Common-AIOT/Sentinel-UGV/docs/README.md

---
title: "재난 지역 자율 탐사 UGV - Sentinel UGV"
team: "역삼역역무실관제센터"
version: "v2.1"
status: "시연 종료 — 코드·실측 정합본"
date: "2026-08-11"
---

# 재난 지역 자율 탐사 UGV - Sentinel UGV

> 통합 프로젝트 명세서 및 개발 운영 계획

| **항목** | **내용** |
|---|---|
| **팀명** | 역삼역역무실관제센터 |
| **문서 버전** | **v2.1** — 시연 종료 시점 코드·실측 전면 정합본 |
| **작성 기준일** | 2026-08-11 |
| **개발 종료 목표** | 2026-08-07 |
| **프로젝트 유형**  | 온디바이스 AIoT 기반 재난 탐사 무인 지상 차량(UGV) |
| **문서 상태** | 구현 완료 범위와 실차 재검증·미구현 범위를 분리해 기록 |

> **문서 사용 목적** 본 문서는 기획서, 시스템 명세서, 하드웨어 설계 기준, 소프트웨어 인터페이스 명세, 테스트 계획, 일정 및 위험 관리 계획을 하나로 통합한 프로젝트 종합 문서이다. 팀원 간 개발 기준을 통일하고, 기술 선택 근거와 변경 이력을 발표 및 포트폴리오에 활용하는 것을 목적으로 한다.

> **현재 구현 요약 (v2.1, 시연 종료 시점)** 시연 시나리오 「START → 자율 탐사 → 사람 발견 → 접근 → 음성 대화 → 보고 → STOP」 전 구간이 실기동으로 동작한다. 주행은 Smac Hybrid-A\*(REEDS_SHEPP, R_min 1.8) + RPP(후진 추종)이며, 실측이 확정한 값 위에서 돈다 — R_min 좌 1.37m/우 1.76m, 순항 0.30m/s(명령=실속도 99%), 접근 0.25m/s, 펌웨어 데드밴드 0.15m/s(이 아래 명령은 실속도 0), EKF yaw 오차 1.1%, 오도메트리 줄자 대비 ±5%. 지도는 임무마다 초기화된다(MISSION_START 에서 slam 재시작). 안전은 collision_monitor 실측-차체 구역(정지 범퍼 앞 0.25m·후방 포함)이 주 방어이고, 전·후방 초음파는 장착·구현된 채 발동을 껐다(오측 — 커넥터 분리 유지). `demo.launch.py` 기본값은 SLAM·스트리밍·녹화·임무·클라우드 브리지·음성·탐지·시각화가 `true`, ESP32·Nav2·탐사·접근·안전·EKF가 `false`다. 필요한 기능은 `scripts/demo_up.sh` 인자로 켠다(**`enable_ekf` 를 빠뜨리면 스택이 조용히 침묵한다** — S15P11A301-359). **미구현으로 남긴 것**: 자동 복귀(RETURNING), 7분·Frontier 소진 자동 종료, human_localizer(map 좌표 사람 위치), 카메라 hfov 실측(접근 방향 미세 오차의 유력 원인, S15P11A301-371). 종료 시점 전체 상태와 반복된 함정 5가지는 Jira S15P11A301-372(종료 기록)에 있다.

> **문서 구성 안내** 본 명세서는 역할별 파일과 TBD 대장으로 분리해 관리하지만, **장 번호(1~38장)와 부록(A~L)이 전역으로 연속되는 하나의 문서(v2.1)** 이다. 문서 버전·변경 이력·결정 기준은 이 README에서만 관리하며, 각 분리 파일은 자기 버전을 따로 두지 않는다. 아래 [문서 구성](#문서-구성)의 매핑을 따른다.

# 문서 관리
| **버전** | **일자** | **상태**  | **주요 변경 내용** |
|---|---|---|---|
| v2.1 | 2026-08-11 | 코드·문서 재감사 | 실제 launch 기본값, Smac·BoT-SORT·ROS 토픽·인증 부재·GMS 상태명과 미구현 경계를 현재 코드 및 실측 결과에 맞췄다. TBD 완료/잔여 상태, 시연·인수 범위, 영상 15FPS·1500kbps와 트러블슈팅 인덱스도 최종화했으며 과거 변경 이력은 당시 기록으로 보존했다. |
| v2.0-r53 | 2026-08-09 | 문서 최신화 | 현재 코드와 설정을 다시 대조해 루트·프런트엔드·백엔드·Jetson 모듈 README와 환경 변수 예시를 갱신했다. 후방 초음파, IMU 장착 자세, URDF 실측 위치, Nav2·안전 체인·전륜 조향 구현 상태를 반영하고, 자동 복귀·자동 종료·실차 재검증·조향 링키지 보정 등 남은 항목을 구현 완료 내용과 분리했다. |
| v0.1 | 2026-07 초 | 아이디어  | 재난 지역 탐사 로봇 콘셉트 및 Jetson 중심 구조 검토 |
| v0.5 | 2026-07 중 | 설계 | 짐벌, ROS2, SLAM, Nav2, AWS 관제 구조 검토 |
| v0.8 | 2026-07-17 | 정책 확정 | 자율 탐사, 수동 조종, 스트리밍, 데이터 저장, 장애 대응 정책 확정 |
| v0.9 | 2026-07-17 | 개발 착수 | 전체 프로젝트 종합 명세서 작성. 모터/전원/짐벌 세부 부품은 TBD로 관리 |
| v1.0-rc1 | 2026-07-22 | 통합 검수 | 1~38장 통합, Jetson+STM32, 피해자 접근·음성·다중 인원, MQTT·이벤트 녹화·보안·인수 시험 반영 |
| v1.0-rc2 | 2026-07-23 | 구동 정정 | 구동계 정정 시도. 실제 donor platform 반영은 rc3에서 재검수 |
| v1.0-rc3 | 2026-07-23 | 대화 재검수 | BMW M7 베이스·RS540·추가 학습 YOLO·STT-LLM-TTS·실측 센서 상태 반영, 폐기 자료 의존 제거 |
| v1.1 | 2026-07-24 | 충돌 해소 확정 | 요약부·상세부 충돌 13건 팀 결정 반영(API 31장 기준, LiDAR 짐벌 탑재, TF 표준화, PAUSED 경유 수동 전환, AVAILABLE 상태 통일, 3주 일정 재편 등). 조건부 Pose 파이프라인, 블루투스 스피커+BRIO 내장 마이크, STT-LLM-TTS 온디바이스 확정. TBD 대장 부록 H로 단일화. 요약부 구조 재편: 상세 장과 중복되는 6·8~14·16장을 핵심 요약+규범 포인터로 압축하고 독자별 읽기 경로 추가. 역할별 6개 파일 + TBD 대장으로 문서 분리 |

| v1.1-r1  | 2026-07-27 | 실측 정정 | v1.1 내 정정(버전 식별자는 v1.1 유지). 32장을 S15P11A301-62 확정 계약·PoC-A 실측과 정합하게 정정. 카메라 단일 오픈을 `usb_cam` raw_mjpeg 패스스루 + 압축 토픽 분기로 교체, 15 FPS → 30 FPS 확정, NVENC 미존재로 `x264enc`(CPU) 확정(HW 인코더 전제 폐기), `nvv4l2decoder mjpeg=1` 확정·`nvjpegdec` 기각 명시, 저장 매체 microSD 실태와 `usb_cam` stamp 클럭 특성 기록, VID-11~13 추가. 변경 파일: `05-통신-서버-영상.md` |
| v1.1-r2  | 2026-07-27 | 제어기 변경 | 저수준 제어기를 STM32에서 ESP32로 변경. 유선 USB Serial, ESP-IDF watchdog·태스크 분리, 부팅 안전 출력, DHT11·전방 초음파의 ESP32 수집 및 독립 근거리 정지 원칙을 반영. 정확한 ESP32 보드 모델과 핀맵은 TBD. 변경 파일: `README.md`, `01~06`, `TBD.md`, `scripts/docs/split-integrated-spec.ps1` |
| v1.1-r3  | 2026-07-29 | AI 문서 정리 | 객체탐지 Jetson 실행 runbook을 25.7장에 반영하고, detection 세부 문서를 `docs/ai/detection/`으로 이동. 변경 파일: `README.md`, `04-자율주행-AI.md`, `docs/ai/README.md`, `docs/ai/detection/*`, `ai/detection/AGENTS.md` |
| v1.1-r4  | 2026-07-30 | 하드웨어 스택 확정 | 짐벌을 프로젝트에서 완전히 제외(카메라·LiDAR 차체 고정 마운트로 전환)하고, 배터리(모터용 유아전동차 내장 12V + Jetson용 대용량 보조배터리 분리 급전), 구동/조향 모터(RS540 FD-12V RPM14000 좌·우 각 1개 + WW MOTOR RS380SP-12V RPM5500 조향 1개, BTS7960 드라이버 3개), 저수준 제어기(ESP32 WROOM-32를 모터 제어용·센서 제어용 2개로 이원화, 각각 Jetson과 별도 USB Serial 연결), 센서(HC-SR04 초음파 1개, DHT-11 온습도 1개, MT6701 엔코더 3개)를 확정 반영. 짐벌 제외로 FR-024·CAL-08/09·`/gimbal/state`·gimbal TF 체인은 폐기 처리. 변경 파일: `README.md`, `01~06`, `TBD.md` |
| v1.1-r5  | 2026-08-01 | 구동계 차동 구동 전환 | 조향 모터(WW MOTOR RS380SP-12V)와 조향되는 앞바퀴를 제거하고, 프레임 앞부분에 수동 캐스터 바퀴 2개를 부착해 후륜과 높이를 맞췄다. 후륜 좌·우 RS540 모터 2개만으로 전진·후진·조향·제자리 회전을 수행하는 **차동 구동(differential drive)**으로 전환. 이에 따라 BTS7960·MT6701을 각각 3개→2개로 감축하고, 전륜 Ackermann 조향·최소 회전반경 제약·조향각 프로토콜 필드(`target_steering_mdeg` 등)·`STEERING_ENCODER_FAULT`·TBD-HW-008을 폐기했다. Nav2는 최소 회전반경 제약이 없는 차동 구동 로봇으로 재설정(NavFn/Smac 2D + DWB, rotation shim 활성화). 변경 파일: `README.md`, `01~06`, `TBD.md` |

| **v2.0** | **2026-08-04** | **구현 정합** | 명세 전체(6204줄·38장)를 리포 실제 상태와 대조해 정정(S15P11A301-239, 238 통합). 남은 기간이 짧아 **명세를 현재 구현에 맞추는 방향**으로 결정했고, 폐기·미구현을 감추지 않고 표기한다. **정책 변경 3건**: ① 배터리 기반 안전·종료 기능 폐기(14.6 — 전압·전류 센서 미장착이라 계측 경로가 없다. 종료 조건이 Frontier 소진과 7분·운영자 종료 둘로 줄어든다), ② 인증을 MVP 범위 밖으로 확정(36-4 — `/api/**`가 `permitAll()`이고 로그인 화면·`users` 테이블이 없다. 경계는 EC2 SG 허용 IP와 CORS 이며 Control Session 은 인증이 아니다), ③ TBD-NAV-001 Nav2 채택 확정(24.1 — Regulated Pure Pursuit + rotation shim, `enable_nav2` 기본 false). **신설**: 8.4 ROS 그래프 격리, 8.5 foxglove_bridge 시각화 경로, 8.6 관제 웹 실시간 지도(v1.1의 "실시간 격자 계약이 없다" 전제가 깨졌다), 23.6 복귀 3단(빵조각 역추적을 2단으로), 25.3 카메라 역할 경계(단안이라 기하에 쓸 수 없다), 03장 캐스터 슬립이 오도메트리 yaw 를 갉아먹는 영향, 04장 3차 통합 FPS 실측(5.80 → 10.80, 목표 15 미달). **정정**: 8.2 노드 표에 구현 상태 열(명세가 이름 붙인 노드 중 절반이 미구현, 6개는 실제 이름이 다르다)과 `/cmd_vel` 소비자 부재 갭 명시, REST API 표를 27.4 단일 규범으로 통합(31-7 중복 제거, `/path` 폐기, 지도 계통 3개 추가), 관제 화면 페이지 4개 → 2개와 레이아웃 제거 항목 6개의 근거, 28장 제목에서 "조이스틱 UX" 제거·STOMP 조종 채널 3개 미사용, 13장 미생성 테이블 3개(`users`·`interaction_sessions`·`interaction_turns`), 37-3 systemd 단일 진입점(TBD-OPS-001 문장 무효), 38-3 에 선행 부재로 막힌 요구사항 8개, 14.3 필수 점검에서 점검 불가 항목 제거, TBD-CAL-002 신설(트랙폭·바퀴 지름 — 즉시). **담당 위임**: 33-5 "전부 온디바이스 확정"이 구현과 다르다(LLM 이 GMS 클라우드) — 프라이버시·오프라인 정책이 걸려 있어 음성 담당이 정정한다. 변경 파일: `README.md`, `01`, `02`, `03`, `04`, `05`, `06`, `TBD.md` |

> **v2.0의 원칙: 미구현을 미구현으로 적는다.** v1.1까지는 설계 의도를 규범으로 적어
> 두었고 그것이 구현과 벌어졌다. 명세가 "구현한다"고 적고 있는데 실제로 없으면, 통합
> 검사에서 "왜 안 되나"를 매번 다시 조사하게 되고 최악의 경우 보안처럼 **없는 보호를
> 있다고 믿는다.** 그래서 v2.0은 각 항목에 구현 상태를 붙이고, 폐기한 것은 폐기로,
> 안 하기로 한 것은 안 한다고 적는다.
>
> 자율주행 23·24장의 **설계 결정**(Nav2 채택 근거, 복귀 3단, 카메라 역할 경계)은
> S15P11A301-238에서 별도로 반영한다. v2.0은 현재 상태 정합까지다.

| v2.0-r1 | 2026-08-04 | 파일 분리 | `04-자율주행-AI.md`를 둘로 분리(S15P11A301-245). 자율주행 장(8·14·22·23·24·26)은 `04-자율주행.md`, AI 장(9·25·30·33)은 신설 `07-AI-탐지-음성.md`. **내용 변경 없음 — 이동만.** AI(객체탐지·음성)는 거의 완료된 참조 문서이고 자율주행은 착수 단계의 작업 문서라, 한 파일에 두면 자율주행 변경마다 완료된 장이 diff 에 섞인다. 장 번호는 전역이므로 번호 참조는 유효하며, 파일명 참조는 리포 전수 갱신(`ai/detection`·`ai/voice`·`docs/ai`). 변경 파일: `README.md`, `04-자율주행.md`, `07-AI-탐지-음성.md`(신설), `ai/`·`docs/ai/` 링크 |

| v2.0-r2 | 2026-08-04 | 주행 스택 구현 반영 | 자율주행 구현 진행분을 반영(S15P11A301-234·235·236·244). 8.2 노드 표에서 `vehicle_kinematics`·`nav2_stack`·`ekf_node` 를 구현으로, 8.1 파이프라인에 EKF 편입. **24.1 신설**: planner/controller 역할 구분과 Nav2 구성 확정(NavFn, rotation shim→RPP, `allow_unknown=false` 가 23.3 도달성 판정의 근거, costmap 2개, `/cmd_vel_nav` remap, 시연 시작 위치 20cm 클리어런스). **23.2 신설**: EKF 융합 — 입력 성분 선택 근거(엔코더 `vx` 만·IMU `vyaw` 만, 슬립은 계통 오차라 공분산 가중으로 안 되고 아예 뺀다), odom TF **3자 배타표**(222 의 2자를 확장), 정지 실측(EKF 30Hz, gyro 잡음 분산 5.1e-05, **잔여 bias −4.85°/분**), 장착 후 검증 3단계. 22.2 센서 표에 IMU 90Hz·엔코더 50Hz 실측. TBD-HW-012 모델·배선 확정(MPU6050 I2C 0x68), TBD-NAV-001 구성 확정. 변경 파일: `README.md`, `04-자율주행.md`, `TBD.md` |

| v2.0-r3 | 2026-08-04 | 환경 센서 판정 | S15P11A301-214. 22.2 에 **환경값 판정 임계** 절 신설 — 명세가 임계값을 두지 않아 여기서 확정했다(습도 상한 85 → **80**: 데이터시트 상한 90 에서 오차 ±5 를 뺀 값. 종전 85 는 경고 구간이 오차 폭과 같았다). **포화 처리**를 도입했다 — DHT11 은 습도 90% 를 넘으면 못 읽으므로 임계값만 두면 범위 밖이 침묵한다. 값이 범위 끝이면 `≥90` 부등호와 "측정 한계" 안내를 함께 낸다. 포화 자체가 경고이며, 습도 하한(≤22%)은 경고 조건(>80) 밖이라 이 절 없이는 건조 극단이 조용히 지나간다. 22.2 DHT11 행에 유효 범위·실패 시 발행 건너뛰기 규칙 기재. 11장 레이아웃 제거 표에 **속도·각속도 폐기** 추가(실측값은 오지만 관제자 행동을 바꾸지 않는다 — 배터리·방위각과 같은 기준. DB·임무 이력에는 남긴다). 변경 파일: `README.md`, `04-자율주행.md`, `05-통신-서버-영상.md` |

| v2.0-r5 | 2026-08-04 | 환경 fault 발화 확인 | S15P11A301-258(r4 는 256 이 쓴다). 22.2 의 「**`ENVIRONMENT_SENSOR_FAULT`(임계 3)는 뜨지 않는다**」를 정정했다 — 그 문장은 측정 조건(센서 장착·간헐 실패 18.5%, 연속 최대 1회)에서만 사실인데 "이 플래그는 안 뜬다" 로 읽혔다. 없는 보호를 있다고 믿게 하는 종류의 오류다(v2.0 의 36-4 와 같다). 같은 날 **센서 분리 상태에서 정상 발화를 확인**했고 조건별 표로 바꿨다: 간헐 실패 → 0·0.41Hz 발행 유지 / 분리 → 1·`DEGRADED`·발행 중단. 분리 중에도 같은 보드 IMU 90.6Hz·CRC 0·프레임 유실 0 이라 fault 가 DHT11 경로만 짚었다는 것, 화면에서 값이 사라지는 것이 **설계대로**라는 것(낡은 값이 새 측정으로 보이지 않게), 주행은 `DEGRADED` 허용이라 탐사가 계속된다는 것을 적었다. 플래그가 **sticky 가 아니라 성공 읽기 1회에 해제**되므로 복구에 재기동이 불필요하고, 값이 1 로 남아 있다는 것은 임계 이후 성공 읽기가 없었다는 뜻이라 간헐 실패와 완전 불통을 이 한 값으로 구별할 수 있다. 변경 파일: `README.md`, `04-자율주행.md` |

| v2.0-r6 | 2026-08-05 | 안전 체인 구현·순서 통일 | S15P11A301-237. 체인을 구현하고(`sentinel_safety` 의 `command_mux`·`safety_gate`, nav2 두 층은 `safety.yaml` 파라미터만) **네 곳에 서로 다르게 적혀 있던 순서·토픽명을 통일**했다. 순서는 `command_mux → velocity_smoother → collision_monitor → safety_gate` 이며 34-7 이 규범이다 — smoother 를 뒤에 두면 급정지가 `max_decel` 에 걸려 천천히 멈춘다. 최종 토픽 이름이 문서마다 `/cmd_vel_safe`(03장)·`/cmd_vel`(8.2 `command_mux` 행)·`/cmd_vel_final`(8.2 `safety_gate` 행) 셋이었고 실제는 `/cmd_vel` 하나다(`/cmd_vel_safe` 는 collision_monitor 출력). 24.1 mermaid 는 수동 명령을 collision_monitor **뒤**에 합류시켜 수동 조작이 충돌 방지를 건너뛰게 그려져 있었다. **24.1 에 구현 확정 절 신설**: 관통 실측 4단 19.995~19.999Hz·값 보존·`/cmd_vel` 발행자 1개, 상류 단절 시 0 을 20.000Hz 로 **계속** 발행(침묵과 정지의 구별), nav2 두 층이 lifecycle 이라 `lifecycle_manager_safety` 가 필요하고 이름이 nav2 쪽과 달라야 하며 CPU 포화 경합 때문에 3초 지연이 필요한 것(지연 충분성은 **저부하에서만** 확인), `base_shift_correction: False` 의 근거와 그 대가 1.75cm 계산, `/scan` 낡음을 collision_monitor 가 건너뛰므로 게이트가 따로 보는 것. 8.2 표에서 `vehicle_kinematics`(234) 가 **아직 미구현으로 남아 있던 것**도 정정했다(v2.0-r2 가 고쳤다고 적었으나 실제로는 안 고쳐져 있었다). 22.4 의 「TF 끊김은 237 이 함께 잡는다」는 **약속이 이행되지 않았음을 명시**로 바꿨다 — 게이트의 정지 조건 넷에 TF 가 없고 `/scan` 은 계속 오므로 collision_monitor 도 못 막는다. 06장 FR-004·FR-011 을 "미구현" 에서 "구현·관통 확인, 실차 계측 미실시" 로, FR-003 의 「`/cmd_vel` 소비자 없음」을 정정. 변경 파일: `README.md`, `03-제어-캘리브레이션.md`, `04-자율주행.md`, `06-테스트-보안-운영.md` |

| v2.0-r7 | 2026-08-05 | 보호정지 중계 구현 | S15P11A301-237(r6 의 누락 보완). r6 이 안전 체인을 구현했다고 적었으나 **명세 03-276 이 요구하는 `protective_stop` → `STOP_COMMAND` 중계가 빠져 있었다** — `safety_gate` 는 `/cmd_vel` 을 0 으로 만들지만 브레이크·driver disable 은 발동하지 않았고, `STOP_COMMAND` 를 보내는 코드는 `esp32_motor_bridge` 의 서비스로만 있고 부르는 사람이 없었다. 03장에 **「중계 구현」 절 신설**: 중계는 `esp32_motor_bridge_node` 가 `/proximity/protective_stop` 을 **직접 구독**해 수행하며 `safety_gate` 를 거치지 않는다(지연 — 홉을 늘리지 않는다, 독립성 — 게이트가 죽어도 보호정지는 전달돼야 한다). 두 경로는 중복이 아니라 서로 다른 것을 막는다는 표를 함께 적었다. **상승 엣지 3회 반복**은 03장 메시지 표의 "즉시, 3회 반복 전송" 을 따른 것이고(정지는 ACK 를 기다리지 않는 로컬 실행이라 재전송이 유실의 유일한 보장), 매 프레임 중계하지 않는 이유는 `PROXIMITY_STATE` 10~20Hz 가 50Hz `DRIVE_COMMAND` 와 시리얼을 다투기 때문이다. 눌린 동안의 200ms 재확인은 유실 대비가 아니라 **눌린 채로 ESP32 가 재부팅하는 경우**를 위한 것임을 명시했다(상승 엣지는 이미 지나가 다시 오지 않는다). TBD-HW-011 에 중계 위치를 확정으로 기록하고 **남은 값이 왕복 지연 실측 하나**임을 적었다(CTRL-18, 실차 필요. 300ms 초과 시 ESP32 간 UART 대체안). CTRL-18·06장 FR-011 을 "중계 구현됨, 왕복 지연 미실측" 으로 갱신. 04장 24.1 에 이 경로가 체인 밖에 하나 더 있다는 것을 적었다. 변경 파일: `README.md`, `03-제어-캘리브레이션.md`, `04-자율주행.md`, `06-테스트-보안-운영.md`, `TBD.md` |

| v2.0-r8 | 2026-08-05 | 초음파 역할 재정의 | S15P11A301-272. 센서 수리(263) 직후 임계와 탐지 능력을 **처음 실측**했고, 명세가 기대하는 「근거리 보호 정지」와 실제 능력이 달라 문서를 실측에 맞췄다. **04장 22.2 에 실측 절 신설**: `protective_stop` 발동 **0.15~0.18m**, 측정 유효 범위 0.028~2.994m, 8~10cm 고정 시 9초 연속 `True`(전환은 진입·이탈 2회, `inf` 0개 — 앞서 관측된 잦은 발동/해제는 물체를 움직인 탓이며 깜빡임이 아니다). **거리별 탐지율이 핵심이다** — 0.08~0.11m 15/15(100%), 0.43~0.65m 3~7/15(20~45%), 1.39~1.41m 1~4/15(7~27%). 1.4m 에서 여덟 번 중 일곱 번을 놓친다. **임계는 올리지 않는다**(TBD-CAL-001 확정): 0.43m 에서 이미 탐지율이 절반 미만이라 임계를 올리면 놓치는 비율이 그대로 오판이 되고, 없는 보호를 있다고 믿는 것보다 좁은 보호를 정확히 아는 쪽이 낫다는 판단이다. 역할을 **주 방어=LiDAR·collision_monitor(전방 0.40m) / 접촉 직전 방어=초음파(0.15~0.18m)** 로 갈라 적었다 — 임계가 로봇 반경 0.20m 안쪽이므로 이 층의 목적은 충돌 제거가 아니라 **충격 감소**다. 03장 「중계 구현」에 같은 한정을 넣고 CTRL-18 이 접촉 직전만 판정함을 명시. **없는 보호를 기대하던 서술 둘을 정정**: 24.5 합격 기준의 「사람 접근 중 안전거리보다 가까워지면 정지」와 06장 SR-009(1.5~2.0m)는 **초음파로 판정할 수 없다** — 그 거리 탐지율이 7~27%다. LiDAR·사람 탐지 기반 접근 제어의 몫으로 옮겼다. 22.2 센서 표의 초음파 주기를 15.1Hz 실측으로 갱신. 변경 파일: `README.md`, `03-제어-캘리브레이션.md`, `04-자율주행.md`, `06-테스트-보안-운영.md`, `TBD.md` |

| v2.0-r10 | 2026-08-05 | 이벤트 이미지 보존 상한 | S15P11A301-265. 25.7 에 **`events/` 보존 상한 절 신설**. run 하나가 1.2G 까지 커져 젯슨 디스크가 찼는데, 원인은 프레임 로그가 아니라(`write_frame_log` 는 이미 false 였다) **`event_cooldown_seconds`(15초)가 트랙별**이라는 것이었다 — 사람 1명당 15초이므로 6명이 상시 잡히면 24 이벤트/분이고 총량에 경계가 없다. **끄지 않는다**: 이 이미지는 31-5 봉투의 `eventImage` 가 가리키는 증빙이라 없으면 요구조자 발견 근거가 사라진다. 상한을 두고 오래된 것부터 버린다(파일명이 시간순이라 이름 정렬로 판단). **장당 크기를 실측했다 — 165KB**(1280×720, `cv2.imwrite` 기본 화질, 실물 프레임 12장 중앙값, 최소 163·최대 168KB). 따라서 `events_max_bytes: 500MB` 는 약 3,100장이고 세 run 이 다 차도 1.5G 다. `events_max_files: 5000` 은 보조 안전망이며 **165KB 기준으로는 발동하지 않는다**(바이트 상한이 먼저 걸린다) — 화질·해상도를 낮춰 장당 100KB 아래가 되는 경우를 위해 남겼다. **개수가 아니라 바이트가 주 기준인 이유**는 장당 크기가 장면·overlay 에 따라 달라져 개수로 묶으면 총량이 다시 흔들리기 때문이다. **보존 시간으로 환산하지 않는다** — 사무실 2.2시간 / 시연 상황 며칠로 장면에 따라 다르고, 상한의 목적은 "며칠 치를 남긴다" 가 아니라 "장면이 어떻든 디스크가 차지 않는다" 다. 삭제는 개수·용량과 함께 로그로 남긴다(증빙 데이터이므로 조용히 지우면 안 된다). 변경 파일: `README.md`, `07-AI-탐지-음성.md` |

| v2.0-r11 | 2026-08-05 | 임무 종료 후 재시작 | S15P11A301-274. **STOP 한 번이 일회용 잠금이었다** — 관제에서 임무를 종료하면 `COMPLETED` 가 나가는 전이 없는 종단이고 `MISSION_START` 가 `SAFE_IDLE` 에서만 유효해, `mission_manager` 재기동 없이는 다시 시작할 수 없었다(실측: 「베이스캠프 복귀」 후 「탐사 시작」이 `INVALID_STATE` 거부). 시연은 반복하므로 **26.3 도식에 `COMPLETED → EXPLORING`(새 임무) 을 추가**했다. 초기화 상태를 따로 두지 않은 이유를 적었다 — 임무 종료 기록은 상태 머신이 아니라 관제 DB 의 임무 이력에 남고, `personCount` 는 encounter 파생이라 `COMPLETED` 를 붙들 이유가 없다. **`EXPLORING → COMPLETED`(관제 STOP) 화살표도 추가**했다 — `RETURNING` 이 미구현이라 종료가 복귀를 우회하는데 도식에 그 경로가 없어 `COMPLETED` 도달 길이 `RETURNING` 뿐인 것처럼 읽혔다. **낡은 기술 두 건 정정**: ① 8.2 의 `frontier_explorer` 와 06장 FR-003 이 `sentinel_exploration` 을 「미구현·소스 0개」로 적었으나 **13개 소스가 구현돼 있다**(frontier·coverage·sweep·selector·grid) — 막는 것은 Nav2 기본 꺼짐뿐이다. ② 23.4 의 종료 조건 셋 중 **구현은 운영자 종료 하나뿐**임을 명시(7분 타임아웃은 `tick()` 에 분기도 파라미터도 없다). **자동 종료를 넣지 않기로 한 결정과 근거를 기록**했다 — `frontier 소진은 지도 완성이지 수색 완료가 아니다`(`exploration_node.py`). 라이다는 360°인데 사람을 찾는 것은 전방 52° 카메라라, frontier 만 좇으면 지도는 완벽한데 구석에 쓰러진 사람은 화각에 안 들어온다(`coverage.py`). `sweep.py` 의 스텝-드웰(40° 회전 → 1.5초 응시)이 그 대책이며 **각도가 바뀌면 놓친 사람이 잡히므로 지도 완성 후에도 계속 도는 것이 맞다.** 근거를 안 적으면 다음 사람이 같은 제안을 다시 하고 같은 조사를 반복한다. 관제 버튼 「베이스캠프 복귀」는 실제로 `STOP`(임무 종료)을 보내므로 **「임무 종료」로 이름을 맞췄다**(복귀 주행 S15P11A301-246 구현 시 복귀 버튼 복원). 관제 화면 표시도 정리했다 — **상태 표시는 젯슨이 아니라 백엔드가 진실**이다(`CommandAckWriter` 가 `missions.status` 를 갱신하고 STOMP 로 밀어 준다, 원칙 27.3). 이 구분을 모르면 젯슨을 고쳐 화면을 바꾸려 하게 되고, 실제로 젯슨이 `COMPLETED` 인데 화면은 「탐사 중」인 어긋남을 겪었다. `STOP` 이 ACK 시점에 `ended_at`·`end_reason=OPERATOR_STOP`·`mission_results` 까지 넣으므로 이력은 젯슨 상태와 무관하게 보존된다. 그래서 **`COMPLETED` 표시를 「임무 완료」→「대기」**(`SAFE_IDLE` 과 동일)로, 톤도 초록→중립으로 바꿨다(대기 중인데 활동 중처럼 보였다). **「임무 종료」 버튼을 `SAFE_IDLE`·`COMPLETED` 에서 숨긴다** — 끝낼 임무가 없다. 그리고 `return` 명령의 **낙관적 표시를 `RETURNING`→`COMPLETED`** 로 고쳤다: `RETURNING` 은 미구현이라 로봇이 결코 그 상태가 되지 않는데 화면만 복귀하는 것처럼 보였고, 대기 상태에서 잘못 누르면 「복귀 중」이 떴다. 버튼 숨김과 낙관적 표시 수정이 **둘 다** 필요하다 — 버튼만 숨기면 다른 경로로 같은 명령이 나갈 때 같은 오표시가 난다. 백엔드의 `TYPE_RETURN` 은 아무도 보내지 않는 자리로 남겨 둔다(복귀 주행 구현 시 사용). 변경 파일: `README.md`, `04-자율주행.md`, `06-테스트-보안-운영.md`, `mission_state.py`, `StatusPanel.tsx`, `RobotContext.tsx` |

| v2.0-r12 | 2026-08-05 | 임무 정지 시 녹화 마감 | S15P11A301-276. 26.4 에 「임무를 멈추면 진행 중 encounter 를 끊는다」 절 신설. 종전에는 일시정지·종료가 마감 신호(`ENDED`)를 내지 않아 녹화기가 5분 `MAX_DURATION` 까지 돌았다 — 실측: `REPORTING` 중 관제 PAUSE 에 **92MB**·`endReason: MAX_DURATION`. 사람이 없는 구간까지 담겨 증빙 품질도 낮고 시연 반복 시 디스크·업로드 부담이 쌓인다. 녹화기가 임무 상태에 의존하지 않는 것은 **설계 의도**이므로(상한이 없으면 파일이 무한히 커진다) 상한은 옳고 **마감 신호를 제때 주지 않은 쪽이** 문제였다. 살려 둘 이득도 없다 — 재개가 어차피 encounter 를 버린다. 경로별로 정리했다: 일시정지·종료·**센서 실패** 는 끊고(센서 실패는 `PAUSED` 로 가는 두 번째 핸들러라 처음에 빠뜨렸다), **비상 정지는 끊지 않는다**(의도된 예외 — 원인 조사 대상이라 전후 영상이 길게 남아야 한다). 발행 순서 함정도 적었다: 노드가 발행 시점에 encounter 를 읽으므로 핸들러가 먼저 버리면 `encounterId` 가 빠져 녹화기가 무시한다. 그래서 `Transition` 이 대상 encounter 를 **들고 가게** 바꿨다 — 핸들러가 발행 순서를 신경 쓰지 않고 정리할 수 있다. 실기동: 후보를 계속 흘리는 상태로 `INTERACTING → PAUSED` 를 만들자 MP4 가 **5.5MB·약 2초 만에** 마감됐다(92MB/5분이 아니다). 변경 파일: `README.md`, `04-자율주행.md`, `mission_state.py`, `mission_manager_node.py` |

| v2.0-r13 | 2026-08-05 | 짐벌 TF 잔재 제거 | S15P11A301-279. 짐벌은 v1.1-r4 에서 프로젝트에서 제외됐고 02장 6.4 가 「미사용 확정」으로 적었으나 **`sentinel.urdf` 에 링크 3개가 남아 TF 트리에 실제로 발행되고 있었다.** 더구나 **라이다와 카메라가 그 체인에 매달려** 있어 `base_link → gimbal_base_link → gimbal_roll_link → gimbal_pitch_link → lidar_link` 였다 — 명세 35-2 권장 트리는 `base_link` 직결이다. 세 짐벌 조인트가 **모두 항등**(xyz `0 0 0`, rpy `0 0 0`)이어서 재부모화하며 origin 을 그대로 두면 기하가 보존된다. 실측으로 확인했다: `base_link → lidar_link` `[0,0,0.020]`, `→ camera_link` `[0,0,0]`, `→ camera_optical_frame` RPY `[-90,0,-90]` 이 **정리 전후 동일**하고 `gimbal_*` 프레임은 사라졌으며 SLAM 도 정상이다(`/map` 0.50Hz, `/scan` 11.61Hz). 정리한 이유는 SLAM 이 `lidar_link` 로 스캔을 base 에 옮기므로 **하중을 받는 체인에 쓰이지 않는 링크가 끼어 있으면 나중에 누가 그 조인트를 만졌을 때 지도가 조용히 틀어진다**는 것이다. 문서는 폐기라고 적고 코드는 발행하는 불일치였다 — v2.0 원칙의 반대 방향이다. **`lidar_link`·`camera_link` 오프셋은 여전히 미실측**임을 35-2 에 명시했다(라이다 z=0.02 외 전부 0, IMU 도 같은 상태 TBD-HW-012). 이 정리는 값을 바꾸지 않았다. 변경 파일: `README.md`, `03-제어-캘리브레이션.md`, `sentinel.urdf` |

| v2.0-r14 | 2026-08-05 | AI 탐지·음성 문서 분리 | S15P11A301-287. 기존 `07-AI-탐지-음성.md`, `docs/ai/detection/*`, `ai/voice/docs/*`에 분산된 설계·실측·실행 기록을 `07-AI-탐지.md`와 `08-AI-음성.md`로 통합했다. 음성 현재 운영안을 **Jetson Silero VAD → L40S FastAPI Qwen3-ASR-1.7B → GMS gpt-5.4-mini → 규칙 위험도 → 승인 사전 녹음 WAV**로 정정하고, 로컬 Whisper·로컬 LLM·동적 TTS·STT 앞 DeepFilterNet은 미채택 이력으로 분리했다. 변경 파일: `README.md`, `07-AI-탐지.md`, `08-AI-음성.md`, AI 코드·문서 링크 |

| v2.0-r15 | 2026-08-06 | **구동계 전륜 서보 조향 전환** | 하드웨어 변경 반영. 프레임 앞부분의 **수동 캐스터 바퀴 2개를 제거하고 유아전동차 기존 조향 앞바퀴 2개를 복구**했으며, 타이로드에 **DS51150-12V 서보모터**를 직결해 조향한다(제어는 모터 ESP32). 전진·후진은 후륜 좌·우 RS540 2개 + BTS7960 2개를 그대로 쓴다. **즉 v1.1-r5(2026-08-01) 의 차동 구동 전환을 되돌려 구동과 조향을 다시 분리**했고, 운동학이 전륜 조향(자전거·Ackermann 근사)으로 돌아갔다. **가장 큰 파급은 제자리 회전 불가다** — `v≈0`·`ω≠0` 명령을 실행할 수 없어 `vehicle_kinematics` 가 이를 거부하고 진단으로 보고하며(03장 34-2), Nav2 의 rotation shim·`spin` 복구·RPP `use_rotate_to_heading` 를 모두 끄고 `minimum_turning_radius` 를 넣어야 한다(04장 24.1). planner 는 NavFn 유지 vs Smac Hybrid-A\* 전환이 미결이며 **판단 기준은 `R_min` 실측 하나**다. **프로토콜은 와이어 포맷이 바뀌지 않는다** — 2026-08-01 에 호환용 예약으로 남겨 둔 `target_steering_mdeg`·`max_steering_rate_mdps`·`steering_actuator_cmd`·`measured_steering_mdeg` 자리를 되살려 쓰며, 종전 03장 payload 표가 그 예약 필드를 빠뜨려 코드(14/15/16 bytes)와 어긋나 있던 것도 함께 정정했다. **조향은 개루프다** — 서보가 내부 폐루프로 각도를 유지하고 외부로 출력하지 않아 MT6701 은 후륜 2개를 유지하고, **링키지 이탈·서보 고장을 전기적으로 감지할 수 없다.** 감지 수단은 IMU 기대 yaw rate 대조 하나이며(`STEERING_RESPONSE_MISMATCH`) 그것도 선회를 시도할 때만 드러난다(03장 34-9, SR-013). **오도메트리는 결론이 그대로이고 근거가 강해졌다** — 캐스터 슬립이 없어진 대신 후륜 스크럽과 개루프 조향 때문에 엔코더로 yaw 를 만들 근거가 **아예 없어져**, EKF 의 「엔코더 `vx` 만·IMU `vyaw` 만」 입력 선택이 선택이 아니라 유일한 구성이 됐다(04장 23.2). **전원·안전**: 서보는 12V 모터 계통의 **E-Stop 하류**에서 급전해 차단점을 하나로 유지하고(저전압 DC-DC 레일에 올리지 않는다 — stall 전류), 그 대가로 **E-Stop 후 조향각은 정의되지 않는다**(서보 무여자). 소프트웨어 정지에서는 반대로 **조향각을 마지막 값으로 유지**한다 — 급정지 순간에도 관성 주행이 남으므로 중립으로 꺾으면 의도한 궤적을 벗어난다(03장 34-7, SR-014). 예외는 부팅·리셋 직후와 정차 후 `SAFE_IDLE` 복귀 둘뿐이다. **폐기했던 TBD-HW-008 을 「전륜 서보 조향 기하」로 부활**시켰고(휠베이스 `L`·`δ_max`·`R_min`·서보 중립/엔드포인트 µs·히스테리시스·신호 규격·stall 전류, **즉시**), TBD-CAL-002 의 트랙폭 `W` 는 필수 파라미터에서 스크럽 정량화·전자 차동 검토용으로 역할이 바뀌었다(전자 차동은 **기본 미적용** — 초기에는 좌·우 동일 속도, 실측 후 필요하면 추가). 시험은 CTRL-15 를 「거부 확인」으로 바꾸고 CTRL-24~27(서보 스윕·슬루레이트·단절 시 각도 유지·링키지 이탈 감지)을 신설했으며, CAL-04 를 조향 기하 항목으로 교체했다. **소프트웨어는 아직 차동 구동을 가정한다** — 04장 8.2 에 「전륜 조향 전환이 남긴 소프트웨어 갭」 절을 신설해 `vehicle_kinematics`·`esp32_motor_bridge`·모터 펌웨어·`esp32_sensor_bridge` 정운동학·`nav2.yaml` 다섯 곳을 미구현으로 명시했고, **지금 상태로 안전 체인을 켜면 `ω` 가 차동 역운동학을 타고 후륜을 반대로 돌려 앞바퀴가 고정된 채 노면을 문지른다**는 것도 적었다(`enable_safety`·`enable_nav2` 기본 false 가 이 사고도 막고 있다). 03장 35-2 의 TF 트리 링크 이름을 `sentinel.urdf` 실제 값(`rear_drive_wheel_link`·`front_*_wheel_link`)으로 정정했고 — 「URDF 가 이 트리와 일치한다」던 문장이 이 부분은 사실이 아니었다 — **조향각을 TF 에 반영하지 않는 이유**(개루프라 실제 각도가 없고, 목표각을 실제각처럼 발행하면 없는 측정을 만든다)를 함께 적었다. 변경 파일: `README.md`, `01`, `02`, `03`, `04`, `05`, `06`, `TBD.md` |

| v2.0-r16 | 2026-08-06 | 스택 진입점 정리 | S15P11A301-294. **`demo_down.sh` 가 systemd 서비스를 모르는 채로 프로세스만 죽여, 내려도 5초 뒤 되살아났다** — 실측 journalctl: `09:20:24` demo_down 실행 → `09:20:28` `Main process exited, code=exited, status=1/FAILURE` → `09:20:33` `Scheduled restart job, restart counter is at 1`. launch 는 SIGINT 에 exit 1 로 끝나므로 `Restart=on-failure` 가 그것을 **고장으로 읽는다.** 즉 서비스가 active 인 동안 프로세스를 죽이는 경로는 **항상 무효**였고, 사용자는 「내렸는데 스트리밍·라이다가 계속 된다」로 겪었다. 이제 유닛 상태를 보고 `systemctl stop` 을 탄다(cgroup 정리라 패턴 목록보다 촘촘하다). 프로세스 정리 경로는 남긴다 — 서비스를 끈 개발 구성에서 손으로 띄운 스택을 같은 명령으로 내려야 한다. sudo 를 못 쓰면 **헛된 kill 을 하지 않고 exit 1** 로 끝낸다(죽여 놓고 성공했다고 말하지 않는다). `demo_up.sh` 는 서비스가 돌고 있으면 **이중 기동을 거부**한다(카메라 단일 오픈 32-3, MediaMTX 중복 바인딩 — 증상이 「안 뜬다」가 아니라 영상 간헐 끊김이라 찾기 어렵다). 또 **기동 시 브랜치·커밋·dirty 를 출력**한다: 이 워크스페이스는 symlink 설치라 체크아웃된 코드가 곧 실행 코드이고 서비스가 enabled 인 동안 부팅만으로 스택이 뜨므로, 기능 브랜치를 둔 채 재부팅하면 로봇이 **경고 없이 그 코드로** 뜬다(08-05 저녁에 실제로 그 상태였다). 막지 않고 journalctl 에 남기는 이유는 브랜치 실기동 검증이 정당한 사용이기 때문이다. **`start_sentinel.sh`·`stop_sentinel.sh` 제거** — 17개 중 5개만 덮어 탐지(1795MB)·SLAM 이 남았고 그것이 S15P11A301-192 메모리 오진을 **두 번** 낸 경로다. 내리는 명령이 둘이면 한쪽은 반드시 낡는다. **`viz_up.sh`·`viz_down.sh` 는 남긴다** — S15P11A301-216 이 이 쌍을 8765 무인증 노출의 완화 수단으로 설계하고 `viz_address` 기본값 뒤집기를 의도적으로 기각했다. 지우면 06장·04장 8.5 가 인용하는 완화가 사라져 「없는 보호를 있다고 믿는」 상태가 된다. 다만 그 완화가 `enable_viz` 기본값 true + 서비스 enabled 로 **이미 무력화**된 것을 실측했다(8765 가 공인 IP 에 상시 개방) — S15P11A301-295 로 분리. 프로세스 표를 15→**17개**로 갱신(`cloud_bridge`·`foxglove_bridge` 가 기본으로 뜬다). `start_sentinel.sh` 가 갖고 있던 `.env.local` IP 대조 검사가 함께 사라진 것도 명시했다(로컬 dev 서버 한정 위험, 수동 확인 명령 기록). 변경 파일: `README.md`, `01-프로젝트-개요.md`, `06-테스트-보안-운영.md`, `TBD.md`, `scripts/README.md`, `demo_up.sh`, `demo_down.sh`, `ros_env.sh`, `viz_down.sh`, `ci/validate_repository.sh`, `sentinel_mission/README.md` |

| v2.0-r17 | 2026-08-06 | 8765 노출 완화 서술 정정 | S15P11A301-295. 06장 위험 표와 04장 8.5 가 젯슨 8765(`foxglove_bridge`, 읽기 무인증) 노출의 완화를 **「볼 때만 켜고 보고 나면 `viz_down.sh` 로 끈다」** 로 적고 있었다. **그 완화는 적용할 수 없다** — `LiveMap.tsx:44` 가 `wss://jetson.sentinel-ugv.xyz:8765` 로 붙어 **관제 웹의 실시간 지도가 이 브릿지에서 `/map`·`/pose` 를 직접 받는다**(8.6). 즉 끄는 것은 노출을 줄이는 행동이 아니라 **관제 지도를 끄는 행동**이다. 실측: `ss -tlnp` 로 8765 가 `0.0.0.0` 에 열려 있고 부모가 `demo.launch.py`(sentinel-demo.service)다 — 사람이 `viz_up.sh` 를 부른 것이 아니라 `enable_viz` 기본값 `true` + 서비스 enabled 로 **부팅만으로 열린다.** **완화가 사라진 것이 아니라 처음부터 다른 것이었다** — S15P11A301-216 은 브릿지를 개발 도구로 보고 그 완화를 설계했고(그때는 성립했다), 224·227 이 브릿지를 관제 웹 부품으로 만든 시점에 구조적으로 무효가 됐다. 실제로 범위를 좁히고 있는 것은 **쓰기 차단(`capabilities: [connectionGraph]`)·토픽 6개 화이트리스트·TLS** 이고 카메라 영상은 제외돼 있다. 유출 범위는 지도·로봇 위치·스캔·TF 이며 개인정보나 조작 권한이 아니다. **없는 것은 인증 하나**다(36-4 가 MVP 범위 외로 결정). 그래서 이번 변경은 코드가 아니라 서술을 고친다 — 위험 표의 완화 칸을 「완화 없음, 범위만 좁힘」으로, 8.5 를 「노출 구간은 스택이 떠 있는 동안 전부」로 바꿨다. `viz_up.sh`·`viz_down.sh` 의 역할도 **「노출을 줄이는 수단」에서 「스택을 재시작하지 않고 브릿지만 붙이거나 떼는 수단」** 으로 다시 적었다(재시작은 메모리에만 있는 SLAM 지도를 잃는다, S15P11A301-171). `--local` 안내에는 **그 모드에서 관제 지도가 동작하지 않는다**는 것을 명시했다 — 노출을 줄이려고 시연 중에 쓰면 지도를 잃는다. `demo.launch.py` 는 요약 주석이 「기본 꺼짐」이라고 적어 실제 기본값(`true`)과 어긋났으므로 코드에 맞췄고, 기본값 선언 자리에 **「노출을 줄이려고 false 로 되돌리지 말 것」** 을 근거와 함께 남겼다. **왜 지금 적는가**: 문서가 완화했다고 적으면 다음 사람은 노출을 다시 점검하지 않고, 더 나쁘게는 그 완화를 적용하려다 관제 지도를 끈다 — v2.0 의 36-4 와 같은 형태의 위험이다. 인증(토큰·리버스 프록시·IP 허용)은 관제 클라이언트 수정이 따라오므로 시연 이후로 남겼다. 변경 파일: `README.md`, `04-자율주행.md`, `06-테스트-보안-운영.md`, `scripts/README.md`, `demo.launch.py` |

| v2.0-r18 | 2026-08-06 | 관제 화면 글꼴 확정 | S15P11A301-302. 28장에 **28.7 「글꼴」 절 신설**. 본문을 Pretendard → **Asta Sans**(42dot, OFL 1.1), 고정폭을 JetBrains Mono → **D2Coding**(NAVER, OFL 1.1)으로 바꾸고 CDN `@import` 두 줄을 자체 호스팅(`frontend/public/fonts/`)으로 옮겼다. **핵심은 D2Coding 에서 한글을 뺀 것이다** — 서브셋에 `U+AC00-D7A3` 이 없으므로 `font-mono` 스팬의 한글이 스택 다음 자리의 Asta 로 폴백하고, 「데이터 스트립만 고정폭」이 개발자 규율이 아니라 **폰트 스택 자체로 강제**된다. 이 UI 는 `font-mono` 를 78곳에서 쓰고 그중 16곳이 순수 한글 문장이라 손으로 지키는 방식은 유지되지 않는다. `scripts/build-fonts.sh` 의 `D2_RANGES` 에 한글을 추가하면 이 보장이 조용히 깨지므로 스크립트·CSS·문서 세 곳에 경고를 남겼다. **종전 상태가 이미 어긋나 있었다**: `--font-mono` 가 정의조차 안 되어 JetBrains Mono 를 5굵기 받아 놓고 한 번도 쓰지 않았고, `font-mono` 는 Tailwind 기본 스택으로 떨어졌다 — 그 스택에 한글이 없어 한글 16곳이 OS 폰트로 갈렸다(Windows·macOS 불일치). **폰트 파일 cmap 실측**: Asta 는 한글 11,172자 전부를 담고 있고(한자·조합형 자모 `U+1100-11FF` 는 없다) `tnum` 이 실재한다(기본 숫자 폭 488~610/1000 → tnum 593). **가변 채택 근거**: 이 UI 는 굵기 4개를 쓰므로 정적이면 384KB × 4 ≈ 1.5MB, 가변은 하나로 300~800 전부를 덮어 914KB 다. 실측 woff2 합계 **996.5KB**(Asta 한글 913.6 / 라틴 53.5 / D2Coding 14.4 · Bold 15.0) — 종전 Pretendard 는 `unicode-range` 없이 9굵기를 통짜로 선언해 굵기당 748KB 였다. **자체 호스팅 근거**: CSS `@import` 는 렌더를 막고 이 GCS 는 외부망 없는 로컬 시연에서 돈다. 한글 서브셋은 `preload` 하지 않는다(914KB 가 첫 페인트 대역을 먹는다) — 라틴과 D2Coding 만 preload 하고 한글은 `swap` 에 맡긴다. `tabular-nums` 는 **sans 문맥의 수치에만** 붙였다(임무 목록 한 줄). 고정폭 스팬은 이미 자릿수가 맞아 중복이며, 임무 요약 스트립이 그 경우다. **미확인**: `text-[9px]`·`text-[10px]` 한글에서 Asta 가 읽히는지는 실기 확인이 필요하다(프런트 담당). 변경 파일: `README.md`, `05-통신-서버-영상.md`, `frontend/app/globals.css`, `frontend/app/layout.tsx`, `frontend/app/blackbox/page.tsx`, `frontend/app/blackbox-experiment/page.tsx`, `frontend/scripts/build-fonts.sh`(신설), `frontend/public/fonts/*`(신설), `frontend/ATTRIBUTIONS.md` |

| v2.0-r19 | 2026-08-06 | 부팅 자동 기동을 시각 동기 뒤로 | S15P11A301-306. 06장에 **37-3-1 절 신설**. **부팅으로 뜬 스택만 SLAM 지도가 안 나오고 영상이 끊기며 ESP32 핸드셰이크가 폭주하는데, 손으로 `demo_down.sh` → `demo_up.sh` 하면 멀쩡했다.** 원인은 스크립트가 아니라 **시계**다 — 이 젯슨은 RTC 백업 배터리가 없어 부팅마다 시계가 **두 번** 점프하고, 유닛이 그 사이에 뜬다. 실측 저널: `1970-01-01 09:00:41` 커널 부팅(시계 = epoch) → timesyncd 가 **마지막 기록 시각으로 복원**(1차 점프 56년, NTP 아님) → `13:57:24` 유닛 기동 → `14:01:12` `Initial synchronization to 192.168.0.1`(**2차 점프 +3분 22초**, 스택이 이미 4분째 돌던 중). 직전 부팅도 동일(`13:44:59` 기동 → `13:49:17` 에 +3분 52초) — **재현된다.** ROS 2 는 시스템 시계로 스탬프를 찍으므로 2차 점프가 그대로 파손이 되는데, **증상이 전부 다른 곳에서 나타나 시계를 의심하기 어렵다**: `slam_toolbox` 는 TF 캐시가 미래 시각으로 채워져 라이다 스캔을 전량 폐기하고(`the timestamp on the message is earlier than all the data in the transform cache` → 지도가 안 나온다), `stream_pipeline` 은 `now - 마지막프레임시각` 이 점프량만큼 커져 입력 타임아웃으로 오판해 재시작하며(`입력이 232.0초간 없다`), `esp32_sensor_bridge` 는 워치독이 즉시 만료 판정되어 핸드셰이크를 **457회/7분(약 6.7Hz)** 반복한다. 조치는 유닛에 `After=/Wants=time-sync.target` 을 넣는 것인데, **그것만으로는 아무 보장이 없다** — `systemd-time-wait-sync.service` 가 disabled 면(Ubuntu 기본값) target 이 즉시 도달하고 저널의 `Reached target System Time Set` 은 「NTP 동기 완료」가 아니라 「시계에 값이 들어갔다」는 뜻일 뿐이다. 그래서 `enable` 이 함께 가야 한다. **`TimeoutStartSec` 상한이 반드시 따라온다** — 배포판 유닛이 `TimeoutStartSec=infinity`(실측 `systemctl show`)라 상한 없이 순서만 걸면 NTP 없는 시연장에서 스택이 **틀린 시계로 뜨는 것이 아니라 아예 안 뜬다**(고치려던 것보다 나쁜 실패). 90초로 잡고 근거를 drop-in 주석에 남겼다. **남는 제약**: RTC 배터리를 달면 1차 점프가 사라지고 2차도 수 초로 준다 — 이 변경은 배터리 없이 증상을 막는 쪽이므로 배터리 장착은 별건이다. 변경 파일: `README.md`, `06-테스트-보안-운영.md`, `scripts/systemd/sentinel-demo.service`, `scripts/systemd/systemd-time-wait-sync-timeout.conf`(신설) |

| v2.0-r20 | 2026-08-06 | telemetry 임무 귀속의 수명 | S15P11A301-307. 05장에 **31-5-1 절 신설**. **6초짜리 테스트 임무 하나에 궤적 9,574점·101분치가 붙어 있었다.** 임무를 STOP 해도 젯슨이 그 `missionId` 로 계속 발행한 것인데, 원인은 `mission_id` 를 **`COMPLETED` 이후에도 들고 있는 것**이다. 그 값을 남기는 것 자체는 의도였다 — `COMPLETED` 상태 메시지가 「어느 임무가 끝났는가」를 실어야 지도 저장이 임무별 디렉터리를 만든다(S15P11A301-171). 문제는 **수명**이다: `MISSION_ACTIVE_BY_STATE`(S15P11A301-190)는 상태 이름만 보므로 `PAUSED`·`ESTOP`·`EXPLORING` 이 전부 활성이고, `_pause_requested`·`_estop`·`_sensor_fault` 는 상태 제약이 없어 `COMPLETED` 에서도 받는다 — **PAUSE 한 번이면 끝난 임무의 궤적이 다시 자란다.** 실측 저널(2026-08-05): `12:17:26` START `b251f573` → `12:17:31` STOP(6초) → 새 임무 START 4회 거부(당시 `COMPLETED` 에서 시작 불가, -274 이전) → `12:38:54` **PAUSE** → `12:40:09` **RESUME** → 이후 전부 종료된 임무로 발행. 결과적으로 다음 임무 `93d6f70b` 의 **앞 78분이 비고** 그 주행이 6초짜리 임무 밑에 들어갔다. **-171 이 안전하다고 본 근거(`observe_candidates` 가 `COMPLETED` 에서 새 encounter 를 안 만든다)는 encounter 에만 해당하고 귀속에는 해당하지 않았다.** 조치는 `COMPLETED` 를 `MISSION_START` 가 아닌 신호로 떠날 때 `mission_id` 를 만료시키는 것이며, 판정을 전이 결과 한 곳에 둬서 `ESTOP`·`SENSOR_FAULT` 처럼 핸들러 표를 타지 않는 경로가 빠지지 않게 했다. 곁들여 **진행 중 임무가 있을 때 다른 임무의 `START` 를 `INVALID_STATE` 로 거부한다** — 종전에는 「이미 EXPLORING」으로 무시하면서 `reasonCode` 없이 `EXECUTED` 를 회신했고 백엔드가 그것으로 새 임무의 `started_at` 을 채워, 로봇과 관제가 서로 다른 임무를 진행 중이라고 믿었다(같은 임무의 재요청은 지금처럼 성공). **이미 쌓인 오염 데이터는 이 변경으로 고쳐지지 않는다** — 지우기 전에 임무별 행 수를 봐야 한다(테스트 임무가 실제 주행을 들고 있다). 변경 파일: `README.md`, `05-통신-서버-영상.md`, `jetson/ros2_ws/src/sentinel_mission/sentinel_mission/mission_state.py`, `.../test/test_mission_state.py` |

| v2.0-r22 | 2026-08-06 | 조각 PTS 순서 판정 기준과 동률 규칙 | S15P11A301-304. 05장 32-5 「이벤트 종료와 MP4 생성」에 판정 규칙 표를 넣었다. **사람을 발견해 녹화한 이벤트의 MP4 가 마감 단계에서 버려지고 있었다** — 실측(2026-08-06 13:23) 젯슨 `pending` 39건 중 **17건이 `RECORDING_FAILED_PTS_REGRESSION`**, 같은 임무에서 세 번 중 두 번 영상을 잃었다(서버에 등록된 진짜 발견에 증빙만 없는 상태). 원인은 리베이스가 아니다 — 같은 기간 `PTS 리베이스` 경고가 **0건**이었고, 실패 로그의 역행 sequence 가 3 간격의 규칙적 패턴이었다. 진짜 원인은 **판정에 쓰는 값**이다: `firstPts` 는 링 writer 가 조각 경계에서 읽는 「그 순간 마지막으로 밀어 넣은 입력 PTS」이지 그 조각의 첫 프레임 값이 아니고(32-5 「구현이 추가한 필드」가 33ms 오차로 적어 둔 그 값이다), 프레임을 미는 쪽(ROS 콜백 스레드)과 조각을 여는 쪽(GStreamer 스트리밍 스레드)이 달라 **이웃 조각이 같은 값을 기록**한다. 그런데 판정이 `current.first_pts <= previous.first_pts` 라 **동률이 역행으로 잡혔다.** 바꾼 것: ① 순서 판정을 `muxedPts`(= `format-location-full` 의 `first_sample` 에서 꺼낸 그 조각의 첫 샘플 PTS)로 옮기되 **모든 조각에 있을 때만** 쓴다 — 하나라도 없으면 전부 `firstPts` 로 내려간다(두 값은 기준점이 달라 1시간 오프셋이 섞이면 가짜 점프·가짜 역행이 난다), ② 동률은 통과시키고 `ptsTies` 로 보고한다(조용히 넘기면 인코더 정체를 놓친다), ③ 판정할 값이 없는 조각을 `ptsUnknown` 으로 드러낸다(종전에는 검사가 통째로 비어도 `ok: true` 와 구별되지 않았다), ④ 마감 판정 근거를 이벤트 디렉터리에 `segments.json` 으로 남긴다 — **링 버퍼가 조각 8개만 유지해 실패 몇 초 뒤에는 원본이 순환돼 사라진다**(이번 조사에서 실제로 막혔다). **검사를 없애지는 않았다** — 진짜 역행을 concat 하면 재생이 깨지므로 감소는 여전히 실패다. `firstPts` 도 그대로 둔다(3초 사전 영상 탐색에는 입력 기준이 맞다). 단위 시험 10건 추가(동률 통과 / 진짜 역행 차단 / 스레드 시차가 있어도 muxed 로 정상 판정 / 혼합 시 input 으로 하강 / 값 없음 보고). **미검증**: 실기기 회귀(사람 여러 명 장면에서 연속 3회 이벤트가 전부 MP4 로 나오는지)는 아직이다. 변경 파일: `README.md`, `05-통신-서버-영상.md`, `sentinel_recorder/segment_store.py`, `sentinel_recorder/event_finalizer.py`, `sentinel_streaming/ring_buffer.py`, `sentinel_recorder/test/test_segment_store.py`(신설) |

| v2.0-r23 | 2026-08-06 | 마감 실패 사유의 관제 전달 경로 | S15P11A301-309. 05장 32-5 에 「마감 실패는 텔레메트리로 나간다」를 넣고 telemetry 예시의 `health` 를 갱신했다. **S15P11A301-304 가 19건 쌓일 때까지 드러나지 않은 이유는 판정이 틀렸기 때문만이 아니다 — 사유가 젯슨 디스크 밖으로 나간 적이 없었다.** `mediaState` 는 `report.json` 에만 있었고 그 문자열은 백엔드 java·프런트 tsx 어디에도 없다(전체 검색 0건). 표시 누락이 아니라 **전송 부재**다: `pending_store.ready_for_upload` 가 `has_media and has_checksum` 이므로 **`event.mp4` 가 없는 실패 이벤트는 업로드가 시도조차 되지 않는다.** encounter 자체는 MQTT 로 따로 적재되므로 서버에는 미디어 없는 발견만 남고, 관제는 그것을 「아직 업로드 전」과 구별하지 못한다. 경로를 텔레메트리 `health` 로 만들었다 — `recording_manager` 의 `~/status` 가 `lastFinalizeOk`·`lastFailure` 를 싣고 `cloud_bridge` 가 `recorderOk`·`recorderLastFailure` 로 옮긴다. **성공이 사유를 지우지 않는 것이 요점이다** — 304 는 간헐 실패였고(세 번 중 두 번), 성공 한 번에 지우면 그 정상 이벤트가 직전 실패를 덮는다. 「지금 정상인가」는 `recorderOk`, 「이번 기동에 실패가 있었나」는 `recorderLastFailure` 가 답하며 재발 감지에 필요한 것은 후자다. `ENVIRONMENT_SENSOR_FAULT`(S15P11A301-258)의 자동 해제와 **반대 규칙**인데, DHT11 은 2초마다 판정되지만 마감은 이벤트가 있을 때만 판정되고 그 간격이 몇 분이라 같은 규칙을 쓰면 거의 항상 정상으로 보이기 때문이다. 부팅 복구가 찾은 `CORRUPT` 는 사유만 남기고 `recorderOk` 는 건드리지 않는다(지난 기동의 잔해이지 이번 기동의 마감 결과가 아니다). 판정 로직을 `recording_health.py` 로 분리한 이유는 `recording_manager_node` 가 `rclpy` 를 import 해 CI 에서 돌지 않기 때문이다 — 여기서 틀리면 화면이 조용히 거짓말을 하므로 시험이 붙는 자리에 뒀다. 단위 시험 14건 추가(마감 상태 7건, 계약 7건). **미구현**: 백엔드 적재와 화면 표시. `health` 두 필드를 저장·노출하는 것은 S15P11A301-309 에서 백엔드(이원빈)·프런트로 위임돼 있다. 변경 파일: `README.md`, `05-통신-서버-영상.md`, `common/schemas/telemetry.schema.json`, `sentinel_recorder/recording_health.py`(신설), `sentinel_recorder/recording_manager_node.py`, `sentinel_recorder/README.md`, `sentinel_bridge/message_mapper.py`, `sentinel_bridge/cloud_bridge_node.py`, `sentinel_recorder/test/test_recording_health.py`(신설), `sentinel_bridge/test/test_message_contract.py` |

| v2.0-r24 | 2026-08-06 | 임무 상태 표시의 출처를 로봇 보고로 | S15P11A301-316. 04장 26.3 「관제 화면의 상태 표시는 백엔드가 진실이다」를 고쳐 **두 writer 의 역할 분담**을 적었다. **차체가 멈춰 있는데 화면이 「탐사 중」인 시간이 대부분이었다** — 새로고침하거나 모드 토글을 왔다갔다 하면 「탐사 중」으로 되돌아갔다. 원인은 `missions.status` 가 사실상 **「마지막으로 수락된 명령」의 원장**이었던 것이다(`RobotStateWriter` 가 S15P11A301-298 에서 **수동 여부만** 옮기기로 좁혀 뒀다). 그래서 `START`·`RESUME` 한 번에 `EXPLORING` 이 고착됐다. 실측 3갈래: ① 모드 토글이 `MOTOR_BOARD_NO_ACK` 로 거부되면 `CommandAckWriter` 가 early return 해 아무것도 쓰지 않고 푸시도 없다 — 낙관적 「수동 조종」이 최대 15초 뒤 백업 폴링에서 「탐사 중」으로 되돌아갔고 조작자에게는 가만히 있는데 상태가 바뀌는 것으로 보였다(운영 API 명령 이력에서 MANUAL·AUTO 전부 거부, `RESUME` 이 `INVALID_STATE` 로 2건 — 화면만 `PAUSED` 라고 믿은 결과다), ② 로봇이 스스로 `EXPLORING` 을 벗어난 것(encounter 진행·센서 실패 `PAUSED`·`ESTOP`·`ERROR`·`mission_manager` 재시작)은 어디에도 안 적혔다, ③ `EXPLORING` 으로 열린 임무는 `STOP` 없이 닫히지 않아 다음 페이지 로드가 그것을 이어받았다(로봇이 꺼져 있어도). 고친 것: `RobotStateWriter` 가 1Hz `ROBOT_STATE` 의 `missionState` 를 `status` 에 반영하고, **라이프사이클**(`started_at`·`ended_at`·`end_reason`·`mission_results`)은 계속 `CommandAckWriter` 만 건드린다 — 두 writer 가 같은 칸을 두고 싸우지 않게 하는 경계가 이것이다. 어긋나면 **로봇의 보고가 이긴다.** ACK 와 상태 메시지의 순서는 젯슨 단일 MQTT 연결과 서버 Paho 콜백 한 스레드가 보존하므로 `START` ACK 뒤에 옛 `SAFE_IDLE` 이 도착하는 경합은 없다. **모르는 상태값은 쓰지 않고 경고만 남긴다** — 26.2 의 12개를 백엔드·프런트 양쪽에서 전수로 적는다(모르는 값을 흘리면 프런트 라벨 표에서 조용히 빠지고 화면이 옛 상태를 계속 보여준다. 그것이 고치려는 증상 자체다). 젯슨이 임무 밖 상태(`SAFE_IDLE`·`COMPLETED`)에서 `activeMissionId` 를 비우므로(`MISSION_ACTIVE_BY_STATE`) 그때는 **로봇 이름으로 열린 임무를 찾아** 쓴다 — 그것이 없으면 「로봇은 재시작해 대기인데 DB 는 `EXPLORING`」을 고칠 수 없다. 프런트는 상태 표를 `missionStatus.ts` 로 분리해 시험이 지키게 했고(`motionFromLatest` 와 같은 이유), 거부 ACK 를 확인한 순간 서버 상태를 즉시 다시 반영한다(종전에는 사유 토스트만 띄우고 표시는 최대 15초 거짓말을 유지했다). 새로고침 복구도 같은 경로를 타게 해 `controlMode` 가 함께 복원된다 — 종전에는 「수동 조종」인데 토글은 「자율」인 화면이 최대 15초 나왔다. 시험 14건(백엔드 9, 프런트 5). **범위 밖**: 모드 토글이 `MOTOR_BOARD_NO_ACK` 로 전부 거부되는 것은 별개 원인이며 별도 티켓이다. 변경 파일: `README.md`, `04-자율주행.md`, `RobotStateWriter.java`, `RobotStateData.java`, `RobotStateWriterTest.java`, `missionStatus.ts`(신설), `RobotContext.tsx`, `tests/missionStatus.test.ts`(신설) |
| v2.0-r25 | 2026-08-07 | 영상 없는 발견의 사유 표시 | S15P11A301-311. 05장 32-5 에 「화면은 「영상 없음」을 세 가지로 나눠 말한다」를 넣고 28.6 에 그 원칙을 걸었다. **종전 화면은 「영원히 영상이 없는 발견」과 「아직 업로드 전」을 같은 문구로 보여 줬다** — 앞은 젯슨을 열어야 하고 뒤는 기다리면 되는데 대응이 갈리는 구별이 화면에 없었다. S15P11A301-304 가 19건 쌓일 때까지 드러나지 않은 마지막 고리다(원인은 304, 전달 경로는 309, 적재는 310). 실측(운영 API, 2026-08-06 11:57~12:07 임무 셋): **발견 10건이 전부 미디어 0건이고 텔레메트리는 전 구간 `recorderOk: false`·`RECORDING_FAILED_NO_SEGMENTS`** 인데 화면은 10건 모두 「연결된 영상이 없습니다」였다. **판정 근거가 encounter 가 아니라 임무 시계열이라는 것이 이 표시의 전부다** — 실패한 이벤트는 `event.mp4` 가 없어 업로드 경로를 타지 않으므로 사유가 미디어 행에 실릴 길이 없고, telemetry `health` 로만 온다. 그래서 발견 시각과 텔레메트리 점을 맞춰 귀속시킨다: **마감 창(발견 종료 뒤 120초, 다음 발견이 그 안에 시작하면 거기서 끊음)의 마지막 `recorderOk` 판정**이 실패/업로드 전을 가르고, 판정값이 없으면 「정상」이 아니라 「판정 근거 없음」이다. **판정은 사유가 아니라 `recorderOk` 가 한다** — 래치는 성공에 지워지지 않으므로 사유 유무로 판정하면 한 번 실패한 기동의 모든 발견이 실패로 보이고, 반대로 사유 **변화**로 판정하면 같은 사유가 반복될 때(PTS 동률은 실제로 반복됐다) 두 번째 실패를 놓친다. 창의 **마지막** 점을 보는 이유는 마감이 POST_RECORDING 3초 뒤에 시작해 창 앞쪽에는 아직 직전 마감의 결과가 실려 있기 때문이다. 원문 `mediaState` 는 한국어 문구와 **함께** 보여 준다(툴팁만 두면 마우스 없는 화면에서 열리지 않고, 젯슨 `report.json` 과 눈으로 대조해야 할 때가 있다). 모르는 사유는 원문 그대로 — 젯슨이 `RECORDING_FAILED_{사유}` 로 만들어 값이 늘어난다. 임무 요약에 「녹화기」 칸을 더해 발견을 열지 않아도 실패 기록이 보이게 했다. 시험 17건 신설. **한계**: ① 래치가 임무 경계에서 지워지지 않아 요약 칸은 「이 임무가 실패했다」가 아니라 「실패 기록이 남아 있다」이며 시점은 발견별 판정이 좁힌다, ② `EncounterSummary` 에 미디어가 없어 세 갈래는 발견을 **열어야** 보인다(목록 표시는 미구현 — 서버가 요약에 미디어 유무를 실어야 한다). 변경 파일: `README.md`, `05-통신-서버-영상.md`, `frontend/features/telemetry/recorderStatus.ts`(신설), `frontend/app/blackbox/page.tsx`, `frontend/lib/api.ts`, `frontend/app/blackbox-experiment/mockApi.ts`, `frontend/tests/recorderStatus.test.ts`(신설), `frontend/tests/motionReading.test.ts` |

| v2.0-r25 | 2026-08-06 | 임무 상태 발행 주기가 주행의 전제 조건 | S15P11A301-320. 04장 24.1 에 **「`/mission/status` 발행 주기는 안전 체인의 판정 근거다」 절 신설**. **자율 주행이 구조적으로 불가능했다** — `mission_manager` 가 이 토픽을 전이 때만 발행하는데(`_apply` 의 `if transition.changed`) 소비자 둘이 그 신선도로 정지를 판정한다: `safety_gate`(`mission_ttl_s` 10초)와 `exploration_node`(`status_stale_s` 3초). 상태가 안 바뀌는 것이 곧 정상 주행이므로 **「탐사 시작」 10초 뒤 게이트가 닫혔다.** 실측(2026-08-06, `enable_nav2:=true enable_safety:=true` + exploration 수동 기동): `bt_navigator` 가 목표를 수락하고(`Begin navigating from (0.16,-0.22) to (-2.66,0.02)`) `controller_server` 가 경로를 추종하며 `/cmd_vel_safe` 까지 실제 값(-0.025)이 도달하는데 게이트 출력 `/cmd_vel` 만 0 이었고, 끝에는 `Failed to make progress` 로 목표가 버려졌다. `ros2 topic hz /mission/status` **14초간 0건**. 목표 선택 로그 간격도 6·20·8초로 들쭉날쭉했는데 그것이 exploration 의 3초 판정이었다. **증상이 「Nav2 는 경로를 내는데 로봇이 안 움직인다」라서 게이트를 과하다고 오진하기 쉽다** — 원인은 발행자의 침묵이다. **고친 쪽은 발행자다**: 소비자의 요구가 정당하기 때문이다(latched 값을 무한 신뢰하면 `mission_manager` 가 죽어도 아무도 로봇을 세우지 않는다 — `gate.py` 가 그 근거를 적어 뒀다). `status_heartbeat_seconds`(기본 1.0)로 1Hz 재발행하며, **마지막 페이로드를 그대로** 낸다 — `changedAt`·`previousState`·`reason` 은 전이의 사실이라 heartbeat 가 지금 시각으로 덮으면 「방금 상태가 바뀌었다」는 거짓이 매초 나간다. 그래서 같은 상태를 **사건으로** 읽는 소비자(`map_saver` 의 `COMPLETED`)가 반복 수신에 안전해야 하고, 그쪽 `_saved_missions` 가 이미 임무당 한 번을 보장한다(heartbeat 때문에 생긴 규칙이 아니라 TRANSIENT_LOCAL 재기동 경로 때문에 이미 있었다). `cloud_bridge` 의 생존 판정은 발행자 수를 그대로 쓴다 — 주기에 맞출 상수가 그쪽에 없는 편이 낫다. 결합된 상수 셋(1Hz ↔ 10초 ↔ 3초)을 세 파일 주석과 문서에 함께 적었다. **미검증**: 실기동 회귀(「탐사 시작」 후 멈추지 않고 주행하는지)는 스택 재시작 뒤에 확인한다. 이 워크스페이스는 symlink 설치라 재시작만으로 이 코드가 뜬다. 변경 파일: `README.md`, `04-자율주행.md`, `mission_manager_node.py`, `mission.yaml`, `gate.py`, `map_saver_node.py`, `cloud_bridge_node.py`, `exploration_node.py` |

| v2.0-r26 | 2026-08-07 | 젯슨 재시작이 telemetry 귀속을 끊는다 | S15P11A301-322. 05장 31-5-1 에 **「반대 방향 — 젯슨 재시작은 귀속을 끊는다」 항목 신설**. r20(S15P11A301-307)이 **과잉 귀속**(끝난 임무에 궤적이 계속 붙음)을 다뤘다면 이번은 **귀속 단절**이다. 젯슨은 재시작하면 `SAFE_IDLE`·`missionId=null` 로 시작하는데(26.4 자동 복구 금지) 서버의 임무는 `STOP` 없이 닫히지 않으므로 **「열려 있는데 아무것도 붙지 않는 임무」**가 남는다. 실측(2026-08-07 09:40): 임무 `c493c9ff` 가 전날 21:02 부터 `EXPLORING` 으로 열린 채 `/missions/{id}/telemetry?from=최근60초` **0버킷**, 같은 순간 `/telemetry/latest` 는 24.7℃/60.0% 를 현재 시각으로 반환, ROS `/environment/temperature` 도 수신 중이었다. **증상이 「센서가 죽었다」로 보인 것이 이 항목의 요점이다** — 프런트가 활성 임무를 이어받은 뒤 그 임무의 telemetry 만 보고 비면 결측(—)을 세우고 끝냈기 때문에 온습도·MCU·주행 지표가 한꺼번에 비었고, 조사가 DHT-11 배선과 센서 보드 펌웨어까지 갔다(펌웨어는 무죄였다). 고친 쪽은 **화면**이다: 임무 버킷이 비면 `/telemetry/latest` 로 내려간다. 근거는 온습도·MCU·주행 지표가 **임무 귀속과 무관한 관측값**이라는 것 — 센서 패널은 「지금 로봇 주변이 어떤가」이지 「이 임무의 기록」이 아니고, 임무가 없을 때 이미 같은 API 를 쓴다. **고장을 감추지 않는다**: 로봇이 실제로 죽으면 최신값도 60초 신선도 규칙에 걸려 결측이 된다. 신선도 판정·결측 처리를 `sensorReading.ts` 로 빼고 시험 7건을 붙였다(`motionFromLatest` 와 같은 이유 — 화면 안에 두면 시험이 닿지 않아 조용히 썩는다. 실제로 썩은 것이 이 결함이다). **남는 것**: 그 구간의 궤적·telemetry 이력은 어느 임무에도 붙지 않는다. 재시작 후 `missionId` 승계 여부는 별개 결정이며(26.4 가 금지한 것은 자동 *주행* 복구이지 식별자 승계가 아니다) 미결로 남긴다. 변경 파일: `README.md`, `05-통신-서버-영상.md`, `sensorReading.ts`(신설), `RobotContext.tsx`, `tests/sensorReading.test.ts`(신설) |

| v2.0-r27 | 2026-08-07 | ESP32 링크 진단 — 무응답과 드롭을 가른다 | S15P11A301-323. 06장 37-7 에 **「ESP32 링크가 조용할 때 `/diagnostics` 를 먼저 읽는다」 절 신설**, 04장 22.1 DHT11 행 정정. **「보드가 말이 없다」와 「말은 하는데 우리가 버린다」가 ROS 에서 똑같이 조용했다.** 그 비용을 이틀에 두 번 치렀다 — ① 모터 보드 무응답(S15P11A301-317): `/diagnostics` 에 MOTOR 항목이 **아예 없었다**(보드의 DIAGNOSTIC 프레임을 받았을 때만 발행했다). 「항목 없음」은 화면에서 「정상」과 구별되지 않고, 파싱 실패는 카운터 없이 버려져 「바이트가 안 온다」와 「보레이트가 어긋나 쓰레기가 온다」가 같아 보였다. ② 환경 프레임: `/environment/*` 가 조용한 이유가 미수신인지 `status_flags != VALID` 드롭인지 알 수 없어 **정상 동작이 「펌웨어가 소스와 다르다」로 오진**됐다(DHT 간헐 실패 + 연속 3회 미만이라 보드 fault 비트가 안 뜨는 조합). 넣은 것: 모터는 `esp32_bridge: MOTOR_LINK` 를 **보드가 죽어 있어도 1Hz 로 발행**하고 `rx_frame_count`·`parse_error_count`(예외 종류별)·`hello_sent_count`·`since_last_rx_s` 를 싣는다 — **`rx_frame_count` 가 0 인가 아닌가가 두 실패를 가르는 값이다**(프레임이 선 횟수이고 파싱 성공과 무관하다). HELLO 5회 무응답이면 ERROR 로그를 한 번 크게 낸다. 센서는 `esp32_bridge: ENVIRONMENT` 로 수신·발행·`status_flags` 별 드롭 수를 낸다(IMU 가 이미 갖고 있던 것과 같은 모양). 판정은 ROS 없는 `link_health.py` 로 빼고 시험 9건을 붙였다(`recording_health.py` 와 같은 이유 — 노드 파일은 `rclpy` 를 import 해 CI 에서 돌지 않는다). **실측 검증**(2026-08-07, 실제 무응답 보드): `MOTOR_LINK level=ERROR / rx_frame_count=0 / parse_error_count=0 / hello_sent_count=10` 과 `[ERROR] 모터 ESP32 무응답: HELLO 5회에 답이 없고 … 프레임을 한 번도 받지 못했다` 를 확인했다 — **보드가 살아나면 이 경로는 재현할 수 없으므로 지금 검증했다.** 변경 파일: `README.md`, `04-자율주행.md`, `06-테스트-보안-운영.md`, `link_health.py`(신설), `esp32_motor_bridge_node.py`, `esp32_sensor_bridge_node.py`, `test/test_link_health.py`(신설) |

| v2.0-r28 | 2026-08-07 | 모터 보드 링크를 관제까지 올린다 | S15P11A301-317. 05장 31-6 telemetry 예시와 32-5 `health` 표에 `motorLinkOk` 를 넣었다. **보드가 둘인데 관제가 볼 수 있는 값은 하나였다** — `mcuConnected` 는 엔코더를 내는 **센서** 보드이고, 바퀴를 돌리는 **모터** 보드 상태는 화면 어디에도 없었다. 2026-08-06 실기동에서 모터 보드만 죽었을 때 조작자가 그것을 아는 유일한 방법이 **명령을 눌러 6초쯤 기다렸다 거부 알림(`MOTOR_BOARD_NO_ACK`)을 받는 것**이었고, 그전까지 화면은 「탐사 중」을 그대로 보여줬다. 경로는 S15P11A301-310 이 `recorderOk` 로 뚫어 둔 telemetry `health` 를 그대로 쓴다 — `components` 는 백엔드가 파싱만 하고 버리며 로봇 상태 엔드포인트가 없어서, 새 경로를 만드는 것보다 있는 길을 쓰는 편이 맞다. 판정은 `~/drive_state` 신선도다(보드가 50Hz 로 보내므로 조용하면 링크가 끊긴 것이고, `mcuConnected` 가 엔코더 토픽으로 센서 보드를 보는 것과 같은 방식이다). **3값을 유지한다**: true / false(확인했고 끊김) / null(확인할 수단 없음 — 모터 보드 없는 구성, 젯슨 재빌드 전 스택). 화면은 `false` 일 때만 경고한다 — `null` 로 경고하면 모터 없는 개발 구성이 상시 빨간불이 된다. **그래서 「한 번도 못 받음」을 `null` 로 두면 안 된다**: `_fresh` 의 기본 규칙이 그렇고, 그대로 쓰면 **부팅부터 죽어 있던 보드가 조용해진다** — 2026-08-06 실기동이 정확히 그 경우였다(보드가 HELLO 에 한 번도 답하지 않았다). 「구성에 없음」과 「있어야 하는데 죽음」은 **발행자 유무**로 가른다(`link_state`) — 브리지는 보드가 죽어 있어도 토픽 발행자를 만들어 두므로 발행자가 있는데 프레임이 없으면 보드 문제이고, 발행자가 없으면 그 보드가 이 구성에 없는 것이다. `_mission_manager_alive` 가 쓰는 기법과 같다. 관제 표시는 StatusPanel 의 경고 띠이고 **임무 상태와 독립**이다: 보드가 죽어도 임무는 「탐사 중」일 수 있으며 실제로 그랬다(명령은 나가는데 바퀴가 안 도는 상태). 시험: 백엔드 계약 2건(키 없음 → null / 두 보드가 한 메시지에서 다른 값), 젯슨 계약 5건(스키마 통과 · 키 없어도 통과 · 무응답 보드를 경고로 · 보드 없는 구성은 null · 신선도 우선), 프런트 106건 통과. **미검증**: 실기동에서 화면에 실제로 뜨는 것은 백엔드 배포 뒤에 확인한다. 변경 파일: `README.md`, `05-통신-서버-영상.md`, `telemetry.schema.json`, `telemetry-motor-link-down.json`(신설), `cloud_bridge_node.py`, `V9__robot_metrics_motor_link.sql`(신설), `TelemetryData.java`, `TelemetryWriter.java`, `TelemetryQueryService.java`, `TelemetryLatestResponse.java`, `MissionService.java`, `TelemetryPointResponse.java`, `MessageContractTest.java`, `test_message_contract.py`, `api.ts`, `mockData.ts`, `RobotContext.tsx`, `StatusPanel.tsx` |

| v2.0-r29 | 2026-08-07 | 사람 접근 주행 (bearing-only) | S15P11A301-247. 04장에 **24.6 절 신설**, 8.2 노드 표에 `sentinel_approach` 추가. **`PERSON_APPROACHING` 에서 주행 목표를 내는 노드가 하나도 없었다** — 상태 머신은 전이를 하고 `MOVEMENT` 표가 0.10m/s 를 허용하는데 속도를 내는 쪽이 없어, 로봇은 사람을 발견하고 그 자리에 서 있었다. `SAFE_POSE_REACHED` 를 보내는 것도 시뮬레이터뿐이었다. 즉 시연 시나리오 「발견 → 접근 → 대화」의 접근 단계가 비어 있었다. **bearing-only 로 만든 이유**: 25.3 의 `MEASURED` 경로(지도 좌표 목표)는 입력이 없다 — 탐지 노드가 `position` 을 **항상 null** 로 낸다(`ai/detection/src/candidates.py`). 그래서 카메라 방위각 + 그 방향 LiDAR 거리만 쓰며, **Nav2·SLAM 없이 동작한다**(`enable_approach` 는 `enable_nav2` 가 아니라 `enable_detector` 와 AND). **티켓 본문의 낡은 서술을 정정했다**: 247 은 「방위 정렬(제자리 회전) 후 전진」이라고 적혀 있는데 그것은 차동 구동 전제이고, 2026-08-06 전륜 서보 조향 전환으로 무효다(`vehicle_kinematics` 가 `v≈0·ω≠0` 을 거부한다). 접근은 **전진하며 조향하는 호**이고 곡률이 `1/R_min` 으로 제한된다. `ApproachCommand` 자료형이 `v=0·ω≠0` 을 **생성 시점에 거부**한다 — 그 불변식이 이 모듈의 존재 이유다. 멈추는 조건 넷을 표로 적었다(거리 모름 → 정지, 사람 상실 → `APPROACH_FAILED`, 0.60m → `SAFE_POSE_REACHED`, 상태 불일치 → 정지). **정지거리 0.60m 는 `collision_monitor` 정지 구역 0.40m 보다 커야 한다** — 작으면 안전 체인이 먼저 속도를 0 으로 만들어 도착 선언이 영원히 안 나온다. 충돌 회피는 여기서 하지 않는다(24.3·237). 시험 17건(순수 모듈), CI `test:exploration` 잡에 추가. **실 스택 확인**(2026-08-07): 노드가 `/scan` 을 받고 후보 bbox 로 방위각 0.23rad 을 계산했으며, 게이트가 닫힌 상태에서 `/cmd_vel_nav` 81건이 전부 0 이었다. **미검증**: 실제 접근 주행은 모터 보드 복구(S15P11A301-321) 뒤다. 변경 파일: `README.md`, `04-자율주행.md`, `.gitlab-ci.yml`, `sentinel_approach/`(신설: `approach.py`·`approach_node.py`·`test/`), `approach.launch.py`(신설), `demo.launch.py` |

| v2.0-r30 | 2026-08-07 | 무부하 검증이 찾은 주행 블로커 셋 | S15P11A301-172. **머지된 코드가 실제로는 한 발도 못 나가는 상태였다.** 모터 보드가 죽어 바퀴가 안 도는 동안 명령 품질만 관측했더니 셋이 나왔다. ① **Nav2 가 172 머지 이후 계속 inactive** — `behavior_plugins` 에서 `spin` 을 뺐는데 기본 BT XML 이 여전히 `Spin` 을 호출해 `bt_navigator` 활성화가 실패했다(`Exception when loading BT: Action server spin not available`). 플러그인 목록과 BT 트리는 **한 쌍**이며 한쪽만 바꾸면 Nav2 전체가 죽는다. 기본 트리에서 Spin 만 뺀 사본 둘을 두되(`through_poses` 도 필요 — bt_navigator 는 둘 다 로드한다) **경로는 launch 에서 넘긴다**: params YAML 은 launch 치환을 해석하지 않아 `$(find-pkg-share ...)` 가 문자열로 전달되고 파일을 못 연다(이것도 실측으로 한 번 밟았다). ② **선점된 목표의 결말이 새 목표의 실패로 기록됐다** — `Nav2Navigator` 가 목표를 `self._pending` 하나에 담아 결과 콜백이 그것을 읽었는데, 선점은 결과가 둘 떠 있는 순간을 만든다. 그 가짜 실패가 블랙리스트 카운터를 올려 멀쩡한 자리를 지웠고 **선택 → 선점 → 실패의 자기 유지 루프**가 됐다(실측: 2초마다 목표가 바뀌며 한 자리도 끝까지 못 감). 목표마다 `seq` 를 붙여 남의 결말을 버린다. 수정 후 12초 동안 목표 2건·실패 0건으로 약속 정책이 지켜진다. ③ **탐지가 죽으면 스택 28개 노드가 전부 내려갔다** — 재기동 핸들러가 `respawn_limit` 을 이벤트 시점에 읽는데 `demo.launch.py` 가 `GroupAction(scoped=True)` 으로 include 해 그때는 스코프가 닫혀 있다. 실측에서 탐지가 CUDA 메모리 부족(`CUBLAS_STATUS_ALLOC_FAILED`)으로 죽자 전부 종료됐다 — 32장 장애 격리를 정면으로 어기며, 그 코드 주석이 막으려던 상황 자체다. 값을 `setup`(스코프 안)에서 읽어 둔다. **무부하 검증의 값어치가 이 항목의 요점이다** — 바퀴 없이 관측만으로 셋 다 잡혔고, 보드가 살아난 뒤였다면 「왜 안 움직이지」로 다시 시작했을 것이다. 함께 확인된 것: `MOTOR_LINK` 진단이 정식 스택에서 `ERROR/rx_frame_count=0`, `ENVIRONMENT` 가 `수신 59건 중 12건(20%) 버림`(어제의 「성공률 27%」는 짧은 창의 오측이었고 실제는 문서의 18.5% 실패율과 같은 수준), `/mission/status` 1.03Hz, 센서 보드 `fw=0.1.1` 핸드셰이크. **미해결**: 제자리 회전 명령이 아직 2건 나온다(shim 외의 경로), 모터 보드 무응답(S15P11A301-321). 변경 파일: `README.md`, `behavior_trees/`(신설 2), `CMakeLists.txt`, `nav2.yaml`, `nav2.launch.py`, `detection.launch.py`, `navigator.py` |
| v2.0-r31 | 2026-08-07 | 영상 경로가 CPU 최대 소비자였다 — 15FPS·1500k 와 시청자 수 관측 | S15P11A301-328. 07장 25.5 에 **「부하가 클 때 줄이는 순서」와 「시청자 수가 비용을 곱한다」 두 절 신설**, 25.7 에 249 계측 결과 기록. **줄여야 할 대상이 문서와 반대였다** — 25.5 는 부하 시 추론 입력 축소(640→512→416)를 먼저 검토하라고 적었는데, 그 방향은 S15P11A301-186 이 이미 무효로 확인했다(`imgsz` 640→416 에서 `detect_ms` 73.8→70.5ms, 3.6% 개선에 탐지 수 19.9% 감소 — 연산량이 아니라 고정 오버헤드가 병목이라 픽셀에 반응하지 않는다). **249 의 per-process 표는 인용하지 않는다** — 거기서 탐지 68.2 · `stream_pipeline` 56.5 로 「영상이 더 크다」고 읽혔는데, 2026-08-07 에 `top` 과 `/proc` 델타 두 방법으로 다시 재니 탐지 227~432% · `stream_pipeline` 29~31% · `mediamtx` 4.5~5.0% 로 **탐지가 압도적 1위이고 영상은 그 1/7** 이었다(6배 차이라 결론이 뒤집힌다). 그래도 이 변경을 하는 이유는 **탐지를 줄일 수단이 없기 때문**이다 — 입력 축소는 위처럼 무효이고 TensorRT 는 이미 적용돼 있다. 즉 순서는 「큰 것부터」가 아니라 **「줄일 수 있는 것부터」**이며, 영상 절감은 절대량이 작아도 화질 손실 없이 가능하고 시청자 수만큼 곱해진다. **하드웨어 인코더로 도망갈 수 없다**: Orin Nano 에는 NVENC 가 없다(`/dev/nvhost-msenc` 부재, `gst-inspect` 에 `nvv4l2h264enc` 없음) — `x264enc` 는 선택이 아니라 유일한 경로이며, 이 줄이 앞으로 같은 제안을 기각하는 근거다. 넣은 것: `encode_framerate` 30→15, `encoder_key_int_max` 30→15, `encoder_bitrate_kbps` 2500→1500. **S15P11A301-191 이 30 으로 되돌리며 단 「포화 시에만」 조건을 어기지 않는다** — 191 이 기각한 것은 「인코딩을 깎아 추론 FPS 를 살린다」는 거래이고 그 판단은 지금도 옳다(CPU 27%p 를 풀어줘도 추론은 +0.49 뿐, 병목이 LPDDR5 대역폭이라). 328 의 근거는 추론이 아니라 **시청자 수만큼 곱해지는 비용**이다 — 인코딩은 `tee` 로 갈라져 한 번만 하지만 mediamtx 패킷화·SRTP 암호화와 대역폭은 **세션마다 따로** 든다(같은 브라우저의 다른 창도 별개 PeerConnection 이고 세션마다 키가 달라 재사용이 불가능하다). 191 의 순서(「비트레이트가 먼저」)도 지킨다: 30fps 에서 1500k 만 내리면 프레임당 50 kbit 으로 화질이 나빠지고, **15fps 와 묶어야 111.3 kbit 으로 현행 89.9 보다 오히려 좋아진다**(실제 카메라 입력으로 노드를 하나 더 띄워 실측). 1000k 는 75.1 kbit 으로 현행보다 적어 기각했다. **249 는 시청자 수를 통제하지 않아 오염됐다** — 로그를 사후에 뒤져서야 동시 시청자 14 명을 찾았고, `mediamtx` 31.2% 의 대부분이 그 비용이었다(유휴 2.6% + 14×약 2%p = 30.6). 그래서 `enable_nav2` 판정에 쓸 수 없고, 같은 A 구성에서 시청자 없이 관측하면 탐지가 17.5~18.0 FPS 였다(계측값 7.6). 재발을 막으려고 `mediamtx.yml` 에 API 를 켰다(`/v3/paths/list` 의 `readers` 길이가 시청자 수, 실측 0/3/0 확인). **`apiAddress` 는 루프백으로 묶는다** — 인증이 없고 경로 삭제·연결 킥 쓰기 엔드포인트가 있어 열면 같은 망의 누구나 시연 중 스트림을 끊을 수 있다. **채택하지 않은 것**: `maxReaders` 상한(나중에 온 시청자를 거부하는데 그게 곧 조종자이고, 영상이 없으면 `stalledBlock` 이 SR-010 으로 수동 전진까지 막는다 — CPU 를 아끼려고 주행을 막는 셈), 해상도 축소(증빙 영상의 사람 식별 요구사항 확정이 먼저), 서버 릴레이(시청자 5명 초과 시 검토). **미검증**: 15FPS 에서의 링 조각 1초 유지와 오디오 손실 경고 부재는 스택 재기동 뒤 확인한다. 변경 파일: `README.md`, `07-AI-탐지.md`, `media.yaml`, `mediamtx.yml` |
| v2.0-r33 | 2026-08-07 | 마이크가 꽂혀 있는데 무음이었다 — PulseAudio 기본 소스 고정 | S15P11A301-330. 08장 33.6 「오디오 확인」에 **「PulseAudio 기본 소스가 BRIO여야 한다」 절 신설**. E2E 리허설에서 요구조자가 대답했는데 무응답으로 처리되고 세션이 즉시 끝났다. 원인은 마이크가 아니라 **기본 소스**였다 — `Default Source` 가 `alsa_input.platform-sound.analog-stereo`(젯슨 온보드 아날로그, 아무것도 안 꽂힘)로 잡혀 `peak=0.00000000` 인 **디지털 무음**을 읽었다. BRIO 는 `SUSPENDED` 로 아무도 쓰지 않았다. **장치 목록에 BRIO 가 보이는 것으로는 부족하다** — `arecord -l` 도 `pactl list sources` 도 BRIO 를 보여주는데 정작 기본 소스가 다른 것이었고, 그래서 진단이 오래 걸렸다. **대가가 둘이었다**: ① 음성 인식이 대답을 못 받아 무응답으로 오판 ② **이벤트 영상의 오디오 트랙이 `mean_volume -91.0 dB` 로 완전 무음** — 두 소비자(음성의 PortAudio 경로, `stream_pipeline` 의 `pulsesrc`)가 같은 기본 소스를 쓰기 때문이다. ②는 명세 32-6 위반이다(요구조자와의 대화를 증빙으로 남기게 되어 있다). **파일은 정상 생성되고 오디오 트랙도 있어서 겉으로는 성공처럼 보인다** — 이 조합이 이 결함을 오래 숨겼다. 고침은 `scripts/demo_up.sh` 에서 한다: 스택의 단일 진입점(S15P11A301-294)이자 모든 노드의 부모라 `pactl set-default-source` 와 `PULSE_SOURCE` export 가 **두 소비자에게 함께 상속**되고, 데스크톱 세션의 pulse 설정에 의존하지 않고 매 기동마다 강제된다. 매칭은 유닛 시리얼이 아니라 `usb-046d_Brio_100` 모델 부분열로 해 같은 모델의 다른 유닛도 듣는다. 못 찾으면 **크게 경고하되 스택을 막지 않는다**(32장 장애 격리) — 다만 무엇이 조용해지는지 적는다. **실측 검증**: 기본 소스 → BRIO, `PULSE_SOURCE` 를 voice·stream_pipeline 둘 다 상속, 마이크 peak 0.00000000 → **0.692616**, 링 조각 오디오 −91.0dB → **−41.1dB**(max −32.6), BRIO 없는 경우 경고 후 계속 기동. S15P11A301-257 이 넣은 무음 감지가 조용한 오답 대신 원인을 지목해 준 것이 출발점이었고, 그 메시지에 **확인 절차를 덧붙였다** — 「빈 경로를 읽고 있다」까지만 알려주고 무엇을 해야 하는지는 없었다. **같은 리허설에서 나온 결함 둘은 별건이다**: post-recording 재감지 루프로 encounter 가 끝나지 않아 녹화가 105초로 연장되고 두 번째 사람에게 세션이 안 열린 것, 그리고 `splitmuxsink` 가 **같은 inode 에 덮어써서** 링 하드링크 보호가 거짓이었던 것(실측: 링 한 바퀴 후 `ino` 동일·크기만 변경 → `segments.json` 105 항목에 고유 파일 8개, 결과 영상은 먹싱 시점 8초가 13회 반복). 변경 파일: `README.md`, `08-AI-음성.md`, `demo_up.sh`, `session_runner.py` |
| v2.0-r34 | 2026-08-07 | 0.18초 끊김에 대화가 죽고, 재감지가 5분 예산을 초기화했다 | S15P11A301-332. 08장 33.2 안전 경계에 「순간 유실을 대화 종결로 기록하지 않는다」, 05장 종료 예외에 「재탐지가 5분 예산을 초기화하지 않는다」 추가. **같은 사람을 보면서 두 노드의 관용도가 달랐다** — 유실 구간이 **0.179초**였는데 `mission_manager` 는 사후 3초 창의 재감지로 회복했고 `voice_session` 은 첫 `LOST` 를 종결로 처리했다. 심지어 그 직후 `[STT] 나 보여?` 로 **답을 받아놓고 버렸다**(8.4 FPS 에서 프레임 두어 장이면 0.2초다). 고침은 `LOST_GRACE` 상태 하나다 — 유실에 즉시 포기하지 않고 재감지를 기다린다. **창 길이를 음성 쪽에 복사하지 않는다**: 창의 주인은 `mission_manager` 이고, 창이 닫히면 임무 상태가 `INTERACTING`·`POST_RECORDING` 을 벗어나므로 그것을 신호로 쓴다(그 전이는 phase 를 발행하지 않아 이벤트만으로는 알 수 없다). 값을 복사해 어긋난 것이 이 결함의 원인이었으므로 같은 실수를 구조적으로 막는다. **두 번째 결함은 진단을 한 번 고쳤다.** 처음에는 「대화가 끝난 encounter 를 재감지로 되살리는 것이 잘못」이라 보고 이유별로 가르는 수정을 만들었는데, `encounter.schema.json`(32-5)이 **조건 없이 되돌리도록 명시**하고 있었고 기존 시험이 그것을 검증하고 있었다 — 이건 *녹화* 상태 머신이고 목적이 「사람이 아직 있으면 이벤트를 둘로 쪼개지 않는다」는 증빙 연속성이다. 되돌리고 다시 보니 진짜 결함은 재감지 경로가 **`interaction_started_at` 을 매번 현재 시각으로 재설정**하는 것이었다. `MAX_INTERACTION_SECONDS`(300초, 32-5 `MAX_EVENT_SECONDS` 와 같은 값)가 그 시각 기준이라 사람이 화면에 남아 있으면 3초마다 예산이 새로 생겨 **상한에 영원히 닿지 않는다**(재시도마다 타임아웃을 초기화하는 결함). 실측에서 녹화가 105초까지 갔고 링이 8초뿐이라 영상이 오염됐다. 첫 진입 시각을 유지하도록 고쳤다 — 명세를 어기지 않고 상한만 되살렸고, 기존 시험 88건이 그대로 통과한다. 함께 넣은 것: `demo.launch.py` 가 접근의 `stop_distance_m` 을 전달한다(`approach.launch.py` 가 인자를 노출해 뒀는데 `_include` 가 비워 두고 `GroupAction(scoped=True)` 라 상위 인자가 새어들지 않았다). 자율주행이 없는 동안 음성 구간을 검증하는 수단이다 — 정지거리를 올리면 접근 노드가 즉시 도착을 선언해 **같은 코드 경로로** 6초 안에 첫 멘트가 나온다(우회 플래그를 만들지 않은 이유다). 기본값 0.60 은 유지한다. **실측 검증**: 순수 모듈 시험 voice 20건·mission 88건 통과, `정지거리 6.00m` 가 실기동 로그에 반영. 변경 파일: `README.md`, `05-통신-서버-영상.md`, `08-AI-음성.md`, `encounter.py`, `integration.py`, `ros_node.py`, `test_encounter.py`, `mission_state.py`, `test_mission_state.py`, `demo.launch.py` |
| v2.0-r35 | 2026-08-07 | 하드링크가 아무것도 보호하지 않았다 — 링 조각을 원자적 복사로 | S15P11A301-333. 05장 32-5 의 「hard link 또는 원자적 복사」에서 **hard link 를 뺐다**. 이벤트 영상이 8~10초 구간을 13회 반복하고 담긴 내용도 이벤트가 아니라 먹싱 시점의 링 내용이었다. 104초·1544프레임(14.85fps)으로 **길이와 프레임 수가 일치**하므로 PTS 문제가 아니었다 — 정말 104초를 담았는데 `segments.json` 이 **조각 105개 / 고유 파일 8개**(`seg_000001.ts` 14회)였다. 원인: **`splitmuxsink` 가 `max-files` 로 파일을 지우고 새로 만드는 것이 아니라 같은 inode 를 truncate 해서 덮어쓴다.** `segment_store.py` 의 근거(「링이 원본을 지워도 inode 가 살아 있다」)가 이 writer 에서는 거짓이었다. **진단을 두 단계로 확인했다**: 처음엔 「링 한 바퀴 뒤에도 inode 번호가 같다」만 봤는데 그것으로는 파일시스템의 inode 번호 재활용과 구별되지 않는다 — 링크를 걸어 두고 14초 뒤 **링크 파일의 내용을 직접 비교**해서 갈랐다(`nlink=2` 인데도 `sha 6d247d94… → caf99e1c…`). **수집 시점과 목적지 이름은 이미 옳았다** — 녹화 노드는 매 틱마다 조각을 가져오고(「링 버퍼가 8초만 보관하므로 나중에 한 번에 모을 수 없다」) 목적지는 sequence 기준으로 유일하다(`local_filename`). 틀린 것은 **가져오는 방법 하나**였고, 105개 목적지가 8개 inode 를 가리켜 마지막 8초가 반복됐다. 고침은 `.part` 에 복사한 뒤 `os.replace` — 32-5 가 말한 「원자적」이 이 절차다(중간에 죽어도 잘린 `.ts` 가 목적지에 남지 않는다). **「복사하면 디스크를 두 번 쓴다」로 되돌리지 않도록 근거를 코드에 박았다** — link 가 아낀 것은 실제로 아낀 것이 아니었고 그 데이터는 파괴되고 있었다(1500kbps 에서 초당 190KB, 300초 상한까지 57MB, `pending` 상한 580MB). `ring_buffer.py` 의 같은 거짓 서술도 고쳤다. **시험 14건 통과, 그중 2건은 옛 구현(hard link)에서 실패한다** — 시험이 결함을 실제로 잡는지 확인했다. **미검증**: 8초를 넘는 실제 이벤트에서 고유 파일 수가 조각 수와 같은지는 실기동 확인이 남았다. 변경 파일: `README.md`, `05-통신-서버-영상.md`, `segment_store.py`, `test_segment_store.py`, `ring_buffer.py` |
| v2.0-r36 | 2026-08-07 | 스택 두 벌이 겹쳤는데 증상은 「주행이 안 된다」였다 | S15P11A301-338. **06장 37-3-2 신설.** `demo_up.sh` 의 이중 기동 거부(294)가 **systemd 서비스만 보아** 손으로 두 번 부르면 둘 다 통과했다. 20초 간격 두 번 호출로 두 벌이 **7분 10초** 겹쳤고, 겹치는 자원 네 개가 각각 다른 증상으로 나타나 **어느 것도 「두 벌이 떴다」로 보이지 않았다** — 모터 시리얼 경합(`DRIVE_STATE 0.5~0.8초 끊김` → 주행 불가), `/mission/status` 발행자 2개(`missionId: null`), MQTT client id 충돌(2.6초 주기 재연결 146회 → 명령 `PENDING`), 잔여 DDS 세그먼트(노드는 살아 있는데 `ros2 node list` 0개). 다른 파트는 이것을 「`mission_manager` 가 죽었다」로 보고했으나 로그에 예외가 없고 노드는 살아 있었다. 막는 곳을 **기동 지점**으로 정하고 MQTT client id 유일화는 **버렸다** — 같은 ID 가 서로 끊는 지금 동작이 중복을 드러내는 신호이고, 유일화하면 두 벌이 조용히 공존한다. `flock`(기동 중 구간) + 프로세스 검사(스크립트를 우회한 기동) **둘 다** 둔 근거와 PID 파일을 쓰지 않은 근거를 적었다. 프로세스 검사는 **특정 노드를 기준으로 삼을 수 없다** — `enable_mission` 을 포함해 `enable_*` 가 15개라 어느 노드든 꺼진다. launch 부모와 `install/sentinel_*/lib/` 경로 두 갈래로 보며, 후자가 launch 부모만 죽고 노드가 남은 상태(2026-08-07 실측)를 덮는다. `demo_down.sh` 는 **두 벌 이상이어도 전부 내린다**(자식 트리가 아니라 `ps -e` 전체를 경로 패턴으로 훑는다) — 남는 위험은 인스턴스 수가 아니라 **패턴 목록이 손으로 관리되는 것**이라고 명시했다. **`/dev/shm` 전체 삭제 금지**를 명시 — Tegra IPC 세그먼트 43개가 섞여 있어 지우면 카메라·GPU 경로가 깨진다. 변경 파일: `README.md`, `06-테스트-보안-운영.md`, `demo_up.sh`, `demo_down.sh` |
| v2.0-r37 | 2026-08-07 | 「주행 구간 스케일이 2배 틀렸다」는 오염된 측정이었다 | S15P11A301-339. **03장 「거리 스케일」에 선행 조건 절 신설.** S15P11A301-337 이 남긴 「속도 의존 틱 손실(에일리어싱)」 결론을 **정정했다** — 그 측정 시각에 브리지가 센서 보드 재부팅을 **73초 동안 29회** 감지했고, 재부팅마다 `reset_encoder_origin()` 이 불려 그 구간 이동량이 버려진다. 같은 창에 스택도 두 벌 떠 있었다(-338, 마지막 감지가 스택 B 종료 시각과 일치). 즉 주행 구간 스케일은 **틀린 것이 아니라 아직 측정되지 않았다.** **에일리어싱은 이 속도에서 원인이 아니다** — 샘플링 100Hz 의 모호성 한계는 모터축 50 rev/s 이고 0.25 m/s 에서 모터축은 13~26 rev/s(유효 기어 41 또는 82)로 절반 이하다. 설정 주석의 「초당 약 47 회전」도 틀린 값이라 26.1 로 고쳤다. 그럴듯해서 다시 의심하게 되는 가설이라 **기각 근거를 문서에 남겼다** — 의심하려면 먼저 최대 샘플 간격을 재야 한다. 측정 선행 조건 둘(스택 한 벌 / 주행 중 재부팅 0)을 명시했고, 펌웨어의 조용한 손실 경로 셋(재접속 기준점 리셋·고정 dt·바퀴 지름 120mm)은 담당 레인(센서 펌웨어)에 위임했다. 변경 파일: `README.md`, `03-제어-캘리브레이션.md`, `esp32_bridge.yaml` |
| v2.0-r38 | 2026-08-08 | 서보 각과 바퀴 각을 1:1 로 가정해 바퀴가 지령의 40%만 꺾였다 | S15P11A301-341. **03장 「조향 각도 매핑」에 링키지 비 절 신설.** 하드웨어 실측(서보 중립 145°, 최대 오프셋 ±55°, 그때 앞바퀴 22°)이 들어오면서 **링키지 비가 55/22 = 2.5** 임이 드러났다. 펌웨어는 그 비를 두 끝값의 몫(`servoMaxOffsetDeg / (STEERING_MAX_MDEG/1000)`)으로 계산하는데 값이 30/30 = **1.0** 이었다. 그래서 ROS 가 δ=22° 를 지령해도 실제로는 **8.8° 만 꺾이고 R_min 이 1.69m 가 아니라 4.41m** 였다. **이것이 자율주행이 안 되던 실제 원인이다** — 컨트롤러가 1.69m 곡률을 요구하는데 차가 4.4m 밖에 못 내니 조향이 상한에 붙은 채(`steering_clamp_count` 7224) 넓은 호로 벌어져 목표에 수렴하지 못하고 progress checker 가 포기했다. 오도메트리 문제로 오래 오해했다. **층 구분을 명시**했다 — ROS 의 `max_steering_deg` 는 앞바퀴 실제 각이고 서보 각 변환은 펌웨어 몫이다(여기에 55 를 넣으면 자전거 모델이 틀린 δ 를 쓴다). `vehicle_kinematics_node.py` 의 낡은 기본값(0.50 / 30.0)을 실측(0.683 / 22.0)으로 바꾸고, **「펌웨어의 30000 과 같아야 한다」는 해로운 주석을 정정**했다 — 그대로 따르면 실측을 가정값으로 되돌린다. 펌웨어 두 상수(22000 / 55)는 담당 레인에 위임. 변경 파일: `README.md`, `03-제어-캘리브레이션.md`, `safety.yaml`, `vehicle_kinematics_node.py` |
| v2.0-r40 | 2026-08-08 | 접근 상한 0.10 은 정지 마찰 아래 — 로봇이 접근을 시작조차 못 한다 | S15P11A301-343. **04장 24.2 표 갱신.** 실측(2026-08-08)으로 정지 마찰 경계가 **PWM 17~25% 사이**로 확인됐다 — 0.10 m/s 명령(PWM 17%)은 정지, 0.15 명령(PWM 25%)은 주행. 따라서 「피해자 접근 0.10」은 물리적으로 불가능한 값이었다: PERSON_APPROACHING 에서 한 발짝도 못 가 도착 선언이 없고 INTERACTING 으로 넘어가지 못한다. **0.15 로 올렸다**(`approach.py` 기본값 포함). 자율 탐사 기본 명령값도 **0.15 로 확정** — 교실 시연 기준 적정 판단이며, `nav2.yaml` 의 「확인 뒤 0.25 로 올린다」 잠정 서술을 결정으로 바꿨다. `velocity_smoother` 상한 0.25 는 유지하고 주석의 「desired_linear_vel 과 같은 값이어야 한다」를 「이상이어야 한다」로 정정 — 캘리브레이션 주행(342, 0.20~0.25 명령)이 체인을 지나야 한다. **주의: PWM 매핑(342) 확정 전에는 명령값과 실속도가 다르다** — 매핑 확정 후 체감 속도 재확인 항목을 343 에 남겼다. 변경 파일: `README.md`, `04-자율주행.md`, `approach.py`, `nav2.yaml`, `safety.yaml` |
| v2.0-r41 | 2026-08-08 | URDF placeholder 가 전부 실측으로 — IMU 는 9.3도 숙여 붙어 있었다 | S15P11A301-344. **URDF 오프셋 8개를 실측으로 교체**(원점 = 후륜 축 중앙의 바닥 투영, 교차 검증: 전륜 x=0.683=휠베이스 정확 일치·전륜 간격 0.533 vs 트랙폭 0.53). **IMU 장착 자세를 기능 시험으로 판정** — 로봇을 기울이고 돌리는 4기동을 `/imu/data_raw` 로 기록해 축 매핑이 REP-103 그대로임을 확인(펌웨어 항등 설정 유지 확정), 정지 가속도 (−1.65, −0.40, +10.04)가 자세와 무관하게 상시 존재 → **브레드보드 마운트가 pitch +9.3°·roll −2.3° 기울어 장착**(육안 확인). URDF rpy 에 반영 — 없으면 EKF 가 「항상 9° 내리막」으로 믿어 중력 x성분을 감속으로 오독한다. **`ultrasonic_rear_link` 신설** — 후방 초음파가 기계적으로 장착돼 있음이 확인됐다(배선·펌웨어 채널은 없음, S15P11A301-324 예정). 차체가 열려 있던 지금만 위치를 잴 수 있어 frame 을 선반영했다. 미실측 2건은 0 으로 두고 파일에 명시: 라이다 장착 yaw(정면 상자 /scan 판정 예정 — 틀리면 지도가 통째로 회전), 카메라 pitch(수평계 대기 — 틀리면 25.3 사람 좌표가 어긋남). TBD-HW-012 의 장착 항목 해소. 변경 파일: `README.md`, `TBD.md`, `sentinel.urdf` |
| v2.0-r42 | 2026-08-08 | 시리얼을 배타로 연다 — 재연결 한 번이 보드 리셋 한 번이었다 | S15P11A301-340. **06장 37-3-2 에 장치 단위 잠금 절 추가.** 브리지가 포트를 `exclusive=True`(TIOCEXCL)로 열어 두 프로세스가 같은 tty 를 여는 것을 커널이 막는다. 338(기동 지점 방어)과 **별개 층**이다 — 이쪽은 `ros2 run` 단독 기동·`picocom` 같은 디버깅 도구·다른 워크스페이스 사본까지 막는다. **2026-08-07 사고의 인과를 문서에 못박았다**: 두 브리지가 같은 tty → 바이트 분할 → 프레임 깨짐 → 재연결 → **포트를 여는 순간 DTR/RTS 가 auto-reset 회로를 때려 보드가 하드웨어 리셋** → 반복. 재연결 주기(1.0+1.5=2.5초)가 관측된 재부팅 주기와 일치한 것이 진단 근거였고, 73초에 29회 재부팅이 오도메트리 실측을 오염시켜 337·339 에서 잘못된 결론 둘을 만들었다. **실패 사유도 가른다** — 종전에는 「보드 부재」와 「포트 점유」가 둘 다 `not available` 로 나와 진단이 늦었다. 포트가 존재하는데 안 열리면 점유가 유일한 원인이므로 `demo_down.sh --dry-run` 을 안내한다. DTR 리셋 자체는 보드 기동이 의존하고 있어 건드리지 않았다. 시험 3건 추가(배타 인자 전달·점유 문구·부재 문구), pty 로 OS 수준 배타 동작 확인. 변경 파일: `README.md`, `06-테스트-보안-운영.md`, `serial_transport.py`, `motor_serial_transport.py`, `test_serial_transport_recovery.py` |
| v2.0-r43 | 2026-08-08 | 관제 지도가 안 뜬 이유 — 정렬 패딩 2바이트를 오류로 봤다 | S15P11A301-347. 「지도 대기 바이트가 남았습니다: 64274 소비 / 64276 전체」의 남은 2바이트는 오류가 아니라 **CDR 4바이트 정렬 패딩**이었다(64274 % 4 = 2). 격자 크기 검증은 이미 통과한 상태였으므로 **레이아웃 이해는 맞는데 멀쩡한 지도를 통째로 버리고 있었다** — Foxglove 에서는 같은 `/map` 이 정상으로 보였던 이유다. **검사를 없애지 않았다** — 필드가 추가돼 그 뒤가 밀려 읽히는 것을 잡아 주는 것이 이 검사이고, 그때는 틀린 값이 맞는 것처럼 보이므로 예외보다 나쁘다. 대신 판정을 `CdrReader.expectFullyConsumed()` 로 옮겨 **패딩만큼(4바이트 미만)만 허용**하고, 남은 바이트가 실제로 0 인지까지 확인한다(0 이 아니면 읽지 않은 필드일 수 있다). 정렬 지식을 리더 한 곳에 모으는 그 클래스의 설계 의도와도 맞다. 시험 3건(패딩 통과·4바이트 이상 거부·0 아닌 값 거부), 프론트 156건 전량 통과. 변경 파일: `README.md`, `cdr.ts`, `occupancyGrid.ts`, `occupancyGrid.test.ts` |
| v2.0-r53 | 2026-08-09 | 속도 3.4배 부풀림이 해소됐다 — 줄자 38cm 에 오도메트리 36.8cm | S15P11A301-339. **실주행 검증 완료.** 김민석의 펌웨어 수정(`vTaskDelayUntil` 절대 주기 + `micros()` 실측 dt)이 정확히 동작한다. `200 mm/s × 5초`에 줄자 **38cm**, 오도메트리 **36.8cm** — **오차 3%**. 수정 전 비율이었다면 같은 이동에 약 125cm 를 보고했을 것이다. 두 번 반복해 +0.367/+0.369m 로 재현됐고, 4초 명령 32cm 와도 초당 7.6/8.0cm 로 맞는다. **`meters_per_tick` 는 끝까지 건드리지 않았다** — 거리는 처음부터 맞았고 속도(나눗셈)만 틀렸다는 진단이 맞았다. 337 에서 상수를 2배 올렸다 되돌린 함정을 반복하지 않았다. 「2026-08-08 실측을 근거로 쓰지 않는다」 표기를 해제한다. **검증이 6번 무효였던 진짜 원인은 측정 도구였다**: `~/drive_command` 에 `vehicle_kinematics` 가 안전 게이트가 막은 **0 을 20Hz 로 함께 발행**하고 있었고, 보드는 마지막 값을 저장하므로 명령의 대부분이 0 으로 덮였다(실측 224회 0 / 56회 200). 게이트를 우회한다면서 게이트 뒤의 발행자를 확인하지 않은 것이다 — 이 오해가 「보드가 STOPPING 에 갇혔다」·「우측 모터 부호 반전」(352, 철회) 두 오진을 낳았다. 도구가 이제 경쟁 발행자를 **SIGSTOP 으로 멈추고 finally 에서 반드시 되살린다**(죽이지 않는 이유는 launch 가 관리하기 때문). 멈춘 뒤에도 남의 명령이 오면 **측정을 시작하지 않는다** — 오염된 숫자보다 아무것도 안 내는 편이 낫다. **남은 것은 342 몫이다**: 실속도가 명령의 약 38~40% 다. 주행 중 PWM 은 196‰ 로 **연속** 켜져 있었고(전환 3회 = 끊김 없음) `driver_enabled` 도 참이라, 명령 단절이 아니라 mmps→PWM 매핑이 어긋난 것이다. 변경 파일: `README.md`, `03-제어-캘리브레이션.md`, `drive_measure.py` |
| v2.0-r55 | 2026-08-09 | 초음파 보호정지 발동을 끈다 — 센서는 달아두되 정지 권한만 뺐다 | S15P11A301-353(재정의). 전방 HC-SR04 가 빈 공간에서 2.6~5.5cm 오측을 간헐적으로 내(15초 218표본 중 9회, **커넥터 분리 시 0회** — 센서·배선 원인 확정) 주행이 반복 중단됐고, 장애물 정지는 라이다 층(collision_monitor 전방 0.40m)으로 시연 요구를 충족한다는 판단으로 **발동 판정만 펌웨어에서 껐다**(`PROXIMITY_STOP_ENABLED = false`). **끄는 지점이 펌웨어여야 하는 이유**: 젯슨 중계(`relay_protective_stop`)만 끄면 `safety_gate` 가 같은 토픽을 독립적으로 보고 여전히 막고, 발행을 멈추면 `PROXIMITY_STALE` 로 막는다(침묵도 차단 사유). 측정·발행을 유지한 채 발동만 꺼야 어느 층도 안 막힌다 — 후방 초음파(TBD-HW-011)와 같은 지위다. **「없는 보호를 있다고 믿게」 하지 않도록** 03장 중계 절·CTRL-18, 04장 안전 층 표·22.2 행·24.5 판정 항목에 비활성을 명시했다. **받아들인 리스크도 적었다**: 라이다 평면(z=0.50) 아래 낮은 장애물은 이제 아무 층도 못 본다 — 사람 다리·의자는 라이다에 잡히므로 교실 시연 기준 수용. 되살리는 조건: 353 완료 기준(빈 공간 15초 오측 0회) 통과 후 플래그 복원. 변경 파일: `README.md`, `03-제어-캘리브레이션.md`, `04-자율주행.md`, `sensor_task.cpp` |
| v2.0-r56 | 2026-08-09 | 링키지 비 2.5 를 펌웨어 상수에 넣고 회전 반경 실측 도구를 만든다 | S15P11A301-341. r38 이 「펌웨어 두 상수는 담당 레인에 위임」으로 남긴 몫이 **반영되지 않은 채**였다 — develop 의 게인이 여전히 30/30 = 1:1 이라 바퀴가 지령의 40%만 꺾이고 R_min 4.41m. 실측 상수로 교체: `STEERING_MAX_MDEG` 30000→**22000**(실측 δ_max), `SERVO_MAX_OFFSET_DEG`·`servoMaxOffsetDeg` 30→**55**(중립 145° 기준 ±55° 실측) → 게인 55/22 = **2.5**. 하드 리밋 확인: `STEERING_OFFSET_HARD_MAX_DEG` 60 ≥ 55, 헤드룸 min(145, 270−145)=125 ≥ 55 — 클램프에 안 걸린다. 폰 슬라이더 매핑도 같은 상수를 쓰므로 슬라이더 끝 = 실제 δ_max 로 함께 맞는다. **검증 도구 `steering_measure.py` 신설**: 고정 조향으로 호를 그리게 하고 R = 경로길이(틱 오도메트리) / yaw변화(IMU 적분) 를 자동 산출 — 두 값이 같은 구간 누적이라 가감속에 흔들리지 않는다. δ=22° 기대 R=1.69m, 미반영이면 4.41m 로 갈려 플래시 여부가 한 번에 판정된다. 본 측정 전 1초 워밍(기는 속도로 조향 안착 — §34-2 정지 중 조향 금지 때문에 정지 상태로는 못 세운다). `drive_measure.py` 의 함정 가드(경쟁 발행자·데드밴드·데드타임) 승계. 변경 파일: `README.md`, `03-제어-캘리브레이션.md`, `steering_limits.h`, `steering.cpp`, `board_state.h`, `steering_measure.py`(신규) |
| v2.0-r57 | 2026-08-09 | 조향 방향이 거울상이었다 — 반경은 1% 오차로 정확 | S15P11A301-341. `steering_measure.py` 호 주행 실측: δ=+22° 에 **실측 R 1.71m / 기대 1.69m (비 1.01)** — 링키지 비 2.5(r56)가 정확히 반영됐다. 그러나 **yaw 가 −37.1°(우회전)** — 좌회전 지령에 로봇이 우로 돌았다(육안 확인 일치, IMU 축은 344 기능 시험으로 검증된 상태). 서보를 올리면 바퀴가 우로 꺾이는 실물 링키지라 `SERVO_DIRECTION_SIGN` +1→**−1**. 코드 주석이 「스윕 시험에서 가장 먼저 확인할 항목」으로 예고해 둔 그 값이다. **+1 이던 동안 Nav2 의 모든 조향 명령이 거울상이었다** — 좌로 피하라는 명령에 우로 꺾었다. 링키지 비(40% 조향)와 함께 자율주행이 경로를 못 따라가던 원인 사슬의 마지막 조각으로 보인다. 폰 수동 채널도 같은 매핑을 지나므로 함께 바로잡힌다. 변경 파일: `README.md`, `03-제어-캘리브레이션.md`, `steering.cpp` |
| v2.0-r58 | 2026-08-09 | 조향 좌·우 호 주행 검증 통과 — 341 완결 | S15P11A301-341. `SERVO_DIRECTION_SIGN = −1`(r57) 플래시 후 좌·우 호 주행 최종 실측: **좌(+22°) yaw +43.6°·R 1.37m, 우(−22°) yaw −36.6°·R 1.76m** — 방향 부호 양쪽 일치, 반경은 모델(1.69m) 대비 우 +4%/좌 −19%. **좌회전이 ~20% 급하게 도는 기하 비대칭**이 재현 확인됐다(부호 반전 전 같은 물리 방향 1.71m 와 일관). 둘 다 「계획보다 더 돌 수 있는」 안전한 방향이라 시연 기준 수용 — 폐루프가 흡수하며, 못 돌던 쪽(4.4m)이 문제였다. 대칭 정밀화는 TBD-CAL-001 기존 항목. 운영 지식 추가: **모터 보드는 플래시 직후 전원 재인가가 필요할 수 있다** — TX 만 살고 RX 죽는 상태(HELLO 무응답·DRIVE_STATE 침묵)를 두 번 겪었고 두 번 다 전원 재인가로 해소. 이로써 341 의 원인 사슬이 완결됐다: 링키지 비 1:1(바퀴 40%만 꺾임, r56) + 방향 거울상(r57) — 자율주행이 경로를 못 따라가던 조향측 원인 전부. 변경 파일: `README.md`, `03-제어-캘리브레이션.md` |
| v2.0-r59 | 2026-08-09 | 정지 구역이 차체 안에 있었다 — 발동 불가능한 보호를 실측 차체로 다시 그린다 | S15P11A301-356. `safety.yaml` collision_monitor 다각형이 낡은 원형 가정(반경 0.20) 위에 있었다 — footprint 가 실측 직사각형(x −0.11~+0.80)으로 바뀐 뒤 재계산되지 않아 **정지 구역(x 0~0.40)이 전부 차체 안**, 감속 구역(0~0.75)도 범퍼에 못 미쳤고 측면 폭(±0.28)은 차체(±0.31)보다 좁았다. **라이다 점이 정지 구역에 들어오려면 장애물이 이미 차체를 관통해 있어야 하는, 발동 불가능한 보호였다.** 조향 결함(341)으로 장애물 앞까지 가 본 적이 없어 드러나지 않았고, 341 해결 후 첫 정상 주행 사전 점검에서 발견됐다 — 초음파도 비활성(353)이라 이 구역이 유일한 근접 방어가 된 시점이었다. 재계산: **정지 x −0.15~+1.05(범퍼 앞 0.25m)·y ±0.33, 감속 x −0.15~+1.30(범퍼 앞 0.50m)·y ±0.40.** 좁은 시연 환경에 맞춰 의도적으로 조인 값이다(라이다 신뢰 전제) — 0.30m/s 최악 정지거리 18cm(감속 9 + 체인 지연 6 + 스캔 주기 3)에 7cm 여유. 감속 반폭 0.40 은 교실 문(≈0.9m)을 감속 없이 통과하는 값. 후방 −0.15 는 자율이 전진 전용(RPP)이라 최소. 속도 상한을 올리면 재계산 필수. 변경 파일: `README.md`, `safety.yaml` |
| v2.0-r60 | 2026-08-09 | 첫 자율탐사 실기동: 바퀴만 꺾고 전진 0 — 최저속도·전방 편향·접근 거리 수정 | S15P11A301-357. 42초 임무(375d604f)에서 조향은 상한에 붙고(steering_clamp 192) 구동은 0 — 원인은 **「0.15 아래 명령은 실속도 0」(342 실측)이 하위 층에 미반영**된 것. `nav2.yaml`: `regulated_linear_scaling_min_speed` 0.1→**0.25**(곡률 감속 하한이 데드밴드 150mm/s 아래로 내려가 펌웨어가 0 으로 만들었다), `min_approach_linear_velocity` 0.05→**0.25**(도착 직전 기어가다 정지), `regulated_linear_scaling_min_radius` 0.4→**1.8**(341 완료로 실측 R_min 좌 1.37/우 1.76 확정 — 주석이 예고했던 갱신). `approach.launch.py`: `max_speed_mps` 0.10→**0.25** — 342 가 모듈 상수만 고치고 launch 기본값을 놓쳐 launch 가 덮고 있었다(APPROACH_FAILED 의 원인). `stop_distance_m` 0.60→**1.20** — 356 이 정지 구역을 전방 1.05m 로 조이면서 0.60 도착 선언이 불가능해졌다(**구역보다 커야 한다는 결합** — 구역을 바꾸면 이 값을 같이 본다). `selector.py`: **전방 편향** — 후보 방위각을 회전 호 비용 R×Δθ절댓값(R=1.8)으로 환산해 경로 길이에 가산. NavFn 이 회전반경을 모르고 후방 목표를 내는 문제의 완화이며, 정석(Smac Hybrid-A* 후진 계획)은 S15P11A301-358. 변경 파일: `README.md`, `nav2.yaml`, `approach.launch.py`, `approach.py`, `selector.py`, `exploration_node.py`, `test_selector.py` |
| v2.0-r61 | 2026-08-09 | 두 번째 실기동: 좌우 진동 — 전방 편향 강화·약속 소멸 나이 가드·controller 인내 상향 | S15P11A301-360. 357 적용 후 전진은 살았으나 좌우로 헤맴. 로그로 확정한 세 원인: (1) **방위 페널티가 이득에 파묻힘** — 정후방 페널티 3점 vs 카메라 이득 42점, 목표 6개 전부 후방(방위 ±90~178°). `selector.py` 에 이득 감쇠 계수(전방 1.0, 측면 0.65, 정후방 0.3) 추가 — 곱셈이라 이득 크기와 무관하게 비율 유지. (2) **군집 소멸 판정이 약속 나이를 우회** — 지도 2초 갱신마다 일시 소멸 판정으로 목표가 2~4초마다 갈림(min_age 5초 무력화). 소멸도 약속 3초 뒤에만 인정 — 진짜 소멸이면 3초 뒤에도 소멸이다. (3) **controller 즉시 포기** — collision-ahead 예측에 `failure_tolerance` 0.5초로 7/7 목표 중단. 2.0 으로 — 일시 예측(지도 갱신·스캔 노이즈)은 몇 사이클이면 걷힌다. 변경 파일: `README.md`, `selector.py`, `exploration_node.py`, `nav2.yaml`, `test_selector.py` |
| v2.0-r62 | 2026-08-09 | Smac Hybrid-A* 전환 — 후진이 계획에 들어온다 (TBD-NAV-001 확정) | S15P11A301-358. planner 를 NavFn → `SmacPlannerHybrid` 로 바꾼다. NavFn 은 경로에 방향 개념이 없고 회전반경도 몰라, 두 실기동에서 후방·측면 목표로 못 따라갈 경로를 냈다(조향 상한 고착 — r60·r61). Hybrid-A* 는 R_min 을 알고 전진 호·후진 호를 섞어 실차가 따라갈 수 있는 경로만 낸다. 핵심 값: `minimum_turning_radius` **1.8**(실측 R_min 좌 1.37/우 1.76 의 안전측, RPP 감속 임계와 같은 근거·같은 값), `motion_model_for_search` **REEDS_SHEPP**(후진 확장), `reverse_penalty` **2.0**(짧은 빠져나오기 후진은 허용, 긴 후진 주행은 억제 — 후방 카메라 없음), `allow_unknown` **false 유지**(23.3 도달성 결합 — planner 를 바꿔도 유지). RPP `allow_reversing: true`(후진 구간 추종, `use_rotate_to_heading` 과 상호배타). **후진 도입으로 collision_monitor 구역을 후방 확장**(`safety.yaml`): 정지 뒤 범퍼 뒤 0.24m(x −0.35), 감속 0.44m(x −0.55) — 전방과 같은 정지거리 근거. 종전 「자율 전진 전용이라 후방 최소」 전제가 이 MR 로 무효. **계획 실측(주행 없이 ComputePathToPose)**: costmap 비용 0 회랑에서 정후방 1.1m → **포즈 16개 전원 후진의 일직선 경로 — Humble 1.1.20 에서 후진 계획이 된다.** 같은 날 「후진 실질 불가」로 한 차례 오판했다가 정정 — 시험 목표가 /map 상 자유였지만 **global costmap 의 벽 팽창 안**이었다(계획 실패의 첫 용의자는 목표 주변 costmap 비용; /map 이 아니라 /global_costmap/costmap 이 planner 의 세계다). allow_reverse_expansion 은 Lattice 전용 파라미터라 Hybrid 에 없는 것이 정상이며, REEDS_SHEPP 모델이 후진을 담당한다(검토 지적: 김민석 쪽 백포트 조사). 백포트 불필요 판정. 남은 검증은 실주행 — 전·후진 전환점(cusp)에서 펌웨어 방향전환 데드타임(500ms)과 RPP allow_reversing 의 상호작용. **덤 결함 수정: 복구 BackUp 의 backup_speed 0.05→0.25** — 데드밴드 아래라 「후진 복구가 도는데 안 움직이는」 죽은 기능이었다(양쪽 BT XML). 후방 주행(계획 후진 + 복구 후진)은 새 후방 정지 구역이 지킨다. 변경 파일: `README.md`, `TBD.md`, `nav2.yaml`, `safety.yaml` |
| v2.0-r63 | 2026-08-09 | 임무마다 새 지도 — MISSION_START 에서 slam 재시작 | S15P11A301-362. 지도가 임무를 넘어 살아남아 **두 번째 탐사가 frontier 즉시 소진으로 2초 만에 완료**되는 사고(임무 47bac6ed)가 실재했다. 지도 수명 = 임무 수명이 설계 의도이고 백엔드는 이미 임무마다 mapId 를 발급한다. Humble slam_toolbox 엔 리셋 서비스가 없어(서비스 목록 실측) **프로세스 재시작**으로 구현: `slam.launch.py` 에 respawn(1초) + mission_manager 가 MISSION_START 새 임무 전이에서 SIGTERM(`slam_reset.py`, `reset_map_on_start` 파라미터로 차단 가능). 재시작 공백 3~4초(respawn 1 + 첫 스캔 즉시(minimum_travel 0, odom TF 생존) + map_update_interval 2)는 탐사의 pose 대기가 흡수 — 별도 대기 코드 없음. **재개(RESUME)에는 안 걸린다**(37-3 지도 유지). 결합: map frame 원점이 시작 시점 로봇 위치로 리셋 — 관제 지도가 시작 순간 새로 그려지는 것은 의도된 UX. E2E(연속 시작 2회)는 자율주행 시험 항목. 변경 파일: `README.md`, `slam.launch.py`, `mission_manager_node.py`, `slam_reset.py`(신규), `test_slam_reset.py`(신규) |
| v2.0-r64 | 2026-08-09 | 지도 초기화가 호출자까지 죽였다 — pkill 을 PID 단위 탐색으로 바꾼다 | S15P11A301-362. r63 의 `reset_slam_process` 는 `pkill -f async_slam_toolbox_node` 였는데, **실기동 검증에서 호출한 셸이 함께 죽었다**(exit 144 = SIGTERM). `pkill -f` 는 전체 cmdline 을 훑으므로 **그 문자열을 인자로 들고 있는 프로세스 — 즉 호출자 — 도 일치한다.** mission_manager 가 이걸 부르면 임무 시작이 자기 자신(과 스택 일부)을 내리는 사고가 된다. `/proc` 을 직접 훑어 PID 를 고르고 **자기 자신과 조상 계보를 제외**하도록 바꿨다(표준 라이브러리만 사용). 시험 7건으로 「자기 cmdline 에 패턴이 있어도 안 고른다」를 못박았다 — 이 사고의 재발 방지선이다. 실기동 검증 완료: SIGTERM → respawn(pid 122637→132299) → 새 slam 기동 → map TF 복귀. 변경 파일: `README.md`, `slam_reset.py`, `test_slam_reset.py` |
| v2.0-r66 | 2026-08-09 | 관제 지도가 「뒤집혀」 보인 진짜 이유 — 화살표만 상하 반전을 안 따랐다 | S15P11A301-364. 현장에서 「로봇이 빈 공간으로 가는 것처럼 보이는데 실제로는 코너로 간다」는 보고. **원인은 SLAM 이 아니라 프론트 렌더링이다.** 실측: `/map` 격자에서 로봇(0.22,−0.02·방위 11.6°) 정면 3m = 자유, 후방 3m = 점유(100) — **데이터는 정상**이고 로봇은 열린 쪽으로 가고 있었다(지도 origin 자세도 z=0·w=1 표준). 프론트 세 곳 중 두 곳만 규약이 맞았다: `LiveMap.renderGrid` 가 `height-1-row` 로 지도를 상하 반전하고(캔버스 y 가 아래로 증가하므로 정상) `worldToPixel` 도 로봇 **위치**를 같은 규칙으로 뒤집는데(그래서 위치는 맞았다), `arrowRotationFromMapYaw` 만 yaw 를 **그대로** 반환했다. 상하 반전 캔버스에서 map 정면 (cos y, sin y) 는 화면 (cos y, **−**sin y) 이므로 화면각 = **−yaw** 다. 위치는 맞고 방향만 상하 대칭으로 틀리니 보는 사람에게는 「지도가 뒤집혔다」로 읽힌다. **시험 방식도 바꿨다** — 종전 시험은 `rotation === yaw` 로 부호만 비교해 규칙이 한 번 왕복한 뒤에도 통과했다. 이제 **화면 벡터**(x 오른쪽·y 아래)로 「+90°면 화면 위쪽」을 못박는다. 함수 주석에는 되돌림을 유발했던 과거 관찰을 지우지 않고 조건과 함께 남겼다. 변경 파일: `README.md`, `mapHeading.ts`, `mapHeading.test.ts`, `LiveMap.tsx` |
| v2.0-r68 | 2026-08-09 | 탐사가 도는데 로봇이 한 발짝도 안 움직였다 — 목표가 전부 계획 불가였다 | S15P11A301-366. 라이다 거울상(365) 수정 후 첫 주행에서 로봇이 정지. 로그는 `목표 거부: allow_unknown=false 이므로 미지 공간 목표는 계획되지 않는다`. **원인 규명**: frontier 대표점은 SLAM 지도상 전부 자유 셀인데(23개 검증) `ComputePathToPose` 는 전부 ABORTED. 같은 좌표의 global costmap 값이 −1(미지)·66·66 이었다. 더 파보니 **`/map` 자유 셀의 31%가 costmap 에서 치명**이고 그 **97%가 실제 벽에서 0.5m 이내** — 팽창 버그가 아니라 `inflation_radius: 0.50` 이 이 좁은 방에 과했던 것이다(설정 주석이 「좁은 실내에서 이보다 키우면 통로가 막힌다」고 경고했는데, 0.50 이 이미 그 상태였다). **두 축 수정**: (1) `inflation_radius` 0.50 → **0.35**(global·local 동일, 반폭 0.31 + 4cm) — 충돌 방어는 collision_monitor 정지 구역이 최후선으로 유지. (2) frontier 대표점을 자유 공간 안쪽으로 **0.6m 후퇴**(`_retreat_into_free`) — frontier 는 정의상 미지 경계라 그 자리가 늘 고비용이다. **실측 효과**: costmap 치명 셀 25%→**10%**, 계획 가능 목표 **3/101(3%) → 12/34(35%)**. 후퇴 단독으로는 0.6m·1.0m·2.0m 어느 값도 3→4개에 그쳐 무효였다 — 팽창을 줄인 뒤에야 후퇴가 효과를 냈다(9→12). 두 수정이 곱해서 작용한다. 변경 파일: `README.md`, `nav2.yaml`, `frontier.py`, `test_frontier.py` |
| v2.0-r69 | 2026-08-10 | 관제 지도가 「차는 멈춰 있고 지도가 움직이는」 것으로 보였다 — 세계 좌표에 고정한다 | S15P11A301-367. 렌더링이 「지금 받은 격자를 화면에 꽉 채우기」(`scale = min(box/grid.width, box/grid.height)`)였다. SLAM 이 지도를 넓히면 **격자 크기와 origin 이 함께 바뀌므로 배율·위치가 통째로 달라진다** — 이미 그려 둔 벽이 화면에서 미끄러지고, 로봇은 지도 중앙 부근에 머무니 차가 정지한 것처럼 보였다. **세계 좌표 창**(`ViewWindow`)을 도입해 단조 증가로만 넓히고, 격자 이미지와 로봇을 **같은 세계→화면 변환**(`worldToScreen`)으로 배치한다. 지나간 영역은 축척이 줄 때 말고는 제자리에 남는다. 격자 이미지의 좌상단이 세계 좌표 `(originX, originY + 높이)` 인 것은 `renderGrid` 가 행을 뒤집기 때문이며(첫 행 = y 최대), 화살표 회전이 `−yaw`(r66/364)인 것과 같은 이유다. 시험 5건 신규: 창 단조 증가, **지도가 넓어져도 같은 세계 좌표가 같은 화면 좌표에 남는다**, y 뒤집기, 종횡비 유지. 변경 파일: `README.md`, `gridGeometry.ts`, `LiveMap.tsx`, `mapViewWindow.test.ts`(신규) |
| v2.0-r70 | 2026-08-10 | 사람을 발견해도 조향만 까딱였다 — 접근 속도 상한이 데드밴드 아래였다 | S15P11A301-368. 탐지·음성을 켜고 시험하던 중 사람이 프레임에 들어왔는데 로봇이 조향만 조금 움직이고 40초 뒤 `APPROACH_FAILED`. 원인은 `mission_state.MOVEMENT[PERSON_APPROACHING]` 의 속도 상한 **0.10m/s** 다 — 펌웨어 데드밴드(150mm/s) 아래라 보드가 0 으로 만든다. **357 에서 approach 노드 기본값을 0.25 로 올렸지만 이 상한이 다시 0.10 으로 깎고 있었다**(`approach.py` 의 `min(max_speed, speed_limit)`). 같은 결함이 층을 옮겨 살아남은 사례다. 0.10 → **0.25**. 명세 30.3 의 「사람 앞에서 천천히」 의도는 순항 0.30 보다 낮은 0.25 로 지켜지고, 실제 정지는 `stop_distance` 1.20m 와 collision_monitor 정지 구역이 담보한다. **시험도 규칙을 바꿨다** — 종전 `speed_limit <= 0.10` 은 물리적으로 불가능한 값을 통과시켰다. 이제 `>= 0.15`(데드밴드 위)와 `< 0.30`(순항 아래) 양쪽을 못박는다. 03장 속도표와 각속도 논지도 갱신. 변경 파일: `README.md`, `03-제어-캘리브레이션.md`, `mission_state.py`, `test_mission_state.py` |
| v2.0-r71 | 2026-08-10 | 탐사가 0.36m 앞 목표를 95초 붙들고 서 있었다 — 최소 목표 거리를 둔다 | S15P11A301-369. 「탐사시작을 눌러도 안 움직인다」의 원인. 실기동 타임라인: 목표 **(0.26, 0.25)** — 로봇에서 **0.36m** — 을 잡고 **95초** 동안 그대로 있었다. **전륜 조향 차량은 가까운 목표에 닿지 못한다** — R_min 1.69m 라 옆이나 비스듬한 0.3~1m 목표는 어떤 호로도 도달 불가다. 그런데 Nav2 는 그 목표를 거부하지도 실패로 끝내지도 않아(실패 0건) 로봇은 그냥 서 있었고, 겉보기 증상은 「안 움직인다」 하나였다. `min_goal_distance_m` **1.5m** 신설 — frontier·관측 후보 양쪽에 적용. 버려도 손해가 없다(그 자리는 라이다 반경 안이라 지나가며 관측되고 frontier 는 로봇이 움직이면 갱신된다). 전부 걸러지면 그 사실을 로그로 남긴다 — 「후보 없음(DONE)」과 구별하기 위해서다. 선택기의 거리 감점(`w_dist`)이 가까운 후보를 선호하므로 이 하한이 없으면 도달 불가 목표가 계속 1위가 된다 — r61 의 전방 편향과 짝이다. 변경 파일: `README.md`, `exploration_node.py` |
| **v2.1** | 2026-08-11 | **시연 종료 — 코드·실측 전면 정합화** | 프로젝트 종료(시연 완료)에 맞춰 문서 전체를 코드와 대조해 정합화했다. 두 차례로 나눠 진행했다. **1차(표적)**: 마지막 스프린트에서 바뀐 값이 각 장에 옛 값으로 남았는지 훑었다 — collision_monitor 구역(전방 0.40→실측 차체 기준 정지 −0.35~+1.05·감속 −0.55~+1.30), 접근 속도(0.10/0.15→**0.25**), `stop_distance_m`(0.60→**1.20**), `inflation_radius`(0.50→**0.35**), planner 서술(NavFn→**Smac Hybrid-A\***, S15P11A301-358), 지도 수명=임무 수명(362), 탐사 실기동 보정 4종(23.3), 라이다 `inverted: true`(365). **2차(전수)**: 01~08장·TBD를 장별로 코드(backend·frontend·`hardware/esp32` 펌웨어·`jetson/ros2_ws` 패키지·`ai/`·`scripts`·CI)와 대조했다. **없는 것을 있다고 적은 서술을 걷어낸 것이 핵심이다** — 운영자 로그인·접근 토큰·rate limit·Nginx 443 단독 공개·MediaMTX path 인증·CI secret scan·TimescaleDB retention·엔코더 속도 PID·폐루프 속도 제어·사람 map 위치(human_localizer)·위치 품질 3값·중복 제거 1m 기준·자동 스트림 전환·박스 합성 영상·자동 preflight gate·ESTOP 해제 전이·checkpoint 복구·스텝-드웰 스윕 실행부는 **모두 미구현이며 그렇게 적었다**(v2.0 의 36-4 유형 재발 방지). 실제 구현으로 고친 것 — 트래커 ByteTrack→**BoT-SORT**(GMC 필요), 펌웨어 프레임워크 ESP-IDF→**Arduino-ESP32**, MQTT 8883 TLS→**WSS 443**, Control Session 15분→**10분 고정 TTL**, `chrony`→**systemd-timesyncd**, Outbox 상태머신·지수 백오프→**message_id 멱등·5초 배치 flush·성공 시 삭제**, systemd 9유닛 journalctl→**`sentinel-demo` 단일**, 부록 C ROS 토픽표·부록 J 핀맵(BTS7960 25/26·32/33·EN 23, 서보 GPIO18, DHT4)·모노레포 트리(`hardware/esp32`·`ai/`·13개 ROS 패키지)·Jetson Linux **36.4.7**·영상 15FPS·1500kbps·링 버퍼 1.6MB·음성 상태명(`NO_VOICE_DETECTED` 등)·Jira 키 3곳(366·368). **확정으로 옮긴 것**: R_min 좌 1.37m·우 1.76m 원주행, 속도 0.30m/s(실속도 99%), TensorRT 엔진·FPS, BRIO+LiDAR 동시 구동, 음성 ROS 연동 계약, 서보 신호 규격·엔드포인트, 휠베이스 `L`·`δ_max`. **05장(통신·서버·영상)은 별도로 전수 대조했다** — REST 표 19행은 컨트롤러와 셀 단위로 일치했고 폐기 표기 3건도 정확했으나, **AI bbox 오버레이 전체**(투명 Canvas·`frameId` 동기화·젯슨 합성 fallback)·`detections` 적재 경로(테이블은 있고 항상 0행)·Nginx 컨테이너·`security/` 패키지·Continuous Aggregate·retention 정책·home·Frontier 지도 표시는 **모두 미구현이었다.** `compose.prod.yaml` 이 **8080 을 평문으로 전 인터페이스에 공개**하는 사실과 MediaMTX 인증 부재·WHEP 기본 평문을 31-11·36-6 에 명시했다. 정정: 오류 봉투(`status`/`message`/`data`, `CONTROL-001` 형식 — `traceId`·`occurredAt` 없음), 업로드 상태 3개(`UPLOADING`·`LOCAL_ONLY` 는 서버가 쓰지 않는다), Outbox(SENT 없음·행 삭제·5초 배치, 지수 백오프는 MQTT 재접속 전용, 미디어는 Outbox 를 타지 않음), telemetry 상시 2Hz·`battery` 항상 null, `/topic/.../events` 는 `MISSION_STATUS` 만, 구독 prefix `/queue` 추가, DB 컬럼명·V3~V10 추가 컬럼, S3 key 에 `{mapId}`, `no_response_timeout` 300초(30초는 오발화 — 142), `pending` 상한 580MB(녹화 2580kbps 는 스트리밍 1564kbps 와 별개), 31-12·32-7 모듈 트리와 스키마 13개. **신설**: [TROUBLESHOOTING.md](TROUBLESHOOTING.md) — 증상에서 각 장 규범으로 가는 현장 진단 인덱스(값을 정의하지 않고 링크만 한다). 미구현 서술은 사실이므로 남겼다(RETURNING·7분 종료·human_localizer·초음파 보호 정지). 변경 파일: `README.md`, `01`~`08`, `TBD.md`, `TROUBLESHOOTING.md`(신설), 저장소 README 4개(`/README.md`, `ai/detection`, `ai/voice/asr_server`, `scripts`) |
| v2.0-r50 | 2026-08-09 | 측정 도구를 게이트 아래로 옮긴다 — 상위 층이 명령을 0 으로 덮었다 | S15P11A301-339. **`drive_burst.py` 를 `drive_measure.py` 로 대체.** 그쪽은 `/cmd_vel` 에 쏘는 방식이라 상위 층이 언제든 0 으로 덮었다 — 2026-08-09 시험에서 6.7초 발행 중 **비영 구간이 0.60초**뿐인 일이 실제로 벌어졌고 그 측정은 무효였다. 막은 층이 셋이고 끄는 순서가 겹겹이었다: ① `esp32_motor_bridge` 의 `STOP_COMMAND` 중계 — `relay_protective_stop` 이 있으나 **기동 시에만 읽어** 런타임 변경이 안 먹는다, ② `safety_gate` 의 `PROTECTIVE_STOP` — **끄는 파라미터가 없고** 토픽을 끊으면 `PROXIMITY_STALE` 로 막는다(침묵도 차단 사유), ③ Nav2·탐사가 같은 토픽에 명령을 실어 섞이는데 멈추면 `MOVEMENT_NOT_ALLOWED` 가 껴든다. 새 도구는 **`~/drive_command` 로 직접 쏜다** — 캘리브레이션은 안전 체인의 판단이 아니라 「명령한 만큼 갔는가」를 보는 작업이라 중간 층이 값을 바꾸면 측정이 성립하지 않는다. 오도메트리 시작·끝을 스스로 찍어 **보고 거리**를 함께 내므로, 줄자 실측과 나란히 놓으면 「엔코더가 맞나」와 「로봇이 갔나」가 갈린다. **안전 체인을 우회하므로 시험 전용**이며 상한(속도 0.5 m/s, 지속 10s)·종료 시 정지 5회 재발행을 남겼다. 겸사겸사 확정된 것: **앞 초음파가 고장이다** — 커넥터를 뽑으니 15초 218표본 오측 9회가 **0회**가 됐다(2026-08-08 채터링 70회의 정체도 이것이다). 변경 파일: `README.md`, `03-제어-캘리브레이션.md`, `drive_measure.py`(신규), `drive_burst.py`(제거) |
| v2.0-r49 | 2026-08-09 | 엔코더 샘플 주기를 절대 시각으로 고정하고 dt 를 실측한다 | S15P11A301-339. **펌웨어 반영**(김민석 수정, 젯슨 담당이 대신 커밋). v2.0-r47 이 기록한 두 결함을 `sensor_task.cpp` 에서 함께 고쳤다. ① `vTaskDelay` → **`vTaskDelayUntil`** 로 절대 주기 고정 — 상대 지연이라 실제 주기가 10ms + I2C 작업시간 = 약 34ms 였고, 0.15 m/s 에서 샘플당 모터 0.53 회전이라 MT6701 반회전 모호성을 넘겨 부호가 반전됐다. ② `SENSOR_TASK_INTERVAL_S`(명목 0.010s) 제거하고 **`micros()` 실측 `dt`** 로 교체 — 34ms 이동거리를 10ms 로 나눠 속도가 약 3.4배 부풀려지던 것. **둘은 다른 결함이다**(감김은 `countDelta`, 3.4배는 나눗셈) — 하나만 고치면 다른 하나가 남으므로 함께 반영했다. `micros()` 32비트 감김은 부호 없는 뺄셈이라 안전하며, **어느 한쪽을 signed 로 바꾸면 깨진다**고 주석에 남겼다. 플래시 후 스택 기동은 확인됐다. **재측정은 아직이다** — 실제 루프 주기 10ms 근처인지, `drive_burst.py 0.15 6.7` 이 100cm 근처로 오는지(수정 전 183cm), 전진·후진 부호가 정상인지 셋을 확인하기 전까지 「2026-08-08 실측은 근거로 쓰지 않는다」가 유효하다. 변경 파일: `README.md`, `03-제어-캘리브레이션.md`, `sensor_task.cpp` |
| v2.0-r48 | 2026-08-09 | demo_down.sh 가 「모두 내려갔습니다」라고 하고 10개를 남겼다 | S15P11A301-351. `demo_down.sh` 직후 `demo_up.sh` 가 「이미 돌고 있습니다」로 거부했다 — 두 스크립트의 기준이 어긋나 있었다. 살아남은 10개(sentinel 5 + nav2 5)는 **전부 `ppid=1` 고아**였다. `demo_down.sh` 는 ① launch 부모에 SIGINT ② 남은 것을 `node_patterns` 로 정리 인데, **부모가 이미 죽어 있으면 ①이 보낼 대상이 없고**(그래서 「정상 종료로 모두 내려갔습니다」가 나온다) ②의 열거 목록에 그 10개가 하나도 없어 그냥 지나갔다. **목록으로 관리하면 패키지가 늘 때마다 고쳐야 하고, 안 고치면 조용히 남는다** — 338 이 「두 벌 이상이어도 전부 내린다」고 안내해 놓고 실제로는 적힌 것만 내리던, 없는 보호를 있다고 믿게 하는 형태였다. 열거를 걷고 설치 경로 접두사로 덮는다. **검증 중 세 번째 결함이 나왔다**: `esp32_bridge` 는 `sentinel_` 접두사를 안 따른다. 그래서 `install/sentinel_*` 로는 esp32_motor/sensor_bridge 를 못 잡고, 둘이 살아남아 `demo_up.sh` 의 **flock 을 쥔 채**로 남아 다음 기동이 「다른 demo_up.sh 가 이미 기동 중」으로 거부됐다 — 원인이 시리얼도 락 파일도 아니라 정리 목록의 접두사였다. 양쪽 다 `ros2_ws/install/` 로 넓혔다(`demo_up.sh` 의 중복 검사도 같은 구멍이라 함께 고쳤다). 검증: 스택 기동(워크스페이스 25 + nav2 10) → launch 부모를 SIGKILL 로 고아 생성 → `demo_down.sh` 가 **35개 전부 정리**(1629MB 회수), 락 해제 확인. 이것이 2026-08-09 아침에 실제로 발생한 조건이다. 변경 파일: `README.md`, `demo_down.sh`, `demo_up.sh` |
| v2.0-r44 | 2026-08-08 | 곡률 상한을 지키는 층이 Nav2 에 없다 — 무시되던 설정을 치웠다 | S15P11A301-348. **04장 24.1 에 층 구분 절 신설.** `nav2.yaml` 의 `FollowPath.minimum_turning_radius: 1.69` 는 **RPP 에 그 이름의 파라미터가 없어 조용히 무시된다**(`.so` 문자열 확인). 172 가 근거를 남길 의도로 넣었는데 설정 자리에 있으면 「곡률 상한이 걸려 있다」로 읽혀서 2026-08-08 에 실제로 그렇게 오독했다 — **제거하고 근거는 주석·문서로 옮겼다.** 옮길 자리를 찾다가 더 큰 것을 확인했다: **RPP 에는 곡률 상한 기능 자체가 없다**(헤더 `applyConstraints`·멤버 확인). `regulated_linear_scaling_min_radius` 는 「급하면 감속」이지 「급한 것을 금지」가 아니다. 따라서 층이 이렇게 갈린다 — NavFn 은 회전반경을 모르고, RPP 는 상한 없이 곡률을 명령하고, **`vehicle_kinematics` 만이 δ 를 클램프한다.** 그것이 실기동의 `steering_clamp_count 7224`·`spin_in_place_reject_count 43` 의 정체다. `regulated_linear_scaling_min_radius: 0.4` 는 차동 시절 값이라 R_min 1.69m 와 맞지 않으나, **341(링키지) 반영 시 실제 R_min 이 4.4m→1.69m 로 바뀌므로** 그 뒤에 실주행으로 확정하기로 하고 근거만 주석에 남겼다. 변경 파일: `README.md`, `04-자율주행.md`, `nav2.yaml` |
| v2.0-r45 | 2026-08-08 | 지워진 URDF 조인트를 되살리고, 같은 사고를 CI 로 막는다 | S15P11A301-349. **`base_link_to_camera_link` 조인트가 develop 에서 사라져 있었다** — S15P11A301-344 의 마지막 커밋이 주석 블록을 다시 쓰면서 닫는 `-->` 로 그 아래 조인트 4줄을 삼켰다. **아무 신호가 없었다**: XML 은 유효하고 `camera_link` 링크 선언도 남아 파일이 정상으로 보이며, `robot_state_publisher` 는 끊어진 트리를 그대로 받아 기동한다. 파서로 확인하니 **루트가 둘**이었다(`base_footprint`, `camera_link`). 결과는 `base_link → camera_optical_frame` 조회 실패이고, 그러면 **사람 방위각→지도 좌표 변환(25.3)이 성립하지 않는데 카메라 화면도 지도도 멀쩡해 보인다** — 279 에서 짐벌 링크를 걷어낼 때 경계한 「조용히 틀어진다」와 같은 부류다. `install/.../sentinel.urdf` 가 **소스로의 심링크**라 빌드 없이 다음 기동부터 적용된다. 조인트를 344 실측값(`0.770 0.010 0.428`, pitch −0.215 rad)으로 복구했다. **회귀 방지**: `validate:urdf-tree` CI 잡 신설(`scripts/ci/validate_urdf_tree.py`) — 루트 개수·미선언 링크·부모 중복·순환을 검사한다. `check_urdf` 는 `liburdfdom-tools` 가 필요해 lint 컨테이너에서 못 돌아 표준 XML 파서로 짰다. 끊어진 판본으로 되돌려 실제로 잡히는 것을 확인했고, 합성 사례 4건(부모 둘·순환·미선언·정상)도 통과했다. 겸사겸사 04장 111행의 「IMU 오프셋 전부 0」과 35-2 의 「lidar·camera 미실측」 표기를 344 결과로 갱신했다(TBD-HW-012 해소). 변경 파일: `README.md`, `03-제어-캘리브레이션.md`, `04-자율주행.md`, `sentinel.urdf`, `sentinel_description/README.md`, `validate_urdf_tree.py`, `.gitlab-ci.yml` |

| v2.1-r1 | 2026-08-12 | 전수 검토 정리 | S15P11A301-376. docs 전체를 링크·앵커 기계 검사(13파일 0건)와 용어 대조로 훑고 **「없는 것이 있는 것처럼 남은 서술」을 걷었다.** ① **물리 E-Stop 잔재 12곳** — 01장(운영자 권한·시연 시퀀스 1·16·시연 스크립트 12·체크리스트·DoD 안전·15.5 배포 게이트)과 06장(벤치 시험 항목·16.2·시연 준비물·G0 Gate·Critical 지표)이 아직 존재를 전제해 **같은 문서 다른 절(01장 1.3·19.1, 06장 38-3·38-8)과 모순**이었다. TBD-HW-007 이 미도입으로 종료됐으므로 확인·시연·게이트 대상에서 빼고 실제 수단(watchdog 300ms·수동 TTL 250ms·collision_monitor·12V 배터리 분리)으로 바꿨다. 「E-Stop 물리 동작」 체크는 **12V 배터리 분리 담당자·지점 확인**으로 대체했다 — 점검 항목이 없어지면 그 확인도 사라지기 때문이다. ② **시각 동기화** 22.4 의 `chrony/NTP` 를 `systemd-timesyncd` 로 정정(실기 확인: timesyncd active·chrony inactive). 06장 37-3-1 이 이미 timesyncd 를 규범으로 쓰고 있었고, RTC 백업 배터리 부재로 인한 부팅 시 이중 시계 점프와 `time-sync.target` 결합도 22.4 에 명시했다. ③ **planner 당시 기록** 24.1 의 2026-08-06·08-08 두 절이 「planner 는 NavFn 을 유지했다」·「즉시 결정하지 않는다」로 끝나 현재 구성으로 읽혔다. 근거는 보존하고 머리에 Smac 전환(358) 해소 포인터를 넣었다. ④ **`docs/ai/` 삭제** — 07·08장을 가리키는 11줄 포인터 스텁 하나뿐이라 문서 구성 표와 중복된 홉이었다(표의 `ai/README.md` 행도 제거). `pipeline.jetson.yaml` 이 참조하던 `docs/04-자율주행-AI.md`(v2.0-r1 에서 분리·소멸)도 07장으로 정정했다. ⑤ 장애 주입 시험의 「게임패드 분리」를 모바일 조종 차단으로, 검수 기준 기준일을 2026-08-09 → **2026-08-11**(v2.1 작성일)로 맞췄다. 변경 파일: `README.md`, `01-프로젝트-개요.md`, `04-자율주행.md`, `06-테스트-보안-운영.md`, `docs/ai/README.md`(삭제 — 저장소 루트의 `ai/README.md` 는 유지된다), `pipeline.jetson.yaml` |
| v2.1-r2 | 2026-08-12 | r1 이 한 벌만 고친 잔재를 마저 걷는다 | S15P11A301-376. r1 검토에서 **같은 잔재가 한 벌 더 남은 것**을 확인해 마무리했다. ① **없어진 문서 참조 3곳** — r1 이 `pipeline.jetson.yaml` 만 고쳤는데 `pipeline.yaml` 40·252·256 행이 아직 `docs/04-자율주행-AI.md`(v2.0-r1 에서 분리·소멸)를 가리켰다. 같은 파일 104·155 행이 이미 쓰는 형식대로 `docs/07-AI-탐지.md` 로 맞췄고, 소멸한 파일의 행 번호(`:78`·`:80`·`444`·`454`)는 옮길 대상이 없어 뺐다. ② **물리 E-Stop 잔재 4곳** — r1 이 12곳을 걷었으나 01장 15.2 MR 리뷰 조건·17.2 역할 분담표, 06장 SR-008·부록 E 11번이 아직 장치의 존재를 전제했다. 실제 수단(watchdog·12V 배터리 분리)으로 바꾸고 미도입 포인터(03장 34-10)를 달았다. **`git_convention.md` 의 MR 조건도 01장 15.2 와 같은 문장이라 함께 고쳤다** — 한쪽만 고치면 다음 사람이 다시 대조하게 된다. ③ **변경 이력 오기** — r1 항목이 삭제 파일을 `ai/README.md` 로 적었으나 실제 삭제분은 `docs/ai/README.md` 다. 루트 `ai/README.md` 는 살아 있고 `pipeline.jetson.yaml:11` 이 참조 중이라, 그대로 두면 살아 있는 파일을 지워진 것으로 읽는다. ④ **지도 업로더 기본 백엔드 주소** — 문서 대조 중 같은 형태의 「한 벌만 고쳐진 것」을 코드에서 확인해 함께 고쳤다. `map_uploader_node.py` 기본값이 apex 도메인(`https://sentinel-ugv.xyz`)이라 모든 API 요청이 404 가 되는데, **Vercel 프론트가 200 을 주므로 망 문제로도 보이지 않는다.** `media_uploader_node.py` 는 S15P11A301-171 에서 「지도 업로더가 같은 함정을 밟았다」는 주석과 함께 고쳐졌는데 원인이 된 이 노드가 남아 있었다. `api.sentinel-ugv.xyz` 로 맞추고, 그 값을 손으로 덮던 `demo.launch.py` 오버라이드와 사실과 달라진 주석을 걷었다. 변경 파일: `README.md`, `01-프로젝트-개요.md`, `06-테스트-보안-운영.md`, `git_convention.md`, `pipeline.yaml`, `map_uploader_node.py`, `demo.launch.py` |

| v2.1-r3 | 2026-08-12 | 시연 종료 후 저장소 정리 — 안 돌던 시험, 안 쓰던 의존성, 낡은 주석 | S15P11A301-377. 376(문서)이 끝난 뒤 저장소를 전수 검토해 나온 것들이다. **없는 보호를 있다고 믿게 하는 것부터 걷었다.** ① **CI 가 시험 166건을 한 번도 돌리지 않았다** — `esp32_bridge` 137·`sentinel_safety` 29 가 어느 job 에도 없어 안전 게이트·명령 먹스·시리얼 프레이밍·CRC 가 CI 밖이었다. 두 패키지 시험은 `rclpy` 를 import 하지 않아 기존 계약 잡과 조건이 같다(실측 0.46초). ② **FR-025 가 어떻게 끝났는지 적었다** — 36-4 의 「둘 중 하나는 반드시」 중 둘째(공유 토큰)는 하지 않은 것이 저장소로 확정되고(필터·토큰 검사·Nginx 설정 전무) 첫째(SG)는 콘솔 상태라 확인 불가임을 갈라 적었다. ③ **삭제된 패키지·없는 파일 참조** — `sentinel_perception`(155 에서 제거)이 CI `rules.changes` 와 주석에 남았고, 루트 README 의 「ROS 래퍼는 jetson/ros2_ws」는 부정확하며(실제로는 `.venv` 파이썬을 `ExecuteProcess` 로 부른다), `application.yml` 의 `spring.docker.compose.file` 은 없는 파일을 가리켰다. `jetson/tests`·`jetson/config` 는 **삭제했다** — README 만 있는 빈 디렉터리였다. 처음에는 그 README 에 「비어 있고 실제 시험·설정은 어디에 있다」를 적었으나, git 은 빈 디렉터리를 추적하지 않으므로 **그 README 가 디렉터리의 유일한 존재 이유**가 된다. 없는 것을 설명하려고 파일을 남기는 형태라 지우는 쪽이 맞다(시험 위치는 `jetson/README.md` 의 패키지 표와 `colcon test` 가 이미 답한다). `jetson/models`·`common/protocol` 은 남긴다 — 가중치 등록표(SHA·실측 FPS·TensorRT 상태)와 프로토콜 계약 포인터라는 **실제 내용**이 있고 「비어 있다」를 적은 문서가 아니다. ④ **JPA 의존성 전체가 미사용** — `@Entity`·`JpaRepository` 0건인데 Hibernate 가 검증 대상 0개로 매 기동마다 떴다. `-data-jpa`→`-jdbc`. ⑤ **운영 기본값이 공통 설정에** — `S3_ACCESS_KEY:admin`·운영 MinIO 주소가 프로필 공통 파일에 있어 주입이 빠지면 조용히 운영 스토리지를 가리켰다. ⑥ **린터 도입** — 파이썬 239파일·Java 에 린터가 없었다. 위반 12건(py)·7건(java)을 전부 고치고 0에서 시작한다. ⑦ 낡은 주석 정정 — `drive_measure.py` 의 「물리 E-Stop 에 손이 닿는 상태」·「초음파 보호정지가 막는다」, `detection.launch.py` 의 「PyTorch 로 돌면서 경고」. ⑧ `drive_measure.py` 의 SIGSTOP 복구가 `finally` 뿐이라 `Ctrl+Z`·SIGHUP·SIGTERM 에서 발행자를 멈춘 채 남겼다 — 그 파일 주석이 경고한 상태를 자신이 만들 수 있었다. ⑨ 프런트 — `RobotContext` 노출 필드 5개가 소비자 0이었고 그중 `detections` 는 **5초마다 API 를 부르고 버리는 폴링**을 끌고 있었다(695→590줄). 실험판 화면이 Vercel 운영 도메인에서 열리던 것도 닫았다. ⑩ **루트 README 에 「할 수 있는 것」 절 신설** — 「프로젝트 상태」가 긍정 8줄 대 부정(범위 제외·미구현·제한) 43줄이었고, **무엇을 하는 로봇인지 나열한 곳이 아예 없었다.** 부품 목록(「시스템 구성」)은 그 답이 아니다. MVP 16개 중 14개 구현이라는 사실이 저장소 첫 화면에 없어, 실제로는 전 구간 실기동한 프로젝트가 「안 된 것이 많은 프로젝트」로 읽혔다. 미구현·폐기를 적는 원칙은 그대로 두고 — 그것이 v2.0 이 세운 규칙이다 — 된 것을 안 적던 쪽만 채웠다. 헤더 배지의 `R_min`·`EKF yaw`(내부 계측치라 처음 보는 사람에게 뜻이 전달되지 않는다)를 `MVP 14/16`·`자동 시험 941건`으로 바꿨다. 「실기동으로 확인된 것」은 기능 나열과 겹치므로 **「설계 문서만 보면 오해하는 층」**(곡률 상한을 지키는 것은 planner 가 아니라 `vehicle_kinematics`)을 적는 자리로 역할을 좁혔다. **판단해서 남긴 것**: `ai/detection` 의 `src/` 평면 구조는 launch 경로 검증에 젯슨 실기가 필요해 사유와 함께 `ai/README.md` 에 적고 두었다. 업로드 클라이언트 2종은 이미 절반이 공통화돼 있고 남은 차이가 실제 계약 차이라 그대로 둔다(`map_upload_client.py` docstring). 변경 파일: `README.md`, `06-테스트-보안-운영.md`, `07-AI-탐지.md`, 저장소 README 3개(`/README.md`, `ai`, `backend`), `jetson/tests`·`jetson/config`(삭제), `.gitlab-ci.yml`, `ruff.toml`(신설), `checkstyle.xml`(신설), `build.gradle`, `application.yml`, `application-local.yml`, `drive_measure.py`, `detection.launch.py`, `RobotContext.tsx`, `blackbox-experiment/*`, 시험 파일명 3건 |

> 문서를 변경할 때는 위 표에 한 줄을 추가하고, 어느 파일이 바뀌었는지 함께 적는다. 파일별 버전은 두지 않는다.

## 결정 상태 표기
| **표기**  | **의미** | **처리 원칙** |
|---|---|---|
| 확정 | 팀이 해당 방식으로 구현 | 변경 시 팀 합의 및 변경 이력 기록 |
| 잠정 확정 | 추천안을 우선 적용 | 실험 결과에 따라 대체안으로 전환 가능 |
| TBD | 부품 확인·측정·검증 후 결정 | 담당자와 확정 기한을 반드시 지정 |
| 확장 | MVP 완료 후 추가 | 필수 기능 일정에 영향을 주지 않는 범위에서 수행 |

## 검수 기준

본 문서는 **2026-08-11 현재 저장소 코드·설정과 실제 장비에서 확인된 최신 결정**을 설계 기준으로 사용한다. 서로 다른 시점의 결정이 충돌하면 실행 코드와 더 나중에 기록된 실측 결과를 우선한다. 요약 장(1~20장)과 상세 장(21~38장)의 기술이 어긋나면 **상세 장을 규범으로 우선**한다.

- 차량은 **BMW M7 유아전동차의 구동 베이스를 활용**한다.
- 고수준 컴퓨팅은 Jetson Orin Nano 8GB, 저수준 주행 제어는 ESP32 WROOM-32 2개(모터 제어용·센서 제어용 분리)가 담당하며 Raspberry Pi 5는 차량에 탑재하지 않는다.
- Jetson↔ESP32 제어 링크는 각 ESP32마다 독립된 유선 USB Serial을 사용한다. ESP32 Wi-Fi/Bluetooth는 모터 제어·E-Stop·watchdog 경로에 사용하지 않는다.
- 실제 Jetson에서 확인한 `JetPack 6.2.1+b38`과 ROS 2 Humble을 소프트웨어 기준선으로 고정한다.
- **구동계는 후륜 좌·우 RS540 FD-12V RPM14000 모터 2개가 전진·후진을, 전륜 타이로드에 직결된 DS51150-12V 서보모터 1개가 조향을 담당한다.** 휠베이스 `L=0.683m`, 최대 바퀴 조향각 `δ_max=22°`이며 제자리 회전은 할 수 없다. 펌웨어 조향 상수는 서보 ±55°/바퀴 ±22°로 맞췄고 `steering_measure.py` 원주행에서 `R_min` 좌 1.37m·우 1.76m를 확인해 Smac에 1.8m를 적용했다. 후륜 엔코더 단거리 스케일은 줄자와 3% 안에서 일치하고 0.30m/s 명령 대비 실속도는 99%다. 남은 핵심 항목은 좌·우 장거리 스케일·정지거리·조향 히스테리시스·IMU 360° 장기 재현성·감속비·정지 전류·전력 예산이다(부록 H).
- 사람 탐지는 사전학습 YOLO26n Detect를 사용한다. 파인튜닝은 교차 평가에서 일반화 성능이 하락해 미채택했으며, Pose는 사람 감지 시에만 실행하는 조건부 파이프라인으로 운영한다.
- 짐벌은 프로젝트에서 완전히 제외한다. 카메라·LiDAR는 차체에 고정 마운트하며 정적(static) TF만 사용한다. 기존 FR-024(짐벌 NAV_LOCK/CENTER_LOCK)는 폐기한다.
- 피해자 음성 출력은 블루투스 스피커, 입력은 BRIO 100 내장 마이크를 사용한다. VAD는 Jetson, STT는 L40S FastAPI Qwen3-ASR-1.7B, 정보 추출은 GMS `gpt-5.4-mini`, 안내는 승인된 사전 녹음 WAV로 운영한다. 동적 TTS와 Jetson 로컬 STT·LLM은 사용하지 않는다.
- 통신 계약(REST·MQTT·WebSocket 메시지)은 31장을 유일 기준으로 하며 12장은 요약이다.

# 문서 구성

역할별 파일과 TBD 대장으로 분리한다. 장 번호는 전역 연속이며, 요약 장과 규범(상세) 장은 되도록 같은 파일에 묶었다.

| 파일 | 담당 역할 | 포함 장·부록 |
|---|---|---|
| [README.md](README.md) | 전원 | 문서 규칙·버전·변경 이력·읽기 경로·용어집(부록 G)·참고 자료 |
| [01-프로젝트-개요.md](01-프로젝트-개요.md) | 처음 합류·기획 | 1~5장(개요·목표·시나리오·아키텍처), 7장(기술 스택), 15장(저장소·CI/CD), 17~20장(일정·위험·시연·완료 기준) |
| [02-하드웨어.md](02-하드웨어.md) | 임베디드·기구 | 6장(하드웨어·기구), 21장(인터페이스·전원·배선), 부록 I(BOM)·J(핀맵) |
| [03-제어-캘리브레이션.md](03-제어-캘리브레이션.md) | 임베디드·주행 | 34장(ESP32 저수준 제어·안전 통신), 35장(센서·엔코더 캘리브레이션·튜닝) |
| [04-자율주행.md](04-자율주행.md) | ROS2·주행 | 8장(자율주행 요약), 14장(상태 머신·안전 정책), 22~24장(TF·SLAM·Nav2), 26장(Mission Manager) |
| [07-AI-탐지.md](07-AI-탐지.md) | AI·탐지 | 9장(AI 요약), 25장(사람 탐지·추적·자세 판정), 30장(피해자 오케스트레이션) |
| [08-AI-음성.md](08-AI-음성.md) | AI·음성 | 33장(음성 상호작용·GPU ASR·Jetson 실행·실측) |
| [05-통신-서버-영상.md](05-통신-서버-영상.md) | 백엔드·프론트·영상 | 10~13장(영상·관제 웹·통신·DB 요약), 27~29장(Spring Boot·Next.js·DB/S3), 31장(통신 계약 규범), 32장(스트리밍·녹화), 부록 D(환경 변수) |
| [06-테스트-보안-운영.md](06-테스트-보안-운영.md) | 안전·시험·운영 | 16장(테스트 계획), 36~38장(보안·운영·요구사항 추적·인수 시험), 부록 A~C(요구사항)·E~F(실행·로그)·K(기준선)·L(파라미터) |
| [TROUBLESHOOTING.md](TROUBLESHOOTING.md) | 현장 운영·전체 | 증상에서 03·04·05·06·07·08장의 규범 절차로 이동하는 빠른 진단 인덱스 |
| [TBD.md](TBD.md) | 전원 | 부록 H — 미확정 항목 단일 대장(담당·기한 포함). 가장 자주 갱신됨 |
| [git_convention.md](git_convention.md) | 전원 | 브랜치·커밋·MR 규칙 |

## 전체 목차

장 번호는 전역 연속(1~38, 부록 A~L)이며, 파일 안에서는 번호가 불연속일 수 있으나 고유 식별자로 사용한다.

| 장 | 제목 | 파일 |
|----|---|---|
| 1  | 프로젝트 개요 및 배경 | [01](01-프로젝트-개요.md) |
| 2  | 목표, 범위 및 성공 기준 | [01](01-프로젝트-개요.md) |
| 3  | 최신 확정 구조와 설계 결정 | [01](01-프로젝트-개요.md) |
| 4  | 사용자·시연 시나리오 | [01](01-프로젝트-개요.md) |
| 5  | 전체 시스템 아키텍처 | [01](01-프로젝트-개요.md) |
| 6  | 하드웨어 및 기구 설계 | [02](02-하드웨어.md) |
| 7  | 소프트웨어 기술 스택 및 실행 환경 | [01](01-프로젝트-개요.md) |
| 8  | ROS2 자율주행 및 탐사 설계 | [04](04-자율주행.md) |
| 9  | AI 인식 및 센서 융합 | [07](07-AI-탐지.md) |
| 10 | 영상 스트리밍 및 이벤트 녹화 | [05](05-통신-서버-영상.md) |
| 11 | 통합 관제 웹 시스템 | [05](05-통신-서버-영상.md) |
| 12 | 통신 프로토콜 및 API | [05](05-통신-서버-영상.md) |
| 13 | 데이터베이스·시계열·S3 설계 | [05](05-통신-서버-영상.md) |
| 14 | 상태 머신 및 안전 정책 | [04](04-자율주행.md) |
| 15 | 저장소·배포·CI/CD | [01](01-프로젝트-개요.md) |
| 16 | 테스트 및 검증 계획 | [06](06-테스트-보안-운영.md) |
| 17 | 일정 및 역할 분배 | [01](01-프로젝트-개요.md) |
| 18 | 위험 관리와 대체안 | [01](01-프로젝트-개요.md) |
| 19 | 최종 시연 계획 | [01](01-프로젝트-개요.md) |
| 20 | 완료 기준 및 KPI | [01](01-프로젝트-개요.md) |
| 21 | 하드웨어 인터페이스·전원·배선 상세 설계 | [02](02-하드웨어.md) |
| 22 | 센서 수집·시간 동기화·좌표계 상세 설계 | [04](04-자율주행.md) |
| 23 | SLAM·위치 추정·미지 영역 탐사 상세 설계 | [04](04-자율주행.md) |
| 24 | Nav2 경로 계획·장애물 회피·안전 속도 설계 | [04](04-자율주행.md) |
| 25 | 사람 탐지·추적·위치 추정 상세 설계 | [07](07-AI-탐지.md) |
| 26 | Mission Manager·임무 상태 머신 상세 설계 | [04](04-자율주행.md) |
| 27 | Spring Boot 관제 백엔드·도메인·API 상세 설계 | [05](05-통신-서버-영상.md) |
| 28 | Next.js 관제 화면·조이스틱 UX 상세 설계 | [05](05-통신-서버-영상.md) |
| 29 | PostgreSQL·TimescaleDB·S3·Outbox 상세 설계 | [05](05-통신-서버-영상.md) |
| 30 | 피해자 발견·접근·상호작용 오케스트레이션 | [07](07-AI-탐지.md) |
| 31 | Jetson·Spring Boot·관제 웹 통신 설계 | [05](05-통신-서버-영상.md) |
| 32 | 영상 스트리밍·3초 링 버퍼·이벤트 녹화 설계 | [05](05-통신-서버-영상.md) |
| 33 | 피해자 음성 상호작용 설계 | [08](08-AI-음성.md) |
| 34 | ESP32 저수준 주행 제어·안전 통신 설계 | [03](03-제어-캘리브레이션.md) |
| 35 | 센서·엔코더 캘리브레이션 및 튜닝 | [03](03-제어-캘리브레이션.md) |
| 36 | 보안·개인정보·데이터 보호 정책 | [06](06-테스트-보안-운영.md) |
| 37 | 운영·모니터링·장애 복구 설계 | [06](06-테스트-보안-운영.md) |
| 38 | 요구사항 추적표·최종 인수 시험 | [06](06-테스트-보안-운영.md) |
| 부록 A | 기능 요구사항 상세 | [06](06-테스트-보안-운영.md) |
| 부록 B | 비기능·안전 요구사항 | [06](06-테스트-보안-운영.md) |
| 부록 C | 주요 ROS 토픽·액션 | [06](06-테스트-보안-운영.md) |
| 부록 D | 환경 변수 예시 | [05](05-통신-서버-영상.md) |
| 부록 E | 초기 실행 순서 | [06](06-테스트-보안-운영.md) |
| 부록 F | 주요 로그 확인 명령 | [06](06-테스트-보안-운영.md) |
| 부록 G | 용어집 | [README](README.md#부록-g-용어집) |
| 부록 H | 최종 TBD 및 변경 관리 | [TBD](TBD.md) |
| 부록 I | 최종 BOM·전력 예산 템플릿 | [02](02-하드웨어.md) |
| 부록 J | 배선도·핀맵 확정표 | [02](02-하드웨어.md) |
| 부록 K | 소프트웨어 기준선 | [06](06-테스트-보안-운영.md) |
| 부록 L | 최종 파라미터 동결표 | [06](06-테스트-보안-운영.md) |

## 독자별 읽기 경로

**1~20장은 프로젝트 전체를 빠르게 파악하는 요약**, **21~38장은 구현 기준이 되는 상세 규범**, 부록은 요구사항·TBD 대장·기준선이다. 요약 장과 상세 장이 어긋나면 상세 장을 따른다.

| 독자 | 먼저 읽을 것 | 구현 기준 (규범) |
|---|---|---|
| 처음 합류한 팀원 | [01](01-프로젝트-개요.md)의 1~5·17장, 용어집(README) | - |
| 임베디드·기구 | [02](02-하드웨어.md)의 6장 | [02](02-하드웨어.md)의 21장, [03](03-제어-캘리브레이션.md)의 34·35장, [TBD](TBD.md), 부록 I·J |
| ROS2·자율주행 | [04](04-자율주행.md)의 8장 | [04](04-자율주행.md)의 22~24장, [03](03-제어-캘리브레이션.md)의 35장 |
| AI 탐지 | [07](07-AI-탐지.md)의 9장 | [07](07-AI-탐지.md)의 25·30장 |
| AI 음성 | [08](08-AI-음성.md)의 33.1장 | [08](08-AI-음성.md)의 33장 전체 |
| 백엔드 | [05](05-통신-서버-영상.md)의 12·13장 | [05](05-통신-서버-영상.md)의 27·29·31장 |
| 프론트엔드 | [05](05-통신-서버-영상.md)의 11장 | [05](05-통신-서버-영상.md)의 28장·31-8 |
| 영상 | [05](05-통신-서버-영상.md)의 10장 | [05](05-통신-서버-영상.md)의 32장 |
| 안전·시험 담당 | [04](04-자율주행.md)의 14장, [06](06-테스트-보안-운영.md)의 16장 | [04](04-자율주행.md)의 26장, [06](06-테스트-보안-운영.md)의 36~38장 |

# 부록 G. 용어집
| **용어** | **설명** |
|---|---|
| **UGV** | Unmanned Ground Vehicle, 무인 지상 차량 |
| **온디바이스 AI**  | 클라우드가 아닌 장치 내부에서 AI 추론을 수행하는 방식 |
| **추론** | 학습된 모델에 새 입력을 넣어 결과를 얻는 과정 |
| **SLAM** | 위치 추정과 지도 작성을 동시에 수행하는 기술 |
| **Nav2** | ROS2 기반 경로 계획·주행·복구 프레임워크 |
| **Frontier** | 확인된 자유 공간과 미지 공간의 경계 |
| **오도메트리** | 바퀴·IMU 등으로 로봇 이동량을 추정한 값 |
| **TF** | ROS에서 좌표계 관계를 관리하는 시스템 |
| **Costmap** | 장애물과 이동 비용을 표현하는 격자 지도 |
| **WebRTC** | 브라우저 저지연 실시간 미디어 통신 기술 |
| **WHEP** | WebRTC 스트림 수신을 위한 HTTP 기반 표준 인터페이스 |
| **MediaMTX** | RTSP/WebRTC 등 미디어 프로토콜 중계 서버 |
| **TimescaleDB** | PostgreSQL 확장 기반 시계열 데이터베이스 |
| **MQTT** | 차량 상태·이벤트·명령을 토픽 기반으로 교환하는 메시지 프로토콜 |
| **Encounter** | 한 번의 사람 그룹 발견·접근·대화·보고를 묶는 도메인 단위 |
| **BoT-SORT** | 카메라 움직임 보정과 외형·운동 정보를 이용해 사람별 track ID를 유지하는 다중 객체 추적기 |
| **Watchdog** | 정해진 시간 안에 정상 신호가 없으면 안전 동작을 수행하는 감시기 |
| **S3** | AWS 객체 스토리지 |
| **Presigned URL**  | 제한 시간 동안 특정 S3 객체 업로드·조회 권한을 제공하는 URL |
| **Deadman switch** | 버튼을 누르는 동안에만 장비가 동작하도록 하는 안전 입력 |
| **E-Stop** | 비상 정지 |
| **TBD** | 추후 결정할 항목 |

# 참고 자료
- [NVIDIA JetPack 6.2.1 / Jetson Linux 36.4.4](https://forums.developer.nvidia.com/t/jetpack-6-2-1-jetson-linux-36-4-4-is-now-live/337335)
- [NVIDIA JetPack Archive](https://developer.nvidia.com/embedded/jetpack-archive)
- [ROS 2 Humble Ubuntu 22.04 설치](https://docs.ros.org/en/humble/Installation/Ubuntu-Install-Debs.html)
- [Ultralytics YOLO26](https://docs.ultralytics.com/models/yolo26/)
- [Nav2 공식 문서](https://docs.nav2.org/)
- [Nav2 알고리즘 선택 - 로봇 운동학별 planner·controller 지원(differential·Ackermann)](https://docs.nav2.org/setup_guides/algorithm/select_algorithm.html)
- [ROS 2 Control Humble - Wheeled Mobile Robot Kinematics (자전거·Ackermann 모델 포함)](https://control.ros.org/humble/doc/ros2_controllers/doc/mobile_robot_kinematics.html)
- [MediaMTX 공식 문서](https://mediamtx.org/docs/kickoff/introduction)
- [MQTT 5.0 OASIS 표준](https://docs.oasis-open.org/mqtt/mqtt/v5.0/mqtt-v5.0.html)
- [AWS S3 보안 모범 사례](https://docs.aws.amazon.com/AmazonS3/latest/userguide/security-best-practices.html)

본 문서는 위 명세서의 교육 목표와 제공 하드웨어를 참고하되, Sentinel UGV의 재난 탐사 시나리오와 팀의 기술 스택에 맞게 재구성한 독립 프로젝트 종합 명세서이다.
