Common-AIOT/Sentinel-UGV/hardware/cad/README.md

# CAD

편집 가능한 CAD 원본을 우선 보관하고 도구와 버전을 기록합니다. 대용량 중간 산출물과 자동 생성 백업은 제외합니다.
