Common-AIOT/Sentinel-UGV/common/samples/README.md

# Samples

로봇 없이 frontend와 backend를 개발할 수 있도록 정상, 장애와 재연결 상황의 비식별 샘플 데이터를 보관합니다. 실제 장치 ID, URL, 토큰과 위치 정보는 제거합니다.
