Common-AIOT/Sentinel-UGV/jetson/ros2_ws/src/sentinel_safety/README.md

# sentinel_safety

자율/수동 명령 중재, E-Stop, deadman switch, 명령 watchdog과 센서 오류 안전 정지를 담당합니다. 다른 패키지는 최종 모터 명령 경로에서 이 계층을 우회하지 않습니다.
