Common-AIOT/Sentinel-UGV/docs/04-자율주행.md

> Sentinel UGV 통합 명세서 v2.1의 일부 — 문서 규칙·버전·변경 이력은 [README](README.md) 참조
>
> **v2.0-r1에서 AI 장을 분리했고, v2.0-r14에서 탐지와 음성을 다시 나눴다.** 탐지·오케스트레이션은 [07-AI-탐지.md](07-AI-탐지.md), 음성은 [08-AI-음성.md](08-AI-음성.md)를 따른다.
> AI(객체탐지·음성)와 자율주행은 모두 구현·실측 이력을 포함한 작업 문서라,
> 한 파일에 두면 자율주행 변경마다 완료된 장이 diff 에 섞인다. 장 번호는 문서
> 전체에서 전역이므로(README 장별 안내) 번호 참조는 그대로 유효하다.

# 8. ROS2 자율주행 및 탐사 설계 [확정]

> 이 장은 요약이다. 규범(상세)은 22장(센서 수집·시간 동기화·좌표계), 23장(SLAM·위치 추정·Frontier 탐사), 24장(Nav2 경로 계획·안전 속도), 34장(ESP32 저수준 제어·안전 체인)이다. 단, 8.2 전체 노드 구성 표와 8.3 TF 트리, 아래 탐사 종료·복귀 세부 조건은 문서에서 이 장이 기준이다.

**핵심 결정**

| 항목 | 결정 | 상세 |
|---|---|---|
| 처리 파이프라인 | 센서(camera·`/scan`·엔코더·IMU) → EKF **[구현, 기본 꺼짐]** → TF → slam_toolbox **[구현]** → frontier_explorer·Nav2 **[구현, 기본 꺼짐]** → 안전 제한(command_mux·velocity_smoother·collision_monitor·safety_gate) **[구현, 기본 꺼짐]** → vehicle_kinematics(**전륜 자전거 모델 구현**) → BTS7960 ×2(후륜 좌·우 RS540 ×2) + DS51150-12V 조향 서보. 센서 주기, MPU6050 축·장착 자세, 90° EKF, 서보-바퀴 55°/22° 링키지 비는 확인됐다. 남은 정량 인수는 좌·우 장거리 스케일·정지거리·360° 장기 재현성과 조향 히스테리시스다 | 23.1, 34-3, 8.2 |
| Frontier 탐사 | Occupancy Grid에서 자유/미지 경계 셀을 군집화하고, 도달 가능 후보만 남긴 뒤 거리·예상 정보량·장애물 여유·방문 이력으로 점수화해 최고 점수 후보를 Nav2 목표로 전송한다. 사람 위치를 사전에 알 수 없으므로 "사람 찾기"는 접근 가능한 미지 영역을 빠짐없이 관찰하는 탐사 정책으로 구현한다 | 23.3 |
| 탐사 종료·복귀 | **현재 구현된 종료 조건은 운영자 STOP 하나다.** Frontier 소진·최대 7분 자동 종료와 home pose 자동 복귀(`RETURNING`)는 설계만 있고 실행 경로는 없다. STOP ACK 시 백엔드는 임무를 종료하고 로봇은 `COMPLETED`로 전환한다. 배터리 기반 종료는 계측 센서가 없어 폐기했다 | 23.4~23.6, 26.3 |
| 오도메트리·보정 | 센서 ESP32가 후륜 엔코더와 MPU6050을 공통 monotonic 시계로 취득한다. Jetson은 후륜 속도 평균을 선속도 `vx`로 사용하고, EKF가 IMU yaw rate와 융합한다. 전륜 조향에서는 엔코더 좌·우 속도 차로 만든 yaw를 신뢰하지 않는다. `L=0.683m`, `δ_max=22°`, `W=0.530m`, 바퀴 지름 `0.250m`를 반영했다. 펌웨어 주기 수정 뒤 단거리 거리는 줄자와 3% 안에서 일치했으며 좌·우 장거리 스케일과 IMU bias 재계측이 남았다 | 23.2, 35장 |
| 모터 명령 안전 체인 | 자율·수동 명령은 command_mux → velocity_smoother → collision_monitor → safety_gate → vehicle_kinematics(**전륜 조향 변환**) → esp32_motor_bridge를 거쳐 모터 ESP32의 watchdog·제어로 실행한다. 초음파 보호 정지 중계 경로도 남아 있지만 현재 센서 펌웨어가 신호를 항상 `false`로 내므로 발동하지 않는다. `enable_safety:=true`가 주행 경로를 실제 모터에 연결하므로 실차 점검 뒤 명시적으로 켠다 | 34장(규범), 24.1 |

## 8.2 ROS2 노드 구성

**실행 파일 이름은 리포가 근거다** (`jetson/ros2_ws/src/*/setup.py`의 `console_scripts`, `ai/*/src`). v2.0에서 구현 상태 열을 추가하고 실제 이름으로 맞췄다 — 없는 노드를 있는 것처럼 적어 두면 통합 검사에서 "왜 안 뜨나"를 매번 다시 조사한다.

`ai/detection`과 `ai/voice`는 **`ros2_ws` 밖에 있다.** 각자 독립 파이썬 패키지이고 ROS 진입점만 따로 둔다. 이 표에서 ROS 노드처럼 보이지만 패키지 경계가 다르다.

| **노드/실행 파일** | **역할** | **주요 입출력** | **상태** |
|---|---|---|---|
| `ydlidar_ros2_driver_node` | YDLIDAR X4 Pro 드라이버 | `/scan` | 구현 |
| `usb_cam_node` | BRIO 100 단일 오픈·MJPEG 패스스루 | `/camera/image_raw/compressed` | 구현(외부 패키지) |
| `slam_toolbox` (`async_slam_toolbox_node`) | 지도 생성·위치 추정 | `/map`, `/pose`, `/tf` | 구현 |
| `esp32_motor_bridge` | 후륜 구동 명령·조향각 명령 전송, 모터 상태 중계 | `~/drive_command`(JSON String) 수신, `~/drive_state`, `~/command_ack`, `/diagnostics` | 구현. 서보 55°/바퀴 22° 링키지 비와 `STEERING_MAX_MDEG=22000`을 반영했다(S15P11A301-341) |
| `esp32_sensor_bridge` | 엔코더·IMU·전후방 초음파·DHT11 상태 중계, 휠 오도메트리 | `/wheel/odometry`, `/imu/data_raw`, `/range/front`, `/range/rear`, `/proximity/protective_stop`, `/environment/*`, `/diagnostics` | 구현. 전·후방 거리는 모두 발행한다. 후방은 정지 판정에 포함되지 않고 전방 판정도 `PROXIMITY_STOP_ENABLED=false`라 현재 `protective_stop`은 항상 `false`다. 엔코더 기반 `vyaw`는 전륜 조향에서 근거가 없어 EKF 입력에서 제외한다 |
| `mission_manager` | 상태 머신·종료 조건 | `/mission/status`, `/mission/signal`, `/mission/command_result`, `/perception/encounter` | 구현. home pose는 `exploration_node`가 보관하며 복귀는 미구현 |
| `cloud_bridge` | ROS 상태를 EC2로 전달 (presence·state·telemetry) | MQTT/WSS | 구현 |
| `recording_manager` | 3초 링 버퍼·이벤트 녹화 상태 머신 | 로컬 파일 | 구현 |
| `media_uploader` | 미디어 S3 업로드 큐 | `/api/v1/media/uploads` | 구현 |
| `map_saver` / `map_uploader` | 임무 종료 시 지도 저장·업로드 | `/slam_toolbox/save_map`, `/map_uploader/registered` | 구현 |
| `stream_pipeline` | MJPEG 디코딩·x264 인코딩·MediaMTX 송출 | `/camera/image_raw/compressed` → RTSP | 구현 |
| `ai/detection/src/ros_main.py` | YOLO26n Detect·Pose 기반 사람 탐지와 쓰러짐 판정 | `/camera/image_raw/compressed` → `/perception/person_candidates` | 구현(`ros2_ws` 밖) |
| `ai/voice` | 음성 파이프라인 조정(Silero VAD·원격 STT·GMS 구조화·사전 녹음 재생)과 구조화 보고 생성 | `/interaction/report` | 구현(`ros2_ws` 밖) |
| `foxglove_bridge` | 시각화 WebSocket (TLS·읽기 전용) | `/map`, `/pose`, `/scan`, `/tf`, `/tf_static`, `/robot_description` | 구현(외부 패키지, 8.5) |
| `command_mux` | 자율/수동 중재(`controlMode` 로 선택, 모르면 차단) | `/cmd_vel_nav`·`/cmd_vel_manual` → `/cmd_vel_muxed` | 구현 (S15P11A301-237) |
| `velocity_smoother` | 가감속·최대 속도 제한 | `/cmd_vel_muxed` → `/cmd_vel_smoothed` | 구현 (S15P11A301-237, `nav2_velocity_smoother` 에 파라미터만 준다. **lifecycle 노드**) |
| `collision_monitor` | 근거리 충돌 방지(정지·감속 2구역) | `/cmd_vel_smoothed` → `/cmd_vel_safe` | 구현 (S15P11A301-237, `nav2_collision_monitor` 에 파라미터만 준다. **lifecycle 노드**) |
| `safety_gate` | 명령 TTL watchdog·최종 게이트 | `/cmd_vel_safe` → `/cmd_vel` | 구현 (S15P11A301-237) |
| `vehicle_kinematics` | v/ω → 후륜 속도 + 전륜 조향각 변환 | `/cmd_vel` → `esp32_motor_bridge/drive_command` | 구현. 자전거 모델 `δ=atan(L·ω/v)`, 후륜 동일 속도, 제자리 회전 거부, `L=0.683m`, `δ_max=22°` |
| `nav2_stack` | 경로 계획·제어·복구 | `/cmd_vel_nav` | 구현되고 계획·실기동을 확인했으나 동일 구성 3회 연속의 최종 인수는 미완료다. **Smac Hybrid-A\***(REEDS_SHEPP, `minimum_turning_radius: 1.8`) + RPP(`allow_reversing: true`)를 사용하고 제자리 회전 기능을 제거했다(2026-08-09 NavFn → Smac 전환, S15P11A301-358). `enable_nav2` 기본값은 `false` |
| `frontier_explorer` (실제 이름 `sentinel_exploration`) | 미탐사 목표 생성 + **카메라 커버리지 스윕** | `NavigateToPose` goal, `~/goal`·`~/status` | 구현 (S15P11A301-172). `frontier.py`·`coverage.py`·`sweep.py`·`selector.py`·`grid.py`·`blacklist.py`·`navigator.py`·`exploration_node.py`. `Nav2Navigator` 로 실제 주행한다. **기본 구성에서는 뜨지 않는다** — `enable_exploration` 기본 false 이고 `enable_nav2` 와 AND 로 묶여 있다 |
| `ekf_node` | 엔코더 vx + IMU yaw 각속도 융합, `odom→base_footprint` TF | `/wheel/odometry`·`/imu/data_raw` → `/odometry/filtered` | 구현 (S15P11A301-236, `enable_ekf` 기본 false) |
| `human_localizer` | 카메라 방위각+LiDAR 거리+TF로 map 좌표 계산 | `/human_observations` | **미구현** |
| `sentinel_approach` | `PERSON_APPROACHING` 접근 주행 (bearing-only) | `/perception/person_candidates`·`/scan`·`/mission/status` → `/cmd_vel_nav`·`/mission/signal` | 구현 (S15P11A301-247). `approach.py`(순수)·`approach_node.py`. **`enable_approach` 기본 false**, `enable_detector` 와 AND. **Nav2 를 요구하지 않는다** — 아래 24.6 |

### 현재 남은 통합 갭

`/cmd_vel`에서 모터 ESP32까지의 실행 경로와 Nav2·탐사·안전 패키지는 구현돼 있다. 다만 기본 데모는 실수로 바퀴가 도는 것을 막기 위해 Nav2·탐사·접근·안전·EKF를 끈 상태로 시작한다.

링키지 비 55°/22°, 엔코더 3.4배 부풀림 수정, 실측 `R_min`(좌 1.37m·우 1.76m), 속도→PWM 운용점 확정(0.30 명령 대비 실속도 99%), IMU 90°·정지 bias 검증은 완료됐다. 남은 핵심은 좌·우 장거리 스케일·정지거리·조향각↔yaw rate·히스테리시스, IMU 360°·장기 재현성, 초음파 보호 정책, `human_localizer`·자동 복귀·자동 종료다.

### 전륜 조향 통합 현황 (2026-08-09)

자전거 역운동학, 조향 필드 전송, 서보 PWM, Nav2의 제자리 회전 제거까지 코드에 반영됐다. 아래 표는 구현 상태와 실차 적용 전에 남은 보정 항목을 분리한 것이다.

| 위치 | 지금 상태 | 필요한 변경 |
|---|---|---|
| `vehicle_kinematics` | **자전거 모델 구현됨** — `δ = atan(L·ω/v)`, 후륜 동일 속도, `abs(v) < v_min` & `ω≠0` 거부 | 실측 `L`·`δ_max` 반영 — **완료**(2026-08-06, 아래) |
| `esp32_motor_bridge` | **조향 필드 전달됨** — `target_steering_mdeg`·`max_steering_rate_mdps` | — |
| 모터 ESP32 펌웨어 | 서보 PWM과 `SERVO_MAX_OFFSET_DEG=55`, `STEERING_MAX_MDEG=22000` 반영 | 실제 수동 매핑은 22° 상수를 사용. 미리보기 UI의 30° 사본과 단위 시험 fixture 동기화, 원주행 `R_min` 인수 남음 |
| `esp32_sensor_bridge` 정운동학 | `vyaw` 를 좌·우 속도 차로 낸다 | `vx` 만 내거나, yaw 는 IMU 에 맡긴다(23.2) |
| `nav2.yaml` | rotation shim·spin 제거, footprint·RPP·Smac Hybrid-A* 반영. planner `minimum_turning_radius=1.8` | 실측 `R_min` 안전측과 곡선 경로 결과로 Smac 전환 완료 |

> **2026-08-06 정정.** 위 세 행은 이 표에 **미구현으로 적혀 있었으나 실제로는 구현돼 있었다.** 코드를 확인해 고쳤다(`kinematics.py` 의 `atan(L·ω/v)`·`min_turning_radius_m`, `esp32_motor_bridge_node.py:234`, `hardware/esp32/motor/esp32_motor_comm/steering.cpp`). 문서가 있는 것을 없다고 적으면 같은 조사를 다시 하게 되고, 이 경우에는 「조향이 아직 안 붙었으니 주행 시험은 무리」라는 잘못된 판단으로 이어진다.

**순서가 있다.** `L`·`δ_max` 실측(2026-08-06 완료)이 먼저이고, 그것 없이 Nav2 를 건드리면 「왜 경로를 못 따라가는가」를 매번 다시 조사한다.

**종전에 적어 둔 위험한 조합은 해소됐다.** 이 문단은 "`ω` 가 차동 역운동학을 타고 좌·우 후륜을 반대로 돌린다"였는데, `vehicle_kinematics` 가 자전거 모델이므로 **후륜은 항상 같은 속도**이고 `ω` 는 조향각이 된다. 다만 `enable_safety:=true` 가 **실제로 모터를 돌리는 유일한 스위치**라는 점은 그대로다(S15P11A301-298). 그리고 `enable_exploration` 은 `enable_nav2` 와 AND 로 묶여 있어, 탐사만 켜도 목표가 나가지 않는다.

### 폐기한 노드 이름

v1.1까지 쓰던 이름 중 실제와 다른 것들이다. 검색 시 혼동을 막기 위해 남긴다.

| v1.1 이름 | v2.0 |
|---|---|
| `ydlidar_node` | `ydlidar_ros2_driver_node` |
| `camera_capture_node` | `usb_cam_node` (외부 패키지) |
| `yolo_inference_node` | `ai/detection` 내부 모듈 (독립 노드가 아니다) |
| `telemetry_bridge_node` | `cloud_bridge` 가 겸한다 |
| `media_recorder_node` | `recording_manager` + `media_uploader` 로 분리됐다 |
| `voice_interaction_node` | `ai/voice` |

## 8.3 TF 트리
TF 운용 규칙(dynamic/static 구분, 시각 지연 검증)의 규범은 22.3장이며, 아래는 휠 링크를 포함한 전체 트리이다.

```text
map
└─ odom
   └─ base_footprint
      └─ base_link
         ├─ imu_link
         ├─ rear_drive_wheel_link
         ├─ front_left_wheel_link      # 조향 바퀴(비구동)
         ├─ front_right_wheel_link     # 조향 바퀴(비구동)
         ├─ ultrasonic_front_link
         ├─ ultrasonic_rear_link       # 후방 HC-SR04, 실측 위치 반영
         ├─ lidar_link
         └─ camera_link → camera_optical_frame
```

- `odom → base_footprint → base_link`는 ROS 표준 관례(REP-105/120)를 따른다. `base_footprint`는 지면 투영, `base_link`는 차체 기준이다.
- **`imu_link` 로 `/imu/data_raw` 가 온다**(MPU6050, 90Hz, S15P11A301-244). URDF 의 `base_link → imu_link` 는 **2026-08-08 실측으로 채웠다**(S15P11A301-344) — 위치 `(0.233, −0.010, 0.215)` + 장착 기울기 pitch +9.3°·roll −2.3°(브레드보드 마운트 경사). TBD-HW-012 해소.
- **`odom → base_footprint` 발행자는 정확히 하나여야 한다.** 낼 수 있는 곳이 **셋**(브리지 휠 오도메트리 · SLAM static identity · EKF)이고, `demo.launch.py` 가 `enable_esp32`·`enable_ekf` 조합 네 가지 전부에서 하나만 남도록 구조로 묶는다(S15P11A301-222 의 2자 배타를 236 에서 3자로 확장). 배타표는 23.2 「EKF 융합」.
- **v2.0: `sentinel.urdf`에 시각 형상(visual geometry)이 없다.** 의도된 것이며, 그래서 Foxglove 의 URDF 레이어는 아무것도 그리지 않는다. 차체 치수는 TBD-HW-006 실측 후 반영한다.
- 짐벌은 미사용 확정(6.4)이므로 `lidar_link`·`camera_link`는 `base_link`의 자식이며 **static TF**만 발행한다. 동적 관절각·joint_state는 없다.
- **앞바퀴 조인트도 `fixed` 이며 조향각을 TF 에 반영하지 않는다**(2026-08-06 전륜 서보 조향 전환). 서보가 개루프라 실제 조향각을 읽을 수단이 없고, 앞바퀴에 센서가 없어 하중을 받는 변환 체인이 아니다. 목표각을 실제각처럼 발행하면 없는 측정을 있는 것으로 만든다 — 근거는 03장 35-2.
- 링크 이름은 `sentinel.urdf` 실제 값이다. 후륜은 좌·우 둘이 아니라 `rear_drive_wheel_link` 하나이며, 03장 35-2 의 트리도 2026-08-06 에 같은 값으로 맞췄다.

**상세 장 포인터**

- 센서별 처리·시간 정책·센서 품질 게이트: 22장
- SLAM 파이프라인·위치 추정 단계·Frontier 점수화·실패 복구: 23장
- Nav2 플래너 선정·속도 정책(자율 0.30m/s, 접근 0.25m/s)·장애물 구역·수동 조작 안전: 24장
- Jetson↔ESP32 안전 명령 체인·명령 수락 조건·watchdog: 34장

## 8.4 ROS 그래프 격리 (v2.0 신설, S15P11A301-218)

**DDS 디스커버리는 같은 LAN 안에서 도메인 ID 단위로 멀티캐스트한다.** 같은 망에 다른 팀의 ROS 2 그래프가 있으면 서로의 노드·토픽이 그대로 섞인다. 실제로 외부 노드 37개가 우리 그래프에 보였고, 그 상태에서는 `ros2 node list`로 우리 노드 생존을 판정할 수 없다.

격리 값은 **`scripts/ros_env.sh` 한 곳에만** 둔다. 스크립트마다 복사하면 두 곳이 어긋나고, 어긋나면 노드들이 서로를 못 본 채 조용히 돈다 — 화면에는 "토픽이 안 온다"만 남는다.

```bash
export ROS_LOCALHOST_ONLY=1   # 물리적 격리. 같은 기기 안에서만 통신한다
export ROS_DOMAIN_ID=97       # 규약적 격리. 0~101 범위여야 한다
```

- `ROS_LOCALHOST_ONLY=1`이 **물리적 격리**다. 도메인 ID는 규약일 뿐이라 남이 같은 번호를 쓰면 다시 섞인다.
- 도메인 ID는 **0~101**을 쓴다. 그 위 값은 리눅스 ephemeral 포트 범위와 충돌한다.
- 젯슨과 노트북을 나눠 쓰는 구성으로 바꿀 때는 `ROS_LOCALHOST_ONLY`를 끄고 도메인 ID만 남긴다. 그때 격리 강도가 내려가는 것을 인지해야 한다.

## 8.5 시각화 경로 (v2.0 신설, S15P11A301-216·221·224·233)

RViz 대신 **`foxglove_bridge`**를 쓴다. 젯슨에 디스플레이가 없고, 브릿지는 WebSocket 하나만 열면 노트북 브라우저에서 바로 본다. RViz를 쓰려면 X 전달이나 원격 데스크톱이 필요하다.

```text
접속       wss://jetson.sentinel-ugv.xyz:8765
연결 유형   Foxglove WebSocket   (Rosbridge 를 고르면 핸드셰이크가 깨진다)
서브프로토콜 foxglove.sdk.v1     (foxglove.websocket.v1 은 HTTP 400)
```

**`ws://`가 아니다.** TLS를 켜 두었으므로 평문으로 붙으면 서버가 핸드셰이크를 기다리다 끊고, Foxglove에는 `No details provided`만 남는다 — 원인이 어디에도 적히지 않는다. 켜고 끄는 절차와 3D 패널 설정은 `scripts/README.md`가 규범이다.

### 노출 범위와 수락한 위험

| 항목 | 설정 |
|---|---|
| TLS | `tls: true`, `~/.config/sentinel/certs/server.{crt,key}` |
| 쓰기 | 차단. `capabilities: [connectionGraph]` — 파라미터 변경·서비스 호출 불가 |
| 토픽 | `/map` `/pose` `/pose/fused` `/scan` `/tf` `/tf_static` `/robot_description` 7개 화이트리스트 |
| 읽기 인증 | **없다** |

젯슨이 **공인 IP**에 있어 LAN과 인터넷이 같은 인터페이스다. "LAN에서만 열기"라는 선택지가 없으므로, 위 7개 토픽은 브릿지가 떠 있는 동안 인터넷에서 누구나 읽을 수 있다. **명시적으로 수락한 위험**이다.

**노출 구간은 "볼 때만"이 아니라 스택이 떠 있는 동안 전부다 (2026-08-06 정정, S15P11A301-295).** v2.0-r16까지 이 자리에 "볼 때만 켜고 보고 나면 `viz_down.sh`로 끈다"가 완화로 적혀 있었는데, 그 완화는 **적용할 수 없다.** 8.6이 말하는 대로 관제 웹의 실시간 지도가 이 브릿지에 직접 붙기 때문이다. 즉 끄는 것은 노출을 줄이는 행동이 아니라 **관제 지도를 끄는 행동**이다. 실측으로도 확인했다 — `demo.launch.py`의 `enable_viz` 기본값이 `true`이므로 스택이 뜨는 순간 8765가 `0.0.0.0`에 열린다(사람이 `viz_up.sh`를 부르지 않는다). 서비스를 `enable` 해 둔 동안에는 부팅만으로도 열린다 — 다만 `enable` 여부는 가변 상태이며 2026-08-11 확인 시점에는 `disabled`다(37-3 기본 비활성 원칙).

완화가 사라진 것이 아니라 **처음부터 다른 것이었다.** 실제로 범위를 좁히고 있는 것은 위 표의 세 줄이다 — 쓰기 차단, 토픽 7개 화이트리스트, TLS. 카메라 영상은 화이트리스트에 없으므로 유출 범위는 지도·로봇 위치·스캔·TF이며 개인정보나 조작 권한이 아니다. 없는 것은 **인증 하나**다(06장 36-4가 MVP 범위 외로 결정).

`viz_up.sh`·`viz_down.sh`의 역할도 그에 맞게 읽는다. **노출을 줄이는 수단이 아니라 스택을 재시작하지 않고 브릿지만 붙이거나 떼는 수단**이다. 스택 재시작은 메모리에만 있는 SLAM 지도를 잃기 때문에(S15P11A301-171) 이 구분이 실질적이다. 운영하지 않는 시간대에 떼어 두는 것은 여전히 유효하다.

`viz_up.sh --local`(127.0.0.1)은 그 경우만 `ws://`다 — 인증서가 도메인 이름으로 발급되어 `wss://localhost`는 이름이 맞지 않는다. **다만 이 모드에서는 관제 웹의 실시간 지도가 동작하지 않는다.** 브라우저가 다른 기기에 있으면 루프백에 닿을 수 없고, 그 기기에서 SSH 터널로 볼 때만 쓸 수 있다. 시연 중에 노출을 줄이려고 이것을 쓰면 지도를 잃는다.

## 8.6 관제 웹의 실시간 지도 (v2.0 신설, S15P11A301-227)

**v1.1의 전제가 깨졌다.** v1.1은 "점유격자를 실시간으로 관제까지 보내는 계약이 없다"를 전제로 지도를 임무 종료 후 PGM 조회로만 규정했다. 그러나 경로가 이미 있었다 — `foxglove_bridge`가 `/map`·`/pose`·`/pose/fused`를 WebSocket으로 내보내고 있었고, 관제 웹이 거기에 **직접** 붙는다.

```text
slam_toolbox map→odom ─┐
                       ├→ fused_pose_publisher (/pose/fused, 20Hz)
EKF odom→base ─────────┘                  │
                                         ↓
slam_toolbox /map·/pose  →  foxglove_bridge (wss)  →  관제 웹 브라우저
                                                        (백엔드를 거치지 않는다)
```

백엔드를 거치지 않는 이유는 telemetry 스키마에 격자 필드가 없고 지도 조회 API는 임무 종료 후 PGM뿐이어서, 그 둘로는 실시간이 되지 않기 때문이다.

- 브라우저가 CDR을 직접 디코딩한다(`frontend/lib/cdr.ts`, `occupancyGrid.ts`, `robotPose.ts`). `@foxglove/ws-protocol`은 쓰지 않는다 — 서브프로토콜이 다르다.
- **관제 화살표는 `/pose/fused`를 우선한다**(S15P11A301-305). 최신 `map→odom`의 SLAM 장기 보정과 최신 `odom→base_footprint`의 EKF(IMU) 회전을 합친 `map` 기준 pose다. 1초 동안 들어오지 않으면 기존 `/pose`로 자동 복귀한다. `/odometry/filtered`의 `odom` yaw와 `/pose`의 `map` 위치를 필드 단위로 직접 섞지 않는다 — `map→odom` 회전 보정이 빠져 지도와 화살표가 어긋난다.
- **화살표와 숫자는 같은 yaw를 사용한다**(2026-08-06 실차 정정). IMU·EKF 값은 REP-103을 유지해 반시계가 양수, 시계가 음수다. 초기 구현은 화면에서 `-yaw`를 한 번 더 적용해 실차 시계 방향 회전이 반시계로 보였고, `frontend/lib/mapHeading.ts`에서 센서 yaw를 같은 부호로 전달하도록 고쳤다. 관제의 「방위」도 같은 값의 degree 변환이므로 시계 방향 90°면 약 `-90.0°`여야 한다. `-90°`, `0°`, `+90°`, `±180°`, `±45°`는 단위 검사로 고정했다. **코드 반영은 완료됐고 재배포 후 실차 방향 재확인은 남아 있다.**
- 값 체계가 임무 이력 지도와 다르다. 라이브는 nav2 `int8`(−1 미탐색, 0~100 확률), 저장본은 PGM 바이트(0 점유, 254 자유, 205 미탐색)다. **판정 함수는 따로 두고 색과 좌표 변환은 공유한다**(`palette.ts`, `gridGeometry.ts`) — 규칙이 갈라지면 두 화면의 로봇 위치가 서로 반대로 찍힌다.
- **같은 네트워크에서만 보인다.** 영상(WHEP)이 이미 같은 제약이고 시연을 LAN 기준으로 정했다.
- **이 경로가 8.5의 노출을 하중 받는 것으로 바꿨다** (S15P11A301-295). 브릿지가 개발 도구였을 때는 "볼 때만 켠다"가 가능했지만, 관제 웹이 여기에 직접 붙는 순간 브릿지는 제품 구성요소가 되어 상시 떠 있어야 한다. 8.5의 완화 서술을 바꾼 이유이며, **브릿지를 끄거나 주소를 좁히는 변경은 이 화면을 깨뜨린다**는 것을 함께 기억한다.

# 14. 상태 머신 및 안전 정책 [확정]

> 이 장은 요약이다. 임무 상태 정의(14.1)와 상태 전이(14.2)의 규범(상세)은 **26장(Mission Manager·임무 상태 머신 상세 설계)** 이다. 단, 14.3~14.7(시작 전 점검·안전 우선순위·장애별 정책·배터리 정책[폐기]·종료 안전)은 이 장이 고유 규범이다.

핵심 결정:

- 임무 상태는 12개로 확정한다(26.2): `SAFE_IDLE`, `EXPLORING`, `PERSON_APPROACHING`, `INTERACTING`, `POST_RECORDING`, `REPORTING`, `PAUSED`, `MANUAL`, `RETURNING`, `COMPLETED`, `ESTOP`, `ERROR`.
- `OFFLINE`은 서버가 관측한 연결 상태이며 Jetson 내부 임무 상태로 사용하지 않는다.
- MANUAL 진입은 SAFE_IDLE·PAUSED·COMPLETED에서 허용하고, 주행 중 수동 전환은 PAUSED를 자동 경유한다(14.2, 26.3).
- 안전 우선순위의 실질 최상위는 **ESP32 watchdog 300ms 와 수동 250ms TTL** 이다(14.4·14.7). 종전 최상위로 적혀 있던 물리 E-Stop 은 **미도입으로 끝났다**(03장 34-10). **배터리 정책은 v2.0 에서 폐기했다**(14.6).

## 14.1 로봇 상태

상태 정의의 규범은 **26.2**다. 12개 상태명은 다음과 같다.

`SAFE_IDLE`(초기화 완료, 명시적 시작 대기) · `EXPLORING`(Frontier 기반 탐사) · `PERSON_APPROACHING`(피해자 그룹 관측 위치로 저속 접근) · `INTERACTING`(피해자 음성 확인, 정지) · `POST_RECORDING`(상호작용 종료 후 3초 녹화) · `REPORTING`(encounter·피해자·미디어 로컬 저장·보고) · `PAUSED`(탐사/복귀 일시정지) · `MANUAL`(모바일 앱 직결 수동 조종, 폰 deadman) · `RETURNING`(home pose 복귀) · `COMPLETED`(임무 정상 종료) · `ESTOP`(비상 정지 latch) · `ERROR`(핵심 센서·제어 오류)

각 상태의 설명·이동(모터) 허용 조건은 26.2 표를 따른다.

## 14.2 상태 전환

전이도의 규범은 **26.3**(mermaid 전이도)이다. 요약 수준에서 지켜야 할 핵심 규칙:

- MANUAL 진입은 **SAFE_IDLE, PAUSED, COMPLETED에서** 허용한다. 주행 중(EXPLORING) 수동 전환 요청은 자동 일시정지(→PAUSED)를 거친 뒤 MANUAL로 진입한다. UI의 "수동" 버튼 하나가 이 2단 전이를 내부적으로 처리한다.
- **진입 트리거는 둘이다** (S15P11A301-298).
  1. **모바일 조작 → 보드 래치 → 젯슨 추종.** 사람이 폰으로 조종을 시작하면 모터 ESP32 가 스스로 액추에이션 권한을 래치하고(deadman 이 눌린 패킷 2개·100ms 지속), 젯슨은 `DRIVE_STATE.state == MANUAL_ACTIVE` 를 보고 따라간다. 젯슨이 허가하는 것이 아니라 **일어난 일을 따라가는 것**이다 — 폰이 보드에 직결하므로 젯슨은 그 조종 패킷을 볼 수도 막을 수도 없다.
  2. **관제 「수동」 버튼.** `SET_MODE(MANUAL)` 이 수락되면 같은 2단 전이를 한다.
- **MANUAL 종료는 관제 「자율」 한 방향뿐이며, 모터 보드가 거부할 수 있다.** 종전 문장의 「수동종료·조이스틱 해제 시」는 틀렸다 — deadman 해제는 종료가 아니고(바퀴만 0 이고 권한은 유지된다), 조이스틱 UI 자체가 삭제됐다. 착지점은 `PAUSED` 이며 탐사 재개는 반드시 운영자의 명시적 재개 명령으로만 이루어진다(자동 재출발 금지, SR-008). 보드가 최근 500ms 안에 수동 입력을 봤으면 거부하고 `MANUAL_INPUT_ACTIVE` 로 회신한다.
- **수동을 벗어나지 *않는* 것들**(전부 바퀴만 0 이고 `MANUAL_ACTIVE` 유지): 모바일 「정지」/Space·Esc/창 blur, deadman 해제, 수동 TTL(250ms) 만료, WiFi 끊김, 관제·초음파 중계의 `STOP_COMMAND`, 젯슨 링크 사망(300ms 워치독), 젯슨 재접속(`HELLO`). 유일한 예외는 `ESTOP_COMMAND`(소프트웨어 latch)이며 그것은 수동 권한을 막는 게 아니라 **벗긴다**(래치·세션 파괴).
- 모든 상태에서 E-Stop은 ESTOP으로 전환한다. **ESTOP 해제 전이는 미구현**이며 현재는 latch된 노드를 재기동해야 벗어난다.
- REPORTING(로컬 저장 완료) 후 EXPLORING 또는 PAUSED로 복귀하고, RETURNING 경로 실패 시 PAUSED/ERROR로 전환한다.

## 14.3 시작 전 점검
> 아래는 **운영자 수동 점검 절차**다. `mission_manager`는 시작 명령에서 이 항목을 자동 preflight gate로 검증하지 않으며, 실패 시 시작을 차단하는 기능은 미구현이다.

| **분류** | **항목** | **실패 시** |
|---|---|---|
| 바닥 주행 공통 | Jetson, 모터·센서 ESP32 handshake, LiDAR, 카메라, 모터 드라이버, 엔코더, MPU6050, 전방 초음파, SLAM | 모터 활성화 차단. 물리 E-Stop 은 미도입이라 점검 대상이 아니다(03장 34-10) |
| 자율 탐사 추가 | Nav2 lifecycle 활성, 안전 체인, `/cmd_vel` 단일 발행자, TF 단일 발행자, 조향 중립·끝점. 초음파 중계 코드는 존재하지만 현재 발동 비활성 | 자율 탐사 시작 차단 |
| 보조 | 후방 초음파, 온습도, EC2, S3, 원격 스트림 | 경고 후 제한 운용 |

> 배터리는 계측 센서가 없어 자동 점검 항목으로 둘 수 없다. 후방 초음파는 `/range/rear`까지 구현됐지만 현재 보호 정지에는 참여하지 않으므로 보조 항목이다. MPU6050과 Nav2는 구현됐으므로 자율 주행 점검에서 제외하면 안 된다.

## 14.4 안전 우선순위
| **우선순위** | **제어원** |
|---|---|
| 1 | ~~물리 E-Stop~~ → 12V 배터리 분리(전용 스위치 미도입, 03장 34-10) |
| 2 | ESP32 fault·통신 watchdog·IWDT/TWDT  |
| 3 | 모터 드라이버 오류/하드웨어 fault |
| 4 | Collision Monitor. 초음파 근거리 정지는 현재 발동 비활성 |
| 5 | 소프트웨어 E-Stop |
| 6 | 모바일 수동 명령(모터 ESP32 직결) |
| 7 | 피해자 접근·자율 탐사. 자동 복귀는 미구현 |

> **이 표는 수동 명령에 대해서는 희망사항이다** (S15P11A301-298). 가장 중요한 정정이다.
>
> 행 4(Collision Monitor·초음파)와 행 5(소프트 E-Stop)는 표에서 수동보다 **위**에
> 있지만, 모바일 수동 명령은 폰 → 모터 ESP32 직결이라 **젯슨 체인을 아예 지나지
> 않는다.** 즉 두 층은 수동에 대해 **우회된다.**
>
> 수동 조종 중 실제로 적용되는 것은 1·2·3(전원 차단, ESP32 fault·watchdog, 드라이버
> fault)과 초음파 중계의 **순간 정지**뿐이다. 그 중계마저 순간 정지일 뿐이어서 다음 앱
> 패킷이 다시 굴린다(재-arm 규칙으로 완화하지만 완전한 보호는 아니다).
>
> 무엇이 보호하지 않는지의 전체 목록은 **06장의 「수동 조종 보호 공백」 표**에 있다.
> 요지는 하나다 — **수동 조종은 사람이 보면서 하는 조작이라는 전제 위에 있다.**

## 14.5 장애별 정책
| **장애** | **자율 탐사** | **수동 조종** | **저장/알림** |
|---|---|---|---|
| EC2 연결 단절 | 계속 | 즉시 정지 | 로컬 큐 저장  |
| S3 연결 단절 | 계속 | 계속 | pending 파일  |
| 로컬 영상 실패  | 계속 | 조종 제한 검토 | REMOTE 전환 |
| LiDAR 단절 | 즉시 정지 | 저속 수동만 또는 금지 | 치명 오류 |
| 오도메트리 이상 | PAUSED/ERROR | 저속 수동 가능 검토 | 오류 이벤트 |
| ESP32/모터 응답 없음 | 300ms 내 정지·ERROR/ESTOP | 불가 | 치명 오류 |
| 전방 초음파 단절 | PAUSED 또는 검증된 제한 속도 | 저속 수동만 검토 | 안전 센서 경고 |
| 카메라 단절 | 탐사 가능하나 사람 탐지 중단 | 영상 없는 수동 금지 권장 | 경고 |
| 온습도 단절 | 계속 | 계속 | 경고 |
| Jetson 과열 | 감속/복귀/정지 | 정지 | 임계값 기록 |

## 14.6 배터리 정책 [v2.0 폐기]

**배터리 기반 안전·종료 기능을 프로젝트에서 제외한다.**

계측 경로가 하드웨어에 없다. 모터 전원(유아전동차 내장 12V)과 Jetson 전원(대용량 보조배터리)이 완전히 분리돼 있고(21.4) 어느 쪽에도 전압·전류 센서가 붙어 있지 않다. 02장의 전압·전류 센서는 **권장** 항목이며 장착하지 않았다.

센서가 없으면 잔량을 알 수 없고, 알 수 없는 값으로 주행을 중단시키는 판정은 만들 수 없다. 임계값만 문서에 적어 두면 **없는 안전장치를 있다고 믿게 된다** — 이것이 폐기하는 이유다.

폐기 범위:

| 폐기 항목 | 원래 규정 |
|---|---|
| 잔량 30% 경고 / 20% RETURNING / 10% 안전 정지 | 14.6 |
| 배터리 20% 이하 탐사 종료 조건 | 8.1 탐사 종료·복귀, 23.4 |
| `/battery_state` 토픽 (1~2Hz) | 22.2 센서 수집 |
| 관제 화면 배터리 표시 | 11.5 (S15P11A301-223 에서 이미 제거) |
| 저전압 복귀 (R-09 완화책) | 01장 위험 관리 |

배터리 기반 종료는 제거됐고, **현재 구현된 종료 조건은 운영자 STOP 하나뿐이다.** Frontier 소진과 최대 7분 자동 종료는 설계에만 남아 있고 실행 분기·파라미터가 없다. 시연 전 배터리 충전·전압을 사람이 확인하는 운영으로 대체한다(38장 시연 체크리스트).

> **구현은 운영자 종료 하나뿐이다** (S15P11A301-274, 2026-08-05 확인).
>
> * **7분 타임아웃 — 미구현.** `mission_state.tick()` 은 `POST_RECORDING` 3초와 최대
>   상호작용 시간만 다루고 탐사 경과를 재지 않는다. `max_explore_seconds` 류
>   파라미터도 없다
> * **Frontier 소진 자동 종료 — 넣지 않기로 했다.** 아래 근거
> * **운영자 종료 — 동작한다.** 관제의 「임무 종료」 버튼이 `STOP` → `MISSION_COMPLETED`
>   → `COMPLETED` 로 보낸다
>
> **자동 종료를 넣지 않는 근거.** 지도 완성을 수색 완료로 쓰면 안 된다.
> `exploration_node.py` 가 「frontier 소진은 지도 완성이지 수색 완료가 아니다」로
> 적어 두었고, `coverage.py` 가 그 이유를 든다 — 라이다는 360°·원거리라 방 중앙을
> 한 번 지나가면 지도가 완성되는데 사람을 찾는 것은 **전방 약 52° 카메라**다.
> frontier 만 좇으면 지도는 완벽한데 구석에 쓰러진 사람은 화각에 한 번도 들어오지
> 않는다.
>
> `sweep.py`는 스텝-드웰 방위를 **계획만** 하며 실제 회전 명령·드웰 타이머 실행부는 미구현이다. 현재는 도착 yaw를 미관측 방위로 고르고, 저각속 주행 중의 부채꼴을 연속 마킹한다. 종료 판정을 넣는다면
> frontier 소진이 아니라 커버리지 충족이 기준이어야 하며, 그것은 실차 검증이
> 필요한 크기다.
>
> 7분 타임아웃도 넣지 않았다. 시연 중 예상치 못한 시점에 임무가 끝나는 위험만
> 늘린다 — 사람이 진행을 통제하는 편이 안전하다.

**과열 보호는 남는다.** Jetson 온도는 실제로 읽을 수 있고(`/sys/devices/virtual/thermal`) telemetry 에 이미 실려 있다. 14.5 의 과열 대응(감속/복귀/정지)은 유효하다.

되살리려면 전압 센서 장착이 선행이다(TBD-HW-003). 그때 이 절을 다시 쓴다.

## 14.7 프로그램 종료 안전
- 모든 모터 제어 코드는 try/except/finally와 SIGINT/SIGTERM 종료 처리를 포함한다.
- 노드 종료 시 마지막 명령과 관계없이 0 속도를 전송한다.
- Jetson Safety Gate와 ESP32 통신 watchdog은 각각 300ms 동안 유효 명령이 없으면 정지한다.
- ESP32 부팅·재부팅 중 PWM 0과 모터 드라이버 비활성화를 기본 상태로 둔다.
- E-Stop 해제는 주변 안전 확인 팝업과 물리 상태 확인 후 수행한다.

임무 상태 머신의 단일 권한 원칙·상태 정의·전이도·명령 멱등성·이벤트 우선순위 상세는 26장을 따른다.

# 22. 센서 수집·시간 동기화·좌표계 상세 설계

## 22.1 핵심 원칙

SLAM, 사람 위치 추정, 영상 이벤트를 같은 사건으로 연결하려면 센서 데이터의 **좌표계와 시각**이 일치해야 한다. 모든 데이터는 ROS 2 timestamp를 포함하고, 기록용 wall clock과 제어용 monotonic clock을 구분한다.

## 22.2 센서별 처리

| 센서 | ROS 2 출력 | 권장 주기 | 핵심 검증 | 실패 영향 |
|---|---|---:|---|---|
| 2D LiDAR | `/scan` | 약 11.03Hz 실측 | X4 Pro, 128000bps, 약 1222~1231 points/scan, `lidar_link`, 0.1~12.0m, drop | 자율주행 중단 |
| 카메라 | `/camera/image_raw/compressed` | 29.93 FPS 캡처 실측 | 1280×720 MJPEG, ROS 2 동시 구동·지연·단일 open | 사람 탐지·수동 영상 제한 |
| 차체 IMU(센서 ESP32 경유) | `/imu/data_raw` | **90Hz 실측** (펌웨어 100Hz, 송신 주기 합병으로 조금 낮다) | MPU6050 I2C `0x68`, `imu_link`, rad/s·m/s², bias, ESP32 측정 timestamp·sequence, stale/NaN | 오도메트리 품질 저하 또는 AUTO 중지 |
| 구동 엔코더(좌·우) | `/wheel/odometry` | **50Hz 실측** | 좌·우 부호·tick·overflow·속도 | 위치 추정 실패 |
| 전방 초음파 | `/range/front` | **15.1Hz 실측** | 유효 거리·timeout·실차 정지거리. **탐지 가능 범위가 20cm 급이다 — 아래 실측 참고** | 거리 표시·기록용. 빈 공간 오측 때문에 ESP32 보호 정지 발동은 2026-08-09 비활성화(S15P11A301-353) |
| 후방 초음파 | `/range/rear` | 약 15Hz 설정(전방 다음 순차 측정) | HC-SR04, `ultrasonic_rear_link`, timeout·`valid_sensor_mask` bit1·실차 거리 보정 | 관측 경로 구현. 후방 `protective_stop`과 Nav2 후진 제한은 미구현 |
| DHT11 온습도 | `/environment/temperature`·`/relative_humidity` | 0.5Hz (펌웨어 `DHT_INTERVAL_MS=2000`) | **유효 범위 습도 20~90%(±5%)·온도 0~50°C(±2°C)**, checksum·timeout·센서 끊김. 읽기 실패 시 브리지가 **발행을 건너뛴다** — 보드가 마지막 정상값을 들고 있어 그대로 내보내면 오래된 값이 새 측정처럼 보인다. 실패는 `/diagnostics` 의 `esp32_bridge: ENVIRONMENT` 항목이 수신·발행·드롭 수로 드러낸다(S15P11A301-323). **보드의 `ENVIRONMENT_SENSOR_FAULT` 만으로는 안 된다** — 그 비트는 연속 3회 실패에만 뜨고 성공 한 번이면 리셋되므로, 간헐 실패는 fault 0 인 채로 값만 사라진다 | 경고만 발생 |

> **DHT11 읽기 실패율 18.5% 는 수용한다** (2026-08-04 실측: 130초·고유 읽기 65회 중
> TIMEOUT 12회, 최대 연속 실패 1회, 읽기 주기 0.499Hz 로 펌웨어 설정과 일치).
> 1-wire 타이밍이 원래 이렇고 고칠 대상이 아니라는 판단이다. 근거 셋.
>
> * 센서 자체는 정상이다 — 성공 읽기값이 온도 24.3~24.4°C·습도 60~61% 로 안정적이다
> * **화면이 틀리지 않는다.** 브리지가 실패 시 발행을 건너뛰므로 오래된 값이 새
>   측정으로 보이는 일이 없다
> * 실효 갱신율이 0.5Hz → 0.41Hz 로 떨어질 뿐이다. 온습도 표시에서 이 차이는 의미가
>   없고, 명세도 보조 센서(경고만 발생, 탐사 계속)로 규정한다
>
> 이 조건(센서 장착·간헐 실패)에서는 연속 실패가 최대 1회라
> `ENVIRONMENT_SENSOR_FAULT`(임계 3)가 뜨지 않는다. 간헐 실패의 흔적이 진단에
> 남지 않는 것을 알고 수용하는 것이다.
>
> **다만 이것은 "이 플래그가 안 뜬다" 는 뜻이 아니다.** 같은 날 온습도 센서를
> 분리한 상태에서 **정상 발화를 확인했다**(S15P11A301-258).
>
> | 조건 | `ENVIRONMENT_SENSOR_FAULT` | `/environment/*` |
> |---|---|---|
> | 센서 장착, 간헐 실패 18.5% (연속 최대 1회) | 0 — 안 뜬다 | 0.41Hz 로 계속 나온다 |
> | 센서 분리 (연속 실패 계속) | **1** — `board_state=DEGRADED` | **발행 없음** |
>
> 분리 상태에서 같은 보드의 IMU 는 90.6Hz, CRC 오류 0, 프레임 유실 0, 핸드셰이크
> 안정이었다. 즉 fault 가 통신 문제로 번지지 않고 DHT11 경로만 짚었다. 화면에
> 값이 사라지는 것이 **설계대로 맞는 동작**이다 — 보드가 마지막 정상값을 들고
> 있으므로 발행을 계속하면 낡은 값이 새 측정으로 보인다. 주행은 `DEGRADED` 를
> 허용하므로 센서 없이도 탐사가 계속된다.
>
> 플래그는 sticky 가 아니다. `sensor_task.cpp` 가 **성공 읽기 한 번에 해제**한다
> (`else if (dhtResult == OK)`). 센서를 다시 물리면 재부팅도 스택 재기동도 없이
> 2초 안에 복구되고, `ros2 topic hz /environment/temperature` 가 0.5Hz 를 내면
> 복구된 것이다. 반대로 플래그가 1 로 남아 있다는 것은 임계(연속 3회, 2s 주기라
> 6초 이상) 이후 **성공 읽기가 단 한 번도 없었다**는 뜻이다 — 간헐 실패와
> 완전 불통을 이 한 값으로 구별할 수 있다.
>
> 다시 재려면 **`sample_age_ms` 가 감소하는 순간만** 세야 한다. `comm_task` 가 마지막
> 상태를 재전송하므로 프레임을 그대로 세면 같은 읽기가 중복 집계된다(처음에 그렇게
> 세어 30% 로 잘못 보고했다).
| ~~배터리~~ | ~~`/battery_state`~~ | — | — | **v2.0 폐기 (14.6).** 전압·전류 센서를 장착하지 않았다 |

### 환경값 판정 임계 (v2.0-r3 신설, S15P11A301-214)

명세는 온습도를 "보조 센서, 경고만 발생"까지만 규정하고 임계값을 두지 않았다.
관제 화면이 쓰는 값을 여기서 확정한다. 구현은
`frontend/features/telemetry/environmentThresholds.ts` 이며 DOM 없이 시험한다.

| 항목 | 임계 | 근거 |
|---|---|---|
| 습도 상한 | **80%** | 데이터시트 상한 90 에서 오차 ±5 와 포화 여유를 뺀 값. 종전 85 는 경고 구간(85~90)이 오차 폭과 같아 실측이 그 구간에 있는지 판단할 수 없었다 |
| 온도 상한 | 40°C | 상한 50 에서 여유 10 (오차 ±2 의 5배). 화재 근처를 알리는 목적 |
| 온도 하한 | 5°C | 하한 0 에서 여유 5 |

#### 임계값만으로는 범위 밖이 침묵한다

DHT11 은 습도 90% 를 넘으면 그 값을 읽지 못한다. 실제로 95% 여도 90 근처를
보고하거나 읽기에 실패하므로, 임계값만 두면 화면이 "90.0%" 를 **정상 측정값처럼**
보여주고 보는 사람은 그것이 상한이라는 사실을 모른다.

그래서 판정을 두 단계로 둔다.

1. **포화** — 값이 유효 범위 끝에서 오차 폭 안에 들면 `≥90` 처럼 **부등호로**
   표시하고, "DHT11 측정 한계 — 실제는 더 극단일 수 있습니다" 를 함께 적는다.
   부등호만 있으면 배선 문제로 오해한다.
2. **경고** — 범위 안에서 위 임계를 넘는다.

**포화는 그 자체로 경고다.** 습도 하한에서 이것이 특히 중요하다 — 경고가 상한만
보므로(>80), 포화 절이 없으면 건조 극단(≤22%)이 조용히 지나간다.

2026-08-04 실측(정지·실내): 온도 24.3°C, 습도 61.0~62.0%. 두 값 모두 경고
구간에서 멀어, 평상 조건에서 경고가 뜨지 않는 것을 확인했다.

### 전방 초음파 실측 — 20cm 급 근접 센서다 (S15P11A301-272)

2026-08-05, 실내·물체 고정·발행 15.1Hz. 임계값은 센서 ESP32 펌웨어가 로컬로
판정하며 이 측정이 **첫 확인**이다(TBD-CAL-001 이 비워 두었던 값).

| 항목 | 실측 |
|---|---|
| `protective_stop` 발동 거리 | **0.15~0.18m** |
| 측정 유효 범위(실측) | 0.028~2.994m |
| 신호 유지 | 8~10cm 고정 9초간 연속 `True`, 전환은 진입·이탈 2회뿐, `inf` 0개 |

**거리에 따라 탐지율이 무너진다.** 초당 유효 표본 수를 세었다(정상이면 15개):

| 거리 | 초당 유효 표본 | 탐지율 |
|---|---|---|
| 0.08~0.11m | **15/15** | 100% |
| 0.43~0.65m | 3~7/15 | 20~45% |
| 1.39~1.41m | 1~4/15 | 7~27% |

1.4m 에서 여덟 번 중 일곱 번을 놓친다. HC-SR04 를 이 위치에 이 각도로 붙인
결과이며, **이 센서는 20cm 미만에서만 신뢰할 수 있다.**

**임계값은 올리지 않는다.** 0.43m 에서 이미 탐지율이 20~45% 이므로, 임계를 그쪽으로
올리면 놓치는 비율이 그대로 오판이 된다. 없는 보호를 있다고 믿는 것보다 좁은 보호를
정확히 아는 쪽이 낫다는 판단이다.

따라서 역할은 이렇게 갈린다. 이 구분을 흐리면 초음파가 제공하지 않는 보호를
기대하게 된다.

| 층 | 담당 | 거리 |
|---|---|---|
| **주 방어** | LiDAR → `collision_monitor` 정지 구역 | 정지 x −0.35~+1.05(범퍼 앞 0.25m)·y ±0.33, 감속 x −0.55~+1.30·y ±0.40 — 실측 차체 기준 (24.1, S15P11A301-356·358) |
| ~~접촉 직전 방어~~ | 초음파 → `protective_stop` → `STOP_COMMAND` 중계. **2026-08-09 발동 비활성**(S15P11A301-353, 전방 센서 오측 — 03장 참고). 코드는 전부 남아 있고 신호만 영구 `false` 다 | ~~0.15~0.18m~~ |

정상 상황에서는 라이다가 먼저 멈추므로 초음파가 발동할 일이 없다. 발동했다면
**라이다가 놓친 것**(반사가 약한 표면, 스캔 평면 밖의 낮은 장애물)이며 이미 로봇
차체 치수 안쪽이다. 0.30m/s 에서 0.15m 는 0.5초이고 거기에 중계 지연과 감속이
더해지므로, 이 층은 충돌을 없애는 것이 아니라 **충격을 줄이는 것**이 목적이다.

## 22.3 TF 좌표계

```mermaid
flowchart TB
    map --> odom
    odom --> base_footprint
    base_footprint --> base_link
    base_link --> imu_link
    base_link --> lidar_link
    base_link --> camera_link
```

- `map → odom`: SLAM Toolbox가 전역 보정을 제공한다.
- `odom → base_footprint`: 엔코더·IMU EKF가 연속적인 로컬 자세를 제공한다.
- 짐벌은 미사용 확정(6.4장)이므로 `lidar_link`·`camera_link`는 `base_link`의 자식이며 **static TF**만 사용한다.
- 고정 센서(IMU 등)도 static TF를 사용한다.
- TF가 미래 시각이거나 허용 지연을 넘으면 사람 map 좌표 확정을 보류한다.

## 22.4 시간 정책

| 목적 | 시계 | 이유 |
|---|---|---|
| 이벤트·영상·DB 정렬 | UTC wall clock | Jetson·EC2 간 비교 가능 |
| 명령 TTL·watchdog | monotonic clock | NTP 보정이나 시간 점프 영향 방지 |
| 파일명·로그 | UTC + missionId | 시간대 혼동과 충돌 방지 |

Jetson은 **`systemd-timesyncd`(NTP)** 로 시각을 동기화한다(실기 확인: `timesyncd` active·`chrony` 미설치·미사용). 이 젯슨은 RTC 백업 배터리가 없어 부팅마다 시계가 두 번 점프하므로, 스택은 `time-sync.target` 뒤에 두고 `systemd-time-wait-sync`를 `enable` 해야 한다 — 그 사이에 뜨면 두 번째 점프가 TF 캐시·스트림 타임아웃·ESP32 워치독을 한꺼번에 부순다(06장 37-3-1). 메시지에는 `occurredAt`과 서버의 `receivedAt`을 분리해 기록하며, 시간 오차가 임계값을 넘으면 관제에 경고한다.

## 22.5 센서 품질 게이트

센서 메시지가 존재한다는 이유만으로 정상으로 판정하지 않는다.

```text
최근 수신 시각
+ 실제 주기
+ 값 범위
+ frame_id
+ timestamp 지연
+ 변화량/고정값 여부
→ OK / DEGRADED / FAILED
```

LiDAR, 엔코더, ESP32(모터·센서), E-Stop, TF가 FAILED이면 자율 임무를 시작할 수 없다. 카메라가 FAILED이면 사람 탐지와 영상 기반 수동 조종을 차단하되 저속 지도 탐사 허용 여부는 운영자가 결정한다.

# 23. SLAM·위치 추정·미지 영역 탐사 상세 설계

## 23.1 권장 파이프라인

```mermaid
flowchart LR
    encoder["엔코더"] --> esp32["센서 ESP32<br/>공통 측정 시각"]
    imu["MPU6050"] -->|"I2C 400kHz"| esp32
    esp32 --> bridge["esp32_sensor_bridge<br/>/wheel/odometry·/imu/data_raw"]
    bridge --> ekf["robot_localization EKF"]
    ekf --> odom["odom→base_footprint→base_link"]
    lidar["2D LiDAR"] --> slam["SLAM Toolbox"]
    odom --> slam
    slam --> map["map·map→odom"]
    map --> frontier["Frontier Explorer"]
```

**지도 수명 = 임무 수명이다 (2026-08-09, S15P11A301-362).** 지도가 임무를 넘어
살아남으면 두 번째 탐사가 frontier 즉시 소진으로 2초 만에 완료된다(실사례).
백엔드는 이미 임무마다 mapId 를 발급하므로 SLAM 만 어긋나 있었다. Humble
slam_toolbox 엔 리셋 서비스가 없어 **MISSION_START 새 임무 전이에서
mission_manager 가 slam 프로세스에 SIGTERM 을 보내고 launch 의 respawn 이 빈
지도로 되살린다**(`slam_reset.py`, `reset_map_on_start` 파라미터). 재시작 공백
3~4초는 탐사의 pose 대기가 흡수하고, map frame 원점은 시작 시점 로봇 위치가
된다 — 관제 지도가 시작 순간 새로 그려지는 것은 의도된 UX 다. **재개(RESUME)에는
걸리지 않는다** — 일시정지는 지도를 유지한다(37-3).

## 23.2 위치 추정 단계

1. 센서 ESP32가 후륜 좌·우 엔코더 tick·속도, 차체 IMU 원시 gyro·accel을 공통 monotonic 측정 시각과 sequence로 제공한다.
2. Jetson이 **후륜 좌·우 속도의 평균으로 선속도 `vx`** 를 계산한다. yaw rate는 엔코더에서 만들지 않는다(아래 「전륜 조향에서 yaw 를 어디서 얻는가」).
3. Jetson sensor bridge가 `/imu/data_raw`(`sensor_msgs/Imu`, `frame_id=imu_link`)를 발행하고, EKF가 wheel odometry와 IMU yaw rate를 융합한다.
4. SLAM Toolbox가 LiDAR scan matching으로 누적 오차를 보정한다.
5. Mission Manager는 TF 연속성과 covariance를 감시한다.

### EKF 융합 (S15P11A301-236)

파라미터는 `sentinel_bringup/config/ekf.yaml`, 실행은 `launch/ekf.launch.py` 다.
`demo.launch.py` 의 `enable_ekf` 는 **기본 false**다. MPU6050 축·장착 자세는 4기동
시험과 URDF로 확인됐지만, 펌웨어 주기 계산 수정 후 정지 bias·공분산·원주행을
재계측하기 전에는 데모 기본값으로 켜지 않는다.

**목적은 하나다 — 휠 오도메트리가 만들 수 없는 yaw 를 자이로에서 얻는다.**

> **2026-08-06 근거 갱신.** 종전 목적은 「캐스터 슬립이 갉아먹는 yaw 를 보정한다」였다. 전륜 서보 조향으로 전환하면서 캐스터는 없어졌지만 **결론은 바뀌지 않고 근거가 더 강해졌다** — 아래 「전륜 조향에서 yaw 를 어디서 얻는가」. 입력 성분 선택도 그대로다.

#### 무엇을 입력으로 쓰는가

| 입력 | 쓰는 성분 | 뺀 것과 이유 |
|---|---|---|
| `/wheel/odometry` (50Hz) | `vx` 만 | **위치(x·y·yaw)** — 브리지가 이미 적분한 값이다. EKF 가 하려는 적분을 입력으로 받으면 같은 오차를 두 번 믿는다. **`vyaw`** — 전륜 조향에서는 좌·우 후륜 속도 차로 yaw 를 만들 근거가 아예 없다(선회 중 후륜이 스크럽한다) |
| `/imu/data_raw` (90Hz) | `vyaw` 만 | **절대 yaw** — MPU6050 에 지자기계가 없어 절대 방위를 모른다. 브리지도 `orientation_covariance[0] = -1`(자세 추정 없음)로 표시한다. **선가속도** — 적분하면 오차가 제곱으로 커진다. 휠 오도메트리가 훨씬 낫다 |

**엔코더 `vyaw` 를 공분산 가중으로 낮추는 대신 아예 뺀 것이 요점이다.** 계통 오차는
백색 잡음이 아니라 선회 방향으로 치우치므로, 가중을 낮춰도 평균이 편향된 채 남는다.

`two_d_mode: true` 로 z·roll·pitch 를 0 에 고정한다. 켜지 않으면 IMU 노이즈가
pitch 로 새어 평지에서도 로봇이 기울어진 것으로 추정된다.

#### odom TF 3자 배타

이 TF 를 낼 수 있는 곳이 셋이라 `demo.launch.py` 가 구조로 하나만 남긴다.
`_effective_ekf = enable_ekf AND enable_esp32` 를 만들어, 보드 없이 EKF 만 켜는
조합을 걸러낸다(입력이 없으면 EKF 가 0 만 내고 그것이 TF 로 나가 로봇이 영원히
원점에 있는 것으로 보인다).

| `enable_esp32` | `enable_ekf` | 발행자 | 근거 |
|---|---|---|---|
| false | false | SLAM static identity | 보드 없음 — identity 로 SLAM 유지 |
| false | true | SLAM static identity | EKF 가 안 뜬다. 입력이 없으니 켜도 0 만 낸다 |
| true | false | `esp32_sensor_bridge` | 휠 오도메트리 단독 |
| true | true | **EKF** | 브리지 `publish_odom_tf` 가 꺼진다 |

`enable_esp32` 는 **사람이 기억할 값이 아니다.** `scripts/demo_up.sh` 가
`/dev/sentinel_mcu_sensor`(udev 별칭, S15P11A301-214) 존재로 판단해 붙인다
(S15P11A301-256). 인자로 명시하면 감지를 이긴다 — 보드 없이 켜서 아래 실패를
재현하는 것도 정당한 사용이다.

기본값을 `false` 로 둔 것과 감지를 넣은 것은 **같은 하나의 실패**를 막는다.
`enable_esp32:=true` 인데 보드가 없으면 static identity 가 꺼진 채로 브리지가
데이터를 못 받아 **위 표의 어느 행도 성립하지 않는다** — odom TF 발행자가 0개가
되고 `slam_toolbox` 가 "Failed to compute odom pose" 를 반복하며 지도를 만들지
않는다. 브리지는 죽지 않고 1초마다 재접속을 재시도하므로 프로세스도 토픽도
정상으로 보이고, 증상은 "지도가 안 나온다" 하나뿐이다. 반대로 보드가 있는데
`false` 면 `/environment/*` 가 조용히 안 나온다(S15P11A301-213 이 telemetry
값을 못 받던 원인). 어느 쪽이든 로그에 이유가 남지 않아서, 판단을 사람에서
장치로 옮겼다. 감지 결과는 기동 로그에 한 줄로 찍는다 — 조용히 달라지면
같은 종류의 오진이 된다.

감지가 못 막는 것이 하나 남는다. **주행 중** USB 재열거로 보드가 빠지면
static identity 는 이미 꺼져 있고 브리지는 TF 를 멈추므로 지도가 그 자리에서
얼어붙는다. 기동 시점 판단으로는 닿지 않는 런타임 문제다.

**절반은 막혔고 절반은 남았다.**

**막힌 쪽 — 브리지가 재열거에서 회복한다** (S15P11A301-264). 종전에는 `SerialTransport`
가 삭제된 fd 를 붙들고 무한 재시도했다. 실측으로 확인했다: USB 를 뽑았다 꽂으면
장치가 **다른 번호**(`ttyUSB2` → `ttyUSB0`)로 돌아오고 udev 심링크는 6초 안에 갱신되는데,
브리지는 100초 넘게 회복하지 않았고 PID 는 그대로였다(죽지도 않았다).

원인은 재연결 로직이 아니라 **그 경로의 로그 한 줄**이었다. `_log(level, msg)` 가 모든
심각도를 한 호출 위치에서 보내 rclpy 가 거부했고(`ValueError: Logger severity cannot be
changed between calls.`), 그 예외가 **리더 스레드를 죽여** 재연결 담당이 사라졌다.
이 종류는 조용하지 않다 — `HELLO 전송 실패` 가 6.7Hz 로 쌓여 로그가 6142줄이 됐다.
다만 그 경고는 원인을 짚지 못한다.

고친 것은 셋이다. 심각도별 로그 함수 분리, 리더 루프의 **전면 예외 격리**(회복 담당이
어떤 예외로도 죽지 않게), `write_frame` 의 쓰기 실패에서도 포트를 닫아 재연결을
시작시키기(리더 경로와 독립). 로그 폭주도 억제했다.

**남은 쪽 — TF 끊김 자체는 여전히 정지 조건이 아니다.** S15P11A301-237 안전 체인이
함께 잡을 것으로 적혀 있었으나, 구현된 `safety_gate` 의 정지 조건은 명령 TTL·임무
상태·초음파·`/scan` 신선도 넷이고 **TF 끊김은 없다**(24.1). `collision_monitor` 도 못
막는다 — `/scan` 자체는 계속 오므로 그쪽 판정은 통과한다. 브리지가 회복하는 동안
(재연결 지연 + 부팅 대기 약 2.5초)에는 여전히 지도가 얼어붙은 채로 낡은 costmap 을
보고 주행하는 구간이 있으며, 이 조건을 어느 층에 넣을지는 미정이다.

#### 실측 (2026-08-04, 정지·미장착 조건)

| 항목 | 값 |
|---|---|
| EKF 출력 주기 | 30Hz, 프레임 `odom → base_footprint`, `z=0` |
| EKF `vyaw` 추종 | −0.00164 rad/s (IMU −0.00151) — IMU 를 따라간다 |
| gyro 잡음 | 표준편차 0.00715 rad/s → 분산 5.1e-05 |
| **잔여 gyro bias** | **−0.00141 rad/s = −4.85°/분** |
| bias 이동 (12초) | 0.00011 rad/s |

**잔여 bias 가 yaw 표류로 그대로 간다.** `robot_localization` 의 15상태 모델에는
IMU bias 상태가 없어서 EKF 가 bias 를 추정하지 못한다. 펌웨어가 부팅 시 2초간
bias 를 재지만(200샘플) 온도에 따라 이후 이동한다 — 7분 임무면 약 −34° 다.

절대 방위는 `slam_toolbox` 의 `map→odom` 보정이 잡으므로 지도상 위치는 맞는다.
Nav2 의 local costmap·컨트롤러가 쓰는 `odom` 프레임에서는 **느린 일정 표류**가
남는데, 이는 슬립이 만드는 **불규칙한 튐**보다 추종에 훨씬 덜 해롭다. 그래서
EKF 를 켠 쪽이 낫다.

#### 기본값 재활성화 전 확인

기판 축과 장착 자세는 확인됐다. 펌웨어·배선·마운트가 바뀌었거나 EKF를 데모 기본값으로
올릴 때는 다음 회귀 시험을 다시 수행한다.

1. 정지 상태에서 `accel ≈ (0, 0, +9.8)` — 아니면 기판이 눕지 않았거나 축이 다르다
2. 로봇을 **손으로 들어 올려** 반시계로 돌린다 → `gyro_z > 0` 이어야 한다(REP-103).
   음수면 펌웨어의 `IMU_AXIS_SIGN[2]` 를 `-1.0f` 로 바꾼다. **자력 주행으로는 제자리 회전을
   할 수 없으므로**(전륜 조향) 이 확인은 손으로 한다
3. `δ_max` 원주행 한 바퀴(360°) 후 EKF yaw 와 실제를 비교, 엔코더 단독과 나란히 기록 (S15P11A301-248)

축 부호가 뒤집힌 채 켜면 **EKF 가 회전을 반대로 융합하고, 그 오류는 SLAM 이
`map→odom` 으로 덮어서 화면에 드러나지 않는다.** 회전할 때 위치가 밀리는 것으로만
보인다.

#### 관제 화살표 연동 확인 (S15P11A301-305, 2026-08-06)

EKF와 SLAM을 함께 켜면 `_effective_fused_pose = enable_ekf AND enable_esp32 AND
enable_slam` 조건으로 `fused_pose_publisher`가 뜨고 `/pose/fused`를 20Hz로 발행한다.
관제 웹은 이 토픽을 우선 사용한다. 장착 방향과 회전 부호 검증은 완료됐지만,
센서 펌웨어 수정 뒤 정지 표류율과 90°·360° 회전/원주행 재검증을 마칠 때까지
`enable_ekf` 기본값은 `false`를 유지한다.

```bash
ros2 topic hz /pose/fused
ros2 topic echo /imu/data_raw --field angular_velocity.z
ros2 run tf2_ros tf2_echo odom base_footprint
ros2 run tf2_ros tf2_echo map base_footprint
```

차체 전체를 위에서 내려다보고 시계 방향으로 약 90° 돌렸을 때 판정은 다음과 같다.
IMU 기판만 돌리면 LiDAR SLAM은 차체가 정지했다고 관측해 `map→odom`으로 상쇄하므로
관제 최종 자세 검증이 아니다. 반드시 IMU·LiDAR가 고정된 차체 전체를 함께 돌린다.

| 확인점 | 시계 방향 90° 기대값 |
|---|---|
| 회전 중 `/imu/data_raw.angular_velocity.z` | 음수 |
| `odom → base_footprint` RPY yaw | 약 −90° (EKF 누적각) |
| `map → base_footprint` RPY yaw | 약 −90° (SLAM 보정 포함, 실제각 기준) |
| 관제 「방위」 | 약 `-90.0°` |
| 관제 화살표 | 시계 방향 |

어느 단계에서 처음 부호가 바뀌는지로 수정 위치를 정한다. IMU부터 틀리면 펌웨어
`IMU_AXIS_SIGN[2]`, EKF부터 틀리면 `imu_link` 장착 RPY와 EKF 입력, TF는 맞는데
관제만 틀리면 `mapHeading.ts` 문제다. 원인을 확인하지 않고 ESP32와 프런트엔드 양쪽을
동시에 뒤집으면 숫자는 맞아 보여도 Nav2가 반대로 회전한다.

#### 전륜 조향에서 yaw 를 어디서 얻는가 (2026-08-06)

엔코더로 yaw 를 만드는 두 방법이 모두 성립하지 않는다.

| 방법 | 왜 못 쓰나 |
|---|---|
| 좌·우 후륜 속도 차 | 회두를 정하는 것은 조향 링크이고 후륜은 같은 속도로 구동된다. 선회 중 내·외측 후륜이 노면을 **스크럽**하므로 속도 차가 기하와 대응하지 않는다 |
| 조향각 기하 (`ω = v·tanδ/L`) | 조향각이 **개루프 목표값**이다(03장 34-5, 서보에 외부 각도 피드백이 없다). 타이어 슬립각·링키지 유격이 더해진다 |

그래서 **yaw 의 주 소스는 IMU 자이로 하나뿐이며, EKF 는 선택이 아니라 필수다.** 캐스터 시절에는 "오염된 값을 자이로로 보정한다"였고 지금은 "다른 소스가 없다"이다.

조향각 기하는 오도메트리 입력이 아니라 **진단**에 쓴다 — 기대 yaw rate와 IMU 실측이 어긋나면 조향 계통 고장이다(03장 34-9 `STEERING_RESPONSE_MISMATCH`).

실측 보정 대상은 직선 거리 스케일(좌·우 개별), 휠베이스 `L`, 조향각↔실제 yaw rate 스케일이다(03장 35-3). 저속·선회에서 바퀴 미끄럼이 크면 wheel odometry covariance를 보수적으로 설정한다.

> **`enable_ekf` 기본 false 의 의미가 무거워졌다.** EKF를 끄면 `esp32_sensor_bridge`가 후륜 속도 차로 만든 비교용 `vyaw`가 odom TF에 반영된다. 전륜 조향에서 근거가 없는 값이므로 **EKF를 끈 구성의 yaw는 주행 판단에 사용하지 않는다.**

## 23.3 Frontier 선택

Frontier는 탐색된 자유 공간과 미탐색 공간의 경계다. 후보는 다음 기준으로 점수화한다.

```text
score = 방위 이득 × (w_map × 지도 이득 + w_camera × 카메라 이득)
      - w_dist × (경로 길이 + R × |방위각 차이|)
      - w_visit × 방문 감점
```

위험도 항은 없고, 반복 실패는 점수 감점이 아니라 3회 후 blacklist 제외로 처리한다.

| 필터 | 규칙 |
|---|---|
| 크기 | `min_cells=6` 미만 Frontier 제거 |
| 경계·반경 | 격자 테두리와 home 반경 12m 밖 제거 |
| 대표점 | frontier 경계에서 자유 공간쪽으로 0.6m 후퇴 |
| 접근성 | Nav2 global plan 생성 불가 후보 제거 |
| 최소 거리 | 로봇에서 1.5m 미만 목표 제거 |
| 반복 실패 | 동일 좌표 반경 0.5m를 3회 실패하면 blacklist |
| 사람 상호작용 | `movementAllowed=false`인 INTERACTING 이후에만 HOLD. PERSON_APPROACHING은 이동 허용이어 신규 선택 중단이 보장되지 않음 |

> **구현 (2026-08-06, S15P11A301-172).** 「접근성」과 「반복 실패」를 Nav2 응답으로
> 판정한다. `ComputePathToPose` 로 미리 걸러내는 것이 아니라 **`NavigateToPose` 의
> 거부·실패를 사후에 기억한다.**
>
> | 결말 | 처리 |
> | --- | --- |
> | `SUCCEEDED` | 그 자리의 실패 이력을 지운다 |
> | `FAILED`(거부 포함) | 실패를 적립. 3회면 임무 동안 후보에서 제외 |
> | `UNAVAILABLE` | 액션 서버 없음. **실패로 세지 않는다** |
> | `CANCELED` | 우리가 취소한 것(게이트 닫힘·사람 발견) |
>
> **`UNAVAILABLE` 을 실패와 나눈 것이 요점이다.** Nav2 는 lifecycle 묶음이라 기동
> 후 활성까지 몇 초 걸린다. 그동안의 목표를 실패로 세면 블랙리스트가 정상 후보를
> 3회 만에 먹어치우고, 탐사가 시작도 못 하고 `DONE` 이 된다.
>
> 실패를 기억하지 않으면 **로봇이 영원히 안 움직인다.** 점수는 지도에서 나오므로
> 거부당한 후보가 다음 주기에 또 1위이고, 2초마다 같은 목표로 다시 보낸다. 특히
> `allow_unknown: false` 와 겹칠 때 잘 난다 — frontier 는 정의상 미지 공간의
> 경계여서 목표점이 미지 쪽으로 조금만 들어가도 전역 계획이 실패한다.
>
> 자리는 **좌표 반경 0.5m** 로 묶는다. 군집 식별자로 기억하면 지도 갱신마다
> 대표점이 몇 cm 움직여 같은 자리가 다른 목표로 보이고, 블랙리스트가 새어 나간다.
> 제외된 자리 수는 `~/status` 의 `blockedGoals` 로 나간다 — `DONE` 인데 이 값이
> 크면 「다 봤다」가 아니라 「못 갔다」다.

> **실기동 보정 (2026-08-09~10, S15P11A301-357·360·366·369).** 세 번의 실기동이
> 후보 선정에 네 가지를 더했다. 값의 근거는 코드 주석에 실측과 함께 있다
> (`selector.py`·`frontier.py`·`exploration_node.py`).
>
> * **전방 편향 2겹** — 방위각의 회전 호 비용(R·|Δθ|, R=1.8)을 거리에 가산하고
>   이득도 방위로 감쇠한다(전방 1.0 → 정후방 0.15). 거리 가산만으로는 카메라
>   이득(수십 점)에 파묻혀 목표 6개가 전부 후방으로 뽑혔다 — 전륜 조향 차량은
>   후방 목표에서 조향이 상한에 붙은 채 수렴하지 못한다
> * **약속 소멸 나이 가드(3초)** — 지도 2초 갱신마다 군집이 일시 소멸 판정을
>   받아 목표가 2~4초마다 갈렸다. 진짜 소멸이면 3초 뒤에도 소멸이다
> * **대표점 자유 공간 후퇴(0.6m)** — frontier 셀은 미지 경계라 costmap 에서
>   늘 고비용이다. 팽창 축소(0.35, 24.1)와 **곱해서** 계획 가능 목표를 3%→35% 로
>   올렸다 — 한쪽만 넣으면 효과가 없다(실측: 후퇴 단독은 0.6~2.0m 어느 값도 무효)
> * **최소 목표 거리(`min_goal_distance_m: 1.5`)** — R_min 1.69m 차량은 0.3~1m
>   목표에 어떤 호로도 닿지 못하는데, Nav2 는 그 목표를 거부하지도 실패시키지도
>   않아 blacklist 가 돌지 않는다. 실기동에서 0.36m 목표를 95초 붙들고 정지했다.
>   그 자리는 라이다 반경 안이라 버려도 지나가며 관측된다

## 23.4 탐사 종료 조건

**현재 구현된 종료는 운영자 STOP 하나뿐**이며 바로 `COMPLETED`로 간다. Frontier 소진·임무 시간·센서 실패 종료와 `RETURNING` 복귀는 설계만 있고 실행 경로가 없다.

> **v2.0: 배터리 복귀 임계값 조건을 뺐다.** 전압 센서를 장착하지 않아 잔량을 알 수 없다(14.6).

## 23.5 실패 복구

| 실패 | 1차 처리 | 2차 처리 | 최종 처리 |
|---|---|---|---|
| 목표 경로 생성 실패 | 후보 재샘플링 | 다른 Frontier 선택 | 운영자 목표점 |
| local planner 정체 | Nav2 recovery | **전·후진 선회 복구**(제자리 회전 `spin` 은 전륜 조향에서 불가 — 24.1) | PAUSED |
| 지도 중복·왜곡 | 정지 후 scan/TF 점검 | 저속 재시도 | 수동 모드 |
| localization lost | 즉시 정지 | 최근 신뢰 pose 재초기화 | ERROR |

## 23.6 복귀 3단 (v2.0 신설)

v1.1은 복귀를 한 단으로 규정했다 — home pose를 Nav2 목표로 보내고, 경로 생성이 실패하면 `PAUSED`로 전환해 관제에 복구를 요청한다. 즉 **포기한다.**

그 사이에 한 단을 넣는다.

| 단계 | 방법 | 성격 |
|---|---|---|
| 1 | home pose를 Nav2 목표로 전송 | 최단·빠름 |
| 2 | 실패 시 **빵조각 역추적** — 주행 중 기록한 pose를 역순으로 따라간다 | 느리지만 통행 가능이 보장됨 |
| 3 | 그것도 실패 시 `PAUSED` | 관제 개입 |

2단의 근거는 **이미 지나온 길이라 통행 가능이 실측으로 보장된다**는 것이다. 플래너가 지도만 보고 "지나갈 수 있을 것 같다"고 판단하는 것보다 강한 근거이며, 지도가 덜 차서 경로를 못 찾는 상황에서도 쓸 수 있다.

### 구현 시 반드시 지킬 것

**재생만 하면 안 된다.** 빵조각을 어느 프레임에 기록하느냐에 따라 다른 방식으로 틀린다.

| 기록 프레임 | 실패 양상 |
|---|---|
| `map` | 루프 클로저(`do_loop_closing: true`)가 포즈 그래프를 다시 풀면 과거 점이 통째로 어긋난다. 화면에는 로봇이 지도를 가로질러 순간이동한 직선으로 나온다 |
| `odom` | 자이로 잔여 bias(−4.85°/분)와 후륜 스크럽으로 드리프트가 누적된다. 몇 분 주행 뒤 기록된 출발점은 실제와 미터 단위로 어긋나고, 그대로 재생하면 벽으로 간다 |

어느 쪽이든 매 지점에서 현재 위치를 다시 확인하며 "다음 지점으로 간다"를 반복해야 하고, 그것이 `nav2_waypoint_follower`다. **역추적은 Nav2의 대안이 아니라 Nav2의 기능이다.**

**되도록 후진하지 않는다.** 라이다는 360°이고 후방 HC-SR04도 `/range/rear`로 관측되지만 후방은 `protective_stop` 판정에 포함되지 않는다. 전방 판정도 현재 오측 때문에 꺼져 있어 초음파 보호 정지 층은 어느 방향에도 없다. 후방 임계값과 안전 체인 통합을 실측해 확정할 때까지 이 절과 `behavior_server`의 `backup` 제한을 유지한다.

**다만 전륜 조향에서는 후진을 완전히 배제할 수 없다**(2026-08-06). 종전 이 문단은 "제자리 회전 후 앞으로 역순 주행한다"였으나 제자리 회전이 불가능해졌고, `R_min` 보다 좁은 곳에서 방향을 되돌리려면 **전·후진을 섞은 3점 선회**가 유일한 방법이다. 그래서 규칙을 이렇게 정리한다.

- 기본은 전진 선회로 방향을 바꾼다. `R_min` 안에서 가능한 경로를 먼저 찾는다.
- 그것이 불가능한 경우에만 후진을 쓰고, **후진 구간은 저속으로 제한하며 초음파 보호가 없다는 것을 전제로** 주행 전 라이다로 후방을 확인한다.
- 후진을 상시 허용으로 바꾸지 않는다 — 초음파 층이 눈을 감는 시간을 최소화하는 것이 이 규칙의 목적이다.

이 제약은 복귀뿐 아니라 23.5 정체 복구와 피해자 접근(좁은 공간에서 정면 확보)에도 그대로 적용된다.

**1단을 먼저 시도하는 이유.** Frontier 탐사 경로는 최단이 아니다. 같은 방을 여러 번 들를 수 있고, 그것을 역순으로 되짚으면 복귀에 탐사와 같은 시간이 든다. 플래너는 최단 경로를 준다.

# 24. Nav2 경로 계획·장애물 회피·안전 속도 설계

## 24.1 제어 명령 체인

```mermaid
flowchart TB
    global["Global Planner"] --> local["Local Controller"]
    local -->|/cmd_vel_nav| mux["command_mux<br/>(controlMode 로 선택)"]
    manual["수동 명령<br/>(발행자 없음 — 아래 참고)"] -.->|/cmd_vel_manual| mux
    mux -->|/cmd_vel_muxed| smoother["velocity_smoother<br/>가감속·속도 상한"]
    smoother -->|/cmd_vel_smoothed| collision["collision_monitor<br/>정지·감속 구역"]
    collision -->|/cmd_vel_safe| gate["safety_gate<br/>TTL·임무·센서 판정"]
    gate -->|/cmd_vel| kin["vehicle_kinematics<br/>v/ω → 후륜 속도 + 조향각 δ"]
    kin --> bridge["esp32_motor_bridge"]
    bridge --> esp32["모터 ESP32 100Hz 제어"]
    esp32 --> drive["BTS7960 ×2 → 후륜 RS540 ×2"]
    esp32 --> servo["조향 서보 → 전륜"]
    phone["모바일 앱<br/>(폰 핫스팟)"] -.->|HTTP 20Hz 직결| esp32
```

**`/cmd_vel_manual` 은 발행자가 영구히 없다** (S15P11A301-298). 폰이 자기 핫스팟 위에서
모터 ESP32 에 **직결**하고 젯슨과 관제 PC 는 별개 WiFi 망에 있어, 젯슨은 폰에 도달할 수
없다. 확정된 토폴로지이며 열린 문이 아니라 닫힌 문이다. 위 점선이 그 경로다.

따라서 **수동 명령은 이 체인을 한 층도 지나지 않는다** — 정지 구역도, 속도·가감속
상한도, 소프트 E-Stop 도 적용되지 않는다. 두 소스가 같은 모터를 다투는 것을 막는 것은
`command_mux` 가 아니라 **모터 ESP32** 다: 수동 패킷을 받는 순간 래치를 잡고 젯슨의
`DRIVE_COMMAND` 액추에이션을 거부하며, 젯슨은 `DRIVE_STATE` 를 따라간다.

보호 공백의 전체 목록은 06장의 「수동 조종 보호 공백」 표에 있다.

자율 명령은 모두 Safety Gate를 통과한다. E-Stop, watchdog, 센서 실패, 오래된 명령은
자율 경로 안에서 어떤 것보다 우선한다.

`command_mux` 층은 남긴다. 명세 24.1 이 두 입력을 요구하고, `controlMode` 로 자율
경로를 게이팅한다는 규칙 자체는 지금도 실제로 동작한다(수동일 때 `/cmd_vel_nav` 를
막는다). 언젠가 `/cmd_vel_manual` 을 채우는 사람은 **같은 커밋에서
`mission_state.MOVEMENT[MANUAL]` 도 바꿔야 한다** — 지금 그 값이 `false` 인 것은
자리표시자가 아니라 「젯슨에는 수동 속도 소스가 없다」는 사실이다.

**`velocity_smoother` 가 `collision_monitor` 앞이다.** 뒤에 두면 급정지 출력이
감가속 제한(`max_decel` −0.5m/s²)에 걸려 **천천히** 멈춘다. 비상 정지가 완만해지는
것은 안전 기능의 실패이므로 34-7 의 순서(이 순서)가 규범이다. 8.1 요약표와 03장
노드 흐름이 서로 다른 순서로 적혀 있었고 S15P11A301-237 에서 넷을 이 순서로 통일했다.

### planner 와 controller 의 역할

둘이 답하는 질문이 다르다. 내비게이션 앱에 견주면 planner 가 **경로 안내**이고
controller 가 **운전자**다.

| | planner_server | controller_server |
|---|---|---|
| 답하는 것 | "어느 길로 가나" | "지금 이 순간 바퀴를 어떻게 굴리나" |
| 입력 | 지도 + 현재 위치 + 목표 | planner 가 준 경로 + 현재 자세 |
| 출력 | 경로(점의 열) | 속도 명령 `cmd_vel`(v, ω) |
| 주기 | 1Hz 급 | 10Hz |

**나누어 둔 이유**는 두 질문의 변화 속도가 다르기 때문이다. 갈 길은 잘 바뀌지
않으니 무거운 전역 탐색을 드물게 하고, "지금 어떻게"는 바퀴 미끄러짐·지도 오차·
갑자기 지나가는 사람 때문에 계속 바뀌니 가볍게 자주 돈다. 로봇은 경로 선을
정확히 밟지 못하며, 그 편차를 메우는 것이 controller 의 일이다.

`behavior_server`(정체 시 복구 기동 — 전륜 조향에서는 `spin` 을 쓸 수 없다, 아래 「전륜 조향 전환의 Nav2 영향」), `bt_navigator`(셋을 지휘),
`waypoint_follower`(경유지 순차 — 23.6 복귀 2단 구현 시 사용 예정)가 함께 `lifecycle_manager`
아래 뜬다.

### 구성 확정 (S15P11A301-235)

파라미터는 `sentinel_bringup/config/nav2.yaml` 한 곳이고 `launch/nav2.launch.py`
가 띄운다. `demo.launch.py` 의 `enable_nav2` 는 **기본 false**다. 자원 계측은
완료됐고 탐지·전륜 조향 실기동도 수행했다. 다만 목표 15FPS와 동일 구성 3회 연속
최종 인수 기준은 통과하지 못했으므로 `enable_nav2` 기본값은 계속 `false`다.

| 항목 | 확정 | 근거 |
|---|---|---|
| global planner | **Smac Hybrid-A\*** (`REEDS_SHEPP`) | 2026-08-09 NavFn에서 전환(S15P11A301-358). 실측 회전반경을 경로 계획에 반영 |
| local controller | ~~rotation shim →~~ **RPP 단독** | 아래 "DWB 대신 RPP". **rotation shim 은 제거한다** — 제자리 회전을 지시하므로 전륜 조향에서 실행할 수 없다 |
| `allow_unknown` | **false** | 아래 "도달성 판정의 근거" |
| `controller_frequency` | 10Hz | 0.30m/s 에서 주기당 3cm 로 충분하다. Jetson 은 YOLO·SLAM·인코딩과 메모리 대역폭을 나눠 쓴다(8.1 LPDDR5) |
| `lookahead_dist` | 0.4m | RPP 가 경로 위 40cm 앞 점을 향해 간다. **`R_min` 실측 후 재검토** — 전방 주시 거리가 회전반경보다 짧으면 추종이 흔들린다 |
| ~~`angular_dist_threshold`~~ | **폐기** | shim 제거로 의미가 없다 |
| `use_rotate_to_heading` | **false** | RPP 가 경로 시작에서 제자리 회전으로 방향을 맞추려 하는 옵션이다. 켜면 로봇이 실행할 수 없는 명령을 낸다 |
| planner `minimum_turning_radius` | **1.8m** | 실측 좌 1.37m·우 1.76m의 안전측. RPP에는 동명 파라미터가 없고 Smac planner가 읽는다 |
| 속도 상한 | 0.30m/s · 0.6rad/s | 24.2 자율 탐사 행. 0.6 은 `behavior_server` 전용이고 `velocity_smoother` 각속도 상한은 1.0 이다 — 실효 상한은 **`v/R_min`** 이 만든다(03장 34-2). **사람 접근 0.25m/s 는 여기 두지 않는다** — 접근 노드(S15P11A301-247)와 안전 체인(237)의 몫이고, 두 곳에 두면 언젠가 한쪽만 바뀐다 |
| ~~`robot_radius`~~ → `footprint` | **다각형** `[[0.80,0.31],[0.80,-0.31],[-0.11,-0.31],[-0.11,0.31]]` | 원을 쓰지 않는다. `base_link` 원점이 **후축 중심**이라 몸집이 앞으로 크게 치우쳐 있어, 앞을 덮는 원은 뒤가 과대하고 뒤에 맞추면 앞이 벗겨진다. 앞 0.80·뒤 −0.11 은 차체 길이 0.91 과 휠베이스 0.683 에서 오버행을 반씩 본 **추정**이며 오버행 실측 시 두 값만 고친다 |
| `inflation_radius` | **0.35m** | 반폭 0.31 에 4cm 여유. **0.50 에서 내렸다**(2026-08-10, S15P11A301-366) — 좁은 시연 실내에서 0.50 은 `/map` 자유 셀의 31%를 치명으로 만들어 frontier 목표 101개 중 3개만 계획 가능했다(실측). 0.35 로 치명 셀 25%→10%, 계획 가능 목표 3%→35%. 충돌 방어는 collision_monitor 정지 구역이 최후선 |

#### 전륜 조향 전환의 Nav2 영향 (2026-08-06)

> **이 절과 아래 「곡률 상한」 절의 미결은 해소됐다.** 2026-08-09 에 `R_min` 실측(좌 1.37m·
> 우 1.76m, S15P11A301-341)이 들어와 planner 를 **Smac Hybrid-A\*(REEDS_SHEPP, 1.8)** 로
> 전환했다(S15P11A301-358). 현재 구성은 위 planner·controller 표가 규범이며, 아래 두 절은
> **그 판단에 이른 근거의 당시 기록**이다 — 「NavFn 을 유지했다」는 2026-08-06~08 시점의
> 서술이다.

캐스터 → 전륜 서보 조향 전환으로 **제자리 회전이 불가능해졌다**(02장 6.3). Nav2 구성에서 이것을 전제한 곳이 넷이고, 고치지 않으면 로봇은 실행할 수 없는 명령을 받고 멈춘 채 진단만 쌓는다(03장 34-2 거부 규칙).

| 대상 | 2026-08-06 당시 | 필요한 조치 | 안 고치면 |
|---|---|---|---|
| `rotation_shim_controller` | **제거됨**(S15P11A301-172) | — | 목표 방향이 45° 이상 틀어질 때마다 제자리 회전 명령이 나가고 로봇은 정지한다. 탐사가 첫 목표에서 멈춘다 |
| `behavior_server` 의 `spin` | **제외됨**(S15P11A301-172) | — | 정체 복구가 영구히 실패한다 |
| `behavior_server` 의 `backup` | 활성 | **유지하되 저속·거리 제한** | `/range/rear` 관측은 구현됐지만 후방 `protective_stop`은 없다. 임계·정지거리·안전 체인 통합 전까지 제한 유지 |
| global planner | NavFn | `minimum_turning_radius` 를 모델링하는 **Smac Hybrid-A\*** 전환 검토(`nav2_smac_planner` 설치됨) | 플래너가 차량이 못 도는 급커브 경로를 만들고 컨트롤러가 계속 이탈한다 |

#### 곡률 상한을 지키는 층은 Nav2 가 아니다 (2026-08-08, S15P11A301-348)

**RPP 에는 곡률 상한 기능이 없다.** 헤더의 `applyConstraints` 와 멤버 변수를 확인했다 — 곡률 관련 파라미터는 `regulated_linear_scaling_min_radius` 하나이고, 그것은 「급하면 **감속**」이지 「급한 것을 **금지**」가 아니다. 즉 Nav2 안에는 이 차량이 못 도는 곡률을 애초에 만들지 않게 하는 층이 없다.

| 층 | 곡률에 대해 하는 일 |
| --- | --- |
| NavFn | 회전반경을 **모른다** → 못 따라갈 경로를 낸다 |
| RPP | 그 경로를 따라가려 곡률을 명령한다 (**상한 없음**) |
| `vehicle_kinematics` | δ 를 δ_max 로 **클램프한다** ← 상한을 지키는 유일한 층 |

클램프 자체는 안전하다(조향각을 상한으로 자른다). 문제는 **상위가 그 사실을 모른 채 계속 무리한 곡률을 낸다**는 것이고, 그 대가가 2026-08-08 실기동 진단에 그대로 찍혔다 — `steering_clamp_count` **7224**, `spin_in_place_reject_count` **43**. 로봇은 조향을 최대로 붙인 채 넓은 호로 벌어지고, 목표에 수렴하지 못해 progress checker 가 15초 뒤 포기한다.

**이 층 구분을 모르면 「왜 경로를 못 따라가지」를 매번 다시 조사한다.** 근본 해법은 아래 planner 전환이며, 그 전까지는 이것을 알고 있는 것이 최선이다.

**Smac Hybrid-A\* 전환은 즉시 결정하지 않는다.** 근거가 갈린다 — 회전반경을 지키는 경로가 필요한 것은 분명하지만, Hybrid-A\* 는 파라미터가 훨씬 많고(`motion_model_for_search`·`angle_quantization_bins`·비용 항 여럿) Jetson 부하도 크다(자원 계측 S15P11A301-249 가 이미 병목이다). 실내 복도에서 `R_min` 이 충분히 작다면 NavFn 경로를 RPP 가 따라갈 수 있다. **판단 기준은 `R_min` 실측값 하나다** — 복도 폭 대비 `R_min` 이 크면 전환하고, 작으면 NavFn 을 유지하며 컨트롤러 이탈량을 실측으로 확인한다. 이 결정을 TBD-HW-008 실측에 붙인다.

**이 절의 조치를 `nav2.yaml` 에 반영했다 (2026-08-06, S15P11A301-172).** shim·`spin` 제거, `use_rotate_to_heading: false`, ~~`minimum_turning_radius: 1.69`~~(2026-08-08 제거 — RPP 가 읽지 않는다, S15P11A301-348), footprint 다각형, `inflation_radius: 0.50`(2026-08-10 에 0.35 로 재조정 — 위 표와 S15P11A301-366). `desired_linear_vel` 은 첫 실기동을 위해 0.15 로 낮춰 두었고, **2026-08-08 에 0.15 가 잠정이 아니라 기본으로 확정됐다**(S15P11A301-343) — 정지 마찰 경계(PWM 17~25%) 위에서 움직이는 최저 대역이면서 교실 시연에 적정한 속도다. 넓은 환경에서 정지거리 실측(S15P11A301-299) 후 24.2 상한 0.25 까지 상향을 검토한다. **2026-08-09 재확정: 기본 0.30**(S15P11A301-342) — 속도 보고 3.4배 결함(339)이 고쳐진 뒤 재보니 0.15 는 데드밴드(150mm/s) 경계라 실속도가 사실상 0 이었고, 0.30 이 명령=실속도 99% 에 체감 적정이었다.

**planner 는 NavFn 을 유지했다.** 위 판단 기준(`R_min` 실측)이 아직 없기 때문이며, 계산값 1.69m 만으로는 「복도 폭 대비 큰가」를 답할 수 없다. 그래서 **첫 실기동은 정면 직선 목표로 한다** — NavFn 이 직선 경로를 내고 RPP 가 따라가므로 회전반경 문제를 밟지 않고 체인 전체(Nav2 → `/cmd_vel_nav` → 안전 체인 → `/cmd_vel` → `vehicle_kinematics` → 바퀴)를 한 번에 확인할 수 있다. 옆·뒤쪽 목표에서 이탈이 보이면 그때 Smac 으로 전환한다.

**2026-08-09 그 전환을 했다 (S15P11A301-358).** `R_min` 실측(좌 1.37m·우 1.76m, 341)이 들어왔고, 실기동 두 번에서 NavFn 이 후방·측면 목표로 못 따라갈 경로를 내 조향이 상한에 붙는 대가가 관측됐다. `SmacPlannerHybrid`(REEDS_SHEPP, `minimum_turning_radius: 1.8` — 실측 안전측) + RPP `allow_reversing: true` 로 **후진이 계획에 들어왔다** — 계획 실측으로 비용 0 회랑에서 정후방 1.1m 목표가 전원 후진 포즈의 일직선 경로로 풀렸다. `allow_unknown: false`(23.3 도달성 결합)는 planner 를 바꿔도 유지한다. 복구 `BackUp` 속도도 0.05 → 0.25 로 올렸다(데드밴드 아래라 죽은 기능이었다). 막혔을 때의 실제 후진은 「직선 0.30m 복구」이며 후방은 확장된 정지 구역이 지킨다.

### 실측 기하 (2026-08-06)

| 값 | 실측 | 쓰이는 곳 |
|---|---|---|
| 휠베이스 `L` | **0.683 m** | 자전거 모델 `δ = atan(L·ω/v)`, `R_min` |
| 조향각 `δ_max` | **22°** (좌·우 동일) | 위와 같음. 펌웨어 클램프도 같아야 한다 |
| 트랙폭 `W` | 0.530 m | 오도메트리 스케일 |
| 전체 폭 | 0.615 m | footprint 반폭 0.31 |
| 차체 길이 | 0.910 m | footprint 앞·뒤 |
| 바퀴 지름 | 0.250 m | 거리 스케일, `base_footprint→base_link` z |
| **`R_min`** | 계산 1.69m; **실측 좌 1.37m·우 1.76m** | Smac `minimum_turning_radius=1.8`(안전측), 운동학 |

**종전 코드 기본값은 `wheelbase 0.50`·`δ_max 30°` 였고 그것으로 계산한 `R_min` 은 0.87m 다 — 실제의 절반이다.** 이 값이 작으면 자전거 모델이 `δ` 를 작게 계산해 **로봇이 지령보다 덜 꺾는다.** 경로를 벗어나는데 로그에는 아무 오류가 없다. `vehicle_kinematics` 는 어떤 launch 에서도 params 를 받지 않아 그 기본값으로 돌고 있었다(S15P11A301-298 이 노드를 체인에 넣었을 때 params 배선이 빠졌다). `config/safety.yaml` 의 `vehicle_kinematics` 절에 실측을 넣고 `safety.launch.py` 가 전달한다.

미측정·재검증으로 남은 것: 오버행(앞·뒤), 정지거리, 조향각↔실제 yaw rate, 링키지 유격, 좌·우 장거리 스케일과 IMU 360°·장기 재현성이다. `R_min` 원주행, 명령→실속도 운용점, IMU 90°·정지 bias 검증은 완료됐고 센서 위치·자세는 실측 URDF에 반영됐다.

#### `allow_unknown: false` 는 도달성 판정의 근거다

23.3 의 Frontier 접근성 필터가 "Nav2 global plan 생성 불가 후보 제거"다. 즉 탐사가
**플래너의 거부를 판정으로 쓴다.** `allow_unknown` 을 true 로 바꾸면 플래너가 미지
영역을 통과하는 경로를 만들어 주므로 **벽 뒤 후보까지 도달 가능으로 답하고**, 탐사는
갈 수 없는 목표를 계속 고른다.

증상은 "탐사가 이상한 곳으로 가려다 실패를 반복한다"로만 보인다. 이 한 줄을 바꿀
때는 23.3 의 필터를 함께 다시 설계해야 한다.

#### costmap 은 둘이다

| | global | local |
|---|---|---|
| 프레임 | `map` | `odom` |
| 소스 | `slam_toolbox` 의 `/map` (static layer) | `/scan` (obstacle layer) |
| 범위 | 지도 전체 | 3×3m 롤링 창 |
| 쓰는 곳 | planner | controller·behaviors |

static layer 는 `map_subscribe_transient_local: true` 여야 한다. `/map` 이
latched 발행이라, 이것을 켜지 않으면 **로봇이 정지해 있는 동안(지도 갱신이 없을
때) costmap 이 영영 비어 있다.** 같은 QoS 함정을 탐사 노드에서 먼저 밟았다
(S15P11A301-172).

#### cmd_vel 은 `/cmd_vel_nav` 로 나간다

24.1 체인이 Nav2 출력이 안전 체인을 거쳐 `/cmd_vel` 이 되기를 요구한다. 체인은
S15P11A301-237 에서 구현됐지만(`safety.launch.py`), `demo.launch.py` 의
`enable_safety` 는 **기본 false** 다. 즉 기본 구성에서는 `/cmd_vel_nav` 를 아무도
소비하지 않고 로봇은 움직이지 않는다 — 그것이 의도다. 트랙폭·바퀴 지름의 1차
실측과 센서 펌웨어 주기 수정, 서보-바퀴 링키지 상수는 반영됐고 단거리 거리 스케일도
줄자와 3% 안에서 일치했다. 좌·우 장거리 스케일·IMU·실제 회전반경 인수는 남았다.
체인을 켜는 순간 바퀴가 돌 수 있는 상태가 되므로 시작 전 점검을 마친 사람이 명시적으로 켠다.

체인 없이 Nav2 만 단독 검증할 때는 `nav2_cmd_vel_topic:=/cmd_vel` 로
`vehicle_kinematics` 에 직결하지만, 그때는 충돌 방지·TTL·임무 판정이 **전부 빠진다.**
그 구성이 "일단 되니까" 로 굳는 것을 막으려고 기본값으로 두지 않는다.

**`cmd_vel` 을 내는 노드가 둘이다** — controller 와 behaviors(spin·backup)다.
한쪽만 remap 하면 recovery 회전이 안전 체인을 우회해 모터로 직행한다. 둘 다
remap 한다.

#### 시연 시작 위치에는 클리어런스가 필요하다

실기동에서 로봇 0.2m 안의 물건 때문에 시작 셀이 inscribed cost(99)로 막혀 **로봇
기점 계획이 전부 거부됐다.** `robot_radius` 안쪽이 점유로 찍히면 플래너는 출발조차
못 한다.

시연 시작 위치는 **주변 20cm 이상을 비운다**(38장 체크리스트·S15P11A301-250).
`robot_radius` 실측이 확정되면 이 값도 함께 갱신한다.

### v2.0: Nav2 채택 확정 (TBD-NAV-001)

가능성 확인이 끝났다. 젯슨에 이미 설치돼 있다.

```text
navigation2                             1.1.20
robot_localization                      3.5.4
nav2_regulated_pure_pursuit_controller  설치됨
nav2_collision_monitor                  설치됨
nav2_velocity_smoother                  설치됨
nav2_smac_planner / nav2_navfn_planner  설치됨
```

우리 구성(2D 라이다 YDLIDAR X4 Pro + `slam_toolbox`)은 Nav2의 표준 구성이다. **다만 2026-08-06 전륜 서보 조향 전환으로 운동학이 차동 구동에서 Ackermann 근사로 바뀌었다** — Nav2 는 두 운동학을 모두 지원하지만 planner·controller·behavior 선택이 달라진다(위 「전륜 조향 전환의 Nav2 영향」).

**반응형 주행으로 대체할 수 없다.** 명세가 Nav2를 하중 받는 자리 세 곳에 쓰고 있다.

| 자리 | Nav2 없이는 |
|---|---|
| 23.3 Frontier 도달성 판정 ("Nav2 global plan 생성 불가 후보 제거") | 판정 자체가 불가능하다. 벽 뒤의 미지 영역을 목표로 잡고 계속 실패한다 |
| 23.5 정체 복구 ("Nav2 recovery") | 대체 구현이 필요하다 |
| 23.6 복귀 1·2단 | 전역 경로가 없으면 방 하나만 넘어가도 갇힌다. U자 공간에서 무한 왕복한다(local minima) |

**DWB 대신 Regulated Pure Pursuit 인 이유.** DWB 는 매 주기 수십 개 궤적을 시뮬레이션해 최적을 고르는데, 그 시뮬레이션은 "이 속도를 주면 로봇이 여기 간다"는 예측에 기댄다. **개루프 조향(서보에 각도 피드백이 없다)과 후륜 스크럽으로 그 예측이 어긋나면** DWB 는 계속 헛돈다. RPP 는 경로 위 앞쪽 한 점을 향해 가는 단순 추종이라 예측을 하지 않는다. EKF(8.2, S15P11A301-236)로 gyro 를 융합하면 오도메트리가 개선되지만, 컨트롤러 선택으로 먼저 완화한다.

> **2026-08-06: RPP 를 고른 결론은 유지하되 근거 한 줄이 바뀌었다.** 종전에는 "rotation shim 이 먼저 돌고 그다음 직진으로 만들어 캐스터 슬립을 줄인다"를 이유로 함께 들었으나, 전륜 조향에서는 shim 자체를 쓸 수 없다(위 영향 표). RPP 를 선택한 근거는 **예측에 기대지 않는다**는 첫 번째 이유 하나로 좁혀졌고, 그것만으로도 DWB 보다 낫다. 대신 `use_rotate_to_heading: false` 를 함께 둬야 한다 — RPP 자체에도 제자리 회전 옵션이 있다.

파라미터·costmap·remap 등 구성 상세는 위 「구성 확정」이다.

**축소판을 남긴다.** 시연까지 Frontier 점수화가 준비되지 않으면 목표 선택기만 사전 정의 순찰 시퀀스로 갈아끼운다. 목표 선택기를 인터페이스로 분리해 두면 "EXPLORING 이면 움직이고 아니면 멈춘다"는 동일하다. 그 판단은 S15P11A301-172 에서 한다.

**자원 계측은 완료됐고 결과가 기본값의 근거다.** Nav2 + `slam_toolbox` + YOLO + WebRTC 통합에서 탐지 성능이 목표 15 FPS에 못 미친 기록이 있고([07-AI-탐지.md](07-AI-탐지.md)), 전륜 조향 경로 추종은 실기동했지만 동일 구성 3회 연속 최종 인수는 미완료다. 그래서 `demo.launch.py`의 `enable_nav2` 기본값은 **false**다.

### 안전 체인 구현 확정 (S15P11A301-237)

`sentinel_safety` 패키지(`command_mux`·`safety_gate`)와 `sentinel_bringup/config/safety.yaml`
(nav2 두 층의 파라미터), `launch/safety.launch.py` 가 띄운다. **가운데 두 층은 만들지
않았다** — `nav2_velocity_smoother`·`nav2_collision_monitor` 1.1.20 이 이미 설치돼 있고,
직접 만들면 같은 일을 하는 코드가 둘 생긴다. 양 끝단만 우리 것이며 그 둘은 이
프로젝트 고유 판정(`controlMode`, 임무 상태·초음파·`/scan` 신선도)이 들어가기 때문이다.

**이 launch 가 없으면 바퀴가 돌지 않았다.** Nav2(235)는 `/cmd_vel_nav` 로 내고
`vehicle_kinematics`(234)는 `/cmd_vel` 을 구독하는데, 둘 다 머지된 상태에서 **이어 주는
것이 없었다.**

관통 실측(2026-08-05, 단독 구동·부하 0.5/6코어. 입력 `/cmd_vel_nav` 20Hz, `linear.x=0.10`·`angular.z=0.20`):

| 단계 | 토픽 | 실측 |
|---|---|---:|
| command_mux 출력 | `/cmd_vel_muxed` | 19.999Hz |
| velocity_smoother 출력 | `/cmd_vel_smoothed` | 19.995Hz |
| collision_monitor 출력 | `/cmd_vel_safe` | 19.999Hz |
| safety_gate 출력 | `/cmd_vel` | 19.996Hz |

`/cmd_vel` 에 `linear.x=0.1`·`angular.z=0.2` 가 그대로 도착했고(값이 실려 간다는 확인 —
20Hz 의 0 은 Hz 만으로는 구별되지 않는다), 게이트는 `blocked: false, reasons: []`,
`/cmd_vel` 발행자 수는 **1** 이었다.

상류를 끊으면 `/cmd_vel` 이 0 으로 떨어지면서 **20.000Hz 로 계속 발행된다**(침묵이
아니다 — 하류가 "명령 없음" 과 "정지 명령" 을 구별할 수 있어야 한다는 것이 이 체인
전체의 방침이다). 게이트는 `COMMAND_STALE` 등 이유를 `/safety/gate_state` 로 낸다.

**nav2 두 층은 lifecycle 노드다.** 띄우기만 하면 `unconfigured` 에서 "Waiting on external
lifecycle transitions to activate" 로 멈추고, 그 상태에서는 입력을 받아도 아무것도 내지
않는다 — 체인이 **가운데서 끊긴다**(2026-08-04 실측: 양 끝단은 20Hz 인데 사이 두 토픽이
침묵). 그래서 `lifecycle_manager_safety` 가 필요하고, 이름은 `nav2.launch.py` 의
`lifecycle_manager_navigation` 과 **달라야 한다**(같으면 두 관리자가 같은 서비스 이름을
다투고 승자가 기동 순서에 달린다).

관리자를 **3초 늦게** 띄운다. 다섯을 동시에 올렸을 때 `velocity_smoother` 가 configure 를
끝냈는데도 응답이 시각 안에 못 가 관리자가 실패로 보고 activate 를 보내지 않았다
(`failed to send response to /velocity_smoother/change_state`, 2026-08-04). 같은 기동에서
`collision_monitor` 는 `active` 였다 — 순서 운에 달린 경합이다. 원인은 CPU 포화
(로드 14/6코어, S15P11A301-249). 위 실측은 부하 0.5 에서 둘 다 `active [3]` 이었으므로
**지연이 충분하다는 것은 저부하에서만 확인된 것이다.** 시연 부하에서는 기동 후
`ros2 lifecycle get /velocity_smoother` 로 확인해야 한다.

`collision_monitor` 의 `base_shift_correction` 은 **끈다.** 켜면 스캔 시각 기준으로
`odom → base_footprint` 를 조회하는데 휠 오도메트리 TF 가 스캔보다 수십 ms 늦어
조회가 계속 실패했고, 그 상태에서 이 노드는 **아무것도 발행하지 않았다**(2026-08-04:
입력 18.33Hz 인데 출력 0.00Hz). 끄는 대가는 계산해서 받아들였다 — 보정 대상인 로봇
이동량이 체인 주기 50ms + TF 지연 20ms ≈ 70ms 에 0.30m/s 로 **2.1cm** 이고, 정지 구역
이 범퍼 앞 0.25m 라(실측 차체 기준, S15P11A301-356) 그 안에 든다. **속도 상한을 올리면
이 계산을 다시 해야 한다.**

`/scan` 이 낡으면 `collision_monitor` 는 그 소스를 **건너뛴다** — 즉 라이다가 죽으면
"장애물 없음" 과 똑같이 통과시킨다. `source_timeout` 을 줄여도 이 구멍은 막히지 않으므로
`/scan` 신선도는 `safety_gate` 가 따로 본다(`SCAN_STALE`). 막는 층이 다르다.

**초음파 보호정지 중계 코드는 이 체인 밖에도 경로가 하나 더 있다.** 게이트가 같은 신호로
`/cmd_vel` 을 0 으로 만들지만, 그것만으로는 브레이크·driver disable 이 걸리지
않는다. 명세 03-276 이 요구하는 `STOP_COMMAND` 중계는 `esp32_motor_bridge` 가
`/proximity/protective_stop` 을 **직접 구독해** 수행한다(S15P11A301-237). 게이트를
거치지 않는 이유는 지연(홉을 늘리지 않는다)과 독립성(게이트가 죽어도 보호정지는
전달돼야 한다)이며, 상세는 03장 「중계 구현」이다. 다만 현재 센서 펌웨어의
`PROXIMITY_STOP_ENABLED=false` 때문에 토픽 값이 항상 `false`라 두 경로 모두
초음파로 정지시키지 않는다.

구역·속도 값은 제동거리·조향 기하 실측(TBD-CAL-001·TBD-CAL-002·TBD-HW-008) 전 **잠정**이며
보수적으로 크게 잡았다. 실측이 오면 `safety.yaml` 만 고친다.

**전륜 조향에서는 정지 구역의 의미가 조금 달라진다.** 차동 구동에서는 정지 후 제자리 회전으로
빠져나올 수 있었으나 이제는 **전진 또는 후진 없이 방향을 바꿀 수 없다** — 정지 구역 안에서
멈추면 후진으로 빠져나오는 것이 유일한 선택이고, `/range/rear` 관측은 있어도 그 방향의 초음파 보호 정지는 아직 없다(23.6).
그래서 정지 구역을 좁히는 방향의 튜닝은 하지 않는다.

### `/mission/status` 발행 주기는 안전 체인의 판정 근거다 (S15P11A301-320)

`mission_manager` 가 이 토픽을 **1Hz 로 재발행한다.** 그것은 편의가 아니라 **주행의
전제 조건**이다. 소비자 셋이 이 토픽의 신선도로 정지를 판정하기 때문이다.

| 소비자 | 상수 | 없으면 |
|---|---|---|
| `safety_gate` | `mission_ttl_s` 10초 | `MISSION_STALE` 로 `/cmd_vel` 을 0 으로 만든다 |
| `exploration_node` | `status_stale_s` 3초 | `HOLD` 로 떨어져 목표 선택을 멈춘다 |
| `cloud_bridge` | (발행자 수) | 시각을 쓰지 않으므로 영향 없다 |

**heartbeat 가 없던 동안 자율 주행은 구조적으로 불가능했다.** 종전에는 전이 때만
발행했고(`_apply` 의 `if transition.changed`), 상태가 안 바뀌는 것이 곧 정상 주행이므로
「탐사 시작」 10초 뒤에 게이트가 닫혔다. 실측(2026-08-06)에서 증상은 **「Nav2 는 경로를
만드는데 로봇이 안 움직인다」** 였다 — `bt_navigator` 가 목표를 수락하고
(`Begin navigating from (0.16,-0.22) to (-2.66,0.02)`) `/cmd_vel_safe` 까지 값이
도달하는데 `/cmd_vel` 만 0 이었고, 끝에는 `controller_server` 가
`Failed to make progress` 로 목표를 버렸다. `ros2 topic hz /mission/status` 는 14초간
0건이었다. 원인을 게이트에서 찾으면 "안전 장치가 과하다"로 오진하게 된다 — **발행자가
조용한 것이 원인이다.**

고친 쪽이 발행자인 이유는 소비자의 요구가 정당하기 때문이다. latched 값을 무한
신뢰하면 `mission_manager` 가 죽어도 아무도 로봇을 세우지 않는다.

재발행은 **마지막 페이로드를 그대로** 낸다. `changedAt`·`previousState`·`reason` 은
전이의 사실이므로 heartbeat 가 지금 시각으로 덮으면 「방금 상태가 바뀌었다」는 거짓이
매초 나간다. 그래서 같은 상태를 **사건으로** 읽는 소비자(`map_saver` 의 `COMPLETED`)가
반복 수신에도 안전해야 하고, 그쪽은 `_saved_missions` 로 임무당 한 번을 보장한다.

주기를 바꿀 때는 위 표의 두 상수를 함께 본다. 1Hz 는 가장 촘촘한 판정(3초)에 세 번의
여유를 준다.

## 24.2 기본 속도 정책

초기값은 실제 정지거리 시험 전의 보수적 시작값이며 최종값은 35장의 튜닝 절차로 확정한다.

| 상황 | 선속도 상한 | 각속도 상한 | 비고 |
|---|---:|---:|---|
| 자율 탐사 | 0.30m/s | 0.6rad/s | 상한이자 **기본 명령값**(2026-08-09, S15P11A301-342). 종전 기본 0.15 는 속도 보고 3.4배 결함(339) 위에서 고른 값이었다 — 결함 수정 후 재실측하니 0.15 는 데드밴드(150mm/s) 경계라 실속도 ~0, **0.30 은 명령=실속도 99%**(전진 148cm·후진 159cm/기대 150cm)에 체감 적정. 0.20 명령은 정지 마찰 구간이라 실속도 39% — 저속 명령은 쓰지 않는다 |
| 피해자 접근 | **0.25m/s** | 0.3rad/s | 0.10 → 0.15(S15P11A301-343) → **0.25**(2026-08-09, S15P11A301-368). 펌웨어 데드밴드가 150mm/s 라 0.10 은 실속도 0, 0.15 는 경계값이다. 0.25 가 확실히 움직이는 최저 대역(실속도 82%)이고, 「사람 앞에서 천천히」 의도는 순항 0.30 보다 낮은 이 값으로 지켜진다. 실기동에서 이 값이 층 두 곳(launch 기본값·MOVEMENT 표)에 각각 낡게 남아 로봇이 조향만 까딱이던 결함을 두 번 고쳤다(357·368) |
| 수동 조종 | 0.30m/s | 0.7rad/s | deadman 필수. **아래 주석 참고 — 이 체인이 지키는 값이 아니다** |
| 영상·위치 불안정 | 0 또는 0.10m/s | 제한 | 품질에 따라 정지 |
| E-Stop·watchdog | 0 | 0 | 즉시 출력 차단/제동 |

> **수동 0.30m/s 를 지키는 것은 앱과 펌웨어다** (S15P11A301-298). 이 값은 유지하되,
> 수동 명령이 `velocity_smoother`·`collision_monitor`·`safety_gate`·
> `vehicle_kinematics(max_drive_mmps=300)` 을 **전부 우회한다**는 사실을 함께 적는다.
> 실제 집행자는 폰의 `lin` 스케일링과 모터 ESP32 의 `MANUAL_MAX_DRIVE_MMPS(300)` 이며,
> 자율 체인의 같은 숫자와는 우연히 같을 뿐 한쪽을 바꾼다고 다른 쪽이 따라오지 않는다.
>
> 그리고 이것은 **실측이 아니라 개루프 PWM 캡**이다. mm/s → PWM 매핑이 아직 임시값이므로
> (35-4 미결) 실제 속도가 0.30m/s 라는 보장은 없다.

> **각속도 상한은 표의 값과 `v/R_min` 중 작은 쪽이다**(2026-08-06, 03장 34-2). 표의 각속도는
> 전륜 조향 전환 전에 정한 값이라 **저속 구간에서는 물리적으로 도달할 수 없다.** 예를 들어
> `R_min = 1.69m`(실측 좌 1.37/우 1.76)면 피해자 접근 0.25m/s 에서 가능한 각속도는 약 0.15rad/s 이고 표의 0.3rad/s 는
> 나오지 않는다. `R_min` 실측(TBD-HW-008) 후 이 표를 함께 정정하며, 그때까지 표의 각속도는
> **상한선일 뿐 달성 가능값이 아니다.**

## 24.3 장애물 구역

| 구역 | 의미 | 동작 |
|---|---|---|
| 경고 구역 | 경로 주변 장애물 접근 | 감속 |
| 정지 구역 | 예상 정지거리 이내 | 목표 속도 0 |
| 물리 접촉 위험 | 초근거리·범퍼·초음파 | 초음파 거리 관측만 유지. 보호 정지 발동은 비활성이라 LiDAR `collision_monitor` 에 의존한다(물리 E-Stop 미도입) |

정지 구역은 고정 숫자만 사용하지 않고 현재 속도, 센서 갱신 지연, 300ms watchdog, 실제 제동거리를 포함해 결정한다.

초음파(HC-SR04) 거리와 중계 경로는 구현돼 있지만, 전방 센서의 빈 공간 오측 때문에 센서 ESP32가 `protective_stop`을 세우는 판정은 비활성화했다(S15P11A301-353). 따라서 현재 초음파 임계 진입만으로는 모터가 정지하지 않는다. 보호 판정을 복원하려면 빈 공간 15초 오측 0회를 먼저 확인하고, 그 뒤 Jetson 중계부터 PWM 0까지 지연을 실측한다(TBD-HW-011). 그 전까지 주 방어는 LiDAR `collision_monitor` 이고, 물리 E-Stop 은 미도입이라 그 아래 층이 없다(03장 34-10).

## 24.4 수동 조작 안전

**항목별로 재작성했다** (S15P11A301-298). 종전 목록은 브라우저가 조종 경로에 있다고
전제했는데, 확정 토폴로지에서 브라우저는 조종 경로 밖이다.

- **deadman 을 누르는 동안만 주행한다.** 집행자는 폰이고, 홀드가 끊기면 다음 패킷이
  `dm=0` 으로 나가며 보드가 즉시 바퀴를 세운다.
- **수동 채널 TTL 은 250ms** 이고 모터 ESP32 가 집행한다. 폰이 죽거나 WiFi 가 끊기면
  이 시간 안에 바퀴가 선다. 앱은 50ms 로 재전송해 한 번 손실돼도 네 번 더 기회를 둔다.
  (in-tree 폰 스케치의 종전 `COMMAND_TIMEOUT_MS = 1500` 은 이 줄이 약속하는 값의
  6배였고, 병합으로 250ms 가 됐다.)
- **「Jetson 300ms」는 수동에 적용되지 않는다.** 그 워치독은 자율 명령 링크를 본다.
  수동 래치 중에 그것이 끊기면 fault 비트만 오르고 수동 출력은 유지된다(03장 34-7).
- **모터 ESP32 의 300ms 는 죽은 *젯슨*을 막고 죽은 *폰*은 막지 못한다.** 젯슨이
  MANUAL 중에도 0-속도 keepalive 를 20Hz 로 계속 보내 그 타임스탬프를 갱신하기
  때문이다. 폰 상실 보호는 전적으로 위의 수동 TTL 이다.
- **control session 은 이 경로에 없다.** 폰은 자기 핫스팟에서 Spring 에 도달할 수
  없다. 보드의 로컬 `sid` 는 단일 조종자만 강제하며 신원이 아니고, 인증 경계는 핫스팟
  WPA2 가 전부다. FR-012(단일 조종자 강제)는 **영구 미충족**이며 06장에 등재한다.
- **수동 종료 후 자율 탐사를 자동 재개하지 않는다.** 「자율」의 착지점은 `PAUSED` 이고
  재개는 별도 명령이다(SR-008).

## 24.5 합격 기준

- 표준 장애물 코스에서 충돌 없이 우회하거나 안전 정지한다.
- 게임패드·브라우저·MQTT·USB 중 어느 한 경로를 끊어도 300ms 이내에 모터 ESP32 PWM이 0이 된다.
- 전방 초음파 임계거리 진입 시 센서 ESP32가 즉시 감지·보고하고, Jetson 중계를 거쳐 모터 ESP32가 정지한다(모터 ESP32 자체 통신이 끊긴 경우는 300ms watchdog으로 독립 정지). **임계는 실측 0.15~0.18m 이며 접촉 직전 방어다**(22.2) — 이 항목으로 0.40m 급 보호를 판정하지 않는다. **2026-08-09 부터 발동이 꺼져 있어**(S15P11A301-353) 이 경로는 동작하지 않는다 — 근거리 보호는 라이다 층뿐이다(물리 E-Stop 미도입 — 03장 34-10).
- E-Stop 해제 후 새 enable 절차 없이는 움직이지 않는다.
- 사람 접근 중 안전거리보다 가까워지면 Nav2 목표와 무관하게 정지한다. **이것은 초음파가 아니라 LiDAR·사람 탐지 기반 접근 제어의 몫이다** — SR-009 가 요구하는 안전거리는 1.5~2.0m(06장)인데 초음파는 그 거리에서 탐지율이 7~27%다(22.2). 초음파를 이 판정에 쓰면 여덟 번 중 일곱 번을 놓친다.

# 26. Mission Manager·임무 상태 머신 상세 설계

## 24.6 사람 접근은 Nav2 없이 간다 (S15P11A301-247)

`PERSON_APPROACHING` 에서 주행 목표를 내는 노드가 **하나도 없었다.** 상태 머신은
`EXPLORING → PERSON_APPROACHING` 전이를 하고 `MOVEMENT` 표가 당시 0.10m/s(현재 0.25m/s)를 허용하는데,
그 상태에서 속도를 내는 쪽이 없어 로봇은 사람을 발견하고 그 자리에 서 있었다.
`SAFE_POSE_REACHED` 를 보내는 것도 시뮬레이터(`simulate_inputs.py`)뿐이었다 — 즉 시연
시나리오 「발견 → 접근 → 대화」의 **접근 단계가 비어 있었다.**

### 왜 bearing-only 인가

25.3 은 「사람 map 좌표 → 안전거리 지점을 Nav2 목표로」(`MEASURED` 경로)를 규범으로
두지만 **그 입력이 없다.** 탐지 노드가 `position` 을 **항상 `null`** 로 낸다
(`ai/detection/src/candidates.py`). 그래서 카메라 방위각과 그 방향의 LiDAR 거리만 쓰는
`ESTIMATED`·bearing-only 경로부터 만든다 — 티켓이 「Nav2 없이 동작하므로 그것부터」라고
적어 둔 그 순서다.

**그 결과 접근은 Nav2·SLAM 없이 동작한다.** 필요한 것은 탐지(`enable_detector`)와 안전
체인(`enable_safety`)뿐이고, `enable_approach` 는 `enable_nav2` 가 아니라
`enable_detector` 와 AND 로 묶인다. 탐사와 다른 점이 이것이다.

### 제자리 회전을 하지 않는다 — 티켓 본문의 낡은 서술

S15P11A301-247 본문은 「방위 정렬(**제자리 회전**) 후 0.10m/s 전진」이라고 적혀 있다.
**그것은 차동 구동 전제이며 2026-08-06 전륜 서보 조향 전환으로 무효가 됐다.**
`vehicle_kinematics` 는 `v≈0` 에 `ω≠0` 인 명령을 거부하고(§34-2), 실측에서 그 거부가
Nav2 의 진행 검사를 통해 목표 포기로 이어졌다.

그래서 접근은 **전진하면서 조향하는 호**다. 대가로 곡률이 `κ = ω/v ≤ 1/R_min` 으로
제한되며, 카메라 화각이 ±26° 라 한 틱에 다 못 감는 방위는 다음 관측에서 이어 감는다.
`ApproachCommand` 자료형이 `v=0·ω≠0` 을 **생성 시점에 거부**한다 — 그 불변식을 지키는
것이 이 모듈의 존재 이유다.

### 멈추는 조건

| 조건 | 동작 | 근거 |
|---|---|---|
| 거리를 모른다(`/scan` 유효 빔 없음) | 정지 | 모르는 것과 먼 것을 섞지 않는다. 모르는 채 전진하면 사람을 지나친다 |
| 사람을 `person_lost_s` 동안 못 봤다 | 정지 + `APPROACH_FAILED` | 마지막 방위로 계속 가지 않는다. 사람이 옆으로 비켰는데 그 자리로 돌진하면 사고다 |
| `stop_distance_m`(**1.20m**) 안 | 정지 + `SAFE_POSE_REACHED` | 30.3 안전 관측 위치. **`collision_monitor` 정지 구역(전방 1.05m, S15P11A301-356)보다 커야 한다** — 작으면 사람 다리가 구역에 먼저 들어와 안전 체인이 속도를 0 으로 만들고 도착 선언이 영원히 안 나온다. 0.60 이던 것을 구역 확장과 함께 1.20 으로 올렸다(357). 구역을 조정하면 이 값을 같이 본다 |
| 상태가 `PERSON_APPROACHING` 이 아니거나 상태가 낡음 | 정지 | 26.2. 상태 판단을 여기서 다시 하지 않는다 |

충돌 회피는 **여기서 하지 않는다.** 안전거리보다 가까워지면 멈추는 것은
`collision_monitor` 와 초음파 보호정지의 몫이다(24.3, S15P11A301-237). 같은 판정을 두
곳에 두면 언젠가 한쪽만 바뀐다.

### 남은 것

`MEASURED` 경로(지도 좌표 목표)는 탐지 노드가 `position` 을 채운 뒤다. 그때도 이 모듈은
그대로 두고 목표 생성만 밖에서 더한다 — bearing-only 는 LiDAR 거리가 실패하는 조건의
폴백으로 계속 필요하다(25.3 v2.0 절).

## 26.1 단일 권한 원칙

Mission Manager는 임무 상태를 변경하는 유일한 로봇 측 권한자다. Nav2, AI, 음성, 관제 명령이 각자 모터와 상태를 직접 바꾸지 않고 이벤트를 Mission Manager에 전달한다.

## 26.2 최종 상태

| 상태 | 설명 | 이동 허용 |
|---|---|---|
| `SAFE_IDLE` | 부팅·점검 완료 전 또는 임무 대기 | 아니오 |
| `EXPLORING` | Frontier 탐사 | 예 |
| `PERSON_APPROACHING` | 사람 그룹 안전 접근 | 저속 |
| `INTERACTING` | 음성 확인 | 아니오 |
| `POST_RECORDING` | 종료 후 3초 영상 확보 | 아니오 |
| `REPORTING` | 이벤트·피해자·미디어 저장 | 아니오 |
| `PAUSED` | 운영자 또는 오류로 일시정지 | 아니오 |
| `MANUAL` | 모바일 앱 직결 조작(모터 ESP32 중재) | **아니오 — 젯슨은 어떤 속도도 내지 않는다** |
| `RETURNING` | home pose 복귀 | 예 |
| `COMPLETED` | 정상 종료 | 아니오 |
| `ESTOP` | 비상 정지 latch | 아니오 |
| `ERROR` | 핵심 기능 복구 불가 | 아니오 |

`OFFLINE`은 서버가 보는 연결 상태이며 Jetson 내부 주행 상태와 혼동하지 않는다.

`MANUAL` 의 「이동 허용 = 아니오」는 자리표시자가 아니라 정확한 값이다
(S15P11A301-298). deadman 은 폰에 있고 조종 패킷은 모터 ESP32 로 직접 가므로,
**젯슨에는 수동 속도 소스 자체가 없다** — 젯슨이 낼 수 있는 것은 0 뿐이고 사람이
조종하는 동안 바퀴를 굴리는 것은 보드다. 종전 「deadman 시」는 조종 노드가 젯슨에
있다고 전제한 표현이었다.

## 26.3 상태 전이

```mermaid
stateDiagram-v2
    [*] --> SAFE_IDLE
    SAFE_IDLE --> EXPLORING: start (preflight 자동 gate 없음)
    EXPLORING --> PERSON_APPROACHING: encounter confirmed
    PERSON_APPROACHING --> INTERACTING: safe pose reached
    INTERACTING --> POST_RECORDING: dialog ended
    POST_RECORDING --> REPORTING: 3s captured
    REPORTING --> EXPLORING: report committed
    EXPLORING --> RETURNING: 설계만·미구현
    RETURNING --> COMPLETED: home reached
    EXPLORING --> COMPLETED: 관제 STOP (RETURNING 우회)
    COMPLETED --> EXPLORING: 새 임무 start
    EXPLORING --> PAUSED: pause/fault
    PAUSED --> EXPLORING: explicit resume
    SAFE_IDLE --> MANUAL: MANUAL_ENGAGED
    PAUSED --> MANUAL: MANUAL_ENGAGED
    COMPLETED --> MANUAL: MANUAL_ENGAGED
    EXPLORING --> PAUSED: 수동 진입 자동 경유
    MANUAL --> PAUSED: 관제 「자율」 (ESP32 ACCEPTED)
```

위 도식의 화살표 둘은 **v2.0 에서 추가된 실제 동작**이다(S15P11A301-274).

**`EXPLORING → COMPLETED` (관제 STOP).** `RETURNING` 이 미구현(`자리만`)이라 관제의
임무 종료가 복귀를 거치지 않고 바로 `COMPLETED` 로 간다. 종전 도식에는 이 화살표가
없어서 `COMPLETED` 에 도달하는 유일한 길이 `RETURNING` 인 것처럼 읽혔다. 복귀 주행이
구현되면(S15P11A301-246) 정규 경로가 살아난다.

**`COMPLETED → EXPLORING` (새 임무 start).** 종전에는 `COMPLETED` 가 나가는 전이 없는
종단이었고 `MISSION_START` 가 `SAFE_IDLE` 에서만 유효했다. 그래서 관제에서 임무를 한 번
종료하면 `mission_manager` 를 재기동해야 다시 시작할 수 있었다 — **STOP 한 번이 일회용
잠금이었다.** 시연은 반복하므로 이 전이를 열었다.

MANUAL 관련 화살표 넷은 **v2.1 에서 실제 트리거를 얻었다**(S15P11A301-298).

종전 라벨 `session + gamepad` / `deadman lost/exit` 은 삭제된 UI 를 전제했고, 그동안
`MANUAL` 은 `UNIMPLEMENTED` 집합에 있어 **도달 자체가 불가능**했다. 지금은 이렇다.

- **`MANUAL_ENGAGED` 는 사실이다.** 모터 ESP32 가 수동 권한을 래치했다는 것이고,
  젯슨은 그것을 따라간다. 만드는 경로는 둘 — 모바일 조작으로 보드가 스스로 래치한
  암시적 승격(`DRIVE_STATE.state` 상승 엣지, 100ms 디바운스)과, 관제 「수동」 버튼의
  `SET_MODE(MANUAL)` ACCEPTED.
- **`EXPLORING → PAUSED: 수동 진입 자동 경유`** 가 14.2 의 2단 전이다. 두 status 가
  같은 틱에 순서대로 발행되며, 1단에서 진행 중 encounter 를 `Phase.ENDED` 로 마감한다.
- **`MANUAL → PAUSED` 는 관제 「자율」 하나뿐이고 거부될 수 있다.** 보드가 최근 500ms
  안에 수동 입력을 봤으면 `MANUAL_INPUT_ACTIVE` 로 거부하고 상태는 그대로다. 착지점은
  `PAUSED` 이며 **절대 `EXPLORING` 이 아니다**(SR-008).
- `COMPLETED --> MANUAL` 을 연 이유는 `COMPLETED --> EXPLORING` 과 같다 — 임무가 끝난
  뒤에도 로봇을 손으로 옮겨야 할 일이 있다.

도식에 그리지 **않은** 것들이 있다. 모바일 「정지」, deadman 해제, 수동 TTL 만료,
WiFi 끊김, `STOP_COMMAND` 는 전이가 **아니다** — 바퀴만 0 이고 `MANUAL` 은 유지된다.
화살표로 그리면 그것들이 모드를 바꾸는 것처럼 읽힌다.

초기화 상태를 따로 거치지 않는 이유는 **임무 종료 기록이 상태 머신에 있지 않기
때문**이다. `personCount` 는 encounter 에서 파생되고 `missionId` 는 관제가 준 값이며,
완료 이력은 관제 DB 의 임무 이력에 남는다. 살아 있는 상태가 `COMPLETED` 를 붙들고
있어야 이력이 보존되는 것이 아니다. 조작자는 「탐사 시작」으로 이미 의도를 표현했으므로
클릭을 하나 더 요구하지 않는다.

새 임무가 이전 임무의 `encounterId`·`personCount` 를 물려받지 않는 것은 `_mission_completed`
가 `COMPLETED` 로 갈 때 진행 중 encounter 와 `mission_id` 를 지우기 때문이며, 그 불변식은
단위 시험으로 고정돼 있다.

### 관제 화면의 상태 표시는 백엔드가 진실이다

관제 화면의 임무 상태는 **젯슨에 직접 붙어 읽지 않는다.** 프론트는
「서버 상태가 진실이라는 원칙(27.3)」에 따라 `missions.status` 를 표시하고, 그 값은
STOMP 푸시(끊기면 REST 백업 폴링)로 온다. 이 구분을 모르면 젯슨 상태를 고쳐 화면을
바꾸려 하게 된다.

**그 칸에 값을 쓰는 주체가 둘이며, 역할이 다르다** (S15P11A301-316).

| writer | 쓰는 것 | 근거 |
|---|---|---|
| `CommandAckWriter` | 명령 ACK 로 확정되는 것 — `status` 와 **라이프사이클**(`started_at`, `ended_at`, `end_reason`, `mission_results`) | 임무가 시작·종료된 **사건**은 운영자의 명령이고, 그 사건에 붙는 집계는 한 번만 일어나야 한다 |
| `RobotStateWriter` | 1Hz `ROBOT_STATE` 의 `missionState` → `status` **한 칸만** | 「지금 로봇이 무엇을 하고 있나」의 근거는 명령 이력이 아니라 로봇의 보고다 |

어긋나면 **로봇의 보고가 이긴다.** 명령 ACK 가 `status` 에 쓴 값은 로봇이 곧 같은 값을
보고하며 확인해 주고, 확인되지 않으면 그 명령은 실제로 일어나지 않은 것이다.

#### 예외 하나 — 고아 임무는 `RobotStateWriter` 가 닫는다 (2026-08-09, S15P11A301-346)

위 표의 유일한 예외다. 임무 중 스택이 STOP 없이 죽으면 **그 임무를 닫는 주체가 아무도
없다** — `CommandAckWriter` 는 명령 ACK 로만 움직이는데 그 명령이 영영 오지 않기
때문이다. 서버에 `ended_at=null` 로 영원히 남고, 관제는 접속할 때마다 그 유령 임무를
이어받아 「탐사중」으로 표시한다. **로봇은 대기 중인데.**

닫는 근거는 **로봇이 살아서 「임무 밖」이라고 말한 것**이다. 젯슨은 `SAFE_IDLE`·
`COMPLETED` 에서 `activeMissionId` 를 비우는데(`message_mapper`), 그때 DB 에 열린 임무가
남아 있으면 그것은 정의상 고아다 — 임무를 복구했다면 `PAUSED` + missionId 를 보고했을
것이기 때문이다(37-3).

**「응답 없음」으로는 절대 닫지 않는다.** 무선만 끊긴 경우 로봇은 여전히 주행 중이고,
링크가 살아나면 그대로 이어져야 한다. 침묵은 신선도 표시의 몫이지 종료의 근거가 아니다.

오판을 막는 조건이 둘이고 **둘 다 필수다.**

| 조건 | 값 | 없으면 |
| --- | --- | --- |
| 연속 지속 | 5초 | 기동 과도기의 한 프레임짜리 `SAFE_IDLE` 에 반응해 멀쩡한 임무를 닫는다 |
| 시작 유예 | 10초 | **방금 시작한 정상 임무를 즉시 닫는다** — START 뒤 젯슨이 EXPLORING 으로 가기까지 1~2초는 아직 `SAFE_IDLE` 이다 |

종료 사유는 `OPERATOR_STOP` 과 구분되는 **`CONNECTION_LOST`** 로 남긴다. 이력에서 정상
종료와 비정상 종료가 섞이면 「시연 중 몇 번 죽었나」를 셀 수 없다. 종료 시각은 지금이
아니라 **「임무 밖」이 시작된 시각**이다 — 지금으로 적으면 로봇이 죽어 있던 시간이 임무
시간에 들어간다.

#### 왜 로봇 보고를 쓰게 했는가

종전에는 `RobotStateWriter` 가 **수동 여부만** 옮겼다(S15P11A301-298). 그래서
`missions.status` 는 사실상 「마지막으로 수락된 명령」의 원장이었고, 화면은 그 칸만
읽으므로 `START`·`RESUME` 한 번에 `EXPLORING` 이 고착됐다. 실측으로 확인한 세 갈래다.

- **거부된 명령은 아무것도 쓰지 않는다.** 모드 토글이 `MOTOR_BOARD_NO_ACK` 로 거부되면
  `CommandAckWriter` 는 early return 하고 푸시도 없다. 화면의 낙관적 「수동 조종」이
  최대 15초 뒤 백업 폴링에서 「탐사 중」으로 되돌아갔다 — 조작자에게는 **가만히 있는데
  갑자기 상태가 바뀌는 것**으로 보였다.
- **로봇이 스스로 벗어난 것이 안 적혔다.** encounter 진행(`PERSON_APPROACHING` 이하),
  센서 실패 `PAUSED`, `ESTOP`·`ERROR`, `mission_manager` 재시작 후 `SAFE_IDLE` — 전부
  화면에 「탐사 중」으로 남았다. 차체가 멈춰 있는데 움직인다고 말하는 화면이다.
- **열린 임무는 STOP 없이는 닫히지 않는다.** `EXPLORING` 으로 열린 임무가 남으면 다음
  페이지 로드의 새로고침 복구가 그것을 이어받아 처음부터 「탐사 중」으로 시작했다.
  로봇이 꺼져 있어도 그렇다.

같은 divergence 가 명령 거부로도 이어졌다 — 화면만 `PAUSED` 라고 믿고 「탐사 재개」를
누르면 젯슨은 여전히 `EXPLORING` 이라 `RESUME` 이 `INVALID_STATE` 로 거부된다(실제 명령
이력에 2건).

#### 제어 모드는 임무가 아니라 로봇에 붙는다 (2026-08-08, S15P11A301-350)

**위 표가 다루는 것은 `missionState` 뿐이다.** `controlMode`(자율·수동)는 종전에
프런트가 `missions.status` 에서 **파생**했다 — `MANUAL` 이면 수동, 아니면 자율.
S15P11A301-298 이 새로고침 후에도 수동 표시를 유지하려고 넣은 규칙이다.

그런데 `missions.status` 는 위의 `ended_at IS NULL` 가드가 지킨다. 가드는 옳다(종료된
임무를 되살리면 안 된다). 문제는 **임무가 닫힌 뒤에 수동으로 들어가면 옮겨 적을 곳이
아예 없다**는 것이고, 그때 파생 규칙은 「MANUAL 이 아니다 → 자율」로 떨어진다.

2026-08-08 실기동이 그 경우다.

```text
21:03:03  임무 종료 (OPERATOR_STOP, ended_at 기록)
21:04:14  폰이 모터 보드를 수동 래치 → 젯슨 COMPLETED → MANUAL
          이후 14분간 관제 화면은 「자율」 토글
21:18:33  「탐사 시작」 → INVALID_STATE 거부 (젯슨은 MANUAL 이므로)
21:18:47  같은 거부 반복
```

**젯슨은 처음부터 정확했다.** `/mission/status` 로 `controlMode: "MANUAL"` 을 계속
발행했고 거부 사유에도 「현재 MANUAL」을 담아 보냈다. 값이 백엔드까지 왔는데
(`RobotStateData.controlMode`) **읽는 코드가 없어 버려지고 있었다.**

그래서 자리를 옮겼다.

| 값 | 사는 곳 | 왜 |
|---|---|---|
| `missionState` | `missions.status` | 임무 안에서만 뜻이 있다 |
| `controlMode` | **`robots.control_mode`** | 임무 유무와 무관하게 존재하며 로봇당 하나다 |

`missions.status` 의 12값에도 `MANUAL` 이 있어 문자열이 겹쳐 보이지만 **다른 상태
공간이다.** 한쪽을 다른 쪽에서 파생시키려 하면 이 버그로 돌아온다.

**3값을 2값으로 그리지 않는다.** `MANUAL` / `AUTO` / `null`(모름) 이며, `null` 을
`AUTO` 로 뭉개면 고친 것이 아니다 — 화면의 `!manual` 이 곧 「자율」이던 것이 이번
증상의 형태였다. 관제 토글은 모름일 때 어느 쪽도 강조하지 않고 `aria-checked` 도
`mixed` 로 간다.

#### 순서와 예외

- **ACK 와 상태 메시지의 순서**는 젯슨의 단일 MQTT 연결과 서버 Paho 콜백 한 스레드가
  보존한다(`MqttGateway.messageArrived`). 즉 `START` ACK 뒤에 옛 `SAFE_IDLE` 이 도착해
  표시를 되돌리는 경합은 생기지 않는다.
- **`ended_at IS NULL` 가드**는 유지한다. 젯슨이 임무 종료 직후에도 잠깐 이전 상태를
  보낼 수 있고, 그때 `COMPLETED` 를 덮으면 임무 이력이 사라진다.
- **모르는 상태값은 쓰지 않고 경고만 남긴다.** 26.2 의 12개를 백엔드·프론트 양쪽에서
  전수로 적는다(`RobotStateWriter.MISSION_STATES`, `missionStatus.ts`). 모르는 값을
  그대로 흘리면 프론트 라벨 표에서 조용히 빠지고 **화면은 옛 상태를 계속 보여준다** —
  고치려는 증상 자체가 그렇게 만들어진다.
- **`activeMissionId` 가 비는 경우가 있다.** 젯슨은 임무 밖 상태(`SAFE_IDLE`·
  `COMPLETED`)에서 그 필드를 비운다(`message_mapper.MISSION_ACTIVE_BY_STATE`). 그것만
  보면 「로봇은 재시작해 대기인데 DB 에는 `EXPLORING` 인 임무가 열려 있는」 경우를 고칠
  수 없으므로, 그때는 **로봇 이름으로 열린 임무를 찾아** 쓴다 — 열린 임무는 로봇당
  하나뿐이다(27.3).

**`STOP` 은 DB 에서 임무를 닫는다.** `missions.status = COMPLETED`, `ended_at`,
`end_reason = OPERATOR_STOP` 과 `mission_results` 집계가 ACK 시점에 들어간다. 즉 임무
이력은 젯슨 상태와 무관하게 보존되며, **살아 있는 상태 머신이 `COMPLETED` 를 붙들고
있어야 이력이 남는 것이 아니다.**

그래서 화면 표시는 이렇게 정리했다(S15P11A301-274).

| 항목 | 값 | 근거 |
|---|---|---|
| `COMPLETED` 표시 | **「대기」** (`SAFE_IDLE` 과 동일) | 종료는 알람으로 이미 알렸고 이력은 DB 에 있다. 상태창은 「지금 로봇이 어떤가」를 보여주는 자리다 |
| `COMPLETED` 톤 | 중립 (종전 초록) | 대기 중인데 활동 중처럼 보였다 |
| 「임무 종료」 버튼 | **`SAFE_IDLE`·`COMPLETED` 에서 숨김** | 끝낼 임무가 없다. 일시정지 버튼이 주행 중에만 보이는 것과 같은 기준 |
| `return` 명령의 낙관적 표시 | `RETURNING` → **`COMPLETED`** | `RETURNING` 은 미구현이라 로봇이 결코 그 상태가 되지 않는다. 화면만 복귀하는 것처럼 보였다 |

마지막 항목이 실제 오표시를 만들고 있었다 — 대기 상태에서 「임무 종료」를 누르면 화면이
「복귀 중」으로 바뀌었다. 버튼을 숨기는 것과 낙관적 표시를 고치는 것 **둘 다** 필요하다.
버튼만 숨기면 다른 경로로 같은 명령이 나갈 때 같은 오표시가 난다.

백엔드에 `TYPE_RETURN`(→ `status = 'RETURNING'`)이 있으나 **아무도 보내지 않는다** —
프론트가 복귀 버튼을 `STOP` 에 붙였기 때문이다. 복귀 주행(S15P11A301-246)이 구현될 때
쓰는 자리로 남겨 둔다.

모든 이동 상태에서 E-Stop은 `ESTOP`으로, 핵심 센서 실패는 `PAUSED` 또는 `ERROR`로 우선 전환한다. Mermaid 도식에 표시되지 않은 비상 전이는 이 규칙을 따른다.

## 26.4 명령 멱등성과 재시작

- 모든 외부 명령은 `commandId`, `issuedAt`, `expiresAt`을 가진다.
- 이미 처리한 commandId는 `DUPLICATE_COMMAND` 사유로 거부하고 다시 실행하지 않는다(원래 결과 ACK 재전송은 아님).
- Jetson 또는 서버 재시작 후 진행 중이던 임무를 자동 주행으로 복구하지 않는다.
- **미구현:** 로컬 checkpoint와 `RECOVERY_REQUIRED` 상태는 없다. 재시작 후 자동 주행 복구를 하지 않는 운영 원칙만 적용한다.
- encounter 보고가 중단되면 동일 encounterId로 재시도한다.

### 임무를 멈추면 진행 중 encounter 를 끊는다 (S15P11A301-276)

일시정지·종료·센서 실패로 임무가 멈출 때 진행 중 encounter 가 있으면 `ENDED` phase 를
발행한다. 그래야 `recording_manager` 가 사후 창을 거쳐 MP4 를 **관측 구간 길이로**
마감한다.

종전에는 마감 신호가 나가지 않아 녹화기가 5분 `MAX_DURATION` 까지 돌았다. 실측:
`REPORTING` 중 관제 PAUSE 를 누르자 **92MB** 파일에 `endReason: MAX_DURATION` 이
남았다. 사람이 없는 구간까지 담겨 증빙 품질도 낮고, 시연을 반복하면 디스크·업로드
부담이 쌓인다.

녹화기가 임무 상태에 의존하지 않는 것은 **설계 의도**다(`recording_manager_node`:
「MAX_DURATION 은 mission_manager 의 상태와 독립이다」). 상한이 없으면 파일이 무한히
커진다. 그래서 상한은 옳고 **마감 신호를 제때 주지 않은 쪽이** 문제였다.

살려 둘 이득도 없다. 재개(`RESUME_APPROVED`)가 어차피 encounter 를 버리므로, 멈춘
동안 유지해도 이어서 쓰이지 않는다.

| 경로 | encounter | 근거 |
|---|---|---|
| 관제 일시정지 (`PAUSE_REQUESTED`) | **끊는다** | 이 발견을 여기서 끝낸다는 운영 판단 |
| 관제 종료 (`MISSION_COMPLETED`) | **끊고 버린다** | 임무가 끝났으므로 다음 임무로 새면 안 된다 |
| 센서 실패 (`SENSOR_FAULT`) | **끊는다** | 같은 이유. `PAUSED` 로 가는 핸들러가 둘이라 처음에 이 경로를 빠뜨렸다 |
| **비상 정지 (`ESTOP`)** | **끊지 않는다** | 의도된 예외 — 원인 조사 대상이라 전후 영상이 길게 남아야 한다. 여기서는 5분 상한까지 가는 것이 맞다 |

발행 순서에 함정이 있다. 노드는 발행 시점에 encounter 를 읽으므로, 핸들러가 먼저
버리면 `encounterId` 가 빠진 채 나가고 녹화기는 「진행 중 이벤트가 아니다」로 무시한다.
그래서 `Transition` 이 대상 encounter 를 **들고 간다** — 그러면 핸들러가 발행 순서를
신경 쓰지 않고 정리할 수 있다.

## 26.5 이벤트 우선순위

```text
물리 E-Stop
> ESP32 fault/watchdog
> 소프트웨어 E-Stop
> Collision stop
> 핵심 센서·위치 오류
> 수동 deadman/control session
> 피해자 encounter
> 복귀
> 자율 탐사
```
