Common-AIOT/Sentinel-UGV/docs/02-하드웨어.md

> Sentinel UGV 통합 명세서 v2.1의 일부 — 문서 규칙·버전·변경 이력은 [README](README.md) 참조

# 6. 하드웨어 및 기구 설계

> **이 장은 요약이다.** 하드웨어의 규범(상세) 설계는 **21장**(인터페이스·전원·배선), **34장**(ESP32 저수준 주행 제어·안전 통신), **35장**(센서·엔코더 캘리브레이션)을 따르고, 미확정 항목은 **부록 H**(단일 TBD 대장), 부품·전력 목록은 **부록 I**(BOM·전력 예산 템플릿)에서 관리한다.

**핵심 결정**

| 결정 | 내용 | 상세 |
|---|---|---|
| 차체 플랫폼 | BMW M7 유아전동차 donor + 후륜 좌·우 개별 구동(RS540 FD-12V RPM14000 ×2), 전륜은 기존 조향 앞바퀴 2개를 복구해 DS51150-12V 서보모터로 조향, 상부 3D 프린팅 | 6.3, 부록 I |
| 컴퓨팅·제어 분담 | Jetson Orin Nano 8GB 고수준 / ESP32 WROOM-32 2개 저수준(모터 제어용·센서 제어용 분리), Raspberry Pi 5 차량 미탑재 | 21장, 34장 |
| ESP32 연결 | ESP32마다 독립된 유선 USB Serial, Arduino-ESP32(FreeRTOS 태스크 분리) 기반 제어. Wi-Fi/Bluetooth는 안전 제어에 미사용 | 21.3, 34장 |
| 짐벌 | **미사용 확정** — 카메라·LiDAR는 차체 고정 마운트, 정적(static) TF만 사용 | 6.4 |
| 주행·조향 | **전진·후진은 후륜 DC 모터 2개, 조향은 전륜 서보모터 1개로 분담 확정**(2026-08-06). 서보가 타이로드에 직결되어 좌·우 앞바퀴를 동시에 조향하며, 서보 제어는 모터 ESP32가 담당한다. 조향 기하가 생겼으므로 **제자리 회전은 불가능**하고 최소 회전반경 제약이 부활한다 | 6.3, 34-2 |
| 독립 안전 | ~~물리 E-Stop 이 모터·조향 서보 전원을 직접 차단~~ → **설계만, 미도입으로 종료**(03장 34-10). 실제 하드웨어 차단은 12V 배터리 연결 분리뿐이고 나머지는 watchdog·TTL·collision_monitor 다 | 21.4, 21.6 |
| 전원 아키텍처 | 모터 전원(유아전동차 내장 12V 배터리)과 Jetson 전원(대용량 보조배터리) 완전 분리 확정. 조향 서보는 모터 계통의 E-Stop 하류에서 급전, DC-DC 세부는 TBD | 6.6, TBD-HW-003 |
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
