Common-AIOT/Sentinel-UGV/hardware/bom/README.md

# Bill of materials

부품명, 모델, 수량, 공급처, 전압, 연속/피크 전류, 상태(TBD/확정)와 변경일을 관리합니다.
