Common-AIOT/Sentinel-UGV/frontend/components/README.md

# components

도메인에 종속되지 않는 재사용 가능한 표현 컴포넌트를 둡니다. 도메인 로직이 있는 컴포넌트는 `features/`에 배치합니다.

shadcn/ui 컴포넌트가 필요하면 `npx shadcn add <name>`로 개별 추가합니다.
