Common-AIOT/Sentinel-UGV/hardware/wiring/README.md

# Wiring

전원 분배, 퓨즈, 12V 모터 배터리 차단 지점, 모터 드라이버, 조향 서보, Jetson, 센서의 배선도 및 핀맵을 보관합니다. 전압과 최대 전류를 명시합니다.

래칭형 물리 E-Stop 은 도입하지 않았으므로 그 배선은 여기에 없습니다. 하드웨어 차단 수단은 12V 배터리 연결 분리뿐입니다([03장 34-10](../../docs/03-제어-캘리브레이션.md)).

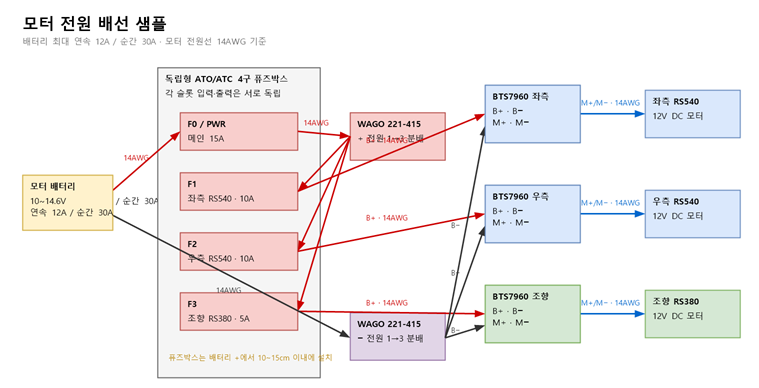
[picture p12: hardware/wiring/motor_circuit_design.png]
모터 회로도
