Common-AIOT/Sentinel-UGV/hardware/esp32/motor/esp32_motor_comm/esp32_motor_comm.ino

// 모터 ESP32 펌웨어. **명령 소스가 둘이고 중재자가 이 보드다.**
//
//   젯슨  ── USB 직렬 921600, COBS+CRC16 ──┐
//                                          ├→ control_task (100Hz, 유일한 액추에이터)
//   폰    ── 핫스팟 WiFi, HTTP 20Hz ───────┘      → BTS7960 후륜 2개 + DS51150 조향 서보
//
// 범위: 프레이밍, HELLO/HELLO_ACK, DRIVE_COMMAND/STOP/ESTOP/SET_MODE, 300ms 통신
// 워치독, DRIVE_STATE/DIAGNOSTIC 송신, 수동 조종 HTTP 채널, 액추에이션 중재.
//
// 2026-08-06 하드웨어 변경: 앞쪽 캐스터 2개를 제거하고 전륜 조향부를 복구했다.
// 후륜 DC 모터 2개는 전·후진 전용, 조향은 전륜 서보 1개 담당이다(§6.3, §34-2).
//
// S15P11A301-298 에서 `tank_drive` 스케치를 여기에 병합하고 삭제했다. 두 스케치가
// 같은 핀·같은 LEDC 채널을 쓰는 배타 스케치였고, 잘못 구우면 **강직된 전륜
// 링키지를 거슬러 차동 선회를 시도한다.** 벤치 스케치
// (motor_test/double_motor_test/triple_motor_test/steering_servo_test)는 그대로 둔다.
#include <Arduino.h>
#include <freertos/FreeRTOS.h>
#include <freertos/task.h>

#include "board_state.h"
#include "boot_status.h"
#include "comm_task.h"
#include "control_task.h"
#include "manual_web.h"
#include "safety_stub.h"
#include "steering.h"

// `xTaskCreate` 의 `usStackDepth` 는 ESP-IDF 에서 **바이트**다. 종전 이름
// `*_STACK_WORDS` 는 vanilla FreeRTOS 규약을 그대로 옮긴 오명이었고, 그대로 두면
// 다음 사람이 4배 계산해 스택을 잘못 잡는다 (S15P11A301-298).
constexpr uint32_t COMM_TASK_STACK_BYTES = 4096;
// 액추에이션 중재가 이 태스크로 모이면서 프레임이 늘었다(arbitrateDrive 결정 구조체
// + steeringSetTarget 의 float 경로).
// Arduino-ESP32 3.x에서 std::function 람다, DriveDecision 지역 상태와 부동소수점
// 조향 계산을 한 틱에 함께 수행하면 3KB 스택은 태스크 첫 실행에서 넘친다. 이때
// 우선순위 3인 제어 태스크가 스케줄러를 망가뜨려 통신 태스크까지 멈추므로 충분한
// 여유를 둔다. 전체 힙 320KB 중 추가 사용량은 5KB뿐이다.
constexpr uint32_t CONTROL_TASK_STACK_BYTES = 8192;
// WebServer 는 소켓 버퍼와 String 조립을 스택에서 쓴다. 4096 으로는 헤더가 긴
// 요청에서 넘칠 수 있다.
constexpr uint32_t MANUAL_WEB_TASK_STACK_BYTES = 8192;
constexpr UBaseType_t COMM_TASK_PRIORITY = 2;
// 유일한 액추에이터이므로 시리얼 폴보다 먼저 돌아야 한다. 통신 워치독 판정도 여기서
// 한다.
constexpr UBaseType_t CONTROL_TASK_PRIORITY = 3;
// **lwIP(18)·WiFi(23) 아래여야 한다.** 위에 두면 네트워크 스택이 굶어 20Hz HTTP 가
// 오히려 느려진다.
constexpr UBaseType_t MANUAL_WEB_TASK_PRIORITY = 1;

void setup() {
  // Jetson 링크를 가장 먼저 연다. 아래의 PWM·서보·WiFi 초기화 중 하나가 오래
  // 걸리더라도 통신 태스크가 독립적으로 HELLO와 상태 프레임을 처리할 수 있다.
  commSerialInit();
  motorSharedStateInit();
  const BaseType_t commTaskResult =
      xTaskCreatePinnedToCore(commTaskFn, "comm_task", COMM_TASK_STACK_BYTES, nullptr,
                              COMM_TASK_PRIORITY, nullptr, 1);

  // 5초 상태 창은 별도 UART(Serial2)에만 쓴다. Jetson 전용 Serial과 통신 태스크는
  // 이미 시작됐으므로 상태 표시 초기화가 Jetson 링크를 막을 수 없다.
  bootStatusInit();

  // §34-6: 전원 인가 직후 PWM=0·driver enable=LOW를 먼저 보장하고, 조향의 내부
  // 목표만 중립(δ=0)으로 준비한다. 실제 서보 펄스는 아래의 주변장치 초기화가 끝난
  // 뒤 제어 태스크에서 시작한다. 통신 태스크는 액추에이터를 직접 구동하지 않는다.
  // 조향 목표만 중립으로 시작하는 것은 재부팅 직후에 믿을 수 있는 마지막
  // 각도가 없기 때문이며(RAM이 지워졌고 실제 바퀴 각도를 읽을 수단이 없다), 이후
  // 모든 정지 경로에서는 각도를 유지한다(§34-7).
  motorDriverInit();
  steeringInit();

  // **비블로킹이다.** 접속을 여기서 기다리면 폰 핫스팟이 뜨기 전까지 부팅이 멈춰
  // comm_task 의 Serial.begin(921600) 이 실행되지 않고 젯슨 핸드셰이크가 통째로
  // 실패한다. 수동 채널이 자율 주행의 기동 조건이 되어서는 안 된다.
  manualWebInit();

  // steeringInit()은 PWM duty 0인 disarmed 상태로 끝난다. 모든 주변장치 초기화가
  // 끝난 지금 공유 상태만 arm하고, 아래에서 시작하는 유일한 액추에이터 태스크가
  // 첫 50Hz 갱신 때 기본 중립 145°에 해당하는 펄스를 곧바로 출력하게 한다.
  // 0°/1500µs 같은 임시 펄스를 거치지 않으므로 종료 전 같은 중립에 있었다면 큰
  // 재이동이 없다. setup() 앞 구간은 GPIO18 외부 10kΩ pull-down이 LOW로 유지한다.
  motorSharedStateUpdate([](MotorSharedState& s) { s.servoArmed = true; });

  // core 1: 제어와 시리얼. core 0: WiFi/lwIP 와 웹.
  //
  // WiFi 태스크가 core 0 에 고정돼 있으므로 웹 태스크도 그쪽에 둬서, 100Hz 제어
  // 루프와 921600 RX 폴에서 소켓 작업을 물리적으로 분리한다.
  xTaskCreatePinnedToCore(controlTaskFn, "control_task", CONTROL_TASK_STACK_BYTES, nullptr,
                           CONTROL_TASK_PRIORITY, nullptr, 1);
  xTaskCreatePinnedToCore(manualWebTaskFn, "manual_web", MANUAL_WEB_TASK_STACK_BYTES,
                           nullptr, MANUAL_WEB_TASK_PRIORITY, nullptr, 0);

  // 메모리 부족 등으로 별도 통신 태스크 생성이 실패해도 Jetson 링크를 완전히
  // 잃지 않는다. setup()을 실행 중인 Arduino loopTask가 같은 루프를 맡는다.
  if (commTaskResult != pdPASS) {
    commTaskFn(nullptr);
  }
}

void loop() {
  // 모든 동작은 FreeRTOS 태스크(comm_task, control_task)가 담당한다.
  vTaskDelay(pdMS_TO_TICKS(1000));
}
