Common-AIOT/Sentinel-UGV/ai/detection/configs/pipeline.jetson.yaml

# Sentinel UGV - 객체탐지 파이프라인 설정 [Jetson Orin Nano 8GB 프로파일]
#
# 사용:
#   python -m src.main --config configs/pipeline.jetson.yaml --source 0
#
# 개발 PC 프로파일(configs/pipeline.yaml)과 다른 점만 주석으로 설명한다.
# 판정 임계값은 두 프로파일이 같아야 한다. 다르면 PC에서 맞춘 값이 로봇에서 달라진다.
#
# ⚠️ 자원 전제
# Orin Nano 8GB는 SLAM·Nav2·WebRTC와 메모리·연산을 나눠 쓴다
# (docs/07-AI-탐지.md, ai/README.md). 비전이 자원을 독점하면 주행이 멈춘다.
# 명세 목표는 Detect 상시 약 15FPS, Pose 조건부 약 2FPS다(25.6).

# 이 프로파일은 TensorRT 엔진만 받는다 (S15P11A301-329).
#
# 이전에는 model 값이 .pt 였고 엔진은 --model 인자로만 들어왔다. 인자를 빼먹으면
# **조용히 PyTorch 로 떨어진다** — 결과는 정상으로 나오고 로그도 조용한데 프레임당
# CPU 가 +145ms(43% 느려짐)다. 이 함정에 실제로 빠져 측정 결론 하나를 틀렸다.
#
# 엔진이 없으면 굽는 명령을 담아 죽는다(model_backend.py). 엔진은 기기·드라이버
# 종속이라 커밋되지 않으므로 SD카드를 다시 굽거나 JetPack 을 올린 뒤에는 다시
# 구워야 하고, 그때 이 예외가 그 사실을 알려준다.
#
# 개발 PC 프로파일(configs/pipeline.yaml, src/main.py 의 기본값)은 이 플래그가
# 없어 .pt 로 종전대로 돈다.
require_engine: true

detector:
  # 엔진 빌드 (Jetson에서 직접, 약 425초). PYTHONPATH 없으면 tensorrt 임포트 실패.
  #
  #   PYTHONPATH=/usr/lib/python3.10/dist-packages \
  #     .venv/bin/yolo export model=models/yolo26n.pt format=engine half=True device=0
  #
  #   PYTHONPATH=/usr/lib/python3.10/dist-packages \
  #     .venv/bin/python -m src.main --config configs/pipeline.jetson.yaml \
  #     --source 0 --device 0
  #
  # 실측: 12.82 → 16.23 FPS (+26.6%), detect 72.4 → 52.5ms, 탐지력 손실 없음
  model: models/yolo26n.engine
  target_classes:
    - person
  confidence: 0.50
  iou: 0.70
  # 로봇용 트래커 설정. ReID는 꺼져 있다(명세 준수).
  # 2026-08-05에 잠시 켰다가 같은 날 되돌렸다 — 젯슨 담당자 미채택.
  # 껐을 때 무엇을 포기하는지와 다시 켜는 법은 configs/tracker_jetson.yaml 주석에 있다.
  tracker: configs/tracker_jetson.yaml
  # 추론 해상도. 개발 PC 실측(사람 4명): 640 → 19.7 FPS / 480 → 23.5 FPS (약 +19%)
  # 480은 작은 사람(멀리 있는 요구조자) 탐지력이 떨어진다. 재난 탐색에서
  # person false negative가 최우선 리스크이므로(AGENTS.md §23) 640을 유지하고,
  # FPS가 부족하면 해상도보다 TensorRT를 먼저 시도한다.
  imgsz: 640

  # FP16 — Jetson 실측 완료(2026-07-31, S15P11A301-98)
  #
  # .pt 경로에서는 detect 커널에 실질 영향이 없다. 켜도 꺼도 FPS가 같다(+0.7%, 잡음 수준).
  #     FP32 12.45 FPS  vs  FP16 12.54 FPS   (런 간 편차가 ±3%)
  # Pose만 5.2 → 2.8ms로 줄지만 Jetson에서 Pose 비중이 7%라 총 FPS에 안 잡힌다.
  #
  # TensorRT 엔진(.engine)에는 half=True로 FP16이 이미 구워져 있다.
  # 따라서 --model로 엔진을 넘기면 이 값은 Pose에만 적용된다.
  #
  # ⚠️ 개발 PC(x86)에서 이 프로파일을 돌릴 때는 이 줄을 지운다. 거기서는 4배 느리다
  #    (FP32 19.69 vs FP16 4.86 FPS). 이 현상은 Jetson에서 재현되지 않는다.
  quantize: 16

# USB 카메라 (BRIO 100). 명세 PoC 실측: /dev/video0, 1280x720 MJPEG 약 29.93 FPS
# (docs/05-통신-서버-영상.md:26)
#
# ⚠️ 실제 로봇 통합 시에는 이 경로를 쓰지 않는다.
# 명세 32-3: "카메라를 OpenCV, YOLO 프로세스, MediaMTX가 각각 열지 않는다.
#             usb_cam 노드만 /dev/video*를 열고 압축 토픽으로 발행한다."
# 카메라 하나를 AI·WebRTC·이벤트 녹화가 나눠 쓰므로, 우리가 직접 열면 다른 소비자가 막힌다.
# 아래 설정은 **ROS2 통합 전 단독 검증용**이다.
camera:
  width: 1280
  height: 720
  # USB 대역폭 한계상 720p 이상에서 무압축(YUY2)은 FPS가 급락한다.
  fourcc: MJPG
  # Linux/Jetson USB 카메라 표준 경로
  backend: v4l2
  fps: 30

# Pose 실행 조건 (명세 25.6). Jetson에서 특히 중요하다.
# 매 프레임 사람 수만큼 Pose를 돌리면 Detect FPS를 유지할 수 없다.
pose_trigger:
  min_bbox_width: 80
  min_bbox_height: 80
  activate_after_frames: 3
  max_fps: 2.0
  deactivate_after_seconds: 3.0
  # 명세 431행의 "약 2FPS, 전체 화면 분석"은 파이프라인 전체 예산이다.
  # true면 사람이 몇 명이든 초당 Pose 실행이 max_fps로 묶이고, 자격을 갖춘
  # 사람들에게 라운드로빈으로 배분된다.
  #
  # false면 track별로만 제한되어 사람 N명일 때 초당 2N회가 된다. 이것이
  # Jetson 실측(S15P11A301-150, 사람 4명)에서 기대 약 127회 대비 300회가
  # 기록된 원인이다. A/B 비교할 때만 false로 두고, 평소에는 true를 유지한다.
  global_budget: true

pose:
  # 엔진 빌드. **imgsz를 아래 값과 같게 굽는다** — 엔진은 입력 크기가 고정이다.
  #
  #   PYTHONPATH=/usr/lib/python3.10/dist-packages \
  #     .venv/bin/yolo export model=models/yolo26n-pose.pt format=engine \
  #     half=True device=0 imgsz=320
  #
  # pose만 PyTorch로 남아 있었다(S15P11A301-329). S15P11A301-186이 "이 워크로드에서
  # 유효한 지렛대는 TensorRT뿐"이라고 결론 내렸는데 그 해법을 탐지에만 적용했다.
  # 대가는 단독 호출 CPU 41.3ms — 입력이 절반인데 탐지 엔진(11.3ms)의 3.7배다.
  # 파이프라인 안에서는 호출당 118ms로 프레임 시간의 13%를 차지했다.
  model: models/yolo26n-pose.engine
  confidence: 0.50
  keypoint_confidence: 0.50
  crop_margin: 0.10
  # crop 입력이라 640은 과하다. 개발 PC 실측(FP16 기준): 320 → 4.86 / 640 → 7.38 FPS.
  # FP16 영향이 섞인 수치이므로 Jetson에서 재측정한다. 320을 기본으로 둔다.
  #
  # **이 값을 바꾸면 엔진을 같은 imgsz로 다시 굽는다.** 엔진 입력이 고정이라
  # 어긋나면 Ultralytics가 매 호출 리사이즈하거나 실패한다.
  imgsz: 320
  # detector의 quantize와 동일한 주의사항이 적용된다. Jetson에서 실측 후 결정.
  quantize: 16

# 판정 임계값은 개발 PC 프로파일과 동일하게 유지한다.
# 실측 근거가 없는 임의값이므로(AGENTS.md §15) 테스트 영상으로 조정한 뒤 양쪽에 같이 반영한다.
posture:
  torso_horizontal_deg: 55.0
  bbox_aspect_ratio: 1.20
  vertical_extent_ratio: 0.25
  # 상체가 거의 수직이면 vertical_extent 신호를 버린다(개발 PC 프로파일 주석 참고).
  # 하체가 가려져 엉덩이 keypoint가 잘못 찍힐 때 생기는 오탐을 막는다.
  # 실측 2026-08-04: FALLEN 22.4% → 13.1%, 실제 쓰러짐 트랙 점수는 불변.
  upright_angle_deg: 30.0
  min_valid_keypoints: 4
  # 카메라 광축(앞뒤) 기울기 반영. torso_angle_deg는 이미지 좌표 기준이라
  # 좌우 기울기만 잡는다. 복도 방향으로 누운 사람이 사각지대가 되므로,
  # 어깨 폭 대비 상체 단축률로 앞뒤 기울기를 추정해 큰 쪽을 쓴다.
  depth_tilt: true
  # 똑바로 선 사람의 (상체 길이 / 어깨 폭) 기대비.
  # ⚠️ 해부학 통념값이며 실측 근거가 없다. 실영상 확보 후 조정할 것.
  torso_shoulder_ratio: 1.3
  # --- 점수화 (2026-08-03, 이진 분류 전환) ---
  # 각 신호를 임계값 기준 시그모이드로 0~1에 매핑해 가중 평균한다.
  # 이산 투표에서는 54도와 10도가 똑같이 "표 없음"이었지만 점수는 이를 구분한다.
  #
  # ⚠️ 아래 가중치와 폭은 실측 근거가 없다. 라벨 데이터 확보 후 로지스틱 회귀로
  #    교체할 자리다(계획 2단계). "검증됨"으로 보고하지 않는다.
  #
  # 가중 평균 점수가 이 값 이상이면 FALLEN.
  fallen_threshold: 0.5
  # 자세·형상 신호의 가중치.
  weight_torso_angle: 1.0
  weight_vertical_extent: 1.0
  weight_bbox_aspect: 0.8
  # 부동은 가중치가 아니라 **배수**다. 부동 1.0일 때 점수가 (1 + 이 값)배가 된다.
  #
  # 독립 항으로 더하면 가중 평균의 일정 비율을 무조건 채워, 형상이 애매할 때
  # 부동이 대신 점수를 밀어 올린다. 실측(2026-08-03)에서 부동이 1.0일 때
  # FALLEN이 되는 가로비가 1.47 → 0.93으로 떨어졌다. 0.93은 거의 정사각형이라
  # 상반신만 잡힌 앉은 사람도 걸린다.
  #
  # 곱셈이면 자세·형상 점수가 낮을 때 부동이 아무리 커도 결과가 낮게 유지된다.
  # 문헌의 "최종 몸 방향 + 바닥에 머문 시간" 조합이 이 형태다.
  inactivity_boost: 0.4
  # 시그모이드 폭. 임계값에서 이만큼 떨어지면 약 0.73/0.27이 된다.
  # 작을수록 예전 이산 판정에 가까워진다.
  width_torso_angle: 12.0
  width_vertical_extent: 0.08
  width_bbox_aspect: 0.25
  smoothing_window: 5

# 움직임 추적 — 부동(inactivity) 신호.
# 문헌의 쓰러짐 탐지는 "하강 속도, 최종 몸 방향, 바닥에 머문 시간"을 함께 가중한다.
# 관절이 하나도 안 잡혀도 동작하므로, 누운 사람의 관절이 가려지는 상황을 보완한다.
motion:
  # bbox 크기 대비 이 비율 미만으로 움직이면 "정지"로 본다.
  # 크기로 정규화해 카메라 이동과 거리 편차의 영향을 줄인다.
  still_ratio: 0.06
  # 이 시간(초) 이상 정지해 있으면 부동 점수가 1.0이 된다.
  full_still_seconds: 3.0

# 통로를 막을 만한 사물 표시.
#
# 선정 기준과 제외 51종의 사유는 configs/pipeline.yaml 주석에 있다. 두 프로파일의
# 목록은 같아야 한다. 다르면 개발 PC에서 확인한 화면이 로봇에서 달라진다.
#
# ⚠️ **충돌 회피에 쓰지 않는다.** 명세가 AI를 장애물 회피에서 제외했고
#    (docs/01-프로젝트-개요.md:136), 물리 회피는 LiDAR/Nav2가 담당한다.
#    "COCO에 없는 물체도 거리 기반으로 처리한다"가 명세의 방식이며, 잔해처럼
#    COCO에 없는 것이 재난 현장의 대부분이다. 이 표시는 관제 화면용이다.
#
# ⚠️ **FPS 영향을 반드시 실측한다.** Orin Nano 8GB는 SLAM·Nav2·WebRTC와 자원을
#    나눠 쓰고 Detect가 이미 목표 15FPS에 미달이다(실측 9.45).
#
#    비용을 줄이는 구조는 갖췄다 — 추적을 붙이지 않고(predict), max_fps로 저빈도만
#    돌리며, 사이 프레임은 직전 결과를 재사용한다. 그래도 추론이 하나 더 들어가는
#    것은 사실이다. 부담되면 max_fps를 0.5로 낮추거나 classes를 비워 끈다.
obstacle:
  classes:
    # 바닥에 서 있어 통과 불가 (13)
    - chair
    - couch
    - bed
    - dining table
    - bench
    - potted plant
    - refrigerator
    - oven
    - toilet
    - suitcase
    - backpack
    - handbag
    - bicycle
    # 설치 방식에 따라 갈림 (5)
    - tv
    - sink
    - umbrella
    - vase
    - motorcycle
    # 바닥에 있으면 걸림돌이나 실내 재난 현장에 드묾 (11)
    - skateboard
    - skis
    - snowboard
    - sports ball
    - baseball bat
    - tennis racket
    - frisbee
    - baseball glove
    - surfboard
    - teddy bear
    - kite
  # 탐지 빈도(Hz). 의자는 움직이지 않으므로 초당 1회면 충분하다.
  max_fps: 1.0

memory:
  forget_seconds: 10.0
  min_track_buffer: 10
  max_track_buffer: 900

persistence:
  person_confirm_seconds: 1.0
  fallen_seconds: 1.5
  event_cooldown_seconds: 15.0
  inherit_distance_ratio: 1.0

output:
  # 프레임 로그는 SD카드 수명과 용량을 잡아먹는다. Jetson에서는 기본 비활성.
  write_frame_log: false
  jsonl_frames: frames.jsonl
  jsonl_events: events.jsonl
  events_dir: events

  # 이벤트 증빙 이미지 보존 상한 (S15P11A301-265). 초과하면 오래된 것부터 지운다.
  #
  # 상한이 없으면 총량이 **장면에 따라** 결정된다. 이벤트 쿨다운은 트랙별이라
  # (persistence.py) 사람 1명당 15초이고, 6명이 상시 잡히면 24 이벤트/분,
  # 8시간이면 1만 장이 넘는다. 실제로 run 하나가 1.2G 까지 커져 디스크가 찼다.
  #
  # **바이트가 주 기준이다.** 장당 크기가 장면 복잡도와 overlay 유무에 따라
  # 달라지므로 개수로 묶으면 총량이 다시 흔들린다. 막고 싶은 것이 디스크이므로
  # 디스크를 직접 잰다.
  #
  # 장당 크기 실측: **165KB** (1280x720, cv2.imwrite 기본 화질, 실물 카메라
  # 프레임 12장의 중앙값. 최소 163 / 최대 168KB 로 편차가 작다).
  #
  # 500MB = 약 3,100장이다. 관측 시점 디스크 여유가 5.6G, 하루 3 run 이었으니
  # 세 run 이 상한까지 차도 1.5G 로 들어온다.
  #
  # 보존 시간으로 환산하면 장면에 따라 크게 다르다. 사람 6명이 상시 잡히는
  # 사무실(24 이벤트/분)에서는 **2.2시간 분**이고, 시연 상황처럼 요구조자가
  # 한두 명이면 며칠 분이다. 상한의 목적은 "며칠 치를 남긴다" 가 아니라
  # **"장면이 어떻든 디스크가 차지 않는다"** 이다.
  events_max_bytes: 524288000
  # 개수 상한은 보조 안전망이다. 165KB 기준으로는 위 바이트 상한이 3,100장에서
  # 먼저 걸리므로 **이 값은 지금 발동하지 않는다.** 화질을 낮추거나 해상도를
  # 줄여 장당 크기가 100KB 아래로 내려가면 그때 파일 수가 먼저 문제가 된다
  # (디렉터리 조회가 느려진다). 그 경우를 위해 남겨 둔다.
  events_max_files: 5000

  draw_overlay_on_event_image: true
  # 이벤트 확정 프레임에만 Pose를 강제 실행해 증빙 이미지에 골격을 남긴다.
  # Jetson은 헤드리스라 상시 overlay를 그리지 않으므로, 관절을 볼 수 있는 건
  # 이 이벤트 이미지뿐이다. 실측 기준 Pose 1회 약 82ms인데 쿨다운이 15초라
  # 추가 부하는 0.5% 미만이다. 상시 Pose(FPS 절반 이하)와 혼동하지 않는다.
  pose_on_event: true

report:
  schema_version: "1.0"
  robot_id: SENTINEL-01
  mission_id: null
