Common-AIOT/Sentinel-UGV/jetson/ros2_ws/src/sentinel_bringup/config/brio_100.yaml

/**:
  ros__parameters:
    video_device: /dev/video0
    framerate: 30.0
    io_method: mmap
    frame_id: camera_optical_frame
    pixel_format: raw_mjpeg
    av_device_format: YUV422P
    image_width: 1280
    image_height: 720
    camera_name: brio_100
    camera_info_url: ""
    brightness: -1
    contrast: -1
    saturation: -1
    sharpness: -1
    gain: -1
    auto_white_balance: true
    white_balance: 4000
    autoexposure: true
    exposure: 100
    autofocus: false
    focus: -1
