Common-AIOT/Sentinel-UGV/jetson/ros2_ws/src/esp32_bridge/test/test_motor_packet_codec.py

"""motor_packet_codec의 동기워드+고정길이+CRC8 프레이밍 계약 시험 (S15P11A301-321).

rclpy를 import하지 않으므로 브로커/ROS 없이 돈다(sentinel_bridge의
message_mapper/mqtt_client 테스트, 그리고 이 패키지의 test_packet_codec.py와
같은 패턴이라 CI에서도 실행할 수 있다).

CRC-8 손계산 벡터와 프레임 상수는
`hardware/esp32/motor/esp32_motor_comm/motor_protocol.h`/`test/test_motor_protocol.cpp`
와 동일한 값이다 - 한쪽을 바꾸면 반드시 다른 쪽도 함께 확인할 것.
"""

from __future__ import annotations

import sys
from pathlib import Path

import pytest

sys.path.insert(0, str(Path(__file__).resolve().parents[1]))

from esp32_bridge.motor_packet_codec import (
    DriveState,
    pack_drive_state,
    unpack_drive_state,  # noqa: E402
    CrcError,
    DriveCommand,
    LengthError,
    MotorDiagnostic,
    SetMode,
    SyncError,
    build_motor_frame,
    crc8,
    is_motor_sequence_newer,
    pack_drive_command,
    pack_motor_diagnostic,
    pack_set_mode,
    parse_motor_frame,
    unpack_drive_command,
    unpack_motor_diagnostic,
    unpack_set_mode,
)
from esp32_bridge.motor_protocol_constants import (
    AUTHORITY_FLAG_MANUAL_FALLBACK,  # noqa: E402
    BOARD_MODE_AUTO,
    BOARD_MODE_MANUAL,
    BOARD_ROLE_MOTOR,
    FRAME_BYTES,
    MSG_DRIVE_COMMAND,
    MSG_HELLO,
    MSG_SET_MODE,
    PAYLOAD_BYTES,
    SYNC0,
    SYNC1,
)


# ---- CRC-8: 손계산으로 검증한 벡터 (motor_protocol.h 헤더 주석 참고) ----


def test_crc8_of_empty_input_is_init_value():
    assert crc8(b"") == 0x00


def test_crc8_hand_verified_vectors():
    # poly=0x07, init=0x00. 단일 비트 1개짜리 바이트는 그 비트가 최상위까지 밀려
    # 올라가는 시프트 횟수만큼만 다항식이 섞이므로 손으로 추적 가능하다.
    assert crc8(bytes([0x01])) == 0x07
    assert crc8(bytes([0x02])) == 0x0E


def test_frame_constants():
    assert PAYLOAD_BYTES == 22
    assert FRAME_BYTES == 27


def test_build_frame_has_sync_word_and_fixed_length():
    frame = build_motor_frame(MSG_HELLO, sequence=7)
    assert len(frame) == FRAME_BYTES
    assert frame[0] == SYNC0
    assert frame[1] == SYNC1


def test_build_and_parse_frame_round_trip_hello():
    frame = build_motor_frame(MSG_HELLO, sequence=7)
    parsed = parse_motor_frame(frame)
    assert parsed.message_type == MSG_HELLO
    assert parsed.sequence == 7
    assert parsed.payload == bytes(PAYLOAD_BYTES)  # 0-length payload는 전부 0-패딩


def test_set_mode_byte_vector_matches_cpp():
    # C++ 쪽이 못박는 것과 같은 벡터. 한쪽 struct 포맷을 바꾸면 여기가 먼저 깨진다.
    assert pack_set_mode(SetMode(BOARD_MODE_AUTO, 0)) == bytes.fromhex("0200")
    assert pack_set_mode(SetMode(BOARD_MODE_MANUAL, 0)) == bytes.fromhex("0100")


def test_set_mode_frame_round_trip():
    payload = pack_set_mode(SetMode(BOARD_MODE_MANUAL, 0))
    frame = build_motor_frame(MSG_SET_MODE, sequence=11, payload=payload)

    parsed = parse_motor_frame(frame)
    assert parsed.message_type == MSG_SET_MODE
    assert parsed.sequence == 11

    decoded = unpack_set_mode(parsed.payload)
    assert decoded.requested_mode == BOARD_MODE_MANUAL
    assert decoded.flags == 0
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
