Common-AIOT/Sentinel-UGV/(commit log)

2026-07-14 README 생성
2026-07-20 chore(root): S15P11A301-55 모노레포 초기 구조 구축
2026-07-21 ci(root): S15P11A301-60 GitLab 기본 파이프라인 구축
2026-07-21 chore(root): S15P11A301-61 공통 개발·실행 환경 및 Docs 구축
2026-07-22 documentation(docs): S15P11A301-63 브랜치 명명 규칙과 MR 템플릿 추가
2026-07-22 feature(backend): S15P11A301-36 스프링부트 초기 세팅 및 공통 예외/배포 환경 구성
2026-07-22 chore(backend): S15P11A301-37 백엔드 도커 배포 자동화 및 시크릿 주입
2026-07-22 fix(deploy): S15P11A301-37 깃랩 파이프라인 배포 룰 충돌 에러 수정
2026-07-23 docs(docs): S15P11A301-64 통합 명세서 분할 및 문서 구조 정리
2026-07-23 feat(ros2): S15P11A301-66 Jetson 카메라 라이다 연동 구성 추가
2026-07-23 docs(docs): S15P11A301-67 rc3 통합 명세서 단일 문서로 정리
2026-07-23 feat(ros2): S15P11A301-66 카메라 드라이버 usb_cam 전환 및 raw_mjpeg 패스스루 적용
2026-07-23 build(ros2): S15P11A301-66 usb_cam 벤더링 제거 및 vcs 패치 방식 전환
    - ydlidar와 동일하게 usb_cam을 gitignore 처리하고 sentinel.repos로 0.8.1 태그 고정
    - raw_mjpeg 패스스루 수정분은 patches/usb_cam-0.8.1-raw-mjpeg-passthrough.patch로 관리
    - 설치 절차에 vcs import 후 패치 적용 단계 반영
2026-07-23 docs(ros2): S15P11A301-70 외부 패키지 패치 관리 문서 추가
2026-07-23 feature(backend): S15P11A301-68 Swagger(OpenAPI) API 문서화 기본 설정 추가
2026-07-24 documentation(docs): S15P11A301-36 DB 스키마 통일 및 운영자 계정 도입
2026-07-24 docs(docs): S15P11A301-73 통합 명세서 v1.1 승격 및 장간 충돌 해소
2026-07-24 documentation(ai): S15P11A301-49 STT LLM TTS 모델 조사
2026-07-24 documentation(ai): S15P11A301-50 STT LLM TTS 모델 테스트
2026-07-24 feature(frontend): S15P11A301-33 Figma 기반 관제 웹 Next.js 스캐폴드 및 UI 구축
2026-07-27 feature(ai): S15P11A301-69 STT LLM TTS 음성 파이프라인 구현
2026-07-27 feat(ros2): S15P11A301-74 sentinel_description TF 정적 골격 패키지 추가
    [sentinel.urdf]
2026-07-27 docs(ai): S15P11A301-108 GMS 오프라인 정책 명세 반영
2026-07-27 fix(camera): S15P11A301-62
2026-07-27 docs(ai): S15P11A301-109 대화 안전 정책 확정
2026-07-27 docs(ai): S15P11A301-110 정량 검증 기준 정의
2026-07-27 test(ai): S15P11A301-111 오디오 입출력 검증 도구 추가
2026-07-27 feature(backend): S15P11A301-121 MinIO 기반 미디어 스토리지 연동
2026-07-27 feat(streaming): S15P11A301-106 스트리밍 경로 노드와 MediaMTX 구성 추가
2026-07-27 feat(ai): S15P11A301-112 다턴 대화 상태머신 구현
2026-07-27 ci(deploy): S15P11A301-87 프런트엔드 Vercel 자동 배포 파이프라인 추가
2026-07-27 feature(frontend): S15P11A301-107 관제 웹 WHEP 영상 재생 연동
2026-07-28 refactoring(ai): S15P11A301-113 GMS 추출·관제 보고 스키마 정렬
2026-07-28 chore(root): S15P11A301-125 실제로 쓰는 스크립트만 남기고 CI 게이트 추가
2026-07-28 feature(database): S15P11A301-126 스키마 Flyway 마이그레이션과 TimescaleDB 전환
2026-07-28 ai detection 경로 생성 및 푸쉬 작업
2026-07-28 feat(jetson): S15P11A301-128 cloud_bridge와 MQTT 공통 계약 구현
2026-07-28 fix(deploy): S15P11A301-127 백엔드 배포를 기본 브랜치로 제한
2026-07-28 feature(ai): S15P11A301-114 사전녹음 안내 음성 구현
2026-07-28 feature(ai): S15P11A301-115 GMS 장애 대응 및 전송 대기 구현
2026-07-28 docs(streaming): S15P11A301-123 이벤트 링 버퍼 및 녹화 상태 머신 구현
2026-07-28 feature(backend): S15P11A301-103 MQTT telemetry 수집과 브로커 배포 구성
2026-07-28 feature(ai): S15P11A301-116 보고 ACK와 탐사 재개 연결
2026-07-28 feat(streaming): S15P11A301-124 Presigned URL 미디어 업로드 구현
2026-07-28 Feature/frontend/s15p11a301 33 gcs prototype ui improvement
2026-07-28 feature(backend): S15P11A301-88 CORS 허용 출처 설정과 프런트 API base URL 주입
2026-07-28 fix(jetson): S15P11A301-134 브로커 접속을 443 WebSocket으로 전환
2026-07-29 feat(ros2): S15P11A301-133 mission_manager로 encounter 발행 권한을 하나로
2026-07-29 ci(deploy): S15P11A301-130 배포 이미지 커밋 SHA 고정과 MR Dockerfile 빌드 검증
2026-07-29 feat(ros2): S15P11A301-135 임무 상태를 관제 state 채널로 중계
2026-07-29 feat(ai): S15P11A301-136 COCO 가중치로 person_candidates 발행
2026-07-29 feature(backend): S15P11A301-132 미디어 업로드 계약 정정과 완료 엔드포인트 신설
2026-07-29 feat(slam): S15P11A301-137 slam_toolbox로 telemetry pose를 채운다
2026-07-29 feature(backend): S15P11A301-138 MQTT ENCOUNTER_CONFIRMED 수신과 encounters 적재 및 example 경로 제거
2026-07-29 fix(ros2): S15P11A301-139 REPORTING 무한 루프와 이벤트 마감 신호 부재를 고친다
2026-07-29 feat(ai-detection): S15P11A301-99 객체탐지 추론 모듈 구현
2026-07-29 docs(ai): S15P11A301-102 객체탐지 문서 위치 및 Jetson 실행 명세 정리
2026-07-29 feature(backend): S15P11A301-105 임무 API와 시계열 그래프 조회 구현
2026-07-29 fix(streaming): S15P11A301-124 mediaId를 UUID로 바꾸고 계약에 pattern을 넣는다
2026-07-29 [S15P11A301-118] GMS 모델 정량 비교 및 GPT-5.4 Mini 운영 전환
2026-07-29 feature(backend): S15P11A301-141 임무 제어 API와 MQTT 명령·ACK 계약 구현
2026-07-29 feat(streaming): S15P11A301-131 이벤트 영상에 오디오 트랙을 넣는다
2026-07-29 feat(jetson): S15P11A301-140 encounter를 events 채널로 중계하고 Outbox를 채운다
2026-07-29 documentation(backend): S15P11A301-144 Swagger 서버 URL 수정과 API 설명 정리
2026-07-29 fix(backend): S15P11A301-144 CORS 허용 출처에 운영 프론트 도메인 추가
2026-07-30 fix(jetson): S15P11A301-142 응답 대기 시간을 올려 중복 녹화 트리거를 없앤다
2026-07-30 feat(streaming): S15P11A301-145 WHEP를 공인 인증서 HTTPS로 연다
2026-07-30 documentation(ai): S15P11A301-150 Jetson 실기기 검증 결과와 트러블슈팅을 runbook에 반영
2026-07-30 feature(ai): S15P11A301-152 객체탐지 파이프라인 ROS2 토픽 구독 wrapper 추가
2026-07-30 feature(backend): S15P11A301-151 encounter 목록·상세 조회 API 구현
2026-07-30 feature(ai): S15P11A301-153 person_candidates 발행을 ai/detection wrapper로 이관
2026-07-30 documentation(streaming): S15P11A301-158 실제 탐지 노드 기준 이벤트 MP4 검증 기록과 다중 탐지 발행자 주의 추가
2026-07-30 feat(ai): S15P11A301-117 비전 트리거로 음성 세션을 연결한다
    Mission Manager가 발행하는 /perception/encounter를 받아 음성 세션의 시작·중복
    억제·보고 문맥을 결정하는 코디네이터를 추가한다. 실제 ROS 2 구독 노드와
    Mission Manager 상태 통지는 후속 작업이다.
2026-07-30 feature(ai): S15P11A301-157 다턴 대화 상태머신과 실제 오디오·GMS·안내음성 연결
2026-07-30 feature(ai): S15P11A301-155 detection wrapper launch 추가와 mission_manager 연동 실측 반영
2026-07-30 fix(backend): S15P11A301-154 미디어 발급 s3_key 충돌을 409로 반환
2026-07-30 test(ai): S15P11A301-157 젯슨 음성 세션 실측 결과 기록
2026-07-30 hardware(control): S15P11A301-76 주행 모터 테스트
2026-07-30 feature(backend): S15P11A301-166 임무 종료 시 mission_results 집계 적재
2026-07-30 feat(jetson): S15P11A301-156 데모 스택 자동 기동을 통합한다
2026-07-30 fix(streaming): S15P11A301-161 링 교착을 감지하고 복구한다
    [media.yaml]
2026-07-30 docs(jetson): S15P11A301-156 데모 자동 기동 절차를 기록한다
2026-07-30 docs(streaming): S15P11A301-161 재부팅 검증 결과를 기록한다
2026-07-30 ci(jetson): S15P11A301-156 ROS 환경 소싱의 ShellCheck 예외를 명시한다
2026-07-30 docs(docs): S15P11A301-162 하드웨어 스택 확정 반영
2026-07-30 test-hardware-S15P11A301-79-엔코더 동작 테스트
2026-07-30 fix(jetson): S15P11A301-160 이르게 도착한 REPORT_COMMITTED를 기억한다
    INTERACTING 또는 POST_RECORDING 중 같은 encounter의 REPORT_COMMITTED를 보존하고, 사후 녹화가 끝나면 REPORTING에서 영구 대기하지 않고 EXPLORING으로 복귀한다.
    encounter가 임무 종료나 수동 재개로 폐기될 때 선도착 표시도 함께 정리한다. 정상 순서, 다른 encounter, POST_RECORDING 선도착, 표시 수명주기를 회귀 시험으로 고정했다.
    sentinel_mission 49개와 전체 계약 시험 176개, ROS 패키지 빌드를 통과했다.
2026-07-30 feat(ros2): S15P11A301-159 음성 세션 통합 연결
2026-07-30 feature(frontend): S15P11A301-169 관제 화면 목데이터를 실 API로 전환
2026-07-30 feat(hardware): S15P11A301-84 ESP32-Jetson USB 직렬 통신 계층 구현
    - COBS+CRC16 프레이밍, 메시지/페이로드 정의를 hardware/esp32/jetson-comm 공유 라이브러리로 구현
    - 모터/센서 ESP32에 HELLO 핸드셰이크, STOP/ESTOP, 300ms 통신 워치독 스케치 추가 (BTS7960/센서 실측 로직은 후속 티켓 스텁)
    - Jetson 쪽 jetson/ros2_ws/src/esp32_bridge ROS2 패키지 신규 작성 (packet_codec, serial_transport, 브리지 노드 2개, hello_check 도구)
    - hardware/README.md에 esp32/ 디렉토리 안내 추가
2026-07-30 fix(hardware): S15P11A301-84 jetson-comm을 Arduino 라이브러리로 재구성하고 ESP32 auto-reset 레이스 수정
    - jetson-comm을 library.properties+src/ 구조로 바꿔 Arduino IDE가 protocol.cpp를 실제로 컴파일·링크하게 함
    (상대경로 include만으로는 undefined reference 링크 오류 발생 확인)
    - 두 스케치의 include를 <protocol.h>/<fault_codes.h>로 변경, 설치 방법(디렉터리 정션)을 README에 반영
    - pyserial이 DTR/RTS를 assert한 채로 두면 ESP32 auto-reset 회로가 보드를 리셋에 계속 붙잡는 문제를 SerialTransport에서 수정 (연결 후 DTR/RTS 해제 + 부팅 안정화 대기 + 잔재 버퍼 flush)
    - esp32_hello_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
    [comm_task.cpp, control_task.cpp, fault_codes.h, message_ids.h, packet_codec.py, protocol.cpp, protocol.h, protocol_constants.py]
2026-07-30 fix(frontend): S15P11A301-175 임무 상태 동기화·제어 버그 수정
2026-07-30 fix(jetson): S15P11A301-173 라이다 포트를 udev 고정 이름으로 바꾼다
2026-07-30 feat(jetson): S15P11A301-176 실시간 시각화를 자동화에 넣는다 (기본 꺼짐)
2026-07-30 docs(docs): S15P11A301-176 IMU 센서 ESP32 연결 구조 반영
    [sentinel.urdf]
2026-07-30 perf(ai): S15P11A301-98 Pose 전역 예산 적용과 단계별 계측 도구 추가
    Jetson 실기기 검증(S15P11A301-150)에서 9.45FPS로 목표 약 15FPS에 미달했으나,
    Detect와 Pose 중 어디서 시간을 쓰는지 계측할 방법이 없었다.
    PoseScheduler가 track별로만 실행을 제한해 사람 N명일 때 초당 2N회가 실행됐다.
    25.6의 "약 2FPS"는 파이프라인 전체 예산이므로 전역 제한을 추가하고, 자격을 갖춘
    track에 라운드로빈으로 배분한다. 개발 PC 동일 영상 A/B에서 Pose 30회에서 10회로
    줄고 detections는 571로 동일해 탐지력 손실이 없음을 확인했다.
    PipelineStats에 detect/pose/post 구간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
2026-07-30 feat(ai): S15P11A301-119 Jetson 자원 측정 도구를 추가한다
2026-07-30 docs(ai): S15P11A301-181 STT 문서를 단일 기준 문서로 통합한다
2026-07-30 feat(ai): S15P11A301-183 ROS 경로에 세션 종료 안내 연결
2026-07-30 fix(ai): S15P11A301-179 세션 미완료 시 수집한 위험도 보존
2026-07-31 feat(jetson): S15P11A301-170 encounter에 SLAM 위치를 스탬프한다
2026-07-31 fix(backend): S15P11A301-184 잘못된 요청의 500 응답을 400·404·405로 수정
2026-07-31 fix(ai): S15P11A301-179 세션 예산 기본값 중복 제거와 주석 정리
2026-07-31 feat(jetson): S15P11A301-171 임무 종료 시 SLAM 지도를 로컬에 저장한다
2026-07-31 feature(ai): S15P11A301-178 대화 세션 기록과 청취 원본 저장
2026-07-31 feature(backend): S15P11A301-185 지도 업로드 API 발급·완료 구현
2026-07-31 docs(ai): S15P11A301-98 Jetson TensorRT 실측 결과와 성능 조정 기준 반영
    Jetson 실기기 A/B에서 TensorRT 엔진이 12.82 → 16.23 FPS(+26.6%)로 detections
    손실 없이 개선됨을 확인했다. detect 단계가 72.4ms에서 52.5ms로 줄었다. 반면
    FP16은 .pt 경로에서 효과가 없고(+0.7%, 런 간 편차 ±3% 이내), 전원 모드 15W는
    Orin Nano 8GB의 상한이라 조정 대상이 아니다.
    25.7의 성능 조정 순서를 이 실측에 맞춰 다시 썼다. 병목 예시도 개발 PC 81%가
    아니라 Jetson 실측 93%로 바꿨다. Jetson은 Detect 편중이 더 심해 Pose 쪽 조정의
    여지가 거의 없다.
    TensorRT export가 문서대로 실행하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
2026-07-31 docs(streaming): S15P11A301-145 VID-01 측정 결과를 기록한다
2026-07-31 fix(streaming): S15P11A301-186 인코딩 출력을 명세대로 15FPS로 내린다
    [media.yaml]
2026-07-31 feature(jetson): S15P11A301-171 저장된 SLAM 지도를 백엔드에 업로드한다
2026-07-31 feature(backend): S15P11A301-187 지도 조회 view-url API 구현
2026-07-31 documentation(docs): S15P11A301-188 시각화 켜는 방법과 재빌드 함정을 남긴다
2026-07-31 fix(ai): S15P11A301-165 안내 음성 에코 오인 차단과 무응답·재질문 흐름 정리
2026-07-31 fix(jetson): S15P11A301-190 telemetry 봉투에 missionId를 담는다
2026-07-31 fix(streaming): S15P11A301-191 스트리밍 인코딩을 30FPS로 되돌린다
    [media.yaml]
2026-07-31 feature(backend): S15P11A301-189 지도 발급 요청의 클라이언트 mapId 수용
2026-07-31 fix(jetson): S15P11A301-192 탐지 노드 부재를 관제에 알리고 재기동한다
2026-07-31 docs(jetson): S15P11A301-190 telemetry 적재 실패 원인 서술을 정정한다
    코드 주석과 테스트 docstring에 "robot_pose.mission_id가 NOT NULL이므로
    missionId가 비면 INSERT가 제약 위반으로 실패한다"고 적었다. 사실이 아니다.
    V2__telemetry_mission_id_nullable.sql이 robot_pose·robot_metrics·
    environment_metrics·network_metrics·safety_events의 mission_id NOT NULL을 이미
    해제했다. V1__init_schema.sql만 읽고 결론을 냈다.
    실제로는 INSERT가 성공하고 mission_id가 null인 행이 적재된다(실측 32,366건).
    서버 ERROR 로그도 48시간 0건이다. 위반이었다면 행 자체가 없다.
    증상과 수정은 그대로 유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
2026-07-31 feature(jetson): S15P11A301-193 mapId를 임무 시작에 발급하고 지도 메타데이터를 담는다
2026-07-31 feature(backend): S15P11A301-194 임무 궤적 조회 API 구현
2026-07-31 fix(hardware): S15P11A301-195 좌우 모터 차동 구동으로 탱크 드라이브를 제어한다
2026-07-31 feature(frontend): S15P11A301-196 관제 화면을 2페이지로 간소화한다
2026-07-31 feature(backend): S15P11A301-197 지도 완료 본문 수용과 조회 메타데이터 확장
2026-07-31 feature(frontend): S15P11A301-200 메인 화면 오버레이를 통일하고 근거 없는 지표를 뺀다
2026-08-03 feat(frontend): S15P11A301-200 메인 화면 오버레이를 통일하고 근거 없는 지표를 뺀다
2026-08-03 docs(ai): S15P11A301-198 클라우드 전환 실측 기록과 재현 도구
2026-08-03 feature(hardware): S15P11A301-174 센서·모터 ESP32에 실측 액추에이션·판독 코드를 구현한다
    [sentinel.urdf]
2026-08-03 ci(deploy): S15P11A301-211 기본 브랜치 파이프라인 자동 취소로 인한 배포 누락 차단
2026-08-03 feature(frontend): S15P11A301-212 사이드바 영상에 스트림 경로 한 줄 표시
2026-08-03 feature(jetson): S15P11A301-213 ESP32 온습도와 엔코더 속도를 telemetry에 연결
2026-08-03 feature(ai): S15P11A301-201 재질문 축소와 부상 우선 순서, 종료 안내 단일화
2026-08-03 feature(ai): S15P11A301-149 문구 v2 안내 음성 자산 재생성과 ACK 잔재 정리
2026-08-03 chore(deploy): S15P11A301-216 Foxglove 시각화를 켜고 끄는 스크립트를 넣는다
2026-08-03 chore(deploy): S15P11A301-217 데모 스택을 내리는 스크립트를 넣는다
2026-08-03 feature(frontend): S15P11A301-203 관제 지도 화면 구현
2026-08-03 chore(deploy): S15P11A301-218 Foxglove 다른 팀 ROS 그래프와 DDS 를 격리한다
2026-08-03 feature(backend): S15P11A301-204 임무 상태·발견 변화를 STOMP 로 푸시한다
2026-08-03 documentation(deploy): S15P11A301-221 Foxglove 3D 패널 설정과 레이아웃 공유를 적는다
2026-08-03 feature(frontend): S15P11A301-223 구성요소·잔여 탐사 시간·스트림 경로 설정을 없앤다
2026-08-03 feature(jetson): S15P11A301-222 esp32_bridge 를 데모 스택에 붙이고 odom TF 소유자를 하나로 묶는다
2026-08-03 feature(jetson): S15P11A301-224 foxglove_bridge 를 TLS 읽기전용으로 바꾸고 데모 기본에 넣는다
2026-08-03 feature(frontend): S15P11A301-204 관제 화면을 STOMP 구독으로 실시간 전환
2026-08-03 fix(jetson): S15P11A301-226 cloud_bridge 기동 실패를 고치고 콜백 검증을 CI 에 넣는다
2026-08-03 feature(jetson): S15P11A301-225 데모 스택이 TensorRT 엔진을 쓰게 한다
2026-08-03 feature(ai): S15P11A301-202 블랙박스 오디오 잡음 제거 모듈과 실측 기록
2026-08-03 feature(frontend): S15P11A301-227 메인 화면 미니맵을 실시간 SLAM 지도로 바꾼다
2026-08-03 documentation(ai): S15P11A301-202 EC2 사양 실측 반영
2026-08-03 feature(backend): S15P11A301-205 임무 텔레메트리에 온습도·주행 속도·MCU 연결을 노출한다
2026-08-03 feat(ai): S15P11A301-98 앞뒤 기울기 감지와 이벤트 프레임 Pose 강제 실행
    torso_angle은 이미지 좌표의 dx/dy로 계산해 좌우 기울기만 잡았다. 카메라 광축
    방향으로 기울면 dx가 0에 가까워 각도가 0으로 나온다. 복도를 주행하는 UGV에서는
    복도 방향으로 누운 사람이 정확히 이 배치가 되므로 사각지대였다.
    앞뒤로 기울면 상체는 짧아 보이지만 어깨 폭은 유지된다. 어깨 폭을 자로 삼아
    상체 단축률을 각도로 환산하고 좌우 각도와 큰 쪽을 쓴다. 관측비가 기대비보다
    크면 1로 잘라 0도로 두어 과소 추정 방향으로만 틀리게 했다. 몸을 옆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
2026-08-03 feat(ai): S15P11A301-98 쓰러짐 판정을 이진 분류와 다중 신호 점수로 전환
    pose_status를 STANDING/POSSIBLE_FALLEN/POSE_UNKNOWN 3값에서 NORMAL/FALLEN
    2값으로 바꾼다. POSE_UNKNOWN이 관측의 약 21%를 차지해 다섯 중 하나는 답을 내지
    못했다. 재난 탐색에서 관제가 필요한 답은 쓰러졌나 아닌가 하나다.
    관절에만 의존하던 구조를 바꾼다. 문헌은 누운 자세가 원근 단축 왜곡과 가림 때문에
    pose 추정이 가장 어려운 구간이라고 지적한다. 관절에만 의존하면 가장 필요한 순간에
    가장 약한 신호를 쓰게 된다. 이전 구현은 관절이 부족하면 이미 계산해둔 bbox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
2026-08-03 fix(ai): S15P11A301-98 부동 신호를 가산에서 배수로 바꿔 오탐 경로를 막는다
    부동을 가중 평균의 독립 항으로 더하면 가중치 비율만큼을 무조건 채우고 시작한다.
    그래서 형상이 애매할 때 부동이 대신 점수를 밀어 올렸다. 실측에서 부동이 1.0일 때
    FALLEN이 되는 가로비가 1.47에서 0.93으로 떨어졌다. 0.93은 거의 정사각형이라
    상반신만 잡힌 앉은 사람도 걸린다.
    자세·형상 점수에 곱하는 방식으로 바꾼다. 자세·형상이 낮으면 부동이 아무리 커도
    결과가 낮게 유지된다. 문헌의 최종 몸 방향과 바닥에 머문 시간 조합이 이 형태다.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
    [pipeline.jetson.yaml, pipeline.yaml]
2026-08-03 feature(frontend): S15P11A301-227 메인 화면 지도를 실시간 SLAM 지도로 바꾼다
2026-08-03 fix(frontend): S15P11A301-202 토글 실험판을 현재 관제 페이지 기준으로 재동기
2026-08-03 feature(ai): S15P11A301-120 정답 확정 발화 코퍼스 수집 도구
2026-08-03 feature(ai): S15P11A301-231 추출 판단 완화 (부상·통증·주변 인원)
2026-08-04 fix(jetson): S15P11A301-224 viz 접속 주소를 wss 로 바로잡고 demo_up 이 알려주게 한다
2026-08-04 feature(frontend): S15P11A301-205 센서 카드를 실제 온습도·MCU 연결 상태로 전환
2026-08-04 feature(backend): S15P11A301-228 잡음 제거 오디오 kind를 미디어 업로드 계약에 추가
2026-08-04 feature(ai): S15P11A301-232 KsponSpeech 전사 정규화와 CER·WER 채점
2026-08-04 feature(frontend): S15P11A301-229 블랙박스 영상에 소음 제거본 토글 추가
2026-08-04 test(ai): S15P11A301-232 KsponSpeech 오류율 벤치와 공식 평가 셋 실측 기록
2026-08-04 documentation(docs): S15P11A301-239 명세를 v2.0 으로 구현 상태에 맞춘다
2026-08-04 documentation(docs): S15P11A301-245 명세 04를 자율주행과 AI로 분리한다
2026-08-04 feature(deploy): S15P11A301-230 잡음 제거 워커 이미지와 크론 스캔 배치 추가
2026-08-04 feature(ros2): S15P11A301-234 cmd_vel 차동 구동 역운동학 (sentinel_drive)
2026-08-04 feature(ros2): S15P11A301-172 탐사 골격 — frontier·커버리지·선택·스윕 순수 모듈
2026-08-04 fix(ros2): S15P11A301-234 SIGTERM 종료 경로의 rclpy 이중 shutdown 을 고친다
    Nav2 실기동 스모크(S15P11A301-235)에서 발견했다. SIGTERM 이 오면 rclpy 시그널
    핸들러가 컨텍스트를 먼저 내리고 spin 이 ExternalShutdownException 을 던지는데,
    그것을 안 잡아 traceback 이 나고, finally 의 rclpy.shutdown() 이 이미 내려간
    컨텍스트에서 RCLError 를 또 던졌다. systemd 와 demo_down.sh(SIGINT→TERM)의
    정상 종료가 전부 이 경로다 — 매 종료가 오류처럼 보이게 된다.
    - ExternalShutdownException 을 KeyboardInterrupt 와 같이 잡는다
    - shutdown() → try_shutdown() — 살아 있을 때만 내리므로 이중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
2026-08-04 feature(hardware): S15P11A301-244 센서 ESP32에 MPU6050 IMU 실측과 IMU_STATE 송신을 추가한다
2026-08-04 feature(ai): S15P11A301-251 질문 맥락 기반 받아쓰기 되돌리기와 STT 프라이밍 제거
2026-08-04 feature(ros2): S15P11A301-235 Nav2 스택 구성 (NavFn + rotation shim→RPP)
2026-08-04 feature(backend): S15P11A301-243 음성 보고 적재 시 관제로 갱신 신호를 푸시한다
2026-08-04 fix(frontend): S15P11A301-254 라이브 스트리밍 16:9 비율과 여백 정렬
2026-08-04 feature(ros2): S15P11A301-236 엔코더·IMU EKF 융합 (robot_localization)
2026-08-04 documentation(ai): S15P11A301-165 로컬·젯슨 검증 런북
2026-08-04 documentation(ai): S15P11A301-198 알려진 한계 3건 추가와 메모리 예산 구성 정정
2026-08-04 feature(frontend): S15P11A301-242 발견 상세에 요구조자 음성 보고를 한국어로 표시한다
2026-08-04 chore(jetson): S15P11A301-214 ESP32 두 보드에 udev 고정 이름을 준다
    `esp32_bridge.yaml` 이 이미 `/dev/sentinel_mcu_sensor`·`_motor` 를 기본값으로 쓰고
    있는데 그 심링크를 만드는 규칙이 없었다. 그래서 매번 `sensor_port:=/dev/ttyUSB2`
    처럼 번호를 손으로 넘겨야 했고, 번호가 바뀌면 **조용히 연결 실패**한다.
    ## by-path 를 쓴다 — by-id 가 불가능하다
    두 보드가 같은 CH340(1a86:7523)이고 **이 칩은 시리얼 번호가 없다.** 실측으로
    확인했다 — `udevadm info -a` 에 `ATTRS{serial}` 이 아예 없다(라이다의 CP2102 는
    `serial=="0001"` 이 있어서 99-sentinel-lidar.rules 가 by-id 로 간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
2026-08-04 documentation(ai): S15P11A301-165 에코 가드 검증 결과와 젯슨 인수 생략 근거 기록
2026-08-04 feature(frontend): S15P11A301-214 DHT11 환경값 판정에 센서 범위를 반영한다
2026-08-04 feature(backend): S15P11A301-207 명령 처리 결과와 거부 사유 조회 API를 추가한다
2026-08-04 chore(jetson): S15P11A301-256 데모 스택이 ESP32 보드를 스스로 감지하게 한다
2026-08-04 fix(ai): S15P11A301-257 입력 장치 디지털 무음을 장치 오류로 분류
2026-08-04 documentation(docs): S15P11A301-258 환경 센서 fault 의 실제 발화를 기록한다
2026-08-04 feature(frontend): S15P11A301-207 명령 거부·무응답을 사유와 함께 알린다
2026-08-04 feature(backend): S15P11A301-255 임무가 없을 때도 최신 센서 값을 조회한다
2026-08-04 feature(frontend): S15P11A301-259 수동 모드에서 자율 명령을 감추고 두 확대 화면을 같은 기하로 맞춘다
2026-08-04 feature(ai): S15P11A301-260 안내 음성 시간 확장으로 발화 속도 완화
2026-08-04 feature(frontend): S15P11A301-255 임무가 없어도 센서 카드에 실측 온습도를 띄운다
2026-08-05 documentation(ai): S15P11A301-120 정량 검증 CONDITIONAL 판정과 미측정 9항목 기록
2026-08-05 feature(jetson): S15P11A301-237 자율·수동 명령이 안전 4층을 거쳐 바퀴에 닿게 한다
2026-08-05 documentation(ai): S15P11A301-94 데이터셋 검증 절차를 이진 분류 기준으로 고친다
2026-08-05 fix(ai): S15P11A301-98 상체가 수직이면 수직신장비 신호를 버려 오탐을 막는다
    [pipeline.jetson.yaml, pipeline.yaml]
2026-08-05 ci(deploy): S15P11A301-262 백엔드 이미지 빌드가 DinD 기동 실패로 간헐 중단되는 문제를 고친다
2026-08-05 fix(jetson): S15P11A301-237 초음파 보호정지를 모터 ESP32에 STOP_COMMAND로 중계한다
    [esp32_motor_bridge_node.py, protective_relay.py]
2026-08-05 feature(backend): S15P11A301-266 업로드 완료를 실물 체크섬으로 검증하고 오래된 PENDING 을 유실 판정한다
2026-08-05 documentation(ai): S15P11A301-94 Detect 파인튜닝 평가 결과와 미채택 결정을 남긴다
2026-08-05 docs(ai): S15P11A301-98 자세 판정 임계값을 정답 라벨로 검증한다
    그동안 "실측 근거 없는 임의값"으로 남아 있던 임계값을 E-FPDS 정답 2,658건과
    대조했다. 자세·형상 신호 3개와 그 임계값은 의도대로 동작하며 변경할 이유가 없다.
    ## 결과
    쓰러짐 1,653건 fallen_score 중앙 0.919
    비쓰러짐 1,005건 fallen_score 중앙 0.032
    fallen_threshold 0.5가 두 분포의 한가운데다. 임계값 스윕(0.05~0.95)에서 0.5
    근처를 벗어나 개선되는 지점이 없었다.
    split별 정밀도/재현율: split1 0.946/0.980, split10 0.992/0.911,
    split2 0.853/0.920, split3 0.797/0.888.
    ## 처음 측정은 틀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
2026-08-05 documentation(docs): S15P11A301-272 초음파를 접촉 직전 방어로 재정의한다
2026-08-05 fix(jetson): S15P11A301-264 USB 재열거 후 시리얼 재연결이 되게 한다
    [esp32_motor_bridge_node.py, esp32_sensor_bridge_node.py, serial_transport.py]
2026-08-05 feature(ai): S15P11A301-265 이벤트 증빙 이미지에 보존 상한을 둔다
2026-08-05 feat(ai): S15P11A301-268 Jetson 원격 ASR 클라이언트 추가
2026-08-05 feat(ai): S15P11A301-269 ASR shadow 벤치마크 추가
    [asr-shadow-summary.csv]
2026-08-05 feat(ai): S15P11A301-270 Qwen 로컬 LLM shadow 검증
2026-08-05 feature(frontend): S15P11A301-273 임무 이력 화면 레이아웃을 다듬고 CPU 그래프를 임무 당시 온습도로 바꾼다
2026-08-05 fix(ros2): S15P11A301-274 임무를 종료한 뒤 재기동 없이 다시 시작한다
    관제에서 임무를 종료하면 mission_manager 를 재기동하지 않는 한 다시 시작할 수
    없었다. 실측: 「베이스캠프 복귀」를 누른 뒤 「탐사 시작」이 INVALID_STATE 로
    거부됐고 상태는 COMPLETED, previousState 는 EXPLORING 이었다.
    원인은 MISSION_START 가 SAFE_IDLE 에서만 유효하고 COMPLETED 는 나가는 전이가
    없는 종단이라는 것이다. 시연은 반복하므로 STOP 한 번이 일회용 잠금이 됐다.
    COMPLETED 에서도 시작을 허용한다. 초기화 버튼이나 별도 상태를 두지 않는 이유는
    임무 종료 기록이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
2026-08-05 chore(database): S15P11A301-275 임무에 안 묶인 telemetry 를 소급 연결하고 운영 테스트 데이터를 청소한다
2026-08-05 fix(frontend): S15P11A301-274 임무 종료 버튼과 상태 표시를 동작에 맞춘다
    관제 화면이 실제와 다른 것을 셋 보여주고 있었다.
    대기 상태에서 「임무 종료」를 누르면 화면이 「복귀 중」으로 바뀌었다. 원인은
    낙관적 전이가 RETURNING 을 세우는 것이다. RETURNING 은 미구현이라
    (S15P11A301-246) 로봇이 결코 그 상태가 되지 않으므로, 화면만 복귀하는 것처럼
    보였다. 백엔드가 STOP ACK 에서 missions.status 를 COMPLETED 로 닫고 그 값을
    STOMP 로 밀어 주므로 낙관적 표시도 COMPLETED 로 맞춘다.
    「임무 종료」 버튼이 대기·완료에서도 보였다. 끝낼 임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
2026-08-05 fix(ros2): S15P11A301-278 controlMode 를 상태 토픽에 실어 안전 체인을 연다
2026-08-05 feature(ai): S15P11A301-267 GPU ASR FastAPI 서버 구축
2026-08-05 docs(ai): S15P11A301-271 TTS 후보 비교 및 기존 승인 WAV 유지
2026-08-05 fix(ros2): S15P11A301-276 임무를 멈출 때 진행 중 encounter 를 끊는다
2026-08-05 fix(jetson): S15P11A301-279 URDF 에 남은 짐벌 링크를 걷어낸다
    짐벌은 v1.1-r4 에서 프로젝트에서 제외됐고 02장 6.4 가 "미사용 확정, 카메라·LiDAR
    는 차체 고정 마운트"로 적었는데, sentinel.urdf 에만 링크 3개가 남아 TF 트리에
    실제로 발행되고 있었다. tf2_tools view_frames 에 gimbal_base_link·
    gimbal_roll_link·gimbal_pitch_link 가 보였다.
    더구나 라이다와 카메라가 그 체인에 매달려 있었다.
    base_link → gimbal_base_link → gimbal_roll_link → gimbal_pitch_link → lidar_link
    → camera_link
    명세 35-2 의 권장 트리는 bas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
    [sentinel.urdf]
2026-08-05 feature(ai): S15P11A301-98 Jetson ReID 활성화와 장애물 표시 기능을 추가한다
2026-08-05 documentation(ai): S15P11A301-98 명세 이탈 3건 승인과 개정 공지 완료를 반영한다
2026-08-05 fix(frontend): S15P11A301-281 상태 패널에서 없는 「복귀」 지시를 없애고 수동 안내를 줄인다
2026-08-05 feat(ai): S15P11A301-282 원격 ASR 안전 가드와 지연 계측 추가
2026-08-05 fix(frontend): S15P11A301-280 임무 이력 온습도 그래프에 센서 범위 판정을 적용한다
2026-08-05 fix(ai): S15P11A301-98 Jetson 프로파일의 ReID 를 명세 준수 상태로 되돌린다
    [pipeline.jetson.yaml]
2026-08-05 feat(ai): S15P11A301-261 Jetson 원격 ASR 사전 점검 추가
2026-08-05 feat(ai): S15P11A301-285 반문형 이동 판정 및 원격 ASR 운영 경로 정리
2026-08-05 refactor(ai): S15P11A301-286 음성 파이프라인 구조 단순화
    [asr-shadow-summary.csv]
2026-08-05 docs(ai): S15P11A301-287 AI 탐지·음성 문서 통합
2026-08-05 docs(ai): S15P11A301-287 정량 측정 근거 보강
2026-08-06 test(backend): S15P11A301-288 서버가 발행하는 메시지도 CI 에서 계약 검사한다
2026-08-06 docs(docs): S15P11A301-289 전륜 서보 조향 전환을 명세에 반영
2026-08-06 docs(ai): S15P11A301-287 GPU·Jetson 실행 가이드 보강
2026-08-06 docs(ai): S15P11A301-98 객체탐지 README 신설과 시연 범위 밖 코드 정리
2026-08-06 docs(docs): S15P11A301-98 명세에서 파인튜닝 전제를 걷어내고 쓰러짐 판정을 명시한다
2026-08-06 chore(deploy): S15P11A301-294 스택 진입점을 demo_up·demo_down 둘로 정리
2026-08-06 docs(docs): S15P11A301-295 8765 노출 완화 서술을 사실에 맞춘다
    06장 위험 표와 04장 8.5 가 젯슨 8765 읽기 노출의 완화를 「볼 때만 켜고 보고
    나면 viz_down.sh 로 끈다」로 적고 있었다. 그 완화는 적용할 수 없다 —
    LiveMap.tsx:44 가 wss://jetson.sentinel-ugv.xyz:8765 로 붙어 관제 웹의 실시간
    지도가 이 브릿지에서 /map·/pose 를 직접 받는다. 끄는 것은 노출을 줄이는 행동이
    아니라 관제 지도를 끄는 행동이다.
    실측으로도 사람이 viz_up.sh 를 부르지 않는 것을 확인했다 — enable_viz 기본값
    true + 서비스 enabled 로 부팅만으로 8765 가 0.0.0.0 에 열린다.
    완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
2026-08-06 feature(frontend): S15P11A301-302 관제 화면 글꼴을 자체 호스팅 Asta Sans·D2Coding으로 바꾼다
2026-08-06 hardware(control): S15P11A301-297 전륜 서보 조향 파이프라인 통합
2026-08-06 feature(frontend): S15P11A301-300 관제 화면에 주행 속도를 표시하고 센서 갱신 주기를 줄인다
2026-08-06 fix(deploy): S15P11A301-306 부팅 자동 기동을 시각 동기 완료 뒤로
2026-08-06 fix(ros2): S15P11A301-307 임무 종료 후 telemetry 가 끝난 임무로 귀속되지 않게 한다
2026-08-06 documentation(docs): S15P11A301-306 ESP32 핸드셰이크 로그를 시계 점프 증상에서 뺀다
2026-08-06 test: S15P11A301-303 실제 육성 기반 STT 소음 강건성 및 GMS 복원 성능 평가
2026-08-06 fix(jetson): S15P11A301-304 조각 PTS 동률을 역행으로 보지 않는다
2026-08-06 fix(slam): S15P11A301-305 EKF 활성화
2026-08-06 hardware(protocol): S15P11A301-298 SET_MODE(0x13) 메시지 추가
2026-08-06 feature(jetson): S15P11A301-309 마감 실패 사유를 텔레메트리로 내보낸다
2026-08-06 docs(voice): S15P11A301-303 소음별 CER 상세 기록
2026-08-06 fix(slam): S15P11A301-305 EKF 기능 수정
2026-08-06 hardware(hardware): S15P11A301-312 수동 조종 페이지를 터치 조이스틱 UI로 바꾼다
2026-08-06 documentation(docs): S15P11A301-313 루트 README 배너·구조 최신화와 개요 단절 서술 정리
2026-08-06 feature(frontend): S15P11A301-314 관제 화면의 조작과 관측을 분리하고 화면 이동을 세로 바로 옮긴다
2026-08-06 feature(backend): S15P11A301-310 telemetry 의 녹화기 상태를 적재하고 조회에 노출한다
2026-08-06 feat(ros2): S15P11A301-172 탐사 목표를 Nav2 주행에 연결하고 조향 실측을 반영한다
    관제 START 로 EXPLORING 에 들어가도 로봇이 한 발짝도 움직이지 않았다. 세 층에서
    막고 있었고 셋 다 로그에 오류를 남기지 않는 종류였다.
    ## 1. 운동학 파라미터가 실측의 절반이었다
    vehicle_kinematics 는 어떤 launch 에서도 params 를 받지 않아 코드 기본값
    wheelbase 0.50·δ_max 30° 로 돌았다. 그것은 R_min 0.87m 를 뜻한다.
    실측은 L=0.683·δ_max=22°(좌·우 동일)이고 R_min 1.69m — 거의 2배다. 값이 작으면
    자전거 모델이 δ = atan(L·ω/v) 를 작게 계산해 로봇이 지령보다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
2026-08-06 fix(ros2): S15P11A301-172 도착 자세를 목표 판정에서 뺀다
    조향 차량은 제자리 회전을 못 하므로 도착 헤딩을 고를 수 없다. 접근 경로가 정하는
    대로 끝난다. yaw_goal_tolerance 0.30rad(17°)를 요구하면 위치는 맞는데 자세가 안
    맞아 목표가 영원히 「도달」이 되지 않는다.
    그때 로봇은 도착 지점에서 멈춘 채 progress checker 의 15초를 채우고 ABORTED 로
    끝난다. 그러면 도달 실패로 적립돼 세 번이면 그 자리가 후보에서 빠진다 — 실제로는
    도착했는데 못 갔다고 기록되는 것이다. 탐사가 그렇게 후보를 소진하면 DONE 이 된다.
    탐사가 목표 yaw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
2026-08-06 feature(backend): S15P11A301-316 임무 상태 표시를 로봇 보고값으로 반영
2026-08-06 documentation(docs): S15P11A301-315 젯슨·프론트·백엔드·하드웨어 README 정정
2026-08-06 documentation(frontend): S15P11A301-315 와이어프레임 Markdown 전환
2026-08-07 fix(jetson): S15P11A301-320 임무 상태를 1Hz 로 재발행해 주행 차단을 없앤다
2026-08-07 feat(frontend): S15P11A301-311 영상 없는 발견의 사유를 세 갈래로 구분해 표시한다
    관제 화면은 「영원히 영상이 없는 발견」과 「아직 업로드 전」을 같은 문구로 보여
    줬다. 앞은 젯슨을 열어야 하고 뒤는 기다리면 되는데 그 구별이 화면에 없었다 —
    S15P11A301-304 가 19건 쌓일 때까지 드러나지 않은 마지막 고리다.
    판정 근거는 encounter 가 아니라 임무 시계열이다. 실패한 이벤트는 event.mp4 가
    없어 업로드 경로를 타지 않으므로 사유가 미디어 행에 실릴 길이 없고, telemetry
    health 로만 온다(309 발신, 310 적재). 그래서 발견 시각과 텔레메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
2026-08-07 fix(frontend): S15P11A301-322 임무 텔레메트리가 비면 최신값으로 폴백한다
2026-08-07 fix(frontend): S15P11A301-318 하단 명령 바가 지금 가능한 조작만 보여준다
2026-08-07 feature(jetson): S15P11A301-323 ESP32 링크 진단으로 무응답과 드롭을 가른다
2026-08-07 fix(frontend): S15P11A301-325 시험 픽스처에 녹화기 필드를 채운다
2026-08-07 feature(jetson): S15P11A301-317 모터 보드 링크를 관제까지 올린다
    [telemetry-motor-link-down.json]
2026-08-07 feature(ros2): S15P11A301-247 사람 접근 주행을 bearing-only 로 구현한다
2026-08-07 fix(ros2): S15P11A301-172 무부하 검증이 찾은 주행 블로커 셋을 고친다
2026-08-07 fix(frontend): S15P11A301-327 임무가 시작되면 다른 화면도 새로고침 없이 따라간다
2026-08-07 performance(streaming): S15P11A301-328 인코딩을 15FPS·1500k로 내리고 시청자 수를 관측한다
2026-08-07 docs(docs): S15P11A301-98 쓰러짐 판정의 용도를 명세에 적는다
2026-08-07 fix(hardware): S15P11A301-321 모터 ESP32-젯슨 통신을 동기워드+CRC8 프로토콜로 재작성
    [board_state.h, comm_task.cpp, diagnostics.py, esp32_bridge.yaml, esp32_motor_bridge_node.py, motor_packet_codec.py, motor_protocol.cpp]
2026-08-07 fix(voice): S15P11A301-330 마이크 기본 소스를 BRIO로 고정한다
    E2E 리허설에서 요구조자가 대답했는데 무응답으로 처리되고 세션이 즉시 끝났다.
    원인은 마이크가 아니라 PulseAudio 기본 소스였다. Default Source가
    alsa_input.platform-sound.analog-stereo(젯슨 온보드 아날로그, 아무것도 안
    꽂힘)로 잡혀 peak=0.00000000인 디지털 무음을 읽었다. BRIO는 SUSPENDED로
    아무도 쓰지 않았다.
    장치 목록에 BRIO가 보이는 것으로는 부족했다. arecord -l 도 pactl list
    sources 도 BRIO를 보여주는데 정작 기본 소스가 다른 것이었다.
    대가가 둘이었다. 음성 인식이 대답을 못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
2026-08-07 fix(voice): S15P11A301-332 순간 유실에 대화를 버리지 않고 재감지 예산을 지킨다
    같은 사람을 보면서 두 노드의 관용도가 달랐다. 유실 구간이 0.179초였는데
    mission_manager는 사후 3초 창의 재감지로 회복했고 voice_session은 첫 LOST를
    종결로 처리했다. 그 직후 [STT] "나 보여?"로 답을 받아놓고 버렸다. 통합 부하의
    탐지가 8.4 FPS이므로 프레임 두어 장이면 0.2초다.
    LOST_GRACE 상태를 둔다. 유실에 즉시 포기하지 않고 재감지를 기다리며, 재감지
    또는 재접근이 오면 대화를 잇는다. 창 길이를 음성 쪽에 복사하지 않는다 — 창의
    주인은 mission_man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
2026-08-07 fix(recorder): S15P11A301-333 링 조각을 원자적 복사로 가져온다
2026-08-07 fix(control): S15P11A301-326 모터 ESP32 ACK 해결
    [boot_status.cpp, comm_task.cpp, comm_task.h, control_task.cpp, dual_motor_test.ino, esp32_motor_comm.ino, manual_web.cpp, manual_web.h]
2026-08-07 performance(detection): S15P11A301-329 pose를 TensorRT로 옮기고 엔진 전용을 강제한다
2026-08-07 fix(voice): S15P11A301-334 중단 배수 중 도착한 세션을 큐에 넣는다
2026-08-07 fix(jetson): S15P11A301-337 바퀴 오도메트리 상수를 실측값으로 바꾼다
    [esp32_bridge.yaml, esp32_sensor_bridge_node.py]
2026-08-07 fix(deploy): S15P11A301-338 손으로 두 번 부른 스택 중복 기동을 막는다
    demo_up.sh 의 이중 기동 거부(294)가 systemd 서비스만 보았다. 손으로 두 번
    부르면 둘 다 서비스가 아니라 둘 다 통과한다. 2026-08-07 주행 시험에서 20초
    간격으로 두 번 불러 두 벌이 7분 10초 겹쳤다.
    겹치는 자원 네 개가 각각 다른 증상으로 나타나고 어느 것도 "두 벌이 떴다"로는
    보이지 않는다. 그래서 원인 조사에 리허설 하나를 버렸고, 다른 파트는 이것을
    "mission_manager 가 임무 시작 직후 죽었다"로 보고했다 - 로그에 예외가 없고
    노드는 살아 있었다.
    모터 시리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
2026-08-07 fix(jetson): S15P11A301-339 주행 스케일 결론이 오염된 측정이었음을 정정한다
    S15P11A301-337 이 「주행 구간에서 스케일이 2배 틀렸다 — 속도 의존 틱 손실
    (에일리어싱)」로 남긴 결론을 정정한다. 근거가 무효였다.
    그 측정(0.25 m/s 에서 실제 약 4m 를 1.87m 로 보고) 시각에 브리지가 센서 보드
    재부팅을 73초 동안 29회 감지했다. 약 2.5초에 한 번이다. 재부팅을 감지하면
    브리지가 reset_encoder_origin() 을 부르고 그 구간의 이동량이 버려진다. 같은
    창에 스택도 두 벌 떠 있었고(338), 마지막 재부팅 감지 21:48:18 이 스택 B 종료
    시각과 일치한다.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
    [esp32_bridge.yaml]
2026-08-07 fix(jetson): S15P11A301-337 2배로 올렸던 틱 스케일을 계산값으로 되돌린다
    meters_per_tick 을 1.169e-06 에서 5.846e-07 로 되돌린다. 계산값
    (pi * 0.25) / (16384 * 82) 이 맞았고 2배로 올린 것이 틀렸다.
    원인은 문서 오독이다. 02장의 "후륜 차축에는 기계식 차동장치가 없다"를 "좌·우가
    강결합이다"로 읽었다. 아니다 - BTS7960 이 좌·우 2개이고 각 바퀴에 모터와 엔코더가
    따로 있다. 그래서 한쪽만 손으로 돌리면 다른 쪽은 0 이고, 브리지가 좌우를
    평균하므로 보고값이 그 바퀴 이동의 절반이 된다. 그 절반을 스케일 오차로 착각해
    상수를 2배로 올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
    [esp32_bridge.yaml]
2026-08-08 fix(control): S15P11A301-341 조향 링키지 비를 명시하고 낡은 기본값을 실측으로 바꾼다
    [safety.yaml]
2026-08-08 fix(hardware): S15P11A301-335 wifi 기능 활성화
    [drive_command_filter.py, esp32_bridge.yaml, esp32_motor_bridge_node.py, manual_web_config.h, safety.yaml, sensor_task.cpp, test_drive_command_filter.py]
2026-08-08 fix(control): S15P11A301-343 주행 기본 속도를 0.15로 확정하고 접근 상한을 정지 마찰 위로 올린다
    2026-08-08 실측 둘이 근거다. 0.10 m/s 명령(PWM 17%)은 정지 마찰을 못 넘어
    로봇이 움직이지 않고, 0.15 명령(PWM 25%)은 주행이 된다. 경계는 PWM 17~25%
    사이다.
    접근 상한 0.10 은 물리적으로 불가능한 값이었다. PERSON_APPROACHING 에서
    로봇이 한 발짝도 못 가고, 도착 선언이 없으니 INTERACTING 으로 넘어가지
    못한다 - 247 의 실주행 검증이 이 값 그대로면 반드시 실패한다. approach.py
    기본값과 24.2 표를 0.15 로 올리고, 0.15 아래로 내리면 안 되는 이유를 값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
    [safety.yaml]
2026-08-08 feat(jetson): S15P11A301-344 URDF 오프셋을 실측으로 채우고 IMU 장착 기울기를 반영한다
    URDF 의 placeholder 오프셋 8개를 2026-08-08 실측으로 교체한다. 원점은 후륜 축
    중앙의 바닥 수직 투영(base_footprint == base_link, 항등 유지 - 오도메트리와
    nav2 footprint 다각형이 이 원점을 전제한다), 축은 x=전방/y=좌측/z=상방이다.
    교차 검증 둘이 실측의 신뢰를 준다. 전륜 x=0.683 이 휠베이스 실측과 정확히
    일치하고(원점을 제대로 잡았다는 증거), 전륜 간격 0.533 이 트랙폭 0.53 과
    0.6% 안이다.
    IMU 는 위치만이 아니라 장착 자세까지 실측했다. 로봇을 기울이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
    [sentinel.urdf]
2026-08-08 fix(control): S15P11A301-343 체감 속도 0.28 확정을 기록하고 매핑 후 상향을 예약한다
2026-08-08 fix(jetson): S15P11A301-339 에일리어싱 기각을 철회하고 계측 도구를 남긴다
    [esp32_bridge.yaml]
2026-08-08 feat(jetson): S15P11A301-344 라이다 장착 yaw=0 을 벽 스캔으로 확인한다
    로봇 정면 114cm 벽, /scan 15프레임 합산. 벽의 코사인 곡선이 0도 중심 대칭
    (수직 방향 -2~0도, 벽 정렬 오차 범위)이고 수직거리 1.148m 가 실측 1.14m 와
    1cm 안에서 일치 - yaw 와 거리 스케일이 함께 검증됐다. rpy 는 0 그대로 두고
    근거 주석만 단다. 남은 미실측은 카메라 pitch 하나다 - 몸통 윗면 수평계
    측정(40도)은 BRIO 외형이 쐐기꼴이라 광축과 무관해 기각, 벽 표시 기능 시험으로
    잰다.
    [sentinel.urdf]
2026-08-08 feat(jetson): S15P11A301-344 카메라 광축이 위로 30도 들려 있음을 실측 반영한다
    벽 표시 기능 시험: 렌즈에서 72.8cm 벽(라이다 벽 시험과 같은 벽, 1.148 - 0.42)
    에서 영상 세로 정중앙이 높이 85cm 에 걸렸다. pitch = atan(0.422/0.728) =
    위로 30.1도 -> URDF pitch -0.525 rad.
    몸통 윗면 수평계 측정 40도와 정합한다(BRIO 쐐기꼴 외형 ~10도 + 광축 30도) -
    독립한 두 측정이 서로를 검증한다. 낮은 차체(렌즈 43cm)에서 위로 30도면 2m 앞
    성인 상체가 화면 중앙에 오는 사람 탐지용 장착이다.
    이로써 URDF 의 placeholder 가 전부 실측으로 닫혔다. 남은 것은 Foxglove TF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
    [sentinel.urdf]
2026-08-08 feat(jetson): S15P11A301-344 마운트 조정 후 카메라 광축을 12.3도로 재측정한다
    1차 측정(위로 30도) 뒤 마운트를 낮췄다. 스트리밍 화면에 바닥이 어느 정도
    나오는 구도를 원한 판단이고, 사람 몸통은 여전히 잘 잡힌다 - 카메라의 주행상
    역할은 사람 발견·접근 방위각이고 장애물 회피는 LiDAR·초음파 몫이라(04장)
    화면 구도를 우선했다.
    2차 벽 시험: 렌즈에서 33cm 벽에서 영상 세로 정중앙이 높이 50cm ->
    atan(0.072/0.33) = 위로 12.3도 (URDF -0.215 rad).
    오차 +-2도를 주석에 명시했다. 33cm 는 가까워 중앙 높이 +-1cm 가 각도 +-1.7도로
    증폭된다(10.6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
    [sentinel.urdf]
2026-08-08 fix(jetson): S15P11A301-340 시리얼 포트를 배타로 열고 점유 실패를 구분한다
    [motor_serial_transport.py, serial_transport.py]
2026-08-08 docs(hardware): S15P11A301-324 후방 초음파 센서 추가를 명세에 반영한다
    [sentinel.urdf]
2026-08-08 fix(frontend): S15P11A301-347 CDR 정렬 패딩을 오류로 보지 않는다
    관제에 지도가 뜨지 않았다. Foxglove 에서는 같은 /map 이 정상이었다.
    지도 대기 바이트가 남았습니다: 64274 소비 / 64276 전체
    남은 2바이트는 오류가 아니라 CDR 4바이트 정렬 패딩이다(64274 % 4 = 2).
    격자 크기 검증(data.length === width * height)은 이미 통과한 상태였으므로
    레이아웃 이해는 맞았고, 멀쩡한 지도를 통째로 버리고 있었다.
    검사를 없애지는 않는다. 필드가 하나 추가됐을 때 그 뒤가 전부 밀려 읽히는 것을
    잡아 주는 것이 이 검사이고, 그때는 틀린 값이 맞는 것처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
2026-08-08 fix(ros2): S15P11A301-348 RPP 가 읽지 않는 minimum_turning_radius 를 치우고 곡률 층을 적는다
    nav2.yaml 의 FollowPath.minimum_turning_radius: 1.69 를 제거한다. RPP 플러그인에
    그 이름의 파라미터가 없어 조용히 무시된다(.so 문자열로 확인 - desired_linear_vel,
    regulated_linear_scaling_min_radius, use_rotate_to_heading 은 있고 이것만 없다).
    S15P11A301-172 가 "RPP 는 이 값을 직접 쓰지 않지만 근거를 한곳에 남긴다"는
    의도로 넣었는데, 설정 자리에 있으면 읽는 사람이 "곡률 상한이 걸려 있다"로
    받아들인다 - 2026-08-08 에 내가 실제로 그렇게 오독했다. 값의 근거(R_min =
    L/tan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
2026-08-08 fix(hardware): S15P11A301-342 mm/s→PWM 매핑을 오프셋형 실측값으로 교체한다
    [safety_stub.cpp]
2026-08-08 fix(jetson): S15P11A301-349 지워진 base_link 카메라 조인트를 되살린다
    S15P11A301-344 의 마지막 커밋(5f11270)이 주석 블록을 다시 쓰면서 새 주석의
    닫는 --> 로 그 아래 base_link_to_camera_link 조인트 4줄을 함께 삼켰다. 그
    상태로 develop 에 병합돼 있었다.
    아무 신호가 없었다. URDF 는 XML 로서 유효하고 <link name="camera_link"/>
    선언도 남아 있어 파일을 훑어보면 정상으로 보인다. 파서로 확인해야 드러난다 -
    링크 11개에 조인트 9개, 루트(부모 없는 링크)가 base_footprint 와 camera_link
    둘이었다. 즉 카메라가 트리에서 떨어져 있었다.
    끊어진 트리는 기동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
    [sentinel.urdf]
2026-08-08 fix(control): S15P11A301-336 서보 모터 PWM 제한
    [board_state.h, esp32_motor_comm.ino, manual_web_config.h, steering.cpp, steering.h, steering_servo_test.ino]
2026-08-09 hardware(hardware): S15P11A301-345 수동 권한을 관제 우선으로 바꾼다
2026-08-09 fix(backend): S15P11A301-350 제어 모드를 임무에서 떼어 로봇에 적는다
    2026-08-08 실기동에서 관제 화면이 14분간 실제와 다른 모드를 표시했다. 임무가
    21:03:03 에 닫힌 뒤 21:04:14 에 폰이 모터 보드를 수동으로 래치했는데 화면은
    「자율」 토글이었고, 그 사이 「탐사 시작」이 두 번 INVALID_STATE 로 거부됐다.
    젯슨은 결백했다. controlMode: "MANUAL" 을 1Hz 로 계속 보냈고 거부 사유에도
    "현재 MANUAL" 을 담아 보냈다. 값은 백엔드 RobotStateData.controlMode 까지
    파싱돼 왔는데 읽는 코드가 한 줄도 없어 버려지고 있었다.
    프런트는 controlMode 를 missions.sta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
    [TelemetryQueryService.java]
2026-08-09 docs(jetson): S15P11A301-339 엔코더 속도가 3.4배 부풀려진 것을 기록한다
    339 의 펌웨어 수정 지점을 짚다가 두 번째 결함을 찾았다. 에일리어싱과 원인도
    층도 다르다 - 감김은 countDelta 의 문제이고 이것은 나눗셈의 문제라, 하나만
    고치면 다른 하나가 남는다.
    sensor_task.cpp 가 속도를 낼 때 나누는 dt 를 명목값 0.010s 로 고정해서
    넘긴다(SENSOR_TASK_INTERVAL_S = SENSOR_TASK_INTERVAL_MS / 1000.0f). 실제
    주기는 vTaskDelay 가 상대 지연이라 10ms + I2C 작업시간 = 약 34ms 이므로,
    34ms 동안 움직인 거리를 10ms 로 나눈다.
    speed_mmps = distanceDelta / 0.010 = 실제속도 x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
    [esp32_bridge.yaml]
2026-08-09 fix(deploy): S15P11A301-351 정리 대상을 열거하지 않고 설치 경로로 덮는다
2026-08-09 fix(hardware): S15P11A301-339 엔코더 샘플 주기를 고정하고 dt 를 실측한다
    펌웨어 수정은 김민석이 했고, GitLab 접근이 안 되어 젯슨 담당이 대신 커밋한다.
    S15P11A301-339 가 기록한 두 결함을 sensor_task.cpp 에서 함께 고친다. 둘은
    원인도 층도 다르다 - 감김은 countDelta 의 문제이고 3.4배는 나눗셈의 문제라,
    하나만 고치면 다른 하나가 남는다.
    1) vTaskDelay -> vTaskDelayUntil 로 절대 주기 고정
    상대 지연이라 실제 주기가 10ms + 작업시간이었다. 같은 루프에서 MT6701 두
    개와 MPU6050 을 I2C 로 읽으므로 실측 약 34ms 였고, 0.15 m/s 에서 샘플당
    모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
    [sensor_task.cpp]
2026-08-09 feat(jetson): S15P11A301-345 수동 권한의 출처를 읽어 관제에 싣는다
    345 의 펌웨어 몫은 이미 머지돼 있었는데(mode_arbiter.cpp 등 12파일) 젯슨이
    authority_flags 를 파싱하지 않아 그 정보가 관제까지 오지 않았다.
    345 는 DRIVE_STATE 를 15 -> 16바이트로 늘렸다. 마지막 1바이트가
    authorityFlags 이고 bit 0 은 "지금 수동 권한이 관제 승인이 아니라 젯슨 링크
    침묵 폴백으로 잡혔다"는 뜻이다. 순간값이 아니라 래치다 - 발동이 젯슨 침묵
    중에 일어나므로 순간 플래그로 보내면 그 프레임을 아무도 못 받는다.
    길이로 갈라 읽는다. 16바이트를 강제하면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
2026-08-09 fix(jetson): S15P11A301-339 측정 도구를 게이트 아래로 옮기고 데드밴드를 지킨다
2026-08-09 feat(jetson): S15P11A301-339 측정 도구를 게이트 아래로 옮긴다
2026-08-09 fix(backend): S15P11A301-346 고아 임무를 로봇 보고로 닫는다
    임무 중 스택이 STOP 없이 죽으면 그 임무를 닫는 주체가 아무도 없다.
    CommandAckWriter 는 명령 ACK 로만 움직이는데 그 명령이 영영 오지 않기
    때문이다. 서버에 ended_at=null 로 영원히 남고, 관제는 접속할 때마다 그
    유령 임무를 이어받아 "탐사중"으로 표시한다 - 로봇은 대기 중인데.
    S15P11A301-316 이 "임무 중 상태 고착"을, S15P11A301-350 이 "임무 밖
    controlMode"를 고쳤고, 이것이 같은 계열의 세 번째 구멍이다.
    닫는 근거는 로봇이 살아서 "임무 밖"이라고 말한 것이다. 젯슨은 SAFE_IDLE·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
2026-08-09 fix(jetson): S15P11A301-339 측정 도구가 경쟁 발행자를 멈추고 3.4배 해소를 확인한다
2026-08-09 fix(control): S15P11A301-342 기본 속도를 0.30 으로 올려 매핑 없이 닫는다
    250·300 추가 실측으로 저속 부족의 정체가 갈렸다.
    명령 PWM(예측=실측) 줄자 실속도 명령대비
    200 50/255 38.0cm/5s 76mm/s 38%
    250 59/255 102.5cm/5s 205mm/s 82%
    300 68/255 148.0cm/5s 296mm/s 99%
    300R 159.0cm/5s 318mm/s 106%
    직선 매핑은 300 에서 정확하고 저속에서만 정지 마찰로 벗어난다. 상수를 고치면
    잘 맞는 300 쪽이 망가진다. 기본 주행 속도가 하나로 고정되므로 매핑은 그대로
    두고 운용 대역을 마찰 구간 밖으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
    [safety.yaml]
2026-08-09 hardware(hardware): S15P11A301-353 초음파 보호정지 발동을 펌웨어에서 끈다
    전방 HC-SR04 가 빈 공간에서 2.6~5.5cm 오측을 간헐적으로 낸다(15초 218표본 중
    9회, 커넥터 분리 시 0회 - 센서·배선 원인 확정). 임계 10cm 아래라 그때마다
    STOP_COMMAND 가 중계돼 주행이 끊겼고, 2026-08-08 채터링 70회와 2026-08-09
    주행 시험 6회 무효가 전부 이것이었다.
    장애물 정지는 라이다 층(collision_monitor 전방 0.40m 정지 다각형)이 담당하고
    있어 초음파 발동 없이도 시연 요구를 충족한다는 판단으로, 센서는 달아두되
    정지 권한만 뺀다 - PROXIMITY_STOP_ENABLED = false.
    끄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
    [sensor_task.cpp]
2026-08-09 fix(control): S15P11A301-341 링키지 비 2.5 를 펌웨어 상수에 넣는다
    r38(S15P11A301-341 1차 MR)이 "펌웨어 두 상수는 담당 레인에 위임"으로 남긴
    몫이 반영되지 않은 채였다. develop 의 게인이 여전히 30/30 = 1:1 이라 바퀴가
    지령의 40%만 꺾이고 R_min 이 1.69m 가 아니라 4.41m 다 - steering_clamp_count
    7224 의 원인이 코드에 그대로 살아 있었다.
    실측 상수로 교체한다(2026-08-07 하드웨어 실측: 서보 중립 145°, 최대 오프셋
    ±55°(90~200), 그때 앞바퀴 22°).
    steering_limits.h STEERING_MAX_MDEG 30000 -> 22000 (실측 δ_max)
    steering.cpp SERVO_MAX_OFFSET_DEG 30 -> 55 (부팅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
    [board_state.h, steering.cpp, steering_limits.h]
2026-08-09 fix(control): S15P11A301-341 서보 방향 부호를 실물 링키지에 맞춘다
    steering_measure.py 호 주행 실측(2026-08-09)에서 두 가지가 갈렸다.
    실측 R 1.71m / 기대 1.69m (비 1.01) <- 링키지 비 2.5 정확히 반영
    yaw -37.1° (우회전) <- δ=+22°(좌회전 지령)인데 반대
    육안 확인도 우회전으로 일치한다. IMU 축은 344 기능 시험으로 검증된 상태라
    (반시계=gz+, 적분 +92°/실측 90°) 신뢰 근거가 겹으로 있다.
    서보 각도를 올리면 앞바퀴가 우로 꺾이는 실물 링키지다. steering.cpp 주석이
    "CTRL-24 스윕 시험에서 가장 먼저 확인할 항목"으로 예고해 둔 바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
    [steering.cpp]
2026-08-09 docs(control): S15P11A301-341 조향 좌우 호 주행 검증을 기록한다
    SERVO_DIRECTION_SIGN = -1 플래시 후 좌·우 호 주행 최종 실측.
    좌 (+22°) yaw +43.6° R 1.37m (기대 1.69, 비 0.81)
    우 (-22°) yaw -36.6° R 1.76m (기대 1.69, 비 1.04)
    방향 부호는 양쪽 다 지령과 일치한다. 좌회전이 약 20% 급하게 도는 기하
    비대칭이 있고, 부호 반전 전 같은 물리 방향 측정(1.71m)과 일관되므로 재현되는
    성질이다. 둘 다 "계획보다 더 돌 수 있는" 안전한 방향이라 시연 기준 수용 -
    폐루프가 흡수하며, 못 돌던 쪽(4.4m 시절)이 문제였다. 대칭 정밀화는
    TBD-CAL-001 의 기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
2026-08-09 fix(backend): S15P11A301-346 고아 종료 시험의 기대 push 를 사실에 맞춘다
2026-08-09 fix(ros2): S15P11A301-356 정지·감속 구역을 실측 차체 기준으로 다시 그린다
    [safety.yaml]
2026-08-09 fix(backend): S15P11A301-355 기동 실패한 빈 배선을 고치고 CI·배포가 그것을 잡게 한다
2026-08-09 fix(ros2): S15P11A301-356 구역 좌표를 실제로 적용하고 시연 환경에 맞춰 조인다
    [safety.yaml]
2026-08-09 fix(ros2): S15P11A301-357 데드밴드 아래 최저속도를 걷어내고 탐사를 전방으로 편향한다
2026-08-09 fix(ros2): S15P11A301-360 탐사 좌우 진동을 세 축에서 고친다
2026-08-09 feature(ros2): S15P11A301-358 Smac Hybrid-A* 로 후진을 계획에 넣는다
2026-08-09 feature(ros2): S15P11A301-362 임무 시작마다 slam 재시작으로 지도를 초기화한다
2026-08-09 fix(ros2): S15P11A301-362 지도 초기화가 호출자까지 죽이는 것을 고친다
2026-08-09 fix(ros2): S15P11A301-363 후방 목표 정체와 지도 회전을 각각의 층에서 고친다
2026-08-09 fix(frontend): S15P11A301-364 지도 화살표가 상하 반전을 따르게 한다
2026-08-09 fix(frontend): S15P11A301-367 관제 지도를 세계 좌표에 고정한다
2026-08-09 fix(ros2): S15P11A301-365 라이다 스캔의 좌우 거울상을 되돌린다
2026-08-09 fix(ros2): S15P11A301-366 탐사 목표를 계획 가능한 자리로 만든다
2026-08-10 fix(frontend): S15P11A301-365 정보가 없는 음성 보고 요약 줄을 화면에서 뺀다
2026-08-10 fix(ros2): S15P11A301-369 도달 불가능한 근접 목표를 버린다
2026-08-10 documentation(docs): S15P11A301-354 문서 최신화
2026-08-10 fix(docs): S15P11A301-354 음성 파이프라인·부록 요구사항 구식 표기 현행화
2026-08-10 fix(ros2): S15P11A301-368 접근 속도 상한을 데드밴드 위로 올린다
2026-08-11 documentation(docs): S15P11A301-372 명세를 v2.1 파이널 직전으로 정합화한다
2026-08-12 fix(ai): S15P11A301-98 로컬 기록의 encounterId 를 분리하고 성능 판정을 갱신한다
    탐지가 events.jsonl 에 쓰던 encounterId 를 없애고 로컬 식별자를
    _local.localEventId 로 옮긴다. 발급 권한은 Mission Manager 단독이다.
    봉투 구조를 ENCOUNTER_CONFIRMED 와 맞춘 것은 사람이 대조하기 쉬우라고 한
    선택인데, 그 탓에 로컬 기록이 팀 메시지와 구별되지 않았다. 두 계보를 같은
    키로 조인하면 0건이 조용히 나온다. 이름을 분리해 구조적으로 막았다.
    파일은 로봇 밖으로 나가지 않으므로 실제 사고는 없었다.
    성능 판정도 갱신한다. 목표 약 15FPS 는 젯슨 실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
2026-08-12 documentation(root): S15P11A301-373 루트 README 를 명세 v2.1 종료 상태로 정합화
2026-08-12 docs(root): S15P11A301-374 루트 README 에 시연 영상·관제 화면 자리를 만든다
2026-08-12 docs(root): S15P11A301-375 루트 README 상태 절에서 범위 결정과 미완성을 나눈다
2026-08-12 docs(root): S15P11A301-375 Frontier 소진 종료를 미완성에서 결정으로 옮긴다
2026-08-12 docs(docs): S15P11A301-376 docs 전수 검토로 E-Stop·시각동기·planner 잔재를 걷고 docs/ai 를 없앤다
2026-08-12 docs(ai): S15P11A301-98 부동 신호를 수용된 한계로 확정
    부동 신호 3개는 2026-08-06에 팀이 알려진 한계로 수용한 건인데, 25.7 남은 검증에
    할 일 형태로 남아 있어 미해결처럼 보였다. 25.2로 옮겨 수용 근거를 적고 열린
    과제에서 뺀다. 값이 판정에 실제로 기여하므로 명세에서 지우지는 않는다.
    - 근거 1: 틀리는 방향이 미탐 쪽이다. 단독 승격이 불가능하고(base 0이면 0),
    주행 중에는 카메라 이동 탓에 점수가 낮게 나온다
    - 근거 2: 젯슨 실기 2건에서 사람 7명이 전부 NORMAL, fallenScore 0.035~0.107
    - 남은 미검증은 재현율이며 UGV 촬영 영상(2b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
2026-08-12 docs(ai): S15P11A301-98 Pose crop 실행 범위를 명세에 기술
    명세 25.2 는 Pose 를 "어디에" 돌리는지 말하지 않았다. 구현은 person bbox 를 crop
    해 사람별로 돌리는데, 그 선택과 전제가 탐지 폴더 내부 문서에만 있었다. 2026-08-05
    팀 승인 사항이므로 명세로 올린다.
    - crop 범위와 bbox 10% 여유
    - keypoint 를 원본 프레임 좌표계로 복원한다는 출력 계약 조건
    - "약 2 FPS" 가 사람당이 아니라 파이프라인 전체 예산이라는 점, 되돌리는 법
    - 구분을 드러낸 실측(젯슨 Pose 300회 → 전역 예산 후 30회→10회, detections 동일)
    AGENTS.md §0 은 이탈 1건에서 0건이 됐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
2026-08-12 docs(voice): S15P11A301-354 음성 문서와 코드 불일치 정정
2026-08-12 fix(root): S15P11A301-376 전수 검토가 남긴 잔재를 마저 걷는다
    [pipeline.yaml]
2026-08-13 refactoring(root): S15P11A301-377 시연 종료 후 저장소 정리 — 안 돌던 시험·안 쓰던 의존성·낡은 주석
2026-08-13 documentation(docs): S15P11A301-378 마감 감사 — 미문서화 도구·ASR 인증 스위치·빈 notebooks 정리
2026-08-13 ci(root): S15P11A301-379 scripts README 동기화 검사를 .py 까지 넓히고 계측 스크립트 2건을 문서화
2026-08-13 feature(ai): S15P11A301-249 통합 스택 RAM·CUDA 연속 할당 실측
2026-08-13 chore(ai): S15P11A301-380 denoise 의 미사용 scipy 를 빼고 detection 전이 의존 핀에 근거를 적는다
2026-08-13 docs(docs): S15P11A301-382 제3자 라이선스 고지를 만들고 README 에서 가리킨다
    이 저장소는 「없는 것은 없다고 적는다」를 원칙으로 삼는데 라이선스만 그 원칙이
    비어 있었다. 루트에 LICENSE 가 없고, 문서 전체에 AGPL 언급이 0건이었으며,
    frontend/ATTRIBUTIONS.md 의 SIL OFL 1.1 고지 의무를 루트가 가리키지 않았다.
    THIRD-PARTY-NOTICES.md 를 만들었다. 확인한 것과 확인이 필요한 것을 나눠 적고
    확인란에는 출처 URL 을 남겨 다음 사람이 재확인할 수 있게 했다.
    확인한 것 — ultralytics AGPL-3.0(또는 Enterprise), MinIO 서버 AGPL v3,
    TimescaleDB Apache 2.0/TSL, 글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
2026-08-13 documentation(docs): S15P11A301-381 대표 README 에 시스템 구성도·요약표·팀 절을 넣고 배지를 재배치
2026-08-14 documentation(docs): S15P11A301-381 관제 화면·하드웨어 구성도를 README 에 싣는다
2026-08-14 docs(docs): S15P11A301-381 팀 절에서 한 사람만 길던 항목을 줄인다
    박종화 항목이 120자·3불릿으로 다른 팀원(51~77자)보다 배 가까이 길었다.
    기여가 넓다고 README 에서까지 길 이유는 없다.
    - 세 불릿을 둘로 합쳤다. 관제 웹·명세서·CI/CD 를 한 줄로 묶는다
    - 나열을 쉼표에서 가운뎃점으로 바꿔 폭을 줄였다
    - 「이벤트 녹화·영상 스트리밍」을 「녹화·스트리밍」으로, 「관제 웹 기능 상당
    부분」을 「관제 웹」으로 줄였다
    - 차체 모델과 카메라 드라이버 패치는 「로봇 스택 전반」에 흡수했다
    결과 80자·2불릿으로 이원빈(77자)과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
2026-08-14 docs(docs): S15P11A301-381 기술 선택 근거를 표로 적고 사고 기록 위치를 안내한다
    배지 16개가 기술 이름만 말하고 근거는 docs 8개 파일에 흩어져 있었다. 둘을
    잇는 표를 시스템 구성 절에 넣는다. 배지는 그대로 둔다 — 문제는 개수가 아니라
    아무 말도 하지 않는 것이었다.
    17행 전부 이 저장소에 이미 있는 사실이다. 새로 지어낸 근거는 없다.
    - Smac 전환은 R_min 실측(좌 1.37·우 1.76)과 NavFn 조향 고착 관측에서 나왔다
    - 곡률 상한을 controller 가 아니라 δ 클램프가 지킨다는 것도 적었다.
    RPP 에 그 기능이 없다는 사실이 이 구조의 이유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
2026-08-14 docs(docs): S15P11A301-381 회고 절을 만들고 팀 절에 기간·인원을 적는다
    README 에 회고가 없었다. 「끝내지 못한 것」·「알려진 제한」은 상태 기록이지
    배운 것이 아니다. 프로젝트 기간과 인원도 어디에도 없었다.
    회고는 네 가지와 아쉬운 것 하나로 적었다. 전부 이 저장소에 사고 기록이
    남아 있는 것들이다.
    - 조용히 죽는 실패가 가장 비쌌다. 클라우드 브리지 사망, URDF 조인트 4줄
    삭제, enable_ekf 누락 — 셋 다 에러가 안 나서 늦게 발견했고 그래서 CI 검사
    세 개가 생겼다
    - 실측 없이 정한 값은 전부 바뀌었다. planner, 조향 링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
2026-08-14 docs(docs): S15P11A301-381 기술 스택 배지를 16 → 30 개로 넓히고 4개 층으로 나눈다
    Gradle 처럼 실제로 쓰는데 빠진 것이 있었다. 로봇·인식 / 음성 / 관제·인프라 /
    개발·운영 네 층으로 나누고, 층마다 실제 근거가 있는 것만 올린다.
    배지는 훑고 지나가는 자리라 틀려도 그냥 넘어간다. 그래서 30개를 전부 저장소
    근거와 대조했다. 확장 과정에서 세 건을 잘못 붙였다가 고쳤다.
    - **Arduino 로고를 쓰지 않는다.** 펌웨어는 `.ino` 스케치이고 Arduino-ESP32
    코어 위에서 도는 것이 맞다. 다만 아두이노 로고를 달면 아두이노 보드로 만든
    취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
2026-08-14 documentation(docs): S15P11A301-381 README 최종 정리 — 기술 선택 근거·회고·배지 (!350·!352·!353 통합)
2026-08-14 docs(docs): S15P11A301-381 README 시각 계층을 정리하고 시연 영상 안내를 명확히 한다
2026-08-14 documentation(docs): S15P11A301-381 README 시각 계층과 시연 영상 안내를 정리한다
2026-08-14 docs(docs): S15P11A301-381 README 상단 바로가기와 외부 목차 항목을 덜어낸다
2026-08-14 fix(docs): S15P11A301-381 README 목차가 GitLab 섹션으로 이동하게 한다
2026-08-14 documentation(docs): S15P11A301-381 README 섹션 제목을 명료하게 통일한다
2026-08-19 docs(docs): S15P11A301-381 GitHub용 README를 명료하게 재구성한다
2026-08-19 docs(docs): S15P11A301-381 README 시각 구성을 복원한다
2026-08-19 docs(docs): S15P11A301-381 발표 자료와 시스템 구성 이미지를 추가한다
2026-08-19 docs(docs): S15P11A301-381 README 소개 문구를 명확히 한다
2026-08-19 docs(docs): S15P11A301-381 발표 자료와 시스템 구성 이미지를 최신화한다
2026-08-19 docs(docs): S15P11A301-381 기술 스택 배지 구성과 순서를 정리한다
2026-08-19 docs(docs): S15P11A301-381 README 소개 제목과 목차 링크를 맞춘다
2026-08-19 docs(docs): S15P11A301-381 시연과 발표 자료 링크를 한 절로 묶는다
